EUROBOT-27/MECANIQUE/resources/CDR-2027/FRW/Differential-Robot-Firmware/README.md

# Differential-Robot-Firmware

Firmware ESP32-S3 du robot principal (Coupe de France de Robotique / Eurobot 2027).

- Règlement Eurobot 2027 « The legend of Camelot » :
  [Eurobot2027_Rules_FR.pdf](https://www.eurobot.org/wp-content/uploads/2026/09/Eurobot2027_Rules_FR.pdf)
- Contexte technique : [doc/context_llm.md](doc/context_llm.md)
- Guide : [doc/guide.md](doc/guide.md)
