EUROBOT-27/MECANIQUE/resources/INSATEURO2026/Navigation/docs/README.md

# Navigation System Documentation

Documentation for the STM32 navigation card: motion profiling, odometry, dual-loop PID control, and the CAN-based command interface with the Raspberry Pi master.

## Contents

1. [Introduction](01-Introduction.md)
2. [STM32 Peripheral Configuration (.ioc)](02-stm32-config.md)
3. [Navigation State Machine Structure](03-state-machine.md)
4. [Motion Profiling ](04-motion-profiling.md)
5. [Odometry ](05-odometry.md)
6. [PID_Tuning](06-PID_Tuning.md)
7. [Post odometry-calibration workflow](07-Post_odometry_calibration_workflow.md)
8. [Additional_Notes](08-Additional_Notes.md)
9. [Code Improvements](09-improvements.md)
10. [References](10-references.md)
