EUROBOT-27/MECANIQUE/mechanical/clapets-v8/CAD_FC/report.txt

A_SOCLE                  print   A solids 1  mass    93.1 g  size  136.0 x   52.0 x   39.0  valid
A_PLATINE_MOTEUR         print   A solids 1  mass    28.1 g  size  112.9 x   44.5 x    6.0  valid
REF_PATIN_MOTEUR         ref     A solids 1  mass     2.1 g  size   42.0 x   42.0 x    1.0  valid
A_TRAVERSE_HAUT          print   A solids 1  mass    62.8 g  size  108.9 x   28.0 x   22.0  valid
A_SUPPORT_ECROU          print   A solids 1  mass    54.2 g  size   54.5 x   30.1 x   60.0  valid
A_AILE_D                 print   A solids 1  mass   245.6 g  size   84.0 x   55.5 x  217.0  valid
A_AILE_G                 print   A solids 1  mass   245.6 g  size   84.0 x   55.5 x  217.0  valid
A_BRAS_PORTE_D_BAS       print   A solids 1  mass    16.5 g  size   48.0 x   68.5 x   16.0  valid
A_BRAS_PORTE_D_HAUT      print   A solids 1  mass    16.8 g  size   48.0 x   68.5 x   18.0  valid
A_BRAS_PORTE_G_BAS       print   A solids 1  mass    16.5 g  size   48.0 x   68.5 x   16.0  valid
A_BRAS_PORTE_G_HAUT      print   A solids 1  mass    16.8 g  size   48.0 x   68.5 x   18.0  valid
A_ROUE_PORTE_28T         print   A solids 1  mass    13.9 g  size   37.3 x   37.3 x   22.0  valid
A_PIGNON_PORTE_20T       print   A solids 1  mass     4.9 g  size   27.5 x   27.5 x   10.5  valid
A_TOLE_PORTE             mdf     A solids 1  mass    24.0 g  size    3.0 x   55.0 x  245.0  valid
A_CAPOT_AILE_D           print   A solids 1  mass    22.7 g  size   82.0 x   39.3 x    9.0  valid
A_CAPOT_AILE_G           print   A solids 1  mass    22.7 g  size   82.0 x   39.3 x    9.0  valid
A_ENTRETOISE_608_BAS     print   A solids 1  mass     0.2 g  size   12.0 x   12.0 x    3.0  valid
A_ENTRETOISE_608_HAUT    print   A solids 1  mass     0.3 g  size   12.0 x   12.0 x    4.0  valid
B_ENTRETOISE_TETE        print   B solids 1  mass     3.5 g  size   22.0 x   18.0 x   22.0  valid
B_CHARIOT_TETE           print   B solids 1  mass   125.3 g  size  131.0 x   37.5 x  113.0  valid
B_BASE_TETE_D            print   B solids 1  mass    12.9 g  size   13.5 x   26.8 x   92.0  valid
B_BASE_TETE_G            print   B solids 1  mass     9.7 g  size   13.5 x   15.5 x   92.0  valid
B_MANIVELLE_FRAPPE       print   B solids 1  mass     2.1 g  size   10.0 x   24.0 x   24.0  valid
B_MOYEU_TETE_30T         print   B solids 1  mass    30.6 g  size   56.0 x   23.0 x   56.0  valid
B_PIGNON_TETE_20T        print   B solids 1  mass     3.0 g  size   27.4 x    5.8 x   27.4  valid
B_PLATEAU_TETE           mdf     B solids 1  mass    33.5 g  size   56.0 x    6.0 x  216.0  valid
B_STATION_TPU            tpu     B solids 1  mass     6.6 g  size   50.0 x   10.0 x   50.0  valid
B_BAGUE_STATION          print   B solids 1  mass     4.5 g  size   56.0 x    3.0 x   56.0  valid
REF_RAILS_2020           ref     A solids 2  mass   280.6 g  size  101.0 x   25.6 x  350.0  valid
REF_PLAQUE_PAPILLON      ref     A solids 1  mass   154.2 g  size  190.0 x    3.0 x  190.0  valid
REF_ROUES_V              ref     A solids 12  mass    41.2 g  size  146.5 x   29.2 x  101.5  valid
REF_ENTRETOISES_M5       ref     A solids 2  mass     1.5 g  size    8.0 x    9.0 x   83.0  valid
REF_ENTRETOISES_EXC      ref     A solids 2  mass     3.1 g  size   10.0 x    9.7 x   86.5  valid
REF_RONDELLES_BRONZE     ref     A solids 2  mass     0.1 g  size    7.0 x    1.0 x   82.0  valid
REF_608ZZ                ref     A solids 1  mass    18.1 g  size   22.0 x   22.0 x    7.0  valid
REF_608ZZ_TETE           ref     B solids 1  mass    18.1 g  size   22.0 x    7.0 x   22.0  valid
REF_NEMA17               ref     A solids 2  mass   211.3 g  size   56.6 x   63.2 x   79.6  valid
REF_COUPLEUR_5x8         ref     A solids 1  mass    16.3 g  size   21.1 x   23.7 x   27.1  valid
REF_VIS_T8               ref     A solids 1  mass   119.6 g  size    8.0 x    8.0 x  303.0  valid
REF_ECROU_T8             ref     A solids 1  mass    13.1 g  size   22.0 x   22.0 x   15.0  valid
REF_TIGE_PORTE_D8        ref     A solids 1  mass    80.1 g  size    8.0 x    8.0 x  203.0  valid
REF_AXE_TETE_D8          ref     B solids 1  mass    19.7 g  size    8.0 x   50.0 x    8.0  valid
REF_MOUSSE_PORTE         ref     A solids 1  mass     0.6 g  size    8.0 x   37.0 x   40.0  valid
REF_MG996R_D             ref     A solids 9  mass    38.8 g  size   54.0 x   20.8 x   46.8  valid
REF_FIL_BRUN_D           ref     A solids 1  mass     0.0 g  size    6.6 x    1.4 x    1.4  valid
REF_FIL_ROUGE_D          ref     A solids 1  mass     0.0 g  size    6.6 x    1.4 x    1.4  valid
REF_FIL_ORANGE_D         ref     A solids 1  mass     0.0 g  size    6.6 x    1.4 x    1.4  valid
REF_MG996R_G             ref     A solids 9  mass    38.8 g  size   54.0 x   20.8 x   46.8  valid
REF_FIL_BRUN_G           ref     A solids 1  mass     0.0 g  size    6.6 x    1.4 x    1.4  valid
REF_FIL_ROUGE_G          ref     A solids 1  mass     0.0 g  size    6.6 x    1.4 x    1.4  valid
REF_FIL_ORANGE_G         ref     A solids 1  mass     0.0 g  size    6.6 x    1.4 x    1.4  valid
REF_MG996R_TETE          ref     B solids 9  mass    38.8 g  size   54.0 x   46.8 x   20.8  valid
REF_FIL_BRUN_TETE        ref     B solids 4  mass     0.2 g  size   17.5 x    1.4 x   77.6  valid
REF_FIL_ROUGE_TETE       ref     B solids 4  mass     0.2 g  size   18.9 x    1.4 x   79.0  valid
REF_FIL_ORANGE_TETE      ref     B solids 4  mass     0.2 g  size   20.3 x    1.4 x   80.4  valid
REF_MG996R_FRAPPE        ref     B solids 9  mass    38.8 g  size   46.8 x   20.8 x   54.0  valid
REF_TIGE_GUIDE_D8        ref     B solids 2  mass    37.1 g  size  125.0 x   47.0 x    8.0  valid
REF_VENTOUSE_DPS30       ref     B solids 1  mass    14.2 g  size   30.0 x   27.0 x   30.0  valid
REF_PILE_3_PIERRES       ref     - solids 3  mass  1151.0 g  size  320.0 x  110.0 x  329.0  valid
RES_TETE_ROTATION        reserve - solids 1  mass     2.0 g  size  280.0 x   32.0 x  280.0  valid
RES_TETE_FIXE            reserve - solids 1  mass     0.7 g  size  124.0 x   57.5 x  100.0  valid
RES_TETE_CABLES          reserve - solids 1  mass     0.2 g  size  124.0 x   57.5 x   30.0  valid
RES_TETE_REPOS           reserve - solids 1  mass     0.4 g  size   60.0 x   32.0 x  216.0  valid
FIX_VIS_AILE_D           ref     A solids 32  mass     7.4 g  size   81.2 x   27.7 x  177.6  valid
FIX_INSERT_AILE_D        ref     A solids 6  mass     2.6 g  size   80.1 x   26.6 x  154.7  valid
FIX_ECROU_AILE_D         ref     A solids 2  mass     1.5 g  size    8.1 x    3.2 x  177.0  valid
FIX_VIS_BRAS_D           ref     A solids 22  mass     6.5 g  size   48.7 x   64.8 x  185.7  valid
FIX_ECROU_BRAS_D         ref     A solids 6  mass     2.2 g  size   23.9 x   64.8 x  186.4  valid
FIX_VIS_AILE_G           ref     A solids 32  mass     7.4 g  size   81.2 x   27.7 x  177.6  valid
FIX_INSERT_AILE_G        ref     A solids 6  mass     2.6 g  size   80.1 x   26.6 x  154.7  valid
FIX_ECROU_AILE_G         ref     A solids 2  mass     1.5 g  size    8.1 x    3.2 x  177.0  valid
FIX_VIS_BRAS_G           ref     A solids 22  mass     6.5 g  size   48.7 x   64.8 x  185.7  valid
FIX_ECROU_BRAS_G         ref     A solids 6  mass     2.2 g  size   23.9 x   64.8 x  186.4  valid
FIX_VIS_ROUE_28T         ref     A solids 6  mass     2.2 g  size   13.0 x    5.5 x   11.5  valid
FIX_ECROU_ROUE_28T       ref     A solids 2  mass     0.7 g  size    2.4 x    5.5 x   12.4  valid
FIX_VIS_PIGNON_PORTE     ref     A solids 12  mass     1.3 g  size   18.2 x   18.2 x   11.3  valid
FIX_VIS_PLAQUE_ECROU     ref     A solids 8  mass     2.7 g  size    7.6 x   10.2 x   27.6  valid
FIX_VIS_SUPPORT_ECROU    ref     A solids 16  mass     2.7 g  size   21.7 x   21.7 x    9.7  valid
FIX_INSERT_SUPPORT_ECROU ref     A solids 6  mass     2.8 g  size   20.6 x   24.8 x   52.8  valid
FIX_VIS_MOTEUR           ref     A solids 12  mass     4.3 g  size   36.5 x   36.5 x   13.0  valid
FIX_VIS_PLATINE          ref     A solids 16  mass     3.5 g  size  100.6 x    5.7 x   13.6  valid
FIX_INSERT_SOCLE         ref     A solids 4  mass     1.7 g  size   99.5 x    4.6 x    5.7  valid
FIX_VIS_RAILS            ref     A solids 16  mass     9.6 g  size   90.4 x   10.8 x  329.5  valid
FIX_TNUT_RAILS           ref     A solids 4  mass     3.8 g  size   86.9 x    3.0 x  330.0  valid
FIX_VIS_ROUES            ref     B solids 12  mass    29.6 g  size  128.5 x   40.0 x   83.5  valid
FIX_ECROU_ROUES          ref     B solids 4  mass     5.6 g  size  129.2 x    5.0 x   83.0  valid
FIX_VIS_TETE_SERVO       ref     B solids 16  mass     3.5 g  size   54.7 x   13.7 x   15.7  valid
FIX_ECROU_TETE_SERVO     ref     B solids 4  mass     1.4 g  size   55.4 x    2.4 x   15.5  valid
FIX_VIS_FRAPPE_SERVO     ref     B solids 16  mass     2.7 g  size    9.7 x   15.7 x   54.7  valid
FIX_INSERT_FRAPPE_SERVO  ref     B solids 4  mass     1.7 g  size    5.7 x   14.6 x   53.6  valid
FIX_VIS_MANIVELLE        ref     B solids 9  mass     0.7 g  size    7.3 x   18.2 x   11.0  valid
FIX_VIS_TETE_MOYEU       ref     B solids 3  mass     1.2 g  size   15.0 x    5.5 x    5.5  valid
FIX_ECROU_TETE_MOYEU     ref     B solids 1  mass     0.4 g  size    2.4 x    6.4 x    5.5  valid
FIX_VIS_TETE_PIGNON      ref     B solids 12  mass     1.0 g  size   18.2 x    7.3 x   18.2  valid
FIX_VIS_STATION          ref     B solids 12  mass     3.3 g  size   47.3 x   17.7 x   41.7  valid
FIX_ECROU_STATION_EXT    ref     B solids 3  mass     1.1 g  size   47.9 x    2.4 x   41.5  valid
FIX_ECROU_STATION_MIL    ref     B solids 3  mass     1.1 g  size   47.9 x    2.4 x   41.5  valid

Rest pose (carriage down, doors at contact, head vertical, stack in place): real parts
interferences: 0

Expected contacts (real on the hardware, not counted):
       4.15 mm3  A_SOCLE-1 / REF_RAILS_2020-1
      16.32 mm3  REF_NEMA17-1 / FIX_VIS_MOTEUR-1
       2.70 mm3  REF_COUPLEUR_5x8-1 / REF_VIS_T8-1
     165.53 mm3  REF_VIS_T8-1 / REF_ECROU_T8-1
      37.15 mm3  REF_RAILS_2020-1 / REF_ROUES_V-1
       0.02 mm3  REF_ECROU_T8-1 / FIX_VIS_SUPPORT_ECROU-1
       7.67 mm3  REF_MG996R_D-1 / FIX_VIS_PIGNON_PORTE-1
       7.67 mm3  REF_MG996R_G-1 / FIX_VIS_PIGNON_PORTE-2
       8.01 mm3  REF_MG996R_FRAPPE-1 / FIX_VIS_MANIVELLE-1
       6.39 mm3  REF_MG996R_TETE-1 / FIX_VIS_TETE_PIGNON-1

Fasteners (bill of materials, whole module, both door units):
    8 x  M2 x 10 pan head self-tapping (servo horn)
    7 x  M2 x 6 pan head self-tapping (servo horn)
   24 x  M3 heat-set insert (hole dia 4.6 x 6.5)
   30 x  M3 nut (ISO 4032)
   12 x  M3 x 10 socket head (ISO 4762)
   14 x  M3 x 12 button head (ISO 7380)
    1 x  M3 x 12 socket head (ISO 4762)
   17 x  M3 x 16 button head (ISO 7380)
   14 x  M3 x 8 button head (ISO 7380)
    2 x  M4 heat-set insert (hole dia 5.6 x 7)
    4 x  M4 nut (ISO 4032)
    4 x  M4 x (6 + chassis) button head (ISO 7380): socle to the robot base, length set by the chassis
    6 x  M4 x 8 button head (ISO 7380)
    4 x  M5 T-nut for the 2020 slot
    4 x  M5 nyloc nut (ISO 10511)
    4 x  M5 x 35 socket head (ISO 4762)
    4 x  M5 x 8 button head (ISO 7380)

Module A (fixed parts) inside the space reserved for module B:
reserve violations: 0

STRIKE pose (v8): carriage +8.0 mm, crank +90 deg, stack held by the doors:
interferences at strike: 0
  cup into the stack: REF_VENTOUSE_DPS30-1 = 5655 mm3 (wanted: the bellows/TPU take the 8 mm)
  cup into the stack: REF_VENTOUSE_DPS30-2 = 5655 mm3 (wanted: the bellows/TPU take the 8 mm)
  cup into the stack: REF_VENTOUSE_DPS30-3 = 5655 mm3 (wanted: the bellows/TPU take the 8 mm)
  crank pin inside the slot, no contact with the base: yes
