EUROBOT-27/MECANIQUE/logs/2026-11-01-seif.md

# 2026-11-01 — Session log (Seif)

(Earlier the same day: shared hub set up, D-018, committed without a log. Summarised here.)

## Done
- Shared hub: merged Seif's and Maatoug's copies into EUROBOT-27/MECANIQUE, per-person todo/logs, resources committed (D-018).
- Claude removed from the GitHub contributors: co-author lines stripped from the 4 earlier commits (history rewritten,
  force-pushed before Maatoug's first pull); `.claude/settings.json` turns attribution off for both leads.
- **Clapets v6** (`mechanical/clapets-v6/`, copy of v5, D-019): real MG996R round horn in the assembly (pinions 2.2 mm
  higher, head pinion 5.8 mm face sitting on the horn), real GrabCAD servo wires, cables straight out (door servos) and
  up to the tube passage (head servo).
- **Clapets v7** (`mechanical/clapets-v7/`, D-020):
  - door units reworked: M3 inserts Ø4.6 × 6.5, outer wall full height, closed box above the gears, no strap, one bottom plate;
  - real Two Trees Bluer V2 parts extracted from the GrabCAD model (named STLs matched to the .stp solids by box +
    volume) → `mechanical/resources/two-trees-bluer-v2-parts/` (+ `SOURCE.md`); profiles, wheels, spacers, NEMA 17,
    coupler, TR8 nut in the CAD;
  - every screw, nut and insert modelled (`FIX_*` parts, coloured) + bill of materials in `CAD_FC/report.txt`;
  - motor on the floor on a 1 mm pad + separate clamp plate `A_PLATINE_MOTEUR`;
  - caliper checklist and "mounting on the real robot" notes in the v7 README.
- FreeCAD 1.1 installed on Seif's PC; prompt-to-CAD workflow running (scripts in `fc/`, headless `freecadcmd`).

## Decisions
- D-019 Clapets v6: print and test v5 first, in its own folder
- D-020 Clapets v7 is the version we print and test

## Info gathered
- Seif's M3 inserts fit a Ø4.6 × 6.5 hole (measured from `ACC_Stepper_Omniwheel.STL`).
- Real MG996R round horn: disc Ø20.8 × 2.5, top 45.7 above the servo bottom (v5 assumed 43.5), boss Ø9.2, holes on r 7.2.
- Real TR8x8 nut: flange Ø22 × 3.9, 1.5 mm from one end, 4 holes Ø3.5 on r 8 at 0/90/180/270° (v5 assumed 45°).
- Two Trees plate sits 4.5 mm in front of the rails (v5: 4.0); the .stp plate is B-spline only, Maatoug's JSON plate is exact.
- NEMA 17 body ~38 mm, shaft Ø5 × ~19; lead screw in the printer 400 mm (ours ~303 mm, cut to length).
- Placing the fasteners found 14 real clashes v5/v6 would have printed with (fixed in v7).
- In the CAD, z 0 = table; rails + top tie reach 366 mm (exempt from the height check): cut profiles on the real robot.

## Problems / blockers
- Full-cycle check (`motion_v7.py`) not run with today's changes.
- Height margin still 2.3 mm (head at the top of the 75 mm lift).
- Weak spots: middle cup station nuts (~2 mm of thread), door-unit M4 corner nuts (~2.6 mm).
- Two Trees model GrabCAD link not written in `SOURCE.md` yet.

## Next
- Tolerance check of every nut / screw in v7.
- Redesign the door sheet (tôle porte) + foam pads.
- Rework the suction cup carrier with real tube sizes and measurements.
- Printability check of every part; refine where needed.
- Caliper measurements (list in `mechanical/clapets-v7/README.md`), then print and test in real life.

## Session 2

### Done
- Seif ran the full-cycle check of clapets v7 (`motion_v7.py`, headless): deployed perimeter ≤ 1367.3 mm, start 1200.2 mm
  (door servo wires 3.6 mm outside the base, accepted), **no real collision**. The 5 "unexpected" hits were real
  hardware contacts (lead screw in the nut, V-wheels in the slot, horn screws in the horns) and the "355 mm" was the
  top-tie T-nuts.
- `motion_v7.py` updated: those contacts listed as expected, top-tie screws exempt from the height check (like the top tie).

### Decisions
- none

### Info gathered
- The motion video is only made when the script runs in the GUI: `freecad.exe fc/motion_v7.py` → `CAD_FC/motion/motion.mp4`.

### Problems / blockers
- none new

### Next
- Re-run `motion_v7.py` in the GUI to get the video and confirm 0 unexpected / 347.7 mm; then the v7 plan (fastener
  tolerances first).
