EUROBOT-27/MECANIQUE/logs/2026-10-25-seif.md

# 2026-10-25 — Session log

## Done
- Agreed on how to organise the hub: the main session acts as chief, memory lives in files, `mechanical/` and `vision/` have their own context files, and subagents are only for one-off jobs (D-001).
- Read the official 2027 game rules (v1.0), general rules (v1.4), table plan and accessories sheet.
- Created: `CLAUDE.md`, `commands.txt`, `STATUS.md`, `TODO.md`, `project/` (rules digest, strategy, timeline, decisions), `mechanical/CLAUDE.md`, `vision/CLAUDE.md`, `/start` and `/wrap` commands, `rules-checker` agent, UTF-8 text extracts of the rules.

## Decisions
- D-001 Project hub organisation
- D-002 Manufacturing: 3D printing, laser cutting, aluminium profiles, rods
- D-003 SolidWorks; all files in English

## Info gathered
- Mechanical must be **built and assembled** by 2026-12-31. National qualifier at the end of March 2027.
- Team roles recorded in `CLAUDE.md`. Only Seif uses this hub for now. Software is out of scope here for now.
- Strategy is still being brainstormed. Seif will share ideas.

## Rule findings worth remembering
- Gate lintel sits at 320–430 mm while actuators must stay ≤ 350 mm, so it's hard.
- A quarry stack of 3 stones = a ready-made wall.
- Robot + Grail must share the 500 × 500 throne room at the start.
- Grail L4 (on the roof, > 300 mm) combines with returning home: 35 pts together.
- 7 open FAQ questions listed in `project/rules-digest.md`.

## Next
- Strategy brainstorm with Seif's ideas.
- Confirm the internal milestones (proposed CAD freeze 2026-12-13).
- Send the FAQ questions.

## Session 2

### Done
- Updated the hub after Seif's input: SIMAs in scope (`simas/`), most software out of scope, parts inventory not tracked.
- Created `resources/` with `INDEX.md` + `_notes/`. Cloned **Aerobotix 2026** (14 repos) and **INSATEURO2026**
  (17 repos, our club's previous team).
- Studied the Aerobotix CAD teardown + PPP → `resources/_notes/aerobotix-2026-robot.md`.
- Turned what Seif liked about it into `mechanical/design-principles.md` (symmetry, printed zip-tie anchors, testing method).
- Studied all INSATEURO2026 repos → `resources/_notes/insateuro2026.md` (vision post-mortem, mechanism, nav, SIMA, electrical).
- Checked GitHub: git logged in as `seifflifel`; member of INSATEURO2026, admin of EUROBOT-27. `gh` CLI not installed.

### Decisions
- D-004 Differential drive (Pololu 4742 + JSUMO; omni rejected)
- D-005 Opponent tracking by vision → superseded the same day by D-007
- D-006 Aerobotix 2026 design principles as our reference
- D-007 Opponent tracking and avoidance: LiDAR + vision
- D-008 Overhead vision station (camera + laptop) on the table, wireless to the robot

### Info gathered
- Seif's team is **IEEE RAS INSAT** (2026: 20th at the final, 134 pts). Aerobotix INSAT (another club) was 2nd.
- Lextronic order (7" display, 6 mini air pumps, 2 × Pololu 4742) arriving ~2026-10-28. Real stones still to be bought from France.
- Working assumption: a carried stone does **not** count in the robot perimeter (FAQ Q1, Seif will confirm).
- No CAD of our club's 2026 main robot exists in the org (`HARDWARE-CAD` is the ENSI 2025 robot).
- 2026 vision lessons: wrong input data caused the failures; the compute was off the table (not allowed);
  ArUco IDs were inconsistent; fusion was a plain average; ~9 cm accuracy, which can be improved with known-height planes.
- 2027: stones carry tag 13 on the long faces only → standing stones are invisible to overhead tag tracking.

### Problems / blockers
- Strategy not yet shared → mechanical concepts can't start properly.
- "Balise fixe" for laptop + camera: by the rules it must be the remote computing device (fixed beacons only allow
  sensors/telecom, 100 × 100 mm). Waiting for Seif to confirm.

### Next
- **Strategy session**: Seif shares the team's ideas; derive the mechanical requirements (7 questions listed in the chat:
  actions, stone handling, upright or not, capacity, Grail, cannonballs, start configuration).
- Order real stones + foam balls.
- Refine the timeline.
