EUROBOT-27/MECANIQUE/logs/2026-10-26-seif.md

# 2026-10-26 — Session log

(Session started 2026-10-25 late with `/start`, continued into 2026-10-26.)

## Done
- Seif shared the team's strategy brainstorm → `project/strategy.md` (match plan, mechanisms, PAMI versions), with Claude's rule review.
- Pulled exact zone coordinates from `Docs/table.svg` (mm): throne rooms, 5 wall + 4 tower zones per castle, moats,
  stables, the 10 quarries → `project/strategy.md`, `project/rules-digest.md` §2.
- Computed shot distance, PAMI path lengths and the PAMI size envelope → `project/strategy.md`, `simas/CLAUDE.md`.
- Wrote a team-friendly points-per-effort table and build order → `project/strategy.md`.
- Added the "reserve space in CAD" method → `mechanical/design-principles.md`.
- Listed the stone gripper concepts → `mechanical/concepts/stone-gripper.md` (new).

## Decisions
- D-009 Strategy direction: max points
- D-010 Build order: secure the sure points first

## Info gathered
- Endgame plan: go home, Grail to the roof (L4), shoot balls from the throne room during 85–100 s.
- Launcher idea: flywheel, fixed angle (lob). Shot ≈ 2.0 m to the near edge of the opposing courtyard, ≈ 2.75 m to the border; must clear 430 mm ramparts at 0.5–0.7 m and 1.8–2.0 m.
- PAMIs: 3 versions (basic, ejector, attack). "Easy eject" fallback: ball rolls through the opponent's gate, which faces the bridge moat.
  Size: 4 × ≤ 140 × 160 mm or 6 × ~90 × 185 mm; 4 already reach max PAMI points; 6 cords → start by radio from the robot.
- Lintel hand: suction from the top face, flip 180° so the cup is under the stone, exit through the gap between the uprights. Needs more brainstorming.
- Stone gripper: A side clamp (plate or servo per stone), B 3 suction cups, C both.
- Grail target height: well under the 430 mm beacon level (> 60 mm cube minimum).

## Rule findings
- Castle courtyard includes the throne room [G D.4] → the Grail's 5 "present" points are free (Q2 likely yes).
- New FAQ Q8: can a Grail on the roof block the opponent's beacon (430 mm)? [G E.2]
- Actuators ≤ 350 mm even inside the castle; only stones and the Grail may go above [G E.1], [G E.2].
- Lifting a 330 mm wall: ≤ 20 mm lift allowed [GR F.3]. Lintel pick-up from a stack top: ≤ 20 mm headroom.
- 8 of 10 quarries are against the long borders (one long face blocked).

## Problems / blockers
- Real stones still not ordered → blocks suction tests and jaw pad tuning.
- Concept A forces a ~380 mm wide robot when open → perimeter and layout to check.

## Next
- Order real stones and foam balls.
- Robot layout sketch (drive base + gripper width + pockets) and roof layout sketch.
- Second face concepts (single-stone pick + flip for towers).
- Choose the PAMI size with Hamza Sammoud.

## Session 2

### Done
- Gate lintel: checked a vertical-lift + side-suction idea against the height rule; added it and the "fork from below"
  idea to `project/strategy.md`.
- Created `mechanical/concepts/gate-lintel.md`: space to reserve for the gate, perimeter budget, 4 concepts compared.
- Added FAQ Q9 to `project/rules-digest.md`.

### Decisions
- D-011 Gate mechanism shares a driving face

### Info gathered
- Side grip on the lintel only has the 320–350 mm band (~20 mm usable with ±5 mm uprights). Side-suction lift with a
  centred cup ends at ~385 mm (illegal); a low cup could work but Seif judged it unreliable.
- Preferred direction: gravity-held lintel (fork or shelf under it). Unsolved: how the lintel gets onto the support.
- Space to reserve: slot ≈ 340 × 130 mm × full height on a driving face, ~100–110 mm Z travel, lintel ends
  ~110–120 mm outside the robot edge.
- Perimeter: only 200 mm of extra perimeter for all deployed parts. A full-width tray out 120 mm ≈ +240 mm (too much);
  one 80 mm tine ≈ +105 mm.

### Rule findings
- FAQ Q9: may a stone still held by the robot go above 350 mm inside a zone? [GR F.3] vs [G E.1].

### Problems / blockers
- Lintel loading onto a fork/shelf is unsolved (low priority, gate is 3rd in D-010).

### Next
- Robot layout sketch must include the shared gate slot on face A or B (D-011) and the narrow-protrusion rule.
- Hand test with 3 stones + scrap plywood: does a lintel set from a fork/shelf land straight? (once real stones arrive)
