EUROBOT-27/MECANIQUE/project/timeline.md

# Timeline

## Fixed milestones

| Date | Milestone | Status |
|---|---|---|
| 2026-10-25 | Project hub set up | done |
| **2026-12-31** | **Mechanical structure + mechanisms built and assembled** | — |
| **end of March 2027** (exact date TBD) | **National qualifier** | — |
| TBD | Registration deadline | find out |
| TBD | Technical poster deadline | find out |
| TBD | European finals (if qualified) | — |

## Proposed internal milestones (DRAFT by Claude — Seif is refining this)

Remember import lead times: anything imported must be ordered well before CAD freeze if it's needed for
assembly by 2026-12-31.

Working back from 2026-12-31. Manufacturing (3D printing, laser cutting, aluminium profiles, rods) is fast,
so most of the time goes to concept + CAD, but leave room to re-print and fix things.

| Target date | Milestone | What "done" means |
|---|---|---|
| 2026-11-08 | Strategy chosen | Actions we target are in `decisions.md`; FAQ questions sent |
| 2026-11-22 | Concepts chosen + critical prototypes tested | Drive base layout fixed; stone gripper/lift prototype tested on real 320 × 110 × 110 boxes |
| 2026-12-13 | **CAD freeze** (full robot) | Complete SolidWorks assembly, rule-checked (perimeter, height, beacon support, start area) |
| 2026-12-14 → 12-31 | Manufacturing + assembly | Robot built and mechanisms working by hand |
| Jan → Mar 2027 | Electronics integration, software, testing | Owned mostly by electrical + software teams |

Open questions:
- Exams or holidays in Nov–Jan that reduce team availability?
- When can electrical (Hamza Bjaoui) get the chassis to start wiring?
