EUROBOT-27/MECANIQUE/resources/INSATEURO2026/Euro_vision/Documentation/THEORETICAL_UNDERSTANDING.md

# 🎓 Theoretical Understanding Requirements

**Purpose**: Track concepts that need deep theoretical understanding before proceeding with integration  
**Status**: Study Phase - No More "Vibe Coding"  
**Created**: October 8, 2025  
**Priority**: **CRITICAL** - Foundation for robust implementation

---

## 🚨 Why This Document Exists

**Problem Identified**:
- ✅ We have **working code** (~5000+ lines across modules)
- ❌ We may lack **deep understanding** of underlying theory
- ⚠️ Risk of "vibe coding" - implementation without comprehension
- 🎯 Need solid theoretical foundation for:
  - Debugging complex issues
  - Optimizing performance
  - Handling edge cases
  - Making informed design decisions
  - Competition problem-solving under pressure

**Solution**:
- **PAUSE** all new implementation
- **STUDY** the theory behind what we've built
- **UNDERSTAND** each component deeply
- **VALIDATE** our implementations against theory
- **DOCUMENT** our understanding

---

## 📚 Study Roadmap

### Priority Levels:
- 🔴 **CRITICAL** - Must understand before integration
- 🟡 **HIGH** - Important for optimization and debugging
- 🟢 **MEDIUM** - Useful for advanced features
- ⚪ **LOW** - Nice to have, can defer

---

## 1️⃣ Camera Calibration & Intrinsics

### 🔴 CRITICAL Topics

#### 1.1 Pinhole Camera Model
**What We Need to Understand**:
- [ ] How 3D points project to 2D image plane
- [ ] Focal length (fx, fy) physical meaning
- [ ] Principal point (cx, cy) and sensor alignment
- [ ] Relationship between world coordinates and pixel coordinates
- [ ] Why calibration is necessary

**Mathematical Foundation**:
```
Projection equation:
[u]   [fx  0  cx]   [X]
[v] = [0  fy cy] · [Y/Z]
[1]   [0   0  1]   [Z]

where (X,Y,Z) = 3D point, (u,v) = pixel coordinates
```

**Questions to Answer**:
- Why do we need fx and fy (not just one focal length)?
- What causes principal point offset from image center?
- How does sensor size affect these parameters?

**Resources to Study**:
- [ ] OpenCV Camera Calibration Tutorial
- [ ] Multiple View Geometry (Hartley & Zisserman) - Chapter 6
- [ ] Computer Vision: Algorithms and Applications (Szeliski) - Chapter 2
- [ ] Our file: `camera_calibration_folder/USAGE_EXAMPLES.md`

---

#### 1.2 Lens Distortion
**What We Need to Understand**:
- [ ] Radial distortion (k1, k2, k3) - barrel/pincushion effects
- [ ] Tangential distortion (p1, p2) - sensor misalignment
- [ ] When distortion matters (wide-angle lenses, close objects)
- [ ] Undistortion process and computational cost

**Mathematical Foundation**:
```
Radial distortion:
x_distorted = x(1 + k1·r² + k2·r⁴ + k3·r⁶)
y_distorted = y(1 + k1·r² + k2·r⁴ + k3·r⁶)

Tangential distortion:
x_distorted = x + [2p1·xy + p2(r² + 2x²)]
y_distorted = y + [p1(r² + 2y²) + 2p2·xy]

where r² = x² + y²
```

**Questions to Answer**:
- Why three radial coefficients (k1, k2, k3)?
- When can we ignore distortion?
- How does distortion affect ArUco detection accuracy?

**Our Parameters** (from calibration):
```python
k1 = 0.15619
k2 = -1.3830
k3 = 2.79308
p1 = -0.000391
p2 = -0.003039
```
**Study**: What do these values mean for our specific camera?

**Resources**:
- [ ] OpenCV Distortion Coefficients Documentation
- [ ] Zhang's Camera Calibration Paper (1999)
- [ ] Our file: `camera_calibration_folder/test_calibration.py`

---

#### 1.3 Calibration Process
**What We Need to Understand**:
- [ ] Why chessboard patterns work
- [ ] Minimum number of images needed
- [ ] How to evaluate calibration quality (reprojection error)
- [ ] When to recalibrate

**Our Calibration Results**:
```
Reprojection Error: 0.09574 px (EXCELLENT - typically < 0.5px is good)
```

**Questions to Answer**:
- What does 0.096px error mean practically?
- How often should we recalibrate?
- What factors invalidate calibration (lens bump, focus change)?

**Resources**:
- [ ] OpenCV calibrateCamera() documentation
- [ ] Our file: `camera_calibration_folder/calibrate_camera.py`
- [ ] Paper: "A Flexible New Technique for Camera Calibration" (Zhang, 1999)

---

## 2️⃣ Coordinate Systems & Transformations

### 🔴 CRITICAL Topics

#### 2.1 Coordinate System Definitions
**What We Need to Understand**:
- [ ] **World Coordinates**: Playing field reference frame
- [ ] **Camera Coordinates**: Camera-centric reference frame
- [ ] **Image Coordinates**: 2D pixel coordinates
- [ ] Right-hand vs left-hand coordinate systems
- [ ] How axes align in each system

**Our System**:
```
World Frame (on table):
- Origin: Center of ArUco marker ID=0 (inset 0.6m from corner)
- X-axis: Along table width (0 → 3.0m)
- Y-axis: Along table height (0 → 2.0m)
- Z-axis: Up (perpendicular to table)

Camera Frame:
- Origin: Camera optical center
- Z-axis: Points toward scene (out of camera)
- X-axis: Right (in image)
- Y-axis: Down (in image)
```

**Questions to Answer**:
- Why is camera Y-axis down?
- How do we handle the mismatch between world and camera frames?
- What's the physical meaning of our coordinate choices?

**Resources**:
- [ ] Multiple View Geometry - Chapter 2 (Projective Geometry)
- [ ] Our file: `map_anchors/docs/coordinate_system.md`

---

#### 2.2 Rotation Matrices
**What We Need to Understand**:
- [ ] 3×3 rotation matrix properties (orthonormal, det=1)
- [ ] Euler angles (roll, pitch, yaw) and gimbal lock
- [ ] Rotation vectors (rvec from solvePnP)
- [ ] Rodrigues formula (rvec ↔ rotation matrix)
- [ ] Quaternions (alternative representation)

**Mathematical Foundation**:
```python
# Rodrigues formula
R = I + sin(θ)·K + (1-cos(θ))·K²

where:
θ = ||rvec||  (rotation angle)
k = rvec/θ    (rotation axis)
K = skew-symmetric matrix of k
```

**Our Implementation**:
```python
rvec, tvec = cv2.solvePnP(...)
R, _ = cv2.Rodrigues(rvec)  # rvec → R matrix
```

**Questions to Answer**:
- Why use rotation vectors instead of matrices?
- What's the advantage of quaternions?
- How do we compose rotations?

**Resources**:
- [ ] Wikipedia: Rotation Matrix, Rodrigues' Formula
- [ ] Robotics textbook: "Modern Robotics" by Lynch & Park
- [ ] Our file: `map_anchors/scripts/compute_extrinsics.py`

---

#### 2.3 Homogeneous Coordinates & Transformations
**What We Need to Understand**:
- [ ] 4×4 homogeneous transformation matrices
- [ ] [R|t] representation (rotation + translation)
- [ ] Inverse transformations
- [ ] Chaining transformations

**Mathematical Foundation**:
```
Homogeneous Transform:
T = [R  t]  (4×4 matrix)
    [0  1]

Point transformation:
P_camera = T_world2cam · P_world

Inverse:
T_cam2world = [R^T  -R^T·t]
              [0     1     ]
```

**Questions to Answer**:
- Why use 4×4 matrices (instead of R and t separately)?
- How do we go from camera → world coordinates?
- What's the difference between extrinsic and intrinsic matrices?

**Resources**:
- [ ] Multiple View Geometry - Chapter 2
- [ ] Computer Graphics textbooks
- [ ] Our file: `map_anchors/docs/extrinsics.md`

---

#### 2.4 Camera Extrinsics (Critical!)
**What We Need to Understand**:
- [ ] Extrinsic matrix = [R|t] relating world → camera
- [ ] How solvePnP computes extrinsics from marker corners
- [ ] When extrinsics change (camera moved?)
- [ ] How to use extrinsics to transform enemy positions

**Our Setup**:
- Camera OUTSIDE field at (1.5, 2.044, 1.0) meters
- Tilted down: pitch = -20°
- Map markers at known world positions

**Critical Question**:
- How do we transform detected enemy marker position (in camera frame) to world coordinates?

**Answer Flow**:
```
1. Detect marker in image → (u, v) pixels
2. Use intrinsics to get normalized coordinates → (x, y, 1)
3. Use solvePnP to get marker pose → (rvec, tvec)
4. Transform to world frame using extrinsics
```

**Resources**:
- [ ] OpenCV solvePnP documentation
- [ ] Our file: `map_anchors/scripts/compute_extrinsics.py`
- [ ] **CRITICAL**: Need to implement and test this!

---

## 3️⃣ ArUco Marker Detection

### 🔴 CRITICAL Topics

#### 3.1 ArUco Dictionary & Encoding
**What We Need to Understand**:
- [ ] How ArUco markers encode IDs (binary patterns)
- [ ] DICT_4X4_50 vs DICT_6X6_250 (size vs capacity)
- [ ] Error detection/correction in markers
- [ ] Why some IDs are more robust than others

**Our Dictionary**:
```python
aruco_dict = cv2.aruco.getPredefinedDictionary(cv2.aruco.DICT_4X4_50)
# 4×4 = 16 bits per marker
# 50 = max 50 unique IDs
```

**Questions to Answer**:
- Why did we choose DICT_4X4_50?
- How much error correction is built-in?
- What's the detection range vs marker size?

**Resources**:
- [ ] ArUco original paper: "Automatic generation and detection of highly reliable fiducial markers under occlusion"
- [ ] OpenCV ArUco module documentation
- [ ] Our file: `ArUco_detection_folder/ARUCO_GUIDE.md`

---

#### 3.2 Marker Detection Pipeline
**What We Need to Understand**:
- [ ] Image preprocessing (grayscale, threshold, adaptive)
- [ ] Corner detection (how OpenCV finds 4 corners)
- [ ] ID decoding from binary pattern
- [ ] Pose estimation from corners (solvePnP)

**Detection Parameters** (that we've been setting):
```python
parameters.adaptiveThreshConstant = 7
parameters.adaptiveThreshWinSizeMin = 3
parameters.polygonalApproxAccuracyRate = 0.03
# ... etc.
```

**Questions to Answer**:
- What does each parameter actually do?
- How to tune for our lighting conditions?
- When does detection fail (distance, angle, lighting)?

**Resources**:
- [ ] OpenCV detectMarkers() source code
- [ ] ArUco module tutorial
- [ ] Our file: `ArUco_detection_folder/aruco_tools/marker_detector.py`

---

#### 3.3 Pose Estimation (solvePnP)
**What We Need to Understand**:
- [ ] PnP = "Perspective-n-Point" problem
- [ ] Input: 2D image points + 3D world points
- [ ] Output: Camera pose (rvec, tvec)
- [ ] Different solvePnP methods (ITERATIVE, P3P, EPNP)
- [ ] When solvePnP fails or gives bad results

**Mathematical Problem**:
```
Given:
- n points in world: P_i = (X_i, Y_i, Z_i)
- n points in image: p_i = (u_i, v_i)
- Camera intrinsics: K

Find:
- Rotation: R (or rvec)
- Translation: t (or tvec)

Such that:
p_i ≈ K · [R|t] · P_i
```

**For ArUco**: n=4 (four corners)

**Questions to Answer**:
- Why do we need at least 4 points?
- Which solvePnP method is best for our case?
- How accurate is the pose estimate?

**Resources**:
- [ ] OpenCV solvePnP documentation
- [ ] Paper: "EPnP: Efficient Perspective-n-Point Camera Pose Estimation"
- [ ] Our file: `ArUco_detection_folder/examples/05_with_calibration.py`

---

## 4️⃣ Kalman Filtering

### 🔴 CRITICAL Topics

#### 4.1 Kalman Filter Theory
**What We Need to Understand**:
- [ ] State estimation problem
- [ ] Process model (how system evolves)
- [ ] Measurement model (what we observe)
- [ ] Kalman gain (optimal weighting)
- [ ] Predict-Update cycle

**Mathematical Foundation**:
```
State: x = [x, y, θ, vx, vy, vθ]^T

Predict:
x̂_{k|k-1} = F·x̂_{k-1|k-1}
P_{k|k-1} = F·P_{k-1|k-1}·F^T + Q

Update (when measurement available):
K = P_{k|k-1}·H^T·(H·P_{k|k-1}·H^T + R)^-1
x̂_{k|k} = x̂_{k|k-1} + K·(z_k - H·x̂_{k|k-1})
P_{k|k} = (I - K·H)·P_{k|k-1}

where:
F = state transition matrix
H = measurement matrix
Q = process noise covariance
R = measurement noise covariance
K = Kalman gain
```

**Our Implementation**: `kalman_filter/src/kalman_filter/tracker.py`

**Questions to Answer**:
- Why is Kalman filter "optimal"?
- When does it fail (non-linear systems, non-Gaussian noise)?
- How to tune Q and R matrices?

**Resources**:
- [ ] "Kalman Filter for Dummies" (online tutorial)
- [ ] Welch & Bishop: "An Introduction to the Kalman Filter" (1995)
- [ ] Probabilistic Robotics (Thrun, Burgard, Fox) - Chapter 3
- [ ] Our file: `kalman_filter/docs/kalman/README.md`

---

#### 4.2 Motion Models
**What We Need to Understand**:
- [ ] Constant velocity model (our choice)
- [ ] Constant acceleration model
- [ ] When each model is appropriate
- [ ] How motion model affects prediction accuracy

**Our Model**:
```python
# Constant velocity
x_{k+1} = x_k + vx·dt
y_{k+1} = y_k + vy·dt
θ_{k+1} = θ_k + vθ·dt
vx_{k+1} = vx_k
vy_{k+1} = vy_k
vθ_{k+1} = vθ_k
```

**Questions to Answer**:
- Is constant velocity good for caisses (slow, erratic)?
- Is it good for enemy robots (fast, dynamic)?
- When should we use constant acceleration?

**Resources**:
- [ ] Tracking and Kalman Filtering Made Easy (Brookner)
- [ ] Our file: `kalman_filter/src/kalman_filter/tracker.py`

---

#### 4.3 Process & Measurement Noise
**What We Need to Understand**:
- [ ] Q matrix = model uncertainty (how much we trust prediction)
- [ ] R matrix = sensor uncertainty (how much we trust measurement)
- [ ] Tuning Q and R for different marker types
- [ ] Impact on filter responsiveness vs stability

**Our Values**:
```python
# Default
process_noise = 0.01  # Q
measurement_noise = 0.1  # R

# Recommendations:
# MAP (stationary): Q=0.001, R=0.05
# CAISSE (slow): Q=0.01, R=0.1
# ENEMY (fast): Q=0.05, R=0.2
```

**Questions to Answer**:
- How were these values determined?
- How to tune systematically?
- Trade-off: responsiveness vs noise rejection

**Resources**:
- [ ] "How to tune a Kalman Filter" (various online guides)
- [ ] Our file: `kalman_filter/TECHNICAL_SUMMARY.md`

---

### 🟡 HIGH Priority Topics

#### 4.4 Extended Kalman Filter (EKF)
**What We Need to Understand**:
- [ ] When linear Kalman filter is insufficient
- [ ] Linearization via Jacobian matrices
- [ ] Application to non-linear motion models
- [ ] Trade-offs (accuracy vs computational cost)

**Future Consideration**:
- Our system may need EKF for more complex motion patterns

**Resources**:
- [ ] Probabilistic Robotics - Chapter 3.3
- [ ] Wikipedia: Extended Kalman Filter

---

## 5️⃣ Occlusion Handling

### 🟡 HIGH Priority Topics

#### 5.1 Occlusion Detection
**What We Need to Understand**:
- [ ] Full vs partial occlusion
- [ ] Detection quality metrics
- [ ] When to trust Kalman prediction vs measurement

**Our Approach**:
```python
class DetectionQuality:
    corners_detected: int  # 0-4
    detection_confidence: float  # 0.0-1.0
    is_partial: bool
    
quality_score = (corners_detected/4 + detection_confidence) / 2
```

**Questions to Answer**:
- How to assess detection quality?
- When is partial detection better than prediction?
- How long can we predict during occlusion?

**Resources**:
- [ ] Our file: `kalman_filter/docs/occlusion/README.md`
- [ ] Our file: `kalman_filter/src/occlusion_handler/handler.py`

---

#### 5.2 Occlusion Strategies
**What We Need to Understand**:
- [ ] **Kalman Prediction**: Continue motion model
- [ ] **Partial Detection**: Fuse incomplete data with prediction
- [ ] **History-Based**: Use recent detections (for stationary objects)
- [ ] **Confidence Fusion**: Weighted combination

**When to Use Each**:
- Full occlusion → Kalman prediction
- Partial (1-3 corners) → Fusion with prediction
- Extended occlusion + MAP marker → History-based
- Multiple estimates available → Confidence fusion

**Questions to Answer**:
- How to select strategy automatically?
- How to weight different estimates?
- Maximum occlusion duration before giving up?

**Resources**:
- [ ] Visual tracking literature
- [ ] Our file: `kalman_filter/src/occlusion_handler/handler.py`

---

## 6️⃣ System Integration & Data Flow

### 🔴 CRITICAL Topics

#### 6.1 Complete Pipeline Understanding
**What We Need to Understand**:
- [ ] Data flow from camera to robot
- [ ] Coordinate transformations at each stage
- [ ] Error propagation through pipeline
- [ ] Timing and synchronization

**Our Pipeline**:
```
Camera Frame (30 FPS)
    ↓
ArUco Detection (detect all markers)
    ↓
Pose Estimation (solvePnP for each marker)
    ↓
Coordinate Transform (camera → world)
    ↓
Marker Classification (Map/Caisse/Enemy)
    ↓
Kalman Filter Update (smooth + predict)
    ↓
Occlusion Handling (quality assessment)
    ↓
WiFi Transmission (PC → Robot)
    ↓
Robot Decision Making
```

**Questions to Answer**:
- Where are the computational bottlenecks?
- How much latency at each stage?
- How to optimize for 30+ FPS?

**Resources**:
- [ ] Our file: `kalman_filter/docs/DATA_FLOW.md`
- [ ] Our file: `README.md` (system architecture)

---

#### 6.2 Error Propagation & Uncertainty
**What We Need to Understand**:
- [ ] How calibration errors affect pose estimation
- [ ] How pose estimation errors affect world coordinates
- [ ] How measurement noise affects Kalman filter
- [ ] Total system uncertainty

**Error Sources**:
1. Camera calibration: ~0.096px reprojection error
2. ArUco detection: ~1-2 pixels corner localization
3. solvePnP: Dependent on marker size and distance
4. Kalman filter: Tunable via Q and R

**Questions to Answer**:
- What's our total position uncertainty?
- How accurate is enemy position estimate?
- Is accuracy sufficient for competition tasks?

**Resources**:
- [ ] Error analysis chapters in computer vision textbooks
- [ ] Our calibration validation results

---

## 7️⃣ Competition-Specific Understanding

### 🟡 HIGH Priority Topics

#### 7.1 ArUco ID Schema (NOW UNDERSTOOD ✅)
**What We Understand**:
- ✅ Map anchors: 0-3 (fixed corner references)
- ✅ Caisses: 36 (blue), 47 (yellow), 41 (black/rotten)
- ✅ Enemy robots: 30+ (opponent tracking)

**Rationale**:
- Map markers establish coordinate frame
- Caisse markers on vinyl bands (detected, not tracked continuously)
- Enemy markers on opponent robots (tracked continuously)

**Resources**:
- ✅ Our file: `kalman_filter/SYNCHRONIZATION_SUMMARY.md`
- ✅ Our file: `caisses_detection/config/caisse_config.yaml`

---

#### 7.2 Competition Rules & Constraints
**What We Need to Understand**:
- [ ] Playing field dimensions: 3.0m × 2.0m
- [ ] Camera placement requirements (outside field, 44mm from edge)
- [ ] ArUco marker sizes (40mm for caisses, 100mm for maps)
- [ ] Competition timing (90 seconds per match)
- [ ] WiFi environment (20-30 teams, interference)
- [ ] Scoring system (how vision affects points)

**Questions to Answer**:
- Why is camera outside field at Y=2.044m?
- How does marker size affect detection range?
- What's the critical path for points?

**Resources**:
- [ ] Eurobot 2026 Cahier des Charges (official rules)
- [ ] Our file: `README.md`
- [ ] Competition website

---

## 8️⃣ Path Planning & Motion Planning

### 🔴 CRITICAL Topics

#### 8.1 RRT (Rapidly-Exploring Random Tree)
**What We Need to Understand**:
- [ ] Sampling-based motion planning
- [ ] Tree growth in configuration space
- [ ] Nearest neighbor search
- [ ] Collision checking along edges
- [ ] Path extraction from tree

**Our Implementation**: `path_planning/rrt.py`

**Algorithm Overview**:
```python
def RRT(start, goal, obstacles, max_iter):
    tree = [start]
    for i in range(max_iter):
        # 1. Sample random point in space
        rand_point = sample_random()
        
        # 2. Find nearest node in tree
        nearest_node = find_nearest(tree, rand_point)
        
        # 3. Steer towards random point with step_size
        new_node = steer(nearest_node, rand_point, step_size)
        
        # 4. Check if path to new node is collision-free
        if collision_free(nearest_node, new_node, obstacles):
            tree.append(new_node)
            
            # 5. Check if we reached goal
            if distance(new_node, goal) < threshold:
                return extract_path(new_node)
    
    return None  # No path found
```

**Questions to Answer**:
- Why use random sampling instead of grid search?
- How does tree bias towards unexplored regions?
- What's the probabilistic completeness guarantee?
- How to tune step_size and goal_sample_rate?

**Resources**:
- [ ] LaValle (1998): "Rapidly-Exploring Random Trees: A New Tool for Path Planning"
- [ ] Robotics: Planning Algorithms (LaValle) - Chapter 5
- [ ] Our file: `path_planning/rrt.py`

---

#### 8.2 RRT-Connect (Bidirectional RRT)
**What We Need to Understand**:
- [ ] Bidirectional search (grow two trees)
- [ ] Connect operation (greedy extension)
- [ ] Extend operation (single step growth)
- [ ] Tree swapping for balanced growth
- [ ] Path concatenation when trees meet

**Our Implementation**: `path_planning/rrt_connect.py`

**Algorithm Overview**:
```python
def RRT_Connect(start, goal, obstacles, max_iter):
    tree_a = [start]  # Tree from start
    tree_b = [goal]   # Tree from goal
    
    for i in range(max_iter):
        # 1. Sample random point
        rand = sample_random()
        
        # 2. Extend tree_a towards rand
        new_a = extend(tree_a, rand)
        
        if new_a is not None:
            # 3. Try to connect tree_b to new_a
            new_b = connect(tree_b, new_a)
            
            if new_b is not None:
                # Trees connected! Extract path
                path_a = extract_path(new_a, start)
                path_b = extract_path(new_b, goal)
                return path_a + path_b
        
        # 4. Swap trees for balanced growth
        tree_a, tree_b = tree_b, tree_a
    
    return None
```

**Advantages over RRT**:
- 2-10× faster convergence
- More balanced exploration
- Better for narrow passages

**Questions to Answer**:
- Why is RRT-Connect faster than basic RRT?
- What's the difference between extend() and connect()?
- When does bidirectional search fail?
- How to handle dynamic obstacles?

**Resources**:
- [ ] Kuffner & LaValle (2000): "RRT-Connect: An Efficient Approach to Single-Query Path Planning"
- [ ] Our file: `path_planning/rrt_connect.py`
- [ ] Our file: `full_pipeline/scripts/multi_threaded_pipeline.py` (lines 380-550)

---

#### 8.3 Path Smoothing
**What We Need to Understand**:
- [ ] Why RRT paths are jagged (random sampling artifacts)
- [ ] Greedy straightening algorithm
- [ ] Collision checking for line segments
- [ ] Trade-off: smoothness vs safety margin

**Our Implementation**: `path_planning/path_smoothing.py`

**Two-Stage Smoothing Approach**:

**Stage 1: Greedy Straightening**
```python
# Find longest collision-free segments
i = 0
while i < len(path) - 1:
    # Try to connect i to farthest reachable point j
    for j in range(len(path)-1, i+1, -1):
        if line_collision_free(path[i], path[j], obstacles):
            # Found longest segment - remove intermediate waypoints
            path = path[:i+1] + path[j:]
            break
    i += 1
```

**Stage 2: Random Smoothing**
```python
# Iteratively try random waypoint removal
for _ in range(iterations):
    idx1, idx2 = random.choice(path, 2)
    if line_collision_free(path[idx1], path[idx2], obstacles):
        path = path[:idx1+1] + path[idx2:]
```

**Questions to Answer**:
- Why two stages (greedy + random)?
- What's the time complexity of greedy straightening?
- How many iterations needed for random smoothing?
- How to handle moving obstacles during smoothing?

**Benefits of Greedy Straightening**:
- Deterministic first pass (predictable results)
- Creates longest possible straight segments
- Reduces waypoint count by 50-80%
- Easier for robot controller to follow

**Resources**:
- [ ] Our file: `path_planning/path_smoothing.py`
- [ ] Path planning literature on post-processing
- [ ] Our implementation in multi_threaded_pipeline.py

---

#### 8.4 Collision Checking
**What We Need to Understand**:
- [ ] Line-circle intersection test (2D case)
- [ ] Closest point on line segment to circle center
- [ ] Inflated obstacles (robot radius + obstacle radius)
- [ ] Computational cost of collision checking

**Mathematical Foundation**:
```
Line segment: p1 to p2
Circle: center c, radius r

1. Find closest point on segment to circle center:
   t = dot(c - p1, p2 - p1) / ||p2 - p1||²
   t_clamped = clamp(t, 0, 1)
   closest = p1 + t_clamped × (p2 - p1)

2. Check distance:
   collision = ||closest - c|| <= r
```

**Our Implementation**: `_line_segment_circle_collision()` in path_smoothing.py

**Questions to Answer**:
- Why clamp t to [0, 1]?
- How to extend to 3D (cylinder collision)?
- How to handle uncertainty in obstacle positions?
- How to optimize collision checking (spatial hashing)?

**Resources**:
- [ ] Computational Geometry textbooks
- [ ] Our file: `path_planning/path_smoothing.py` (lines 3-15)

---

## 9️⃣ Multi-Threading & Multi-Processing

### 🔴 CRITICAL Topics

#### 9.1 Python GIL (Global Interpreter Lock)
**What We Need to Understand**:
- [ ] Why Python can't use multiple CPU cores for threads
- [ ] GIL prevents parallel execution of Python bytecode
- [ ] I/O operations release the GIL
- [ ] C extensions (NumPy, OpenCV) release the GIL

**Key Concept**:
```
Python Threads:
- Good for: I/O-bound tasks (camera, network, file I/O)
- Bad for: CPU-bound tasks (math, image processing, path planning)
- Reason: GIL allows only ONE thread to execute Python code at a time

Python Multiprocessing:
- Good for: CPU-bound tasks (bypasses GIL completely)
- Bad for: Overhead of process creation and IPC
- Reason: Separate processes have separate GILs
```

**Our Architecture Decision**:
```python
# I/O-bound tasks → Threads
Thread 1: Camera capture (wait for frames)
Thread 5: DDS communication (network I/O)

# CPU-bound tasks → Processes
Process 2: Extrinsics computation (matrix math)
Process 3: Kalman filtering (state estimation)
Process 4: RRT path planning (tree search, collision checking)
```

**Questions to Answer**:
- When to use threading vs multiprocessing?
- How does GIL impact NumPy operations?
- Why doesn't OpenCV camera capture benefit from multiprocessing?
- What's the overhead of IPC (inter-process communication)?

**Resources**:
- [ ] Python GIL documentation
- [ ] David Beazley: "Understanding the Python GIL" (PyCon talk)
- [ ] Our file: `full_pipeline/scripts/multi_threaded_pipeline.py`

---

#### 9.2 Inter-Process Communication (IPC)
**What We Need to Understand**:
- [ ] Multiprocessing queues (multiprocessing.Queue)
- [ ] Shared memory (multiprocessing.Value, Array)
- [ ] Pipes (multiprocessing.Pipe)
- [ ] Serialization overhead (pickle)

**Our Implementation**:
```python
from multiprocessing import Queue as MPQueue

# Create queues for data flow
detection_queue = MPQueue(maxsize=10)
transform_queue = MPQueue(maxsize=10)
kalman_queue = MPQueue(maxsize=10)
path_queue = MPQueue(maxsize=10)

# Producer (Thread 1)
detection_queue.put(frame_data)

# Consumer (Process 2)
frame_data = detection_queue.get(timeout=0.1)
```

**Queue Flow Control**:
```python
# Bounded queue (maxsize=10)
# - Producer blocks if queue full
# - Consumer blocks if queue empty
# - Use timeout to avoid deadlock

try:
    queue.put(data, timeout=0.1)  # Non-blocking with timeout
except Full:
    pass  # Skip frame to maintain real-time performance
```

**Questions to Answer**:
- What's the overhead of pickle serialization?
- When do queues block vs drop data?
- How to prevent memory leaks from unbounded queues?
- Shared memory vs queues: trade-offs?

**Resources**:
- [ ] Python multiprocessing documentation
- [ ] Our file: `full_pipeline/scripts/multi_threaded_pipeline.py` (lines 30-37)

---

#### 9.3 Process Synchronization & Cleanup
**What We Need to Understand**:
- [ ] Daemon processes (auto-terminate with parent)
- [ ] Process termination (graceful vs force kill)
- [ ] Queue draining (prevent blocking on join)
- [ ] Signal handling (Ctrl+C, ESC key)

**Our Cleanup Strategy**:
```python
def cleanup_processes(processes, stop_event, timeout=2.0):
    # 1. Signal all processes to stop
    stop_event.set()
    
    # 2. Wait for graceful shutdown
    for proc in processes:
        proc.join(timeout=timeout)
    
    # 3. Force terminate if still alive
    for proc in processes:
        if proc.is_alive():
            proc.terminate()
            proc.join(timeout=1)
    
    # 4. Kill if still alive
    for proc in processes:
        if proc.is_alive():
            proc.kill()
```

**Queue Draining** (prevents deadlock):
```python
def drain_queue(q, timeout=0.5):
    """Remove all items from queue to unblock producers."""
    end_time = time.time() + timeout
    while time.time() < end_time:
        try:
            q.get_nowait()
        except Empty:
            break
```

**Questions to Answer**:
- Why drain queues before joining processes?
- What's the difference between terminate() and kill()?
- When to use daemon=True?
- How to handle Ctrl+C gracefully?

**Resources**:
- [ ] Python multiprocessing best practices
- [ ] Our file: `full_pipeline/scripts/multi_threaded_pipeline.py` (lines 550-600)

---

#### 9.4 Real-Time Performance Considerations
**What We Need to Understand**:
- [ ] Frame dropping vs buffering
- [ ] Latency vs throughput trade-off
- [ ] Queue sizing (too small = dropped frames, too large = latency)
- [ ] CPU affinity and priority

**Our Design Decisions**:
```python
# Small queues (maxsize=10) for low latency
# - Prefer dropping old frames over accumulating lag
# - Real-time system: latest data more important than all data

# Timeout-based operations
# - Never block indefinitely
# - Maintain responsiveness

# Separate processes for CPU-intensive tasks
# - Each process can use 100% of one CPU core
# - Total throughput scales with CPU cores
```

**Latency Budget**:
```
Camera capture:        ~33ms (30 FPS)
ArUco detection:       ~10ms
Extrinsics transform:  ~5ms
Kalman filter:         ~1ms
Path planning:         ~50-2000ms (timeout protected)
Visualization:         ~10ms
-----------------------------------
Total latency:         ~100-2100ms

Target: <100ms for most frames (excluding path planning)
```

**Questions to Answer**:
- What's the critical path for latency?
- How to measure end-to-end latency?
- When to drop frames vs buffer them?
- How to prioritize tasks?

**Resources**:
- [ ] Real-time systems literature
- [ ] Our file: `full_pipeline/scripts/multi_threaded_pipeline.py`

---

## 🔟 Timeout Handling & Fallback Strategies

### 🟡 HIGH Priority Topics

#### 10.1 Timeout Protection
**What We Need to Understand**:
- [ ] Why path planning can take unbounded time
- [ ] How to set appropriate timeout values
- [ ] Difference between timeout per attempt vs total timeout
- [ ] Trade-off: timeout too short = no path, too long = lag

**Our Implementation**:
```python
MAX_PLANNING_TIME = 2.0s      # Max time per RRT attempt
FAILURE_TIMEOUT = 3.0s        # Trigger sudden stop
MAX_RRT_ATTEMPTS = 3          # Attempts per cycle
FALLBACK_PATH_HOLD_TIME = 5.0s  # Hold fallback path

# Planning with timeout
planning_start = time.time()
for seed in range(MAX_RRT_ATTEMPTS):
    if time.time() - planning_start > MAX_PLANNING_TIME:
        break  # Timeout
    
    path = rrt_connect_plan(start, goal, obstacles, bounds)
    if path:
        return path

# No path found - try fallback
```

**Questions to Answer**:
- How to choose timeout values?
- What to do when planning times out?
- How to balance exploration vs exploitation?
- When to give up entirely?

**Resources**:
- [ ] Our file: `full_pipeline/scripts/multi_threaded_pipeline.py` (lines 420-500)

---

#### 10.2 Fallback Strategies
**What We Need to Understand**:
- [ ] Relaxed obstacle constraints (70% enemy radius)
- [ ] Backward waypoint allowance
- [ ] Path holding to prevent oscillation
- [ ] Sudden stop trigger

**Fallback Hierarchy**:
```
1. Normal planning with full obstacles
   ↓ (fails)
2. Relaxed obstacles (70% radius)
   ↓ (fails)
3. Allow backward waypoints
   ↓ (fails)
4. Sudden stop + warning

Path holding:
- If fallback path found → hold for 5 seconds
- Prevents rapid switching between strategies
- Robot follows stable trajectory
```

**Questions to Answer**:
- How much to relax obstacles?
- When to allow backward movement?
- How long to hold fallback paths?
- How to visualize fallback state to operator?

**Resources**:
- [ ] Our file: `full_pipeline/scripts/multi_threaded_pipeline.py` (lines 450-520)

---

## 8️⃣ Wireless Communication

### 🟡 HIGH Priority Topics

#### 8.1 Communication Protocols
**What We Need to Understand**:
- [ ] WebSocket: Full-duplex, TCP-based
- [ ] MQTT: Pub/sub, lightweight, TCP-based
- [ ] UDP: Connectionless, fast, unreliable
- [ ] Trade-offs: reliability vs latency vs bandwidth

**Questions to Answer**:
- Which protocol is best for competition WiFi?
- How to handle packet loss (10-30% expected)?
- Message format (JSON vs binary)?
- Update rate (30 Hz vision → ? Hz to robot)?

**Resources**:
- [ ] WebSocket specification (RFC 6455)
- [ ] MQTT documentation
- [ ] UDP vs TCP comparisons
- [ ] Our file: `README.md` (Communication section)

---

#### 8.2 Data Serialization & Bandwidth
**What We Need to Understand**:
- [ ] JSON vs MessagePack vs Protocol Buffers
- [ ] Bandwidth requirements (enemy pos + caisse pos + timestamp)
- [ ] Compression techniques
- [ ] Update rate vs data size trade-off

**Example Message**:
```json
{
  "timestamp": 1696789012.345,
  "enemy": {"id": 30, "x": 1.5, "y": 0.8, "theta": 0.3, "conf": 0.95},
  "caisses": [
    {"id": 36, "x": 0.5, "y": 0.6, "conf": 0.88},
    {"id": 47, "x": 1.2, "y": 0.9, "conf": 0.92}
  ]
}
```

**Questions to Answer**:
- How many bytes per message?
- At 30 Hz, what's the bandwidth?
- Can we optimize further?

**Resources**:
- [ ] JSON specification
- [ ] MessagePack documentation
- [ ] Network protocol design literature

---

## 9️⃣ MATLAB Simulations

### 🟢 MEDIUM Priority Topics

#### 9.1 Simulation vs Reality
**What We Need to Understand**:
- [ ] Purpose of MATLAB simulations (visualization, planning)
- [ ] Limitations (simplified models, no noise)
- [ ] How to validate simulation results with real data

**Our Simulations**:
- `simulate_camera_positioning_SUBPLOT.m` - Interactive camera placement
- `test_graphics.m` - Diagnostic visualization
- Various detection and tracking demos

**Questions to Answer**:
- How realistic are our simulations?
- What's missing (lighting, occlusion, noise)?
- How to use simulations for system design?

**Resources**:
- [ ] Our files in `matlab_simulations/`
- [ ] MATLAB Computer Vision Toolbox documentation

---

## 🎯 Study Plan & Timeline

### Week 1: Fundamentals (Priority 🔴 CRITICAL)
**Focus**: Camera calibration, coordinate systems, transformations

- [ ] **Day 1-2**: Pinhole camera model, intrinsics, distortion
  - Read: OpenCV calibration tutorial
  - Read: Our calibration documentation
  - Exercise: Derive projection equations by hand
  
- [ ] **Day 3-4**: Coordinate systems, rotation matrices
  - Read: Multiple View Geometry Chapter 2
  - Exercise: Manually compute transformations
  
- [ ] **Day 5**: Extrinsics and solvePnP
  - Read: solvePnP documentation
  - Exercise: Work through PnP problem on paper

**Validation**: Can you explain calibration to someone else? Can you derive transformations without looking?

---

### Week 2: Detection & Filtering (Priority 🔴 CRITICAL)
**Focus**: ArUco detection, Kalman filtering

- [ ] **Day 1-2**: ArUco marker detection pipeline
  - Read: ArUco original paper
  - Read: Our detection code
  - Exercise: Manually detect marker ID from image
  
- [ ] **Day 3-5**: Kalman filter theory and implementation
  - Read: "Kalman Filter for Dummies"
  - Read: Our Kalman filter code
  - Exercise: Implement 1D Kalman filter from scratch
  - Exercise: Tune Q and R matrices for different scenarios

**Validation**: Can you implement Kalman filter without library? Can you tune parameters intelligently?

---

### Week 3: Integration & Competition (Priority 🟡 HIGH)
**Focus**: Occlusion handling, data flow, competition specifics

- [ ] **Day 1-2**: Occlusion detection and strategies
  - Read: Our occlusion handler documentation
  - Exercise: Design occlusion strategy for edge case
  
- [ ] **Day 3-4**: Complete pipeline understanding
  - Read: DATA_FLOW.md
  - Exercise: Trace data through entire pipeline
  - Exercise: Identify bottlenecks and optimization opportunities
  
- [ ] **Day 5**: Competition rules and constraints
  - Read: Cahier des Charges
  - Exercise: Map competition tasks to vision requirements

**Validation**: Can you explain the full pipeline? Can you estimate system performance?

---

### Week 4: Advanced Topics & Communication (Priority 🟢 MEDIUM)
**Focus**: Advanced filtering, wireless communication

- [ ] **Day 1-2**: Extended Kalman Filter (optional)
  - Read: Probabilistic Robotics Chapter 3.3
  - Exercise: Linearize non-linear motion model
  
- [ ] **Day 3-4**: Wireless communication protocols
  - Read: WebSocket, MQTT, UDP documentation
  - Exercise: Analyze bandwidth requirements
  
- [ ] **Day 5**: Review and gap analysis
  - Revisit unclear topics
  - Update this document with understanding status

**Validation**: Are you confident to proceed with integration? Can you debug issues independently?

---

## 📊 Understanding Checklist

Use this to track your progress:

### Camera & Calibration
- [ ] Can explain pinhole camera model
- [ ] Understand focal length and principal point
- [ ] Know how distortion coefficients work
- [ ] Can interpret calibration results
- [ ] Understand when to recalibrate

### Coordinate Systems
- [ ] Can draw and label world, camera, image frames
- [ ] Understand rotation matrices and their properties
- [ ] Know how to use Rodrigues formula
- [ ] Can manually compose transformations
- [ ] Understand extrinsic matrix [R|t]

### ArUco Detection
- [ ] Know how ArUco markers encode IDs
- [ ] Understand detection pipeline
- [ ] Can tune detection parameters
- [ ] Know how solvePnP works
- [ ] Understand pose estimation accuracy

### Kalman Filtering
- [ ] Can derive Kalman filter equations
- [ ] Understand predict-update cycle
- [ ] Know how to choose motion model
- [ ] Can tune Q and R matrices intelligently
- [ ] Understand when Kalman filter fails

### Occlusion Handling
- [ ] Can detect occlusion types
- [ ] Know when to use each strategy
- [ ] Understand confidence fusion
- [ ] Can estimate maximum occlusion duration

### System Integration
- [ ] Understand complete data flow
- [ ] Know computational requirements
- [ ] Can estimate total system latency
- [ ] Understand error propagation
- [ ] Can identify optimization opportunities

### Competition Specifics
- [ ] Know all ArUco ID assignments
- [ ] Understand field layout and constraints
- [ ] Know camera placement requirements
- [ ] Understand WiFi challenges
- [ ] Can map vision to competition tasks

---

## 📝 Understanding Validation Methods

### 1. Teach-Back Method
- Explain concept to someone (or write detailed explanation)
- If you can't explain simply, you don't understand well enough

### 2. Implementation from Scratch
- Implement key algorithms without libraries
- Forces deep understanding of mechanics

### 3. Parameter Tuning Exercise
- Change parameters systematically
- Predict impact before observing
- Validates understanding of system behavior

### 4. Edge Case Analysis
- Identify failure modes
- Design solutions
- Tests depth of understanding

### 5. Code Review with Theory
- Review our existing code
- Explain why each line works
- Connect code to mathematical theory

---

## 🚀 After Understanding: Return to Implementation

### When Ready to Resume Coding:
1. ✅ Complete at least Week 1 & 2 studies (CRITICAL topics)
2. ✅ Pass understanding checklist (at least 80%)
3. ✅ Can explain key concepts without notes
4. ✅ Feel confident to debug issues
5. ✅ Have documented understanding in this file

### Next Implementation Steps:
1. Camera extrinsics computation (with understanding!)
2. Enemy detection with coordinate transformation
3. Full Kalman filter integration
4. Wireless communication module
5. Complete system testing

---

## 📚 Recommended Resources

### Books
- **Multiple View Geometry** by Hartley & Zisserman
  - The bible for 3D computer vision
  - Chapters 2, 6, 7 most relevant
  
- **Probabilistic Robotics** by Thrun, Burgard, Fox
  - Excellent for Kalman filters
  - Chapter 3 (Gaussian Filters)
  
- **Computer Vision: Algorithms and Applications** by Szeliski
  - Practical introduction
  - Free online: http://szeliski.org/Book/

### Online Courses
- **Coursera**: "Introduction to Computer Vision" (Georgia Tech)
- **YouTube**: "First Principles of Computer Vision" (Columbia University)
- **YouTube**: Cyrill Stachniss - "Photogrammetry" lectures

### Papers
- Zhang (1999): "A Flexible New Technique for Camera Calibration"
- Garrido-Jurado (2014): "Automatic generation and detection of highly reliable fiducial markers under occlusion" (ArUco)
- Welch & Bishop (1995): "An Introduction to the Kalman Filter"

### Tutorials
- OpenCV official documentation (excellent tutorials)
- "Kalman Filter for Dummies" (online)
- Multiple geometry tutorials on YouTube

---

## 💡 Study Tips

1. **Don't Rush**: Deep understanding takes time
2. **Work Problems by Hand**: Do math on paper, not just read
3. **Implement Simple Versions**: 1D Kalman, 2D transformations
4. **Ask "Why?"**: Don't accept formulas, understand derivations
5. **Connect Theory to Code**: Review implementation with theory
6. **Test Understanding**: Teach-back, edge cases, parameter tuning
7. **Take Breaks**: Let concepts sink in
8. **Document**: Write explanations in your own words

---

## ✅ Success Criteria

You're ready to resume implementation when:

1. ✅ Can explain camera calibration to a teammate
2. ✅ Can derive coordinate transformations manually
3. ✅ Can implement 1D Kalman filter from scratch
4. ✅ Can tune Kalman parameters for different scenarios
5. ✅ Can trace data through entire pipeline
6. ✅ Can predict system behavior for edge cases
7. ✅ Feel confident debugging issues
8. ✅ Can make informed design decisions

**Remember**: The time spent understanding now will save 10x time debugging later!

---

**Status**: 📚 **STUDY MODE ACTIVE**  
**Next Update**: After Week 1 studies complete  
**Goal**: Solid theoretical foundation before final integration

🎓 **Happy studying!**
