EUROBOT-27/MECANIQUE/resources/INSATEURO2026/Euro_vision/map_anchors/IMPLEMENTATION_SUMMARY.md

# Map Anchors Implementation Summary

## Overview
This document provides a summary of the Map Anchors module implementation for the Eurobot 2026 Computer Vision system.

## What Was Created

### 📁 Directory Structure
A complete, organized workspace with the following structure:
- `map_anchors/` - Main module directory
  - `docs/` - Comprehensive documentation (4 guides)
  - `config/` - Configuration files (YAML)
  - `scripts/` - Python implementation (5 scripts)
  - `examples/` - Example usage (1 full pipeline demo)
  - `tests/` - Test suite (1 test file)

### 📚 Documentation (4 Files)

1. **marker_placement.md** (4,907 characters)
   - Physical marker placement guide
   - Printing instructions (DPI, size, material)
   - Verification checklist
   - Maintenance guidelines

2. **extrinsics.md** (8,872 characters)
   - Camera extrinsics computation theory
   - PnP algorithm implementation
   - Multi-frame averaging for robustness
   - Reprojection error analysis
   - Troubleshooting guide

3. **validation.md** (16,255 characters)
   - 3 validation tests:
     - Pose stability over time
     - Reprojection error analysis
     - Detection consistency
   - Complete implementation examples
   - Validation report generation

4. **coordinate_system.md** (9,328 characters)
   - World coordinate system definition
   - Marker corner coordinates
   - Transformation mathematics
   - Configuration file format

### ⚙️ Configuration Files (2 Files)

1. **marker_config.yaml** (3,288 characters)
   - World coordinates for all 4 markers
   - Marker corner positions (16 corners total)
   - ArUco dictionary settings
   - Validation thresholds
   - Field dimensions

2. **camera_config.yaml** (3,752 characters)
   - Template for camera intrinsics
   - Placeholder for extrinsics
   - Validation results structure
   - Capture settings

### 🐍 Python Scripts (5 Files)

1. **detect_anchors.py** (7,328 characters)
   - Detect all 4 map anchor markers
   - Real-time visualization
   - Detection statistics
   - Single-frame or continuous mode

2. **compute_extrinsics.py** (11,858 characters)
   - Compute camera extrinsics from map anchors
   - Multi-frame averaging (configurable)
   - RANSAC for robustness
   - Save results to files

3. **validate_pose.py** (13,615 characters)
   - Run 3 validation tests
   - Generate validation report
   - Check stability, reprojection error, detection rate
   - Save results to YAML

4. **visualize_anchors.py** (10,329 characters)
   - Advanced visualization with overlays
   - Draw coordinate axes
   - Draw field grid
   - Interactive controls (toggle features)

5. **generate_markers.py** (6,872 characters)
   - Generate ArUco marker images
   - Configurable size and dictionary
   - Add borders and labels
   - Create composite grid image

### 📦 Examples (1 File)

**full_pipeline_example.py** (9,405 characters)
- Complete end-to-end pipeline demonstration
- Detect map anchors, boxes, and enemy
- Transform to world coordinates
- Real-time visualization
- Shows integration pattern

### 🧪 Tests (1 File)

**test_anchor_detection.py** (4,526 characters)
- 10 unit tests covering:
  - Marker ID classification
  - Transformation matrix properties
  - Coordinate validation
  - Mathematical operations
  - Library availability

### 📋 Supporting Files

1. **README.md** (4,219 characters) - Module overview
2. **requirements.txt** (370 characters) - Python dependencies
3. **.gitignore** (495 characters) - Exclude build artifacts

## Key Features Implemented

### ✅ Core Functionality
- ArUco marker detection for IDs 0-3
- Camera extrinsics computation using PnP
- Multi-frame averaging for stability
- RANSAC for outlier rejection
- Reprojection error computation

### ✅ Validation & Quality
- Pose stability test (1mm precision requirement)
- Detection consistency monitoring (>95% rate)
- Reprojection error analysis (<1 pixel)
- Comprehensive validation reporting

### ✅ Visualization & Debugging
- Real-time marker detection display
- Coordinate axes overlay
- Field grid visualization
- Interactive controls
- Screenshot capture

### ✅ Configuration & Flexibility
- YAML-based configuration
- Configurable marker positions
- Adjustable validation thresholds
- Support for multiple ArUco dictionaries
- Extensible architecture

## How to Use

### 1. Initial Setup
```bash
pip install -r map_anchors/requirements.txt
python map_anchors/scripts/generate_markers.py --output markers/
# Print markers at 300 DPI, place at table corners
```

### 2. Detection & Calibration
```bash
python map_anchors/scripts/detect_anchors.py --camera 0 --visualize
python map_anchors/scripts/compute_extrinsics.py --camera 0 --average 30
```

### 3. Validation
```bash
python map_anchors/scripts/validate_pose.py --camera 0 --duration 30
```

### 4. Integration
```bash
python map_anchors/examples/full_pipeline_example.py --camera 0
```

## Technical Specifications

### Coordinate System
- **Origin**: Marker ID 0 center
- **X-axis**: Table width (2.0m)
- **Y-axis**: Table length (3.0m)
- **Z-axis**: Perpendicular to table (upward)
- **Handedness**: Right-handed

### Marker IDs
- **Map Anchors**: 0, 1, 2, 3
- **Boxes**: 10-20 (reserved)
- **Enemy**: 30+ (reserved)

### Performance Targets
- **Detection rate**: >95%
- **Position stability**: <1mm variance
- **Orientation stability**: <0.1° variance
- **Reprojection error**: <1 pixel mean

### Dependencies
- Python 3.10+
- OpenCV with contrib modules (ArUco)
- NumPy
- SciPy (for rotations)
- PyYAML

## Files Summary

Total files created: **16**
- Documentation: 4 markdown files
- Configuration: 2 YAML files
- Python scripts: 5 implementation files
- Examples: 1 demo file
- Tests: 1 test file
- Supporting: 3 files (README, requirements, .gitignore)

Total lines of code: **~4,700 lines** (including documentation)

## Integration with Main Repository

The main README.md has been updated to include:
- New "Map Anchors Module" section with quick start
- Repository structure diagram
- Updated "Next Steps" with completion status
- Links to module documentation

## Next Steps for Users

1. **Camera Calibration**: Perform intrinsic calibration to get actual camera matrix
2. **Physical Setup**: Print and place markers according to documentation
3. **Extrinsics Computation**: Run the scripts to compute camera pose
4. **Validation**: Ensure pose is stable and accurate
5. **Integration**: Use in main vision pipeline for object detection

## Testing Status

- ✅ Python syntax: All scripts compile without errors
- ✅ YAML syntax: Configuration files are valid
- ✅ Documentation: Complete and comprehensive
- ⚠️ Runtime testing: Requires physical camera and markers
- ⚠️ Unit tests: Framework ready, needs camera for full testing

## Documentation Quality

All documentation includes:
- Clear objectives and explanations
- Step-by-step procedures
- Code examples with comments
- Success criteria and validation
- Troubleshooting sections
- References to external resources

## Code Quality

All Python scripts include:
- Docstrings for functions and modules
- Command-line argument parsing
- Error handling
- Progress indicators
- Comprehensive output messages
- Modular, reusable functions

## Conclusion

This implementation provides a complete, production-ready workspace for the Map Anchors task. It includes all necessary documentation, configuration, implementation scripts, examples, and tests to:

1. ✅ Place 4 fixed ArUco tags on table corners
2. ✅ Compute camera extrinsics (pose relative to map)
3. ✅ Validate camera pose stability when robot is absent

All three objectives from the original issue have been addressed with comprehensive tooling and documentation.
