EUROBOT-27/MECANIQUE/resources/INSATEURO2026/Navigation/docs/01-Introduction.md

# Introduction 

This repository provides a low-level state-estimation and motion control system designed for a differential-drive mobile robot. The system combines real-time positioning with smooth, controlled trajectory execution through three core pillars:

* **Encoder Odometry:** Continuously tracks the robot's global pose (X, Y, theta) using high-frequency encoder feedback .
* **Trapezoidal Velocity Profiling:** Manages acceleration, cruise, and deceleration phases to guarantee smooth, predictable motion.
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
