EUROBOT-27/MECANIQUE/resources/INSATEURO2026/Electrique/Carte Puissance PCB/puissance.png

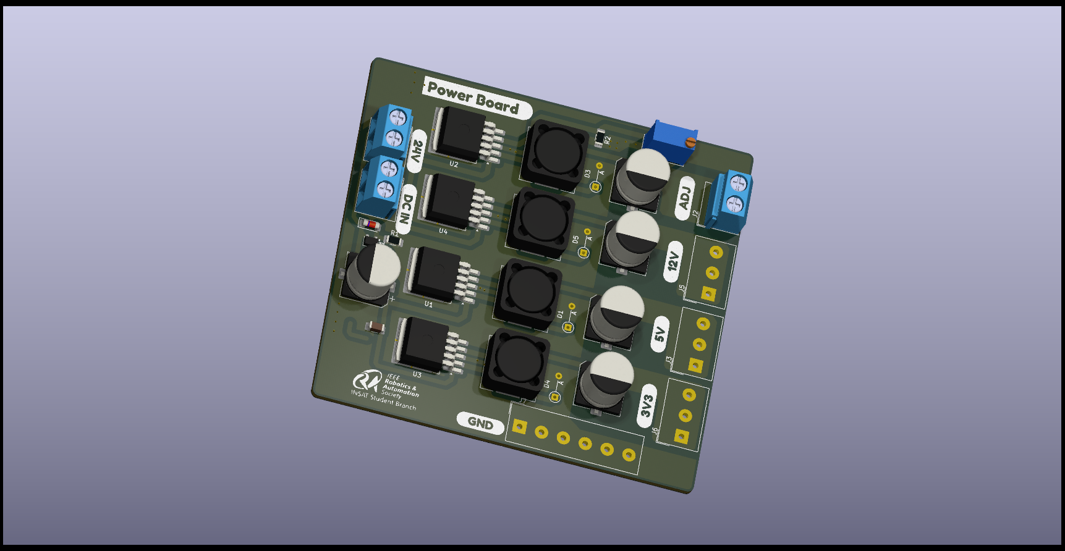
resources/INSATEURO2026/Electrique/Carte Puissance PCB/puissance.png
