EUROBOT-27/MECANIQUE/resources/INSATEURO2026/Electrique/Shield STM32 PCB/shield_stm2025.png

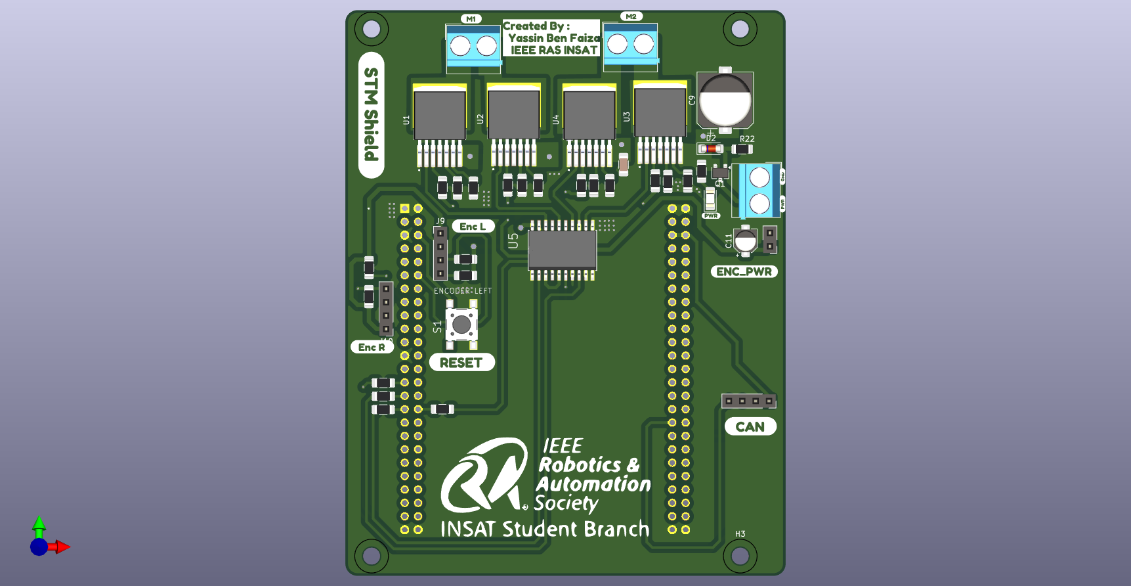
resources/INSATEURO2026/Electrique/Shield STM32 PCB/shield_stm2025.png
