EUROBOT-27/MECANIQUE/resources/INSATEURO2026/Euro_vision/ArUco_detection_folder/examples/eurobot_markers/eurobot_marker_03_blue.png

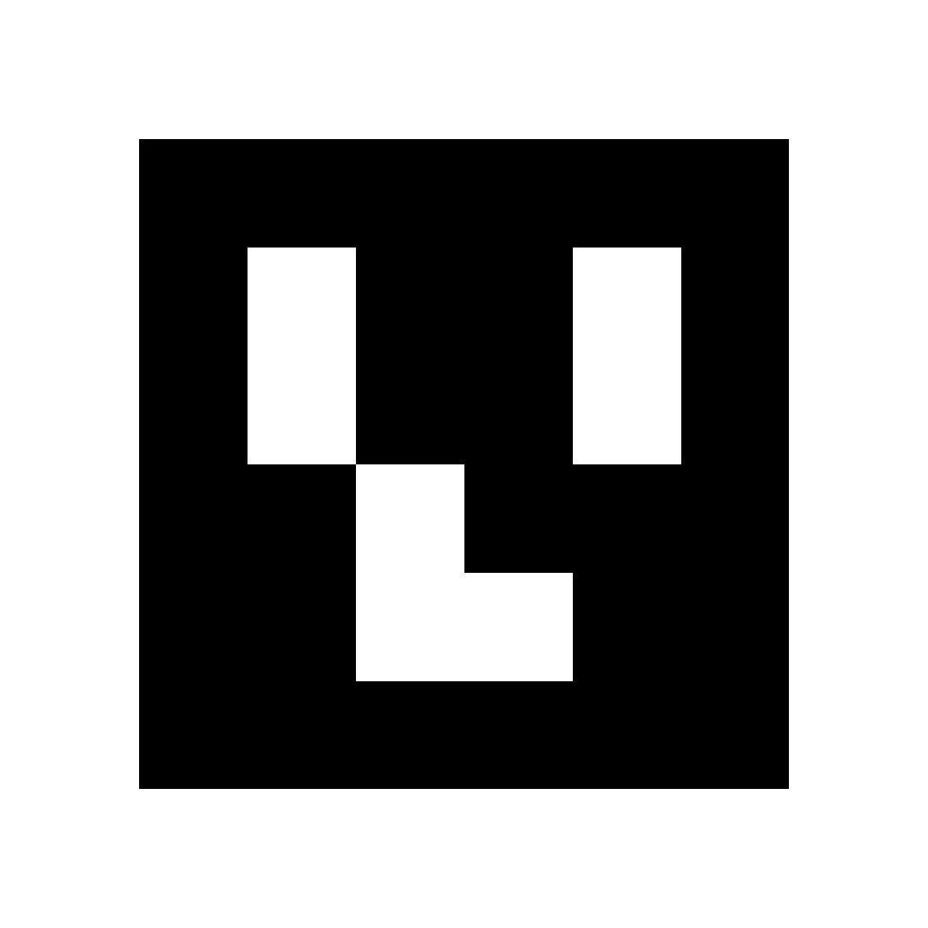
resources/INSATEURO2026/Euro_vision/ArUco_detection_folder/examples/eurobot_markers/eurobot_marker_03_blue.png
