EUROBOT-27/MECANIQUE/resources/INSATEURO2026/Euro_vision/caisses_detection/scripts/markers/aruco_DICT_4X4_50_id_41.png

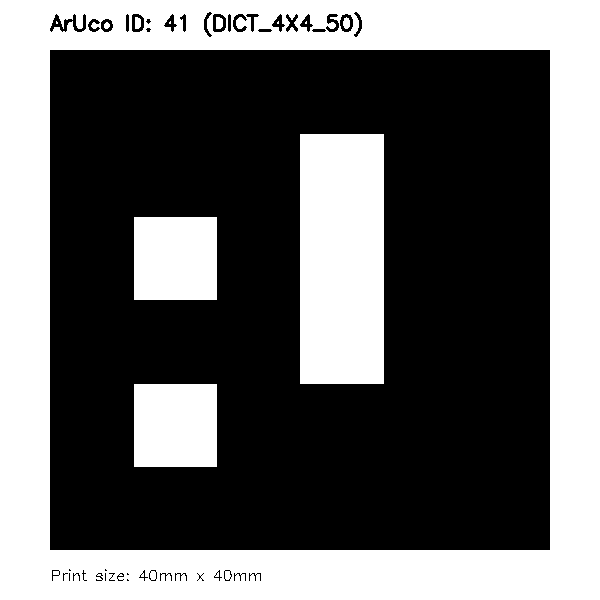
resources/INSATEURO2026/Euro_vision/caisses_detection/scripts/markers/aruco_DICT_4X4_50_id_41.png
