EUROBOT-27/MECANIQUE/resources/INSATEURO2026/Navigation/docs/s_curve.png

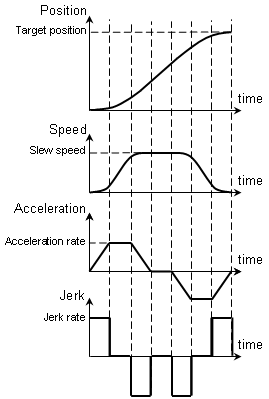
resources/INSATEURO2026/Navigation/docs/s_curve.png
