EUROBOT-27/MECANIQUE/resources/INSATEURO2026/Navigation/docs/state_machineNAV.jpg

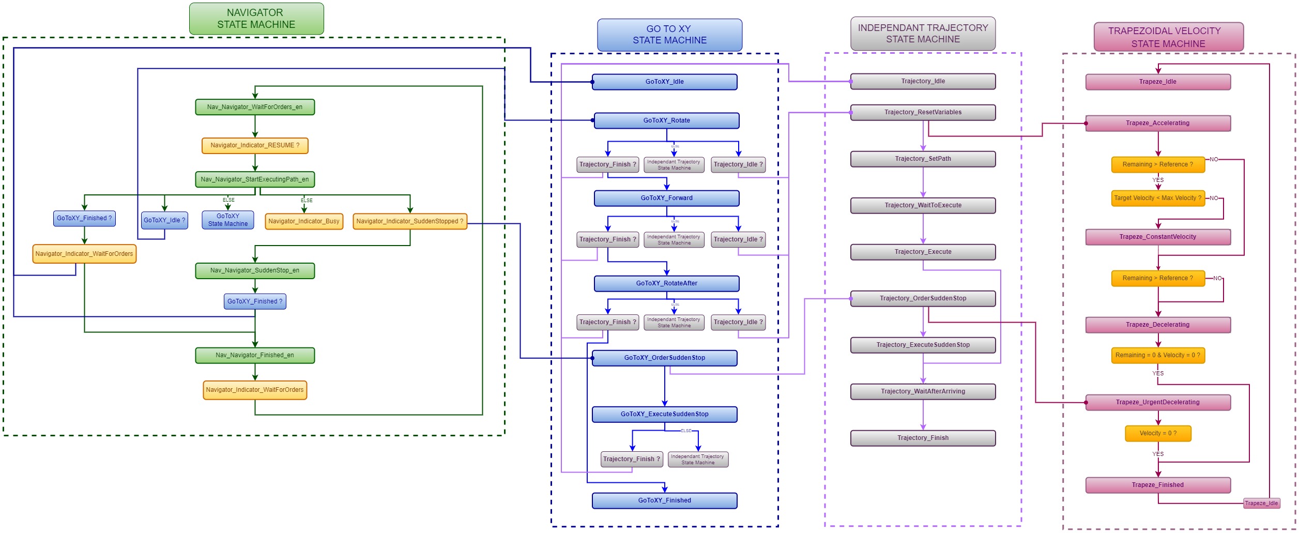
resources/INSATEURO2026/Navigation/docs/state_machineNAV.jpg
