EUROBOT-27/MECANIQUE/resources/INSATEURO2026/Navigation/docs/trapeze.png

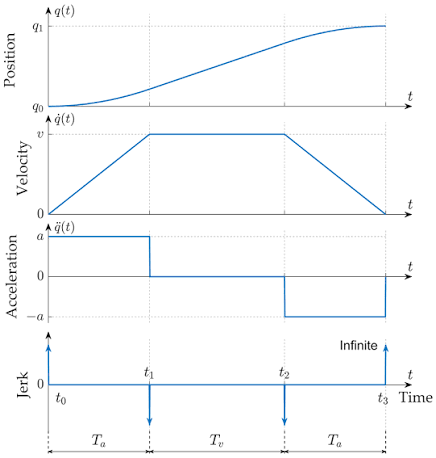
resources/INSATEURO2026/Navigation/docs/trapeze.png
