EUROBOT-27/MECANIQUE/resources/INSATEURO2026/Electrique/Carte Finale JLCPCB/Footprints/Eurobot_Footprint_Sourcing_Redo.csv

Part Type | Part Name | Part Value if it has one | Part Reference on the kicad file | Recommended Footprint | Link to JLCPCB (if it does not exist put N/A) | Link to Tunisian Shop (if it does not exist put N/A) | Link to Datasheet | Price | Stock Status | Validation / edge-case note
Capacitor | Nichicon UWT1H221MNL1GS | 220u | C1,C2,C3,C20,C21,C23 | Capacitor_SMD:CP_Elec_10x10.5 | https://jlcpcb.com/partdetail/-/C125977 | N/A | https://www.nichicon.co.jp/english/products/pdfs/e-uwt.pdf | $0.1020 | JLC Extended, In Stock=562737 (checked 2026-02-07) | High-ripple SMD electrolytic; suitable for buck input/output bulk.
Capacitor | Samsung CL10A105KB8NNNC | 1uF (105) | C4,C5,C6,C7,C8,C9,C10,C11,C13,C22,C24,C25,C26,C27,C28,C29,C30,C32 | Capacitor_SMD:C_0603_1608Metric | https://jlcpcb.com/partdetail/-/C15849 | N/A | https://media.digikey.com/pdf/Data%20Sheets/Samsung%20PDFs/CL10A105KB8NNN_Spec.pdf | $0.0032 | JLC Basic, In Stock=11413991 (checked 2026-02-07) | Moved to compact SMD decoupling footprint; 50V gives margin on 24V rails.
Capacitor | FOLLON EFVM025ADA102M10B0 | 1000u | C12 | Capacitor_SMD:CP_Elec_10x10.5 | https://jlcpcb.com/partdetail/-/C22387790 | N/A | https://wmsc.lcsc.com/wmsc/upload/file/pdf/v2/lcsc/2410151456_Chang-CD293-1000uF-25V_C22387790.pdf | $0.0300 | JLC Extended, In Stock=2316 (checked 2026-02-07) | Large bulk capacitor for transient load support.
Capacitor | ROQANG CK1V331M-CRG10 | 330u | C14,C16,C18,C31,C33,C34 | Capacitor_SMD:CP_Elec_10x10.5 | https://jlcpcb.com/partdetail/-/C22396014 | N/A | https://wmsc.lcsc.com/wmsc/upload/file/pdf/v2/lcsc/2411051626_Chang-zhou-kaixuan-electronic-CK1V331M-CRG10_C22396014.pdf | $0.0100 | JLC Extended, In Stock=3216 (checked 2026-02-07) | Bulk output capacitor class used on buck stages.
Capacitor | ACMECON GVT1V567M1010CN | 560u | C15 | Capacitor_SMD:CP_Elec_10x10.5 | https://jlcpcb.com/partdetail/-/C22383694 | N/A | https://wmsc.lcsc.com/wmsc/upload/file/pdf/v2/lcsc/2410151455_Chang-CD293-560uF-25V_C22383694.pdf | $0.0300 | JLC Extended, In Stock=139 (checked 2026-02-07) | Bulk stage capacitor; check ripple current against rail load.
Capacitor | YAGEO CC0603KRX7R9BB104 | 100n | C19 | Capacitor_SMD:C_0603_1608Metric | https://jlcpcb.com/partdetail/-/C14663 | N/A | https://www.yageo.com/upload/media/product/productsearch/datasheet/mlcc/UPY-GPHC_X7R_6.3V-to-50V_18.pdf | $0.0013 | JLC Basic, In Stock=51856021 (checked 2026-02-07) | Standard high-stock 100nF decoupling capacitor.
Zener Diode | LRC LM3Z10VT1G | 10V | D1 | Diode_SMD:D_SOD-323 | https://jlcpcb.com/partdetail/-/C131828 | N/A | https://www.onsemi.com/pdf/datasheet/lm3z2v4t1-d.pdf | $0.0131 | JLC Extended, In Stock=3031 (checked 2026-02-07) | 10V clamp; SOD-323 selected for smaller size than MiniMELF.
Schottky Diode | SUNMATE B540C | 5A 40V | D2 | Diode_SMD:D_SMC | https://jlcpcb.com/partdetail/-/C5338484 | N/A | https://www.vishay.com/docs/88546/ss52.pdf | $0.0200 | JLC Extended, In Stock=6949 (checked 2026-02-07) | Replaces invalid DO-34 choice; SMC package matches 5A power path use.
Schottky Diode | SUNMATE B540C | 5A 40V | D3,D4,D6,D7,D8,D11 | Diode_SMD:D_SMC | https://jlcpcb.com/partdetail/-/C5338484 | N/A | https://www.vishay.com/docs/88546/ss52.pdf | $0.0300 | JLC Extended, In Stock=6949 (checked 2026-02-07) | Power Schottky for buck freewheel/protection use.
LED | KENTO KT-0603R | Red LED | D12,D13,D14,D15,D16,D17,D18 | LED_SMD:LED_0603_1608Metric | https://jlcpcb.com/partdetail/-/C2286 | N/A | https://www.kingbright.com/attachments/file/psearch/000/00/00/LTST-C190KRKT.pdf | $0.0032 | JLC Basic, In Stock=7124338 (checked 2026-02-07) | Compact, very common basic LED footprint.
Connector | Terminal Block 2P 5.08mm | ADJ out | I2C1,J12,J13,J14 | TerminalBlock:TerminalBlock_1x02_P5.08mm | N/A | N/A | https://www.phoenixcontact.com/assets/downloads_ed/global/web_dwl_promotion/6529_en_00.pdf | N/A | No JLC SMT source verified (2026-02-07) | THT mechanical connector; excluded from SMT assembly.
Connector | Terminal Block 3P 5.08mm | 3.3V | J1 | TerminalBlock:TerminalBlock_1x03_P5.08mm | N/A | N/A | https://www.phoenixcontact.com/assets/downloads_ed/global/web_dwl_promotion/6529_en_00.pdf | N/A | No JLC SMT source verified (2026-02-07) | THT mechanical connector.
Connector | Terminal Block 3P 5.08mm | 5V | J2 | TerminalBlock:TerminalBlock_1x03_P5.08mm | N/A | N/A | https://www.phoenixcontact.com/assets/downloads_ed/global/web_dwl_promotion/6529_en_00.pdf | N/A | No JLC SMT source verified (2026-02-07) | THT mechanical connector.
Connector | Terminal Block 3P 5.08mm | 12V | J3 | TerminalBlock:TerminalBlock_1x03_P5.08mm | N/A | N/A | https://www.phoenixcontact.com/assets/downloads_ed/global/web_dwl_promotion/6529_en_00.pdf | N/A | No JLC SMT source verified (2026-02-07) | THT mechanical connector.
Connector | Terminal Block 2P 5.08mm | 24V Out | J4 | TerminalBlock:TerminalBlock_1x02_P5.08mm | N/A | N/A | https://www.phoenixcontact.com/assets/downloads_ed/global/web_dwl_promotion/6529_en_00.pdf | N/A | No JLC SMT source verified (2026-02-07) | THT mechanical connector.
Connector | XT60 Male PCB | LIPO 1 | J5 | Connector_AMASS:AMASS_XT60-M | N/A | N/A | https://www.amass.com/Uploads/image/file/20180911/1536654539648466.pdf | N/A | No JLC SMT source verified (2026-02-07) | High-current connector, hand-solder item.
Connector | XT60 Male PCB | LIPO 2 | J6 | Connector_AMASS:AMASS_XT60-M | N/A | N/A | https://www.amass.com/Uploads/image/file/20180911/1536654539648466.pdf | N/A | No JLC SMT source verified (2026-02-07) | High-current connector, hand-solder item.
Connector | Terminal Block 6P 5.08mm | Screw_Terminal_01x06 | J7 | TerminalBlock:TerminalBlock_1x06_P5.08mm | N/A | N/A | https://www.phoenixcontact.com/assets/downloads_ed/global/web_dwl_promotion/6529_en_00.pdf | N/A | No JLC SMT source verified (2026-02-07) | THT mechanical connector.
Connector | JST-PH B2B-PH 2.0mm | Emergency Stop | J8 | Connector_JST:JST_PH_B2B-PH-K_1x02_P2.00mm_Vertical | N/A | N/A | https://www.jst-mfg.com/product/pdf/eng/ePH.pdf | N/A | No JLC SMT source verified (2026-02-07) | THT connector, hand assembly.
Connector | JST-PH B2B-PH 2.0mm | LIPO 1 VOLT | J9 | Connector_JST:JST_PH_B2B-PH-K_1x02_P2.00mm_Vertical | N/A | N/A | https://www.jst-mfg.com/product/pdf/eng/ePH.pdf | N/A | No JLC SMT source verified (2026-02-07) | THT connector, hand assembly.
Connector | JST-PH B2B-PH 2.0mm | LIPO 2 VOLT | J10 | Connector_JST:JST_PH_B2B-PH-K_1x02_P2.00mm_Vertical | N/A | N/A | https://www.jst-mfg.com/product/pdf/eng/ePH.pdf | N/A | No JLC SMT source verified (2026-02-07) | THT connector, hand assembly.
Connector | JST-PH B2B-PH 2.0mm | Master Switch | J11 | Connector_JST:JST_PH_B2B-PH-K_1x02_P2.00mm_Vertical | N/A | N/A | https://www.jst-mfg.com/product/pdf/eng/ePH.pdf | N/A | No JLC SMT source verified (2026-02-07) | THT connector, hand assembly.
Connector | PinHeader 2x5 2.54mm | Conn_02x05 | J15 | Connector_PinHeader_2.54mm:PinHeader_2x05_P2.54mm_Vertical | N/A | N/A | https://gct.co/files/drawings/bc035.pdf | N/A | No JLC SMT source verified (2026-02-07) | Missing footprint fixed; standard debug/programming header.
Jumper | 2-pin Solder Jumper | Jumper_2_Small_Bridged | JP1,JP2,JP3,JP4,JP5,JP6,JP7 | Jumper:SolderJumper-2_P1.3mm_Open_Pad1.0x1.5mm | N/A | N/A | N/A | N/A | No JLC SMT source verified (2026-02-07) | Replaced tall bridged jumper with compact solder jumper for size/cost.
Inductor | 47uH power inductor (no verified JLC in-stock found) | 47uH | L1,L2,L4,L5,L6,L7 | Inductor_SMD:L_12x12mm_H6mm | N/A | N/A | N/A | N/A | No JLC SMT source verified (2026-02-07) | Critical value for XL4015; keep 47uH target, source manually if needed.
Inductor | BOURNS SRR1210-330M | 33uH | L3 | Inductor_SMD:L_12x12mm_H10.0mm | https://jlcpcb.com/partdetail/-/C3224641 | N/A | https://www.bourns.com/docs/product-datasheets/srr1210.pdf | $0.0100 | JLC Extended, In Stock=114 (checked 2026-02-07) | Power inductor for 33uH channel.
MOSFET | AOS AO3401A | P-MOSFET | Q1 | Package_TO_SOT_SMD:SOT-23 | https://jlcpcb.com/partdetail/-/C15127 | N/A | https://aosmd.com/res/data_sheets/AO3401A.pdf | $0.0326 | JLC Basic, In Stock=1182205 (checked 2026-02-07) | Common high-stock basic PMOS.
Resistor | UNI-ROYAL 0603WAF1002T5E | 10k | R1,R2 | Resistor_SMD:R_0603_1608Metric | https://jlcpcb.com/partdetail/-/C25804 | N/A | https://www.uniroyal.com/uploadfiles/2021/11/20211119105028687.pdf | $0.0006 | JLC Basic, In Stock=51382337 (checked 2026-02-07) | Moved to 0603 for compact size and basic assembly class.
Resistor | UNI-ROYAL 0603WAF3301T5E | 3.3k | R3,R7,R8,R12,R14 | Resistor_SMD:R_0603_1608Metric | https://jlcpcb.com/partdetail/-/C22978 | N/A | https://www.uniroyal.com/uploadfiles/2021/11/20211119105028687.pdf | $0.0006 | JLC Basic, In Stock=3719797 (checked 2026-02-07) | 0603 basic high-stock.
Resistor | YAGEO AC1206FR-0713KL | 13k | R4 | Resistor_SMD:R_1206_3216Metric | https://jlcpcb.com/partdetail/-/C229313 | N/A | https://www.yageo.com/upload/media/product/productsearch/datasheet/rchip/PYu-AC_51_RoHS_L_15.pdf | $0.0036 | JLC Extended, In Stock=3146 (checked 2026-02-07) | Only reliable in-stock option found is 1206 extended.
Resistor | UNI-ROYAL 0603WAF1501T5E | 1.5k | R5 | Resistor_SMD:R_0603_1608Metric | https://jlcpcb.com/partdetail/-/C22843 | N/A | https://www.uniroyal.com/uploadfiles/2021/11/20211119105028687.pdf | $0.0006 | JLC Basic, In Stock=3035715 (checked 2026-02-07) | 0603 basic high-stock.
Resistor | YAGEO AC1206FR-0760K4L | 60.4k | R6 | Resistor_SMD:R_1206_3216Metric | https://jlcpcb.com/partdetail/-/C229735 | N/A | https://www.yageo.com/upload/media/product/productsearch/datasheet/rchip/PYu-AC_51_RoHS_L_15.pdf | $0.0036 | JLC Extended, In Stock=69 (checked 2026-02-07) | E96 value found with very low stock; buy extra or allow alternate divider design.
Resistor | UNI-ROYAL 0603WAF1001T5E | 1k | R15,R16,R17,R18,R19,R20,R21 | Resistor_SMD:R_0603_1608Metric | https://jlcpcb.com/partdetail/-/C21190 | N/A | https://www.uniroyal.com/uploadfiles/2021/11/20211119105028687.pdf | $0.0006 | JLC Basic, In Stock=14780036 (checked 2026-02-07) | 0603 basic high-stock.
Shunt Resistor | YAGEO RL2512JK-070R1L | 0.1R 1% | R22,R23,R24,R25,R26,R27 | Resistor_SMD:R_2512_6332Metric | https://jlcpcb.com/partdetail/-/C876516 | N/A | https://www.yageo.com/upload/media/product/productsearch/datasheet/current-sense-resistors/rl.pdf | $0.0100 | JLC Extended, In Stock=650 (checked 2026-02-07) | Current shunt value matches INA219 measurement range.
Potentiometer | Bourns 3296W 10k (manual assembly) | Trimmer | RV1,RV2,RV3 | Potentiometer_THT:Potentiometer_Bourns_3296W_Vertical | N/A | N/A | https://www.bourns.com/docs/product-datasheets/3296.pdf | N/A | No JLC SMT source verified (2026-02-07) | THT trimmer; not in JLC SMT assembly catalog.
Buck Regulator | TDSEMIC LM2596S-3.3 | 3.3V fixed | U1 | Package_TO_SOT_SMD:TO-263-5_TabPin3 | https://jlcpcb.com/partdetail/-/C42421958 | N/A | https://www.ti.com/lit/ds/symlink/lm2596.pdf | $0.0100 | JLC Extended, In Stock=2119 (checked 2026-02-07) | Pin-compatible LM2596 class regulator, extended. Validate thermal and diode/inductor sizing.
Buck Regulator | XLSEMI XL4015E1 | 5A buck | U2,U3,U4,U5,U6,U7 | Package_TO_SOT_SMD:TO-263-5_TabPin3 | https://jlcpcb.com/partdetail/-/C51661 | N/A | https://www.xlsemi.com/datasheet/XL4015%20datasheet-English.pdf | $0.1400 | JLC Extended, In Stock=53683 (checked 2026-02-07) | Common budget 5A buck; needs suitable inductor and Schottky layout/thermal design.
Current/Power Monitor | TI INA219AIDCNR | I2C current sensor | U8,U9,U10,U11,U12,U13 | Package_TO_SOT_SMD:SOT-23-8 | https://jlcpcb.com/partdetail/-/C87469 | N/A | https://www.ti.com/lit/ds/symlink/ina219.pdf | $0.3301 | JLC Extended, In Stock=400 (checked 2026-02-07) | Edge case: bus voltage max 26V, so 24V rails have limited margin.
