EUROBOT-27/MECANIQUE/resources/INSATEURO2026/Electrique/Carte Finale JLCPCB/.Robot Principalold/Robot Principal.csv

Reference | Qty | Value | DNP | Exclude from BOM | Exclude from Board | Datasheet
C1,C2,C3,C4,C5,C6,C7,C8,C9,C10,C11,C12,C13,C14,C15,C16,C18,C19,C20,C21,C22,C23,C24,C25,C26,C27,C28,C29,C30,C31,C32,C33,C34,D1,D2,D3,D4,D6,D7,D8,D11,D12,D13,D14,D15,D16,D17,D18,I2C1,J1,J2,J3,J4,J5,J6,J7,J8,J9,J10,J11,J12,J13,J14,J15,JP1,JP2,JP3,JP4,JP5,JP6,JP7,L1,L2,L3,L4,L5,L6,L7,Q1,R1,R2,R3,R4,R5,R6,R7,R8,R12,R14,R15,R16,R17,R18,R19,R20,R21,R22,R23,R24,R25,R26,R27,RV1,RV2,RV3,U1,U2,U3,U4,U5,U6,U7,U8,U9,U10,U11,U12,U13 | 118 | 1.5K,1000u,100n,105,10K,12V,13K,1K,1N5822,220u,24V Out,3.3K,3.3v,330u,33uH,47uH,560u,5V,60.4K,ADJ out,AO3401A,B540C,BZV55B10,Conn_02x05_Top_Bottom,Connector LIPO 1,Connector LIPO 2,Emergency Stop,INA219AxDCN,Jumper_2_Small_Bridged,LED,LIPO 1 VOLT,LIPO 2 VOLT,LM2596T-3.3,Master Switch,RL2512JK-070R1L,R_Potentiometer,Screw_Terminal_01x06,XL4015 |  |  |  | http://www.aosmd.com/pdfs/datasheet/AO3401A.pdf,http://www.ti.com/lit/ds/symlink/ina219.pdf,http://www.ti.com/lit/ds/symlink/lm2596.pdf,http://www.vishay.com/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
