EUROBOT-27/MECANIQUE/resources/INSATEURO2026/Electrique/PCB Version AKRIVEIA/Actionneur/Actionneur.csv

Reference | Qty | Value | DNP | Exclude from BOM | Exclude from Board | Footprint | Datasheet
A1 | 1 | ESP32_DevKit_V1_DOIT_30GPIOs |  |  |  | PCM_SL_Development_Boards:DOIT_ESP32_DEVKIT_30Pins
A2 | 1 | Pololu_Breakout_DRV8825 |  |  |  | Module:Pololu_Breakout-16_15.2x20.3mm | https://www.pololu.com/product/2982
C1 | 1 | 220u |  |  |  | Capacitor_SMD:CP_Elec_10x10.5 | ~
C29 | 1 | 105 |  |  |  | Capacitor_SMD:C_0603_1608Metric | ~
D1,D7,D8,D9 | 4 | LED |  |  |  | LED_SMD:LED_0603_1608Metric | ~
D4 | 1 | 1N5819M |  |  |  | Diode_SMD:D_SMC | https://media.digikey.com/pdf/Data%20Sheets/Diodes%20PDFs/1N5817M,5818M,5819M.pdf
J1 | 1 | 12V input |  |  |  | TerminalBlock_Altech:Altech_AK100_1x02_P5.00mm | ~
J2,J8 | 2 | V4 |  |  |  | Connector_JST:JST_PH_B2B-PH-K_1x02_P2.00mm_Vertical | ~
J3 | 1 | 12V output |  |  |  | TerminalBlock_Altech:Altech_AK100_1x02_P5.00mm | ~
J4 | 1 | Conn_01x05 |  |  |  | Connector_JST:JST_EH_B5B-EH-A_1x05_P2.50mm_Vertical | ~
J5 | 1 | V1 |  |  |  | Connector_JST:JST_PH_B2B-PH-K_1x02_P2.00mm_Vertical | ~
J6 | 1 | V2 |  |  |  | Connector_JST:JST_PH_B2B-PH-K_1x02_P2.00mm_Vertical | ~
J7 | 1 | V3 |  |  |  | Connector_JST:JST_PH_B2B-PH-K_1x02_P2.00mm_Vertical | ~
J9 | 1 | 5V output |  |  |  | TerminalBlock_Altech:Altech_AK100_1x02_P5.00mm | ~
J11 | 1 | 5V input |  |  |  | TerminalBlock_Altech:Altech_AK100_1x02_P5.00mm | ~
J12 | 1 | Switch ESP32 |  |  |  | Connector_PinHeader_1.00mm:PinHeader_1x02_P1.00mm_Vertical | ~
J13 | 1 | Stepper connector |  |  |  | Connector_JST:JST_EH_B4B-EH-A_1x04_P2.50mm_Vertical | ~
J25 | 1 | Conn_01x03 |  |  |  | Connector_JST:JST_EH_B3B-EH-A_1x03_P2.50mm_Vertical | ~
J26 | 1 | Conn_01x04 |  |  |  | Connector_JST:JST_EH_B4B-EH-A_1x04_P2.50mm_Vertical | ~
J27 | 1 | XT60-M |  |  |  | XT60-M:AMASS_XT60-M
J28 | 1 | Switch |  |  |  | TerminalBlock_Phoenix:TerminalBlock_Phoenix_MKDS-1,5-2-5.08_1x02_P5.08mm_Horizontal | ~
J29 | 1 | Pump Lipo Voltage |  |  |  | Connector_JST:JST_PH_B2B-PH-K_1x02_P2.00mm_Vertical | ~
K1 | 1 | SANYOU_SRD_Form_C |  |  |  | Relay_THT:Relay_SPDT_SANYOU_SRD_Series_Form_C | http://www.sanyourelay.ca/public/products/pdf/SRD.pdf
OC1 | 1 | PC817 |  |  |  | PCM_Optocoupler_AKL:Vishay_CNY64 | https://www.tme.eu/Document/7534c9f89aa4b1eba4ec90182e378328/PC817_2_3_47.pdf
Q2 | 1 | 2N2222A |  |  |  | PCM_Package_TO_SOT_THT_AKL:TO-18-3_EBC | https://www.st.com/resource/en/datasheet/cd00003223.pdf
R1,R9,R10,R11 | 4 | 3.3K |  |  |  | Resistor_SMD:R_0603_1608Metric | ~
R3 | 1 | 220 |  |  |  | Resistor_SMD:R_0603_1608Metric | ~
R5 | 1 | 1k |  |  |  | Resistor_SMD:R_0603_1608Metric | ~
R6 | 1 | 100K |  |  |  | Resistor_SMD:R_0603_1608Metric | ~
R7 | 1 | 10k |  |  |  | Resistor_THT:R_Axial_DIN0204_L3.6mm_D1.6mm_P7.62mm_Horizontal | ~
SW1 | 1 | SW_DIP_x03 |  |  |  | Button_Switch_THT:SW_DIP_SPSTx03_Slide_9.78x9.8mm_W7.62mm_P2.54mm | ~
U1 | 1 | ULN2003A |  |  |  | Package_DIP:DIP-16_W7.62mm | http://www.ti.com/lit/ds/symlink/uln2003a.pdf
