EUROBOT-27/MECANIQUE/mechanical/clapets-v8/CAD_FC/STL/printed_parts.txt

A_SOCLE  (module A)
A_PLATINE_MOTEUR  (module A)
A_TRAVERSE_HAUT  (module A)
A_SUPPORT_ECROU  (module A)
A_AILE_D  (module A)
A_AILE_G  (module A)
A_BRAS_PORTE_D_BAS  (module A)
A_BRAS_PORTE_D_HAUT  (module A)
A_BRAS_PORTE_G_BAS  (module A)
A_BRAS_PORTE_G_HAUT  (module A)
A_ROUE_PORTE_28T  (module A)
A_PIGNON_PORTE_20T  (module A)
A_CAPOT_AILE_D  (module A)
A_CAPOT_AILE_G  (module A)
A_ENTRETOISE_608_BAS  (module A)
A_ENTRETOISE_608_HAUT  (module A)
B_ENTRETOISE_TETE  (module B)
B_CHARIOT_TETE  (module B)
B_BASE_TETE_D  (module B)
B_BASE_TETE_G  (module B)
B_MANIVELLE_FRAPPE  (module B)
B_MOYEU_TETE_30T  (module B)
B_PIGNON_TETE_20T  (module B)
B_STATION_TPU  (module B)  TPU 95A
B_BAGUE_STATION  (module B)
