EUROBOT-27/MECANIQUE/resources/INSATEURO2026/HARDWARE-CAD/GreenBox/GreenBox.SLDASM

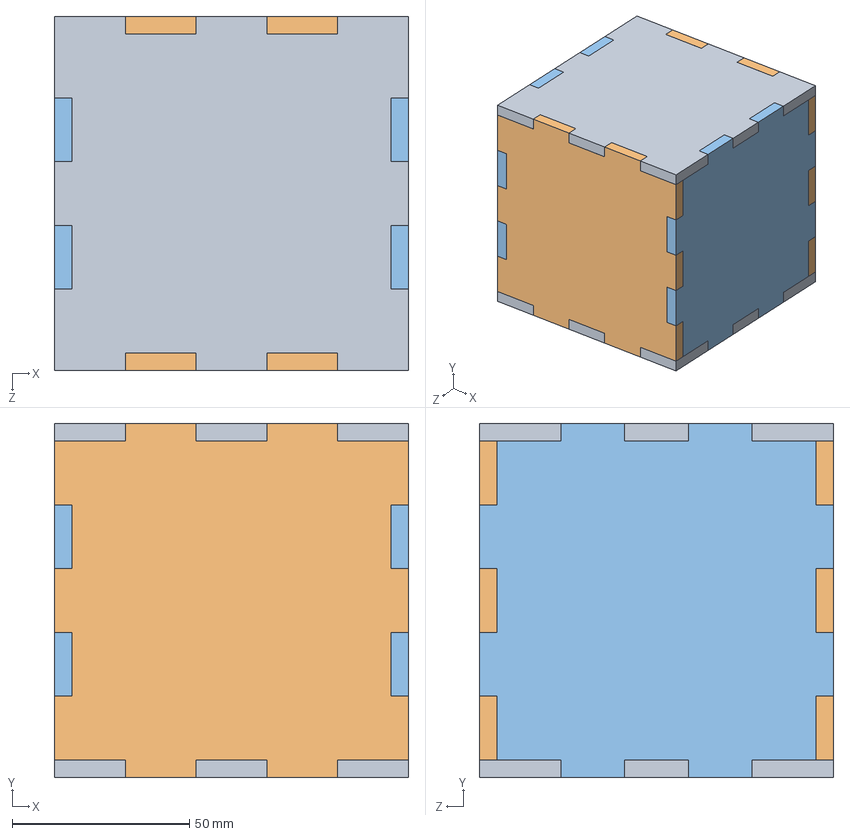
[picture p103: CAD file, 2026-11-01]
resources/INSATEURO2026/HARDWARE-CAD/GreenBox/GreenBox.SLDASM
100.0 x 100.0 x 100.0 mm
GreenBoxUP x 2
GREENboxSide x 2
GreenBoxFront x 2
