EUROBOT-27/MECANIQUE/resources/INSATEURO2026/HARDWARE-CAD/SupportCamTot.SLDASM

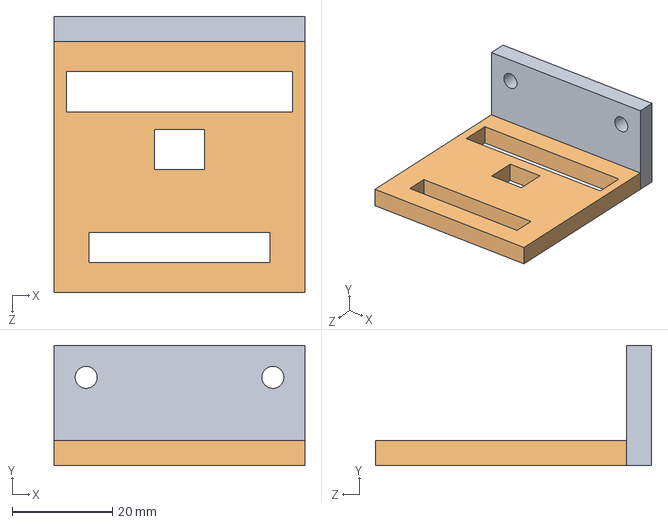
[picture p104: CAD file, 2026-11-01]
resources/INSATEURO2026/HARDWARE-CAD/SupportCamTot.SLDASM
50.0 x 24.0 x 55.0 mm
LifeCam base
CamSupportBack
