EUROBOT-27/MECANIQUE/resources/INSATEURO2026/HARDWARE-CAD/VisEcrou+PushingMech/Assemblage_VE+PM.SLDASM

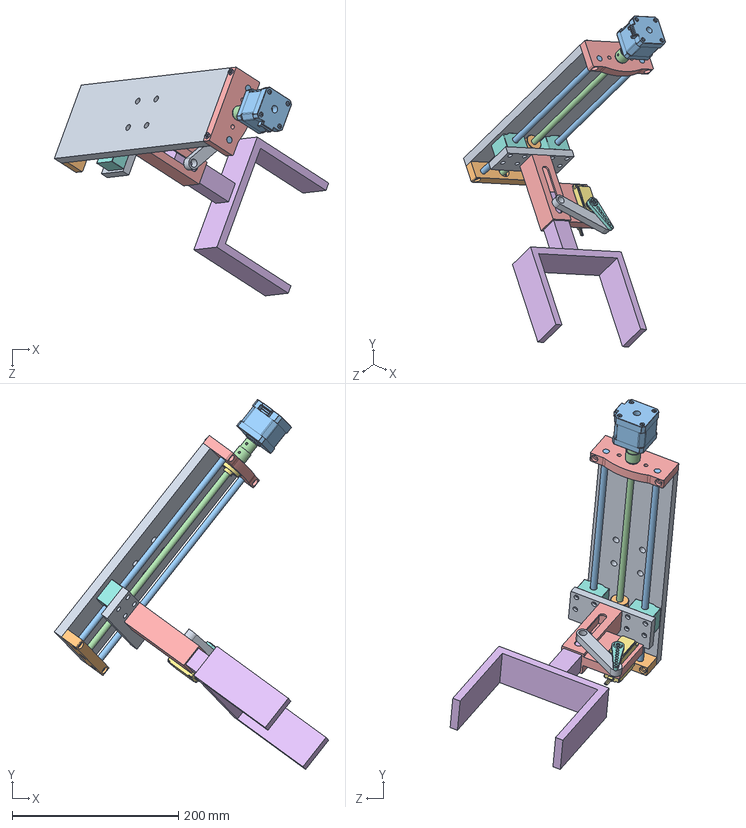
[picture p105: CAD file, 2026-11-01]
resources/INSATEURO2026/HARDWARE-CAD/VisEcrou+PushingMech/Assemblage_VE+PM.SLDASM
330.4 x 445.4 x 275.4 mm
X-Achse-Grundplatte
Z-Achse-Lagerbock
Linearwelle 8mm-Z-Achse x 2
Trapezgewindespindel 8mm
Z-Achse-Motorhalterung
Hex Thin Nut Chamfered GradeAB_DIN x 2
Flanschlager KFL08
Linearlager8mm x 2
Extruderhalterung
Trapezgewindemutter
Nima 17 40x42x5mm
Accouplement
Composant_A_Rainure
Glissante
Servo TD8320MG-TD8325MG
DS51_Gear_Horn
poussoir
