EUROBOT-27/MECANIQUE/resources/CDR-2027/MCAD/electronical-parts/MainBoardSupport.FCStd

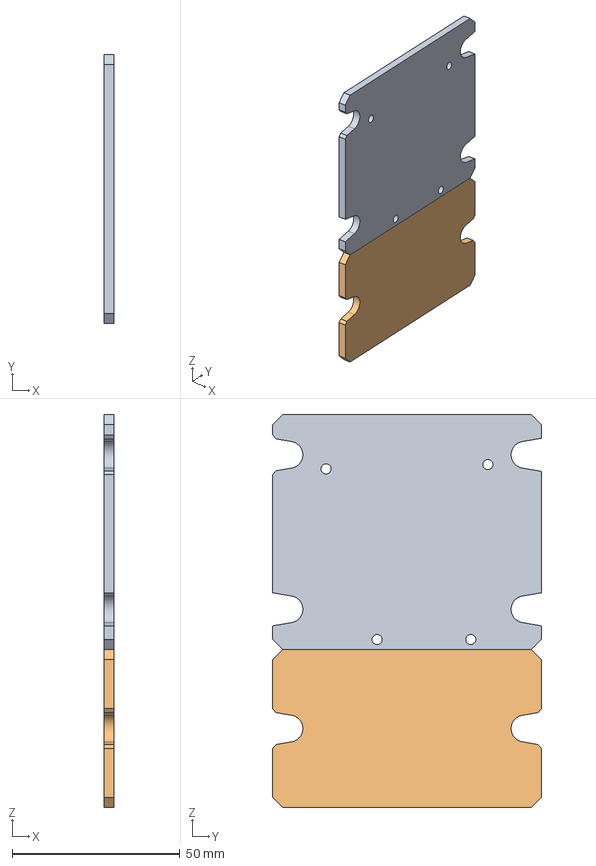
[picture p106: CAD file, 2026-11-01]
resources/CDR-2027/MCAD/electronical-parts/MainBoardSupport.FCStd
3.00 x 80.0 x 117.0 mm
CarterElecESP32-UNO
ProlongationCarterUno
