EUROBOT-27/MECANIQUE/resources/INSATEURO2026/HARDWARE-CAD/GrennTriangle/GreenTriangle.SLDASM

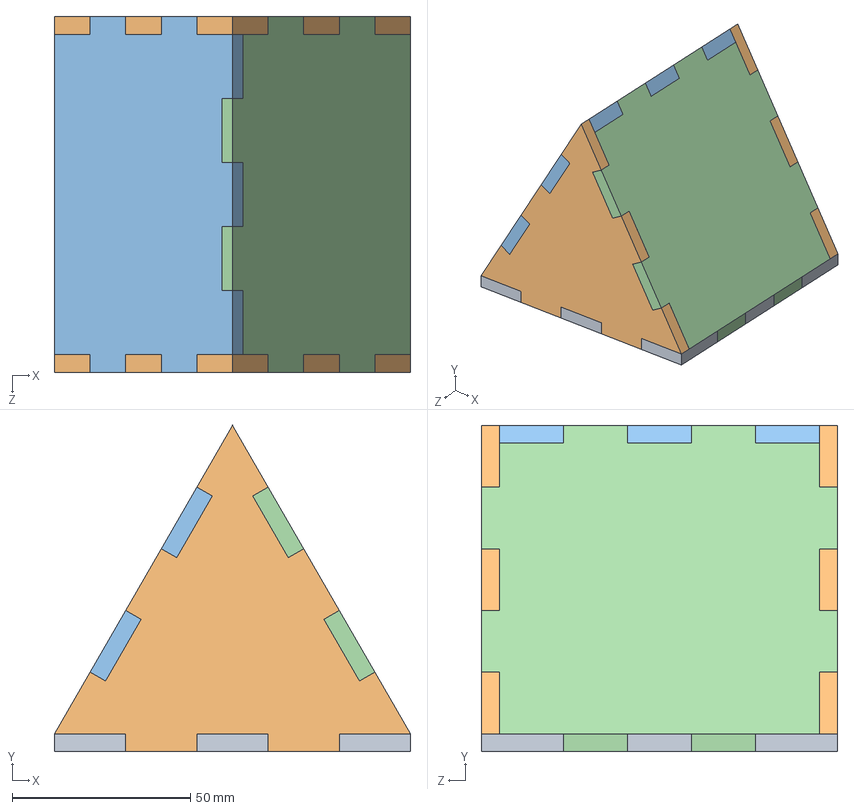
[picture p107: CAD file, 2026-11-01]
resources/INSATEURO2026/HARDWARE-CAD/GrennTriangle/GreenTriangle.SLDASM
100.0 x 91.6 x 100.0 mm
BASE
TriSide x 2
RecSide
RecSide - Copie
