EUROBOT-27/MECANIQUE/resources/INSATEURO2026/HARDWARE-CAD/PushingMechanism/AssemblageTotal.SLDASM

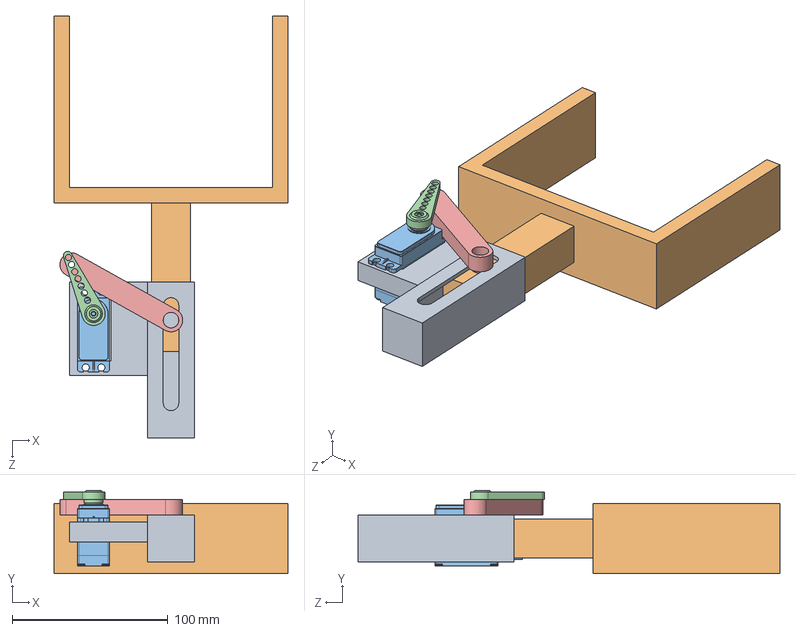
[picture p108: CAD file, 2026-11-01]
resources/INSATEURO2026/HARDWARE-CAD/PushingMechanism/AssemblageTotal.SLDASM
150.0 x 53.5 x 270.6 mm
Composant_A_Rainure
Glissante
Servo TD8320MG-TD8325MG
DS51_Gear_Horn
poussoir
