EUROBOT-27/MECANIQUE/resources/INSATEURO2026/HARDWARE-CAD/RobotDXF/AssemblageDXF.DXF

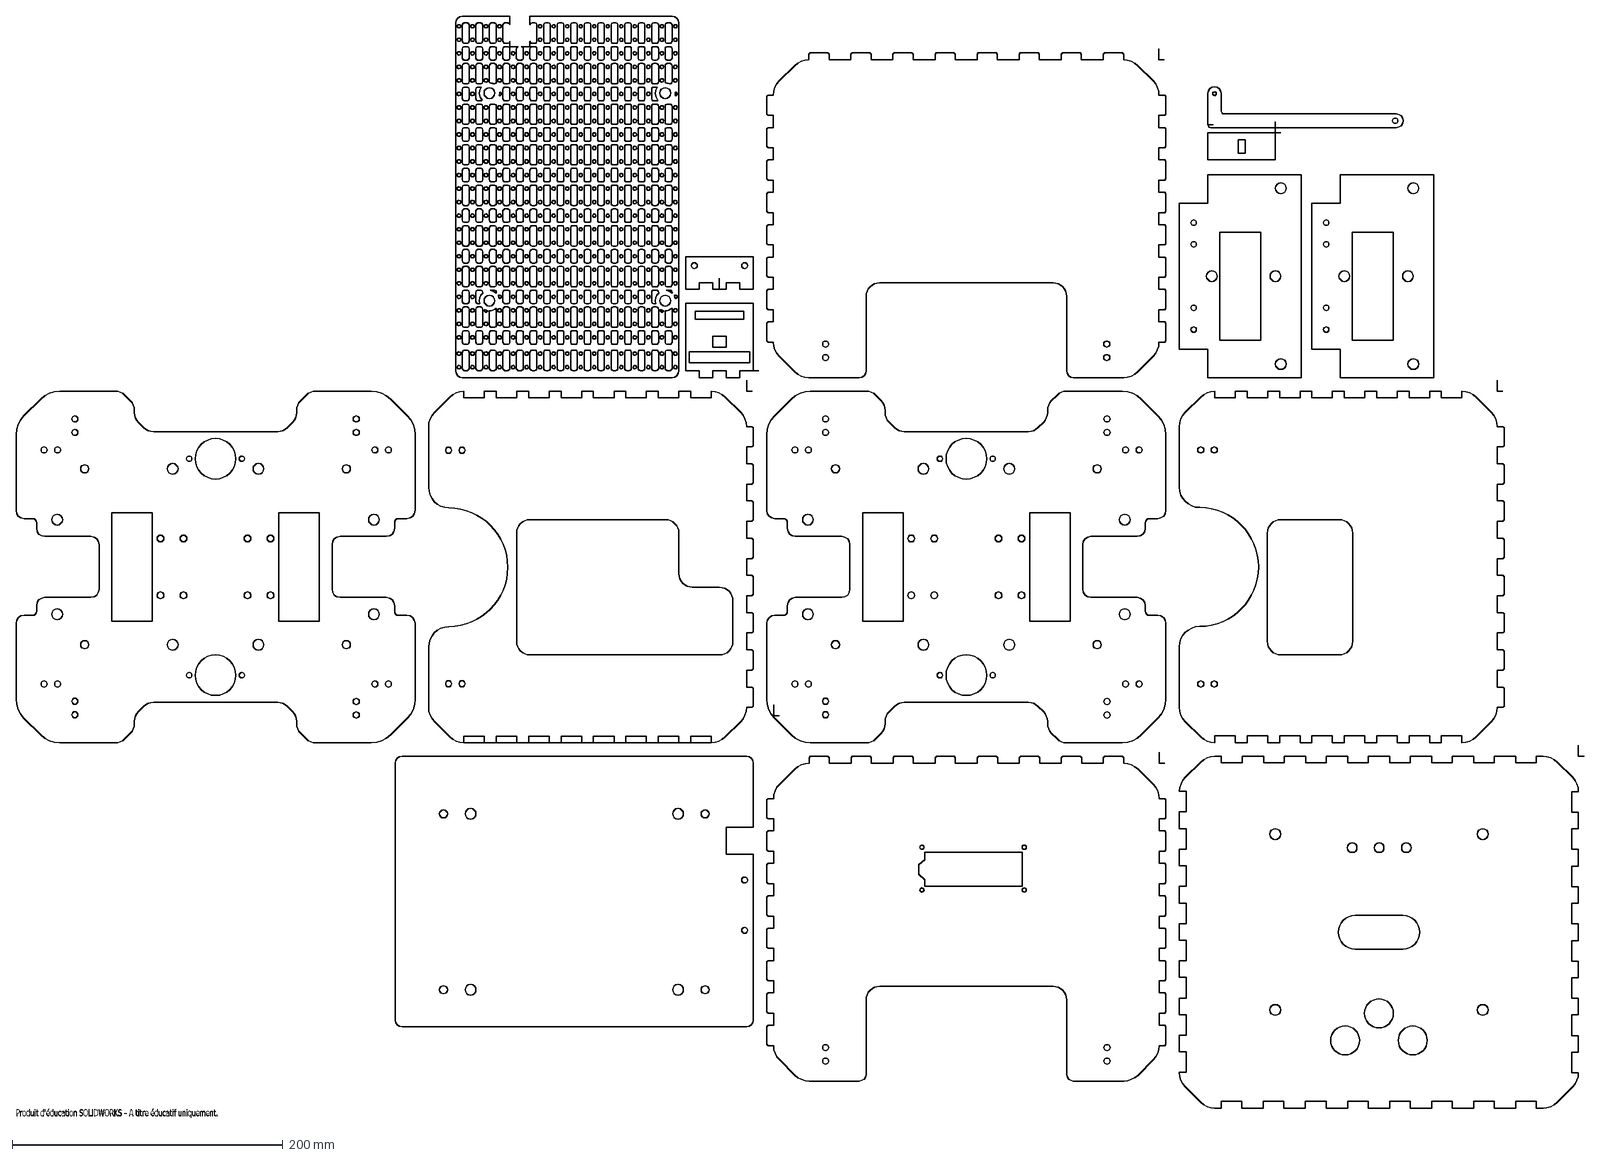
[picture p109: CAD file, 2026-11-01]
resources/INSATEURO2026/HARDWARE-CAD/RobotDXF/AssemblageDXF.DXF
Produit d'éducation SOLIDWORKS – A titre éducatif uniquement.
