EUROBOT-27/MECANIQUE/resources/INSATEURO2026/HARDWARE-CAD/RobotDXF/Assemblage1.SLDASM

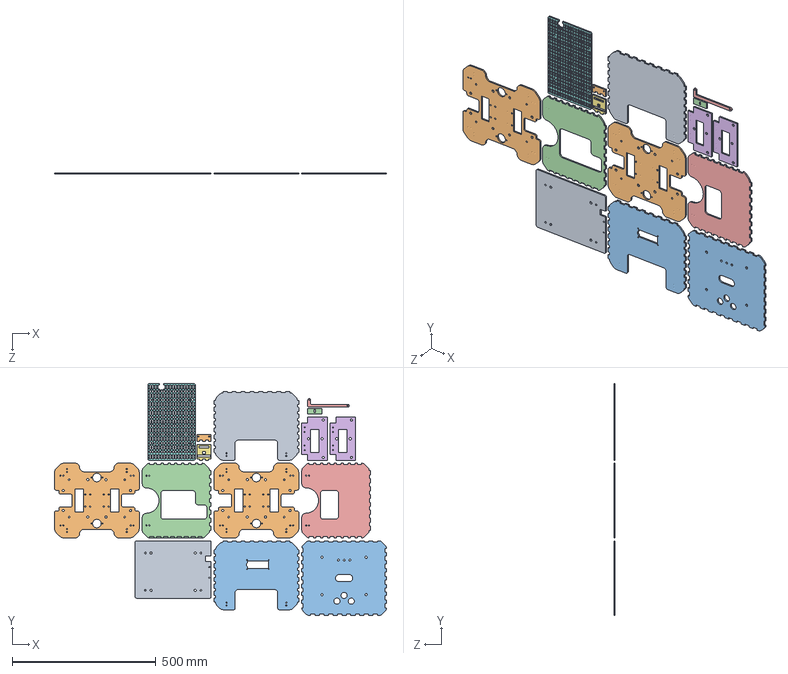
[picture p110: CAD file, 2026-11-01]
resources/INSATEURO2026/HARDWARE-CAD/RobotDXF/Assemblage1.SLDASM
1155.0 x 807.2 x 5.00 mm
Back2
Base x 2
Front2
leftSide2
RightSide2
Support Moteur- Left x 2
CamSupportBack
etage 3
etage1
LifeCam base
UpperRobotSide
TetePendule
Pendule
