EUROBOT-27/MECANIQUE/resources/INSATEURO2026/HARDWARE-CAD/32gpt-3stage_standard+KSx+KRx.sldasm-Part-4.SLDPRT

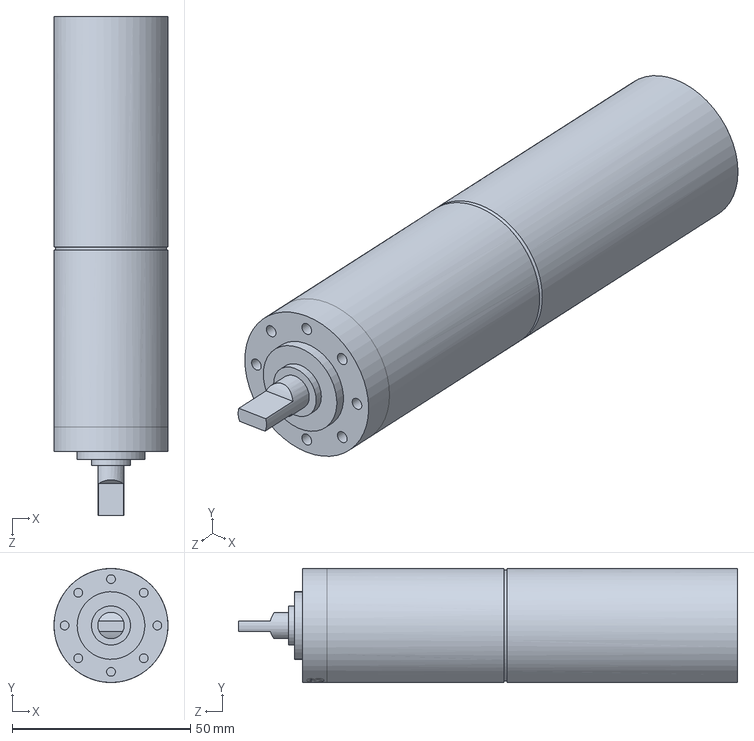
[picture p111: CAD file, 2026-11-01]
resources/INSATEURO2026/HARDWARE-CAD/32gpt-3stage_standard+KSx+KRx.sldasm-Part-4.SLDPRT
32.0 x 32.0 x 140.2 mm
