EUROBOT-27/MECANIQUE/resources/INSATEURO2026/HARDWARE-CAD/AssemblageOuterBoxTest.SLDASM

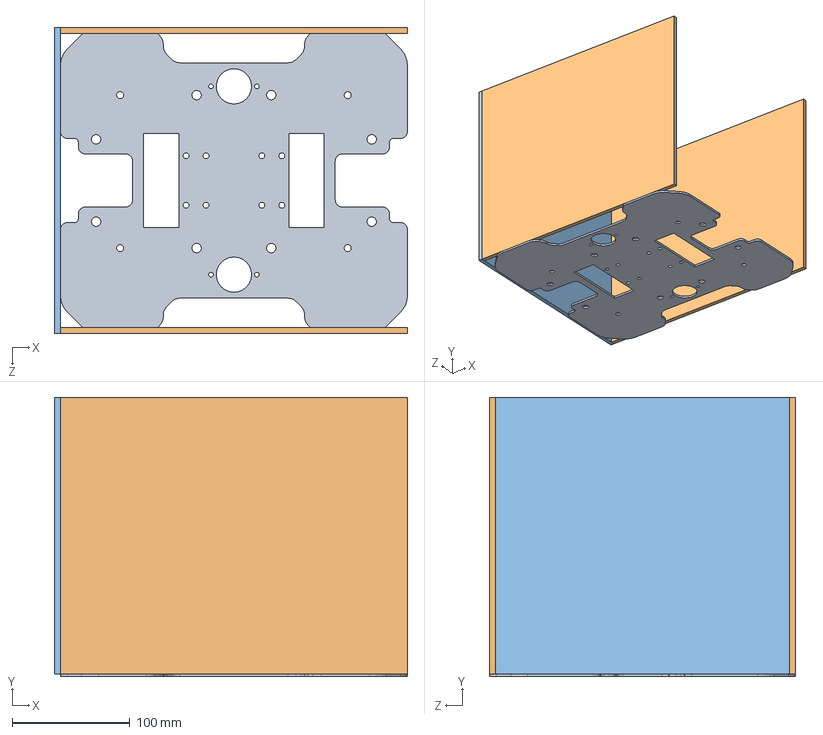
[picture p112: CAD file, 2026-11-01]
resources/INSATEURO2026/HARDWARE-CAD/AssemblageOuterBoxTest.SLDASM
300.0 x 237.5 x 260.0 mm
Base
FrontRobotFace x 2
RobotSide
