EUROBOT-27/MECANIQUE/resources/INSATEURO2026/HARDWARE-CAD/Assemblage3TestOuterBox.SLDASM

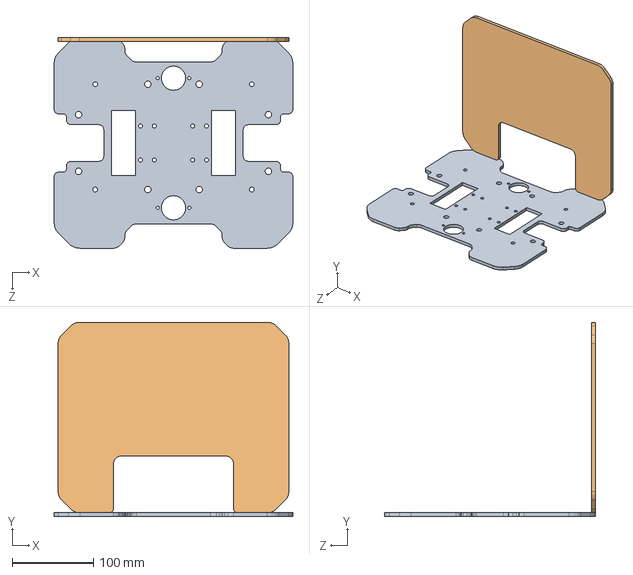
[picture p113: CAD file, 2026-11-01]
resources/INSATEURO2026/HARDWARE-CAD/Assemblage3TestOuterBox.SLDASM
295.0 x 240.0 x 260.0 mm
Base
Back2
