EUROBOT-27/MECANIQUE/resources/Aero Euro/LIDAR_EUROBOT/src/robot_description/meshes/wheel2.STL

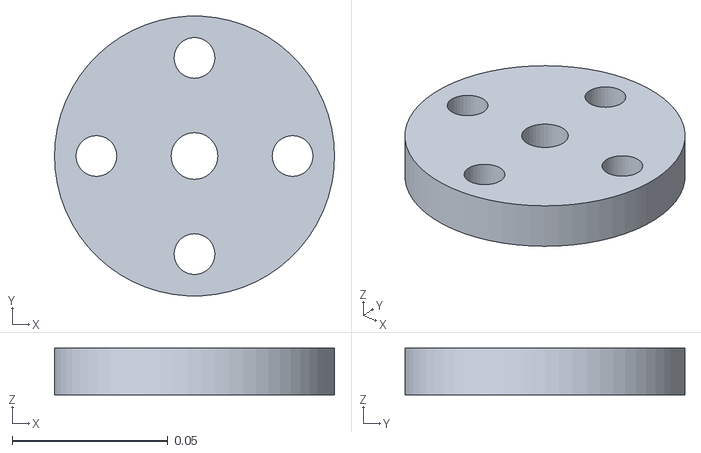
[picture p114: CAD file, 2026-11-01]
resources/Aero Euro/LIDAR_EUROBOT/src/robot_description/meshes/wheel2.STL
0.09 x 0.0899 x 0.015
