EUROBOT-27/MECANIQUE/resources/Aero Euro/LIDAR_EUROBOT/src/torbag/meshes/base_link.STL

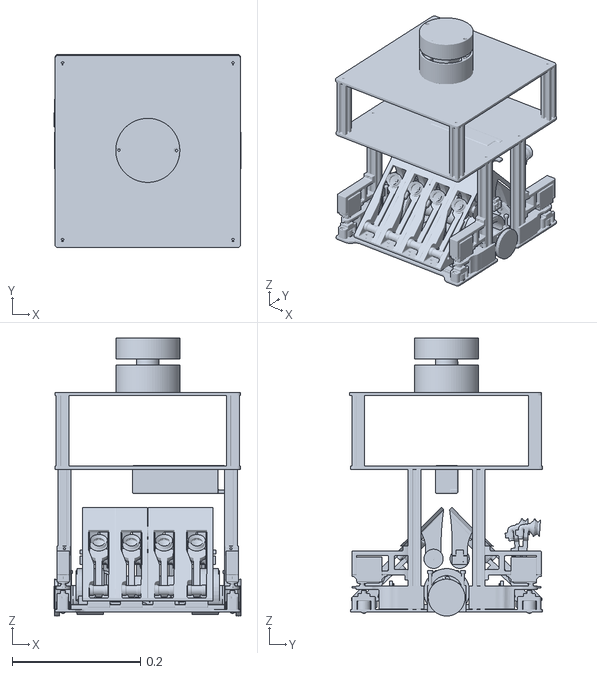
[picture p115: CAD file, 2026-11-01]
resources/Aero Euro/LIDAR_EUROBOT/src/torbag/meshes/base_link.STL
0.292 x 0.302 x 0.434
