EUROBOT-27/MECANIQUE/resources/Aero Euro/NINJA_MECANIQUE/NEMA17 braket.SLDPRT

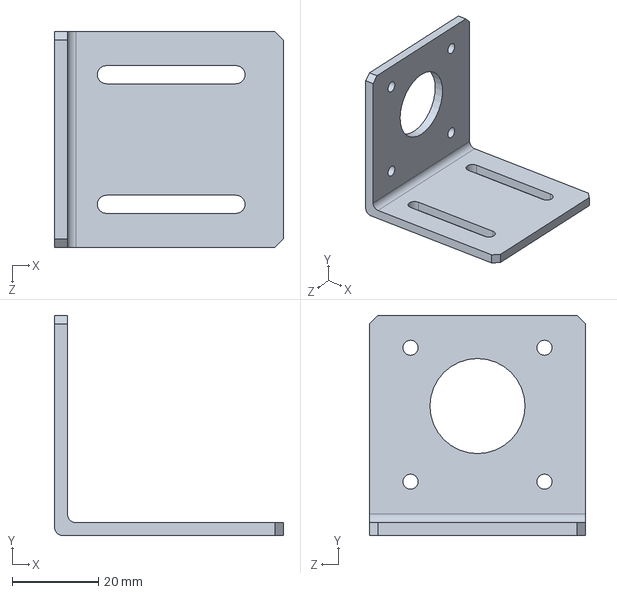
[picture p116: CAD file, 2026-11-01]
resources/Aero Euro/NINJA_MECANIQUE/NEMA17 braket.SLDPRT
53.0 x 51.0 x 50.0 mm
