EUROBOT-27/MECANIQUE/resources/Aero Euro/PCBs/carte distribution/carte distribution.step

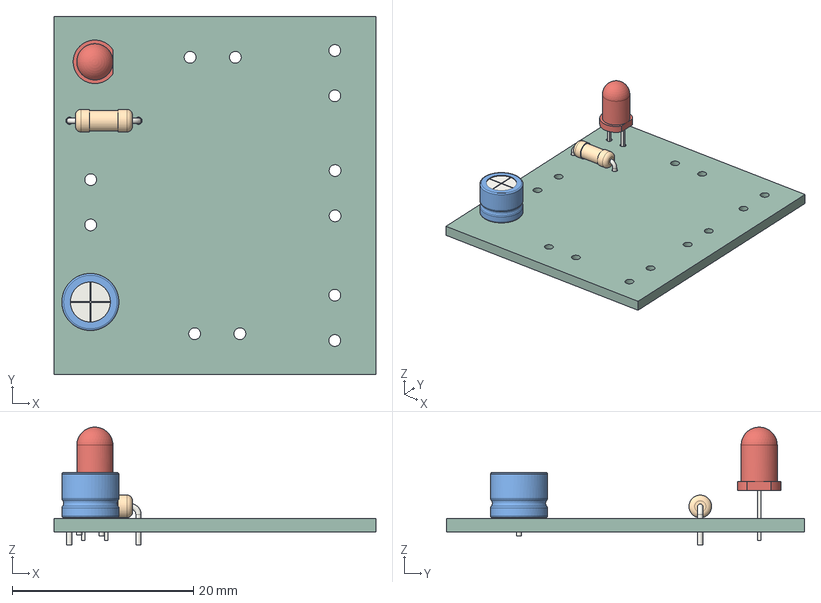
[picture p117: CAD file, 2026-11-01]
resources/Aero Euro/PCBs/carte distribution/carte distribution.step
35.5 x 39.5 x 13.0 mm
LED_D4.0mm
R_Axial_DIN0207_L6.3mm_D2.5mm_P7.62mm_Horizontal
C_Radial_D6.3mm_H5.0mm_P2.50mm
carte distribution_PCB
