EUROBOT-27/MECANIQUE/resources/Aero Euro/PCBs/ESP motors - 2.0/ESP motors 2.0.step

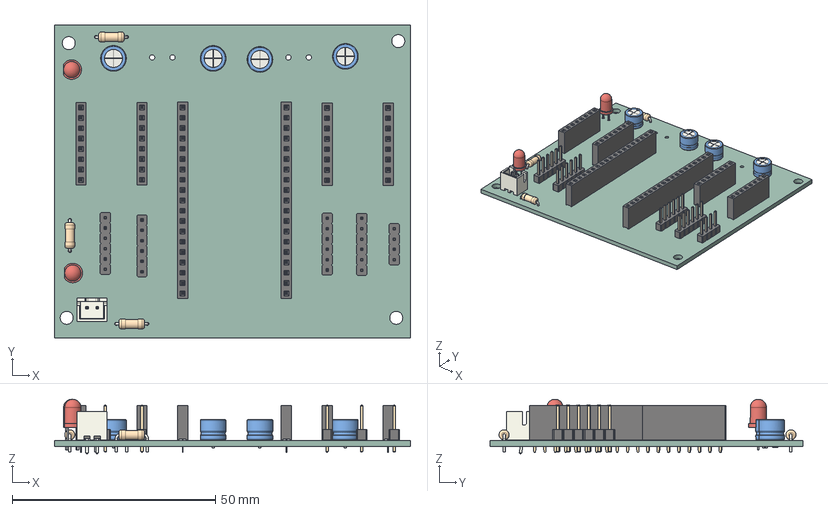
[picture p118: CAD file, 2026-11-01]
resources/Aero Euro/PCBs/ESP motors - 2.0/ESP motors 2.0.step
87.5 x 77.0 x 13.4 mm
C_Radial_D6.3mm_H5.0mm_P2.50mm x 4
LED_D4.0mm x 2
R_Axial_DIN0207_L6.3mm_D2.5mm_P7.62mm_Horizontal x 3
PinHeader_1x06_P2.54mm_Vertical x 4
JST_XH_B2B-XH-A_1x02_P2.50mm_Vertical
PinSocket_1x08_P2.54mm_Vertical x 4
PinSocket_1x19_P2.54mm_Vertical x 2
PinHeader_1x04_P2.54mm_Vertical
ESP motors 2.0_PCB
