EUROBOT-27/MECANIQUE/resources/Aero Euro/PCBs/Pami_ESP32/Pami_ESP32.step

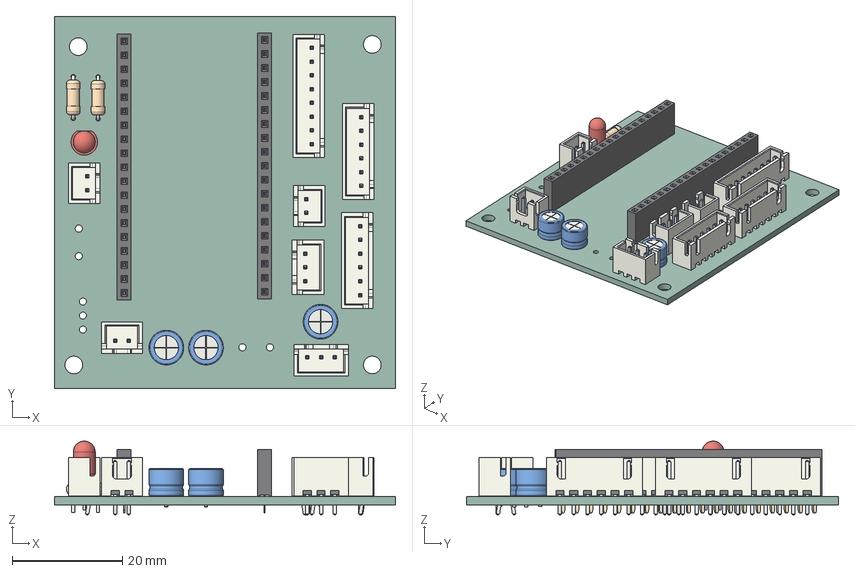
[picture p119: CAD file, 2026-11-01]
resources/Aero Euro/PCBs/Pami_ESP32/Pami_ESP32.step
62.0 x 67.6 x 13.4 mm
JST_XH_B6B-XH-A_1x06_P2.50mm_Vertical x 2
C_Radial_D6.3mm_H5.0mm_P2.50mm x 3
PinSocket_1x19_P2.54mm_Vertical x 2
JST_XH_B2B-XH-A_1x02_P2.50mm_Vertical x 3
JST_XH_B3B-XH-A_1x03_P2.50mm_Vertical x 2
R_Axial_DIN0207_L6.3mm_D2.5mm_P7.62mm_Horizontal x 2
LED_D4.0mm
JST_XH_B8B-XH-A_1x08_P2.50mm_Vertical
Pami_ESP32_PCB
