EUROBOT-27/MECANIQUE/resources/CDR-2027/MCAD/3d-print/box-manipulator-arm-manipulatorarm.3mf

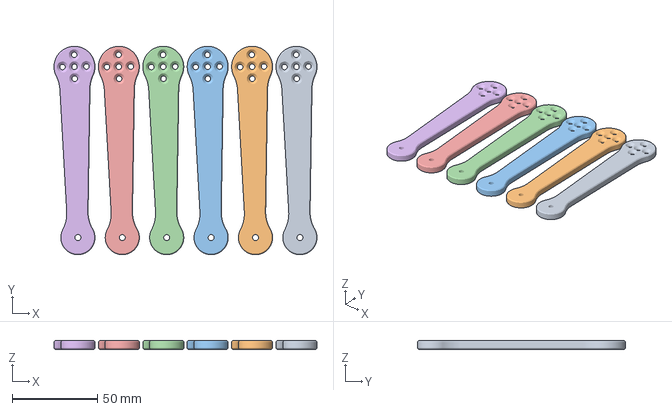
[picture p120: CAD file, 2026-11-01]
resources/CDR-2027/MCAD/3d-print/box-manipulator-arm-manipulatorarm.3mf
154.0 x 122.0 x 5.00 mm
arm x 6
