EUROBOT-27/MECANIQUE/resources/CDR-2027/MCAD/actuator-parts/ball-launcher.FCStd

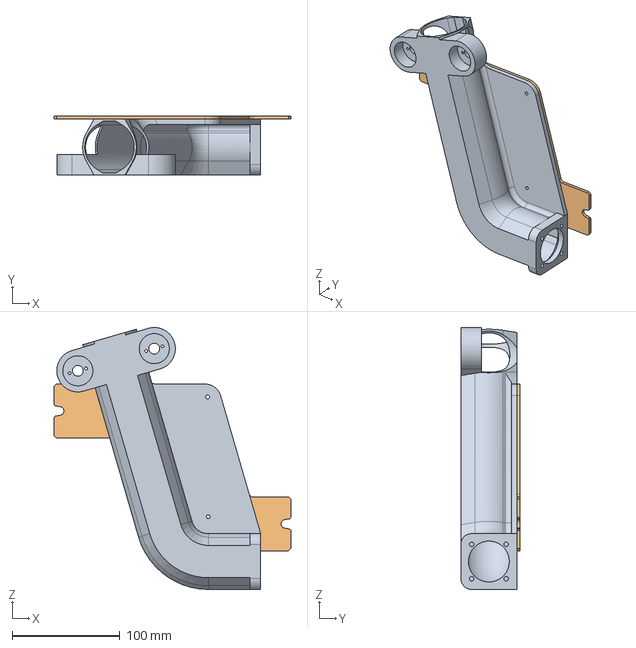
[picture p121: CAD file, 2026-11-01]
resources/CDR-2027/MCAD/actuator-parts/ball-launcher.FCStd
220.0 x 55.0 x 243.6 mm
Canon6Balles
PlaqueSupport
