EUROBOT-27/MECANIQUE/resources/CDR-2027/MCAD/differential-structure.FCStd

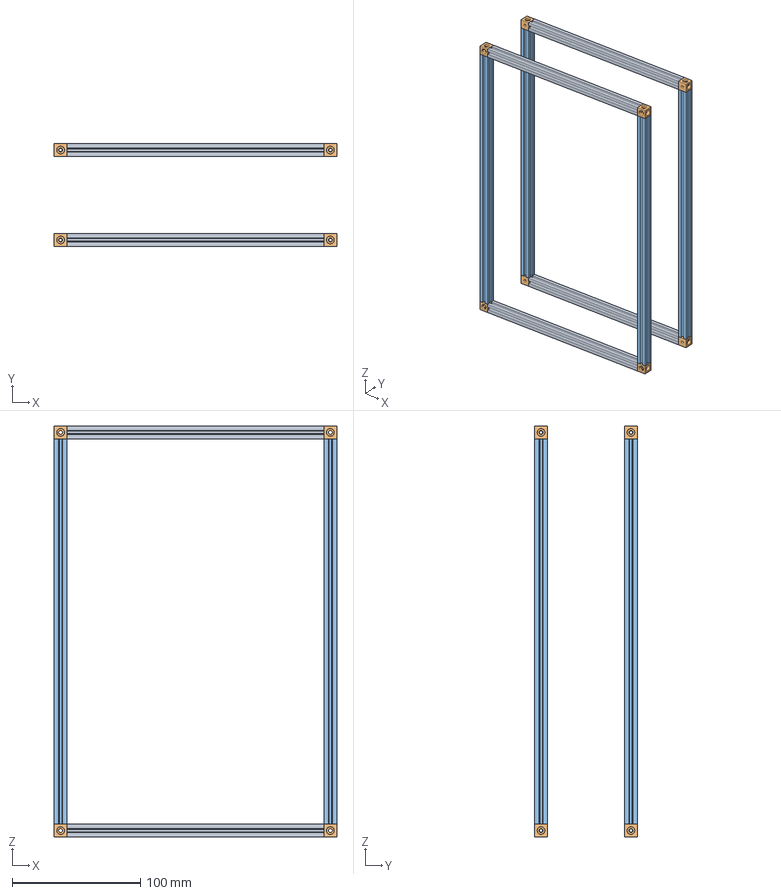
[picture p122: CAD file, 2026-11-01]
resources/CDR-2027/MCAD/differential-structure.FCStd
220.0 x 80.0 x 320.0 mm
MB_200 x 4
Corner x 8
MB_300 x 4
