EUROBOT-27/MECANIQUE/resources/CDR-2027/MCAD/electronical-parts/SupportBatterie.FCStd

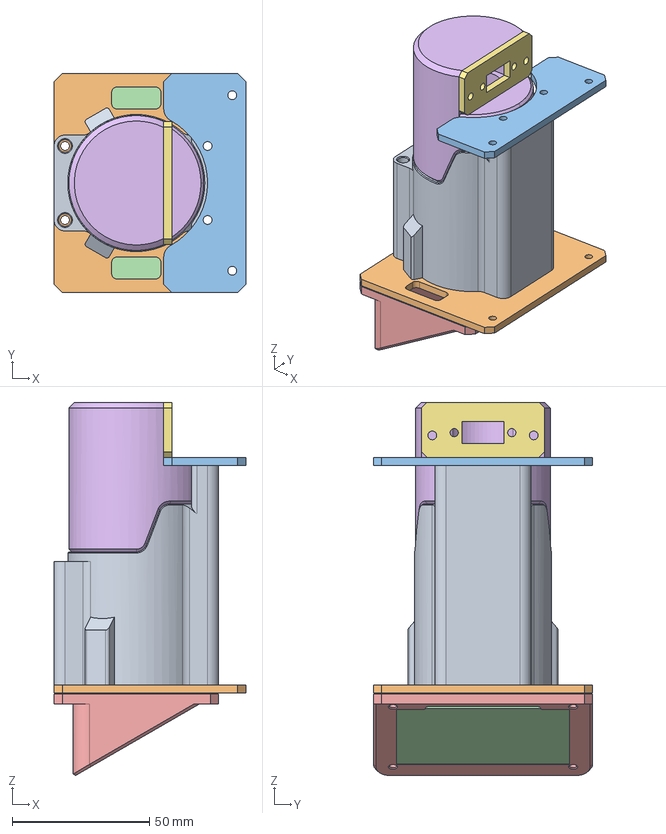
[picture p123: CAD file, 2026-11-01]
resources/CDR-2027/MCAD/electronical-parts/SupportBatterie.FCStd
70.0 x 80.0 x 136.1 mm
battery-support
battery-plate
battery-plate001
EcranOled
SupportEcranOled
DummyBattery-Core
PlateXT60
