EUROBOT-27/MECANIQUE/resources/CDR-2027/MCAD/mechanical-parts/MF83.step

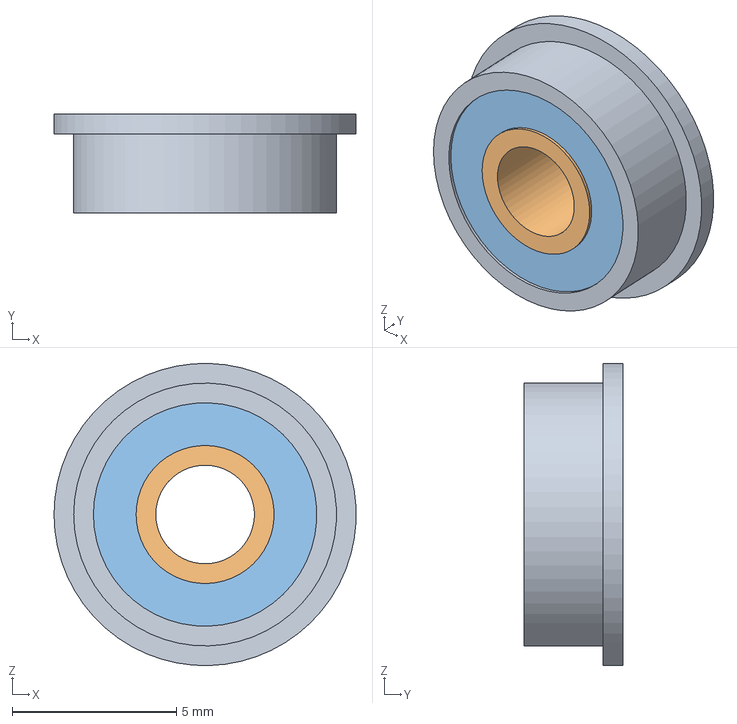
[picture p124: CAD file, 2026-11-01]
resources/CDR-2027/MCAD/mechanical-parts/MF83.step
9.19 x 3.00 x 9.20 mm
CoreMF83
SleeveMF83
