EUROBOT-27/MECANIQUE/resources/INSATEURO2026/Electrique/Carte Finale JLCPCB/.Robot Principalold/Robot Principal.step

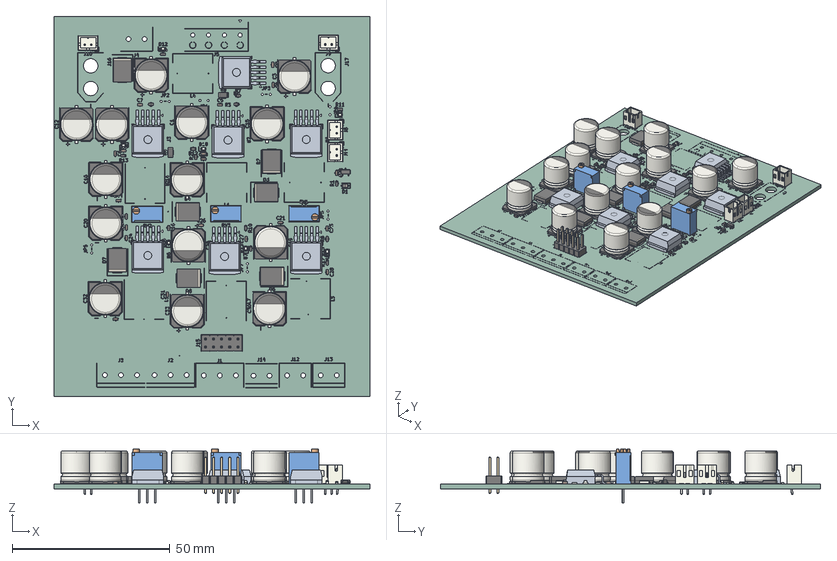
[picture p125: CAD file, 2026-11-01]
resources/INSATEURO2026/Electrique/Carte Finale JLCPCB/.Robot Principalold/Robot Principal.step
100.0 x 120.4 x 17.1 mm
R_1206_3216Metric x 2
LED_0603_1608Metric x 7
R_0603_1608Metric x 15
Robot Principal 1.4.1 x 7
PinHeader_2x05_P2.54mm_Vertical
CP_Elec_10x10.5 x 14
D_SMC x 7
C_0603_1608Metric x 19
Potentiometer_Bourns_3296W_Vertical x 3
SOT-23
D_SOD-323
JST_PH_B2B-PH-K_1x02_P2.00mm_Vertical x 4
Robot Principal_silkscreen
Robot Principal_PCB
