EUROBOT-27/MECANIQUE/resources/INSATEURO2026/Electrique/Carte Finale JLCPCB/Robot Principal/Actionneur/Puissance.step

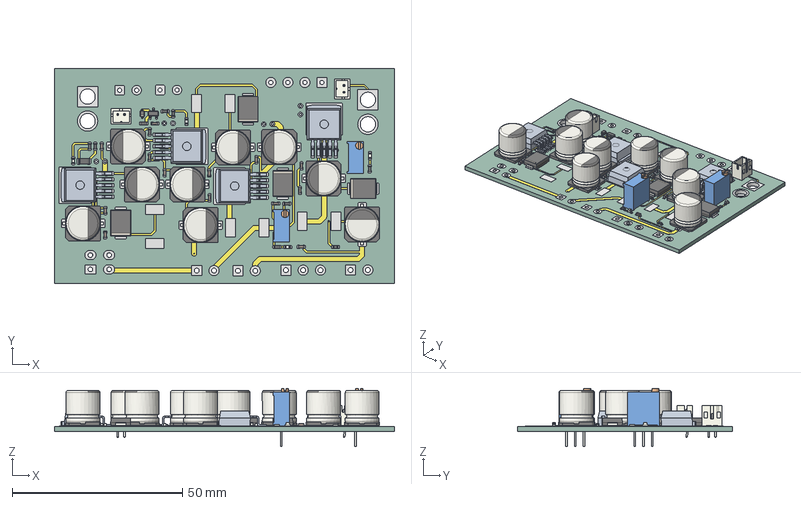
[picture p126: CAD file, 2026-11-01]
resources/INSATEURO2026/Electrique/Carte Finale JLCPCB/Robot Principal/Actionneur/Puissance.step
99.9 x 63.1 x 17.1 mm
Puissance 1.1.1 x 4
JST_PH_B2B-PH-K_1x02_P2.00mm_Vertical x 2
CP_Elec_10x10.5 x 9
D_SMC x 4
LED_0603_1608Metric x 4
R_0603_1608Metric x 10
C_0603_1608Metric x 13
D_SOD-323
Potentiometer_Bourns_3296W_Vertical x 2
SOT-23
R_1206_3216Metric
Puissance_copper
Puissance_pad
Puissance_via
Puissance_PCB
