EUROBOT-27/MECANIQUE/resources/INSATEURO2026/Electrique/Carte Finale JLCPCB/V2/Actionneur/Actionneur.step

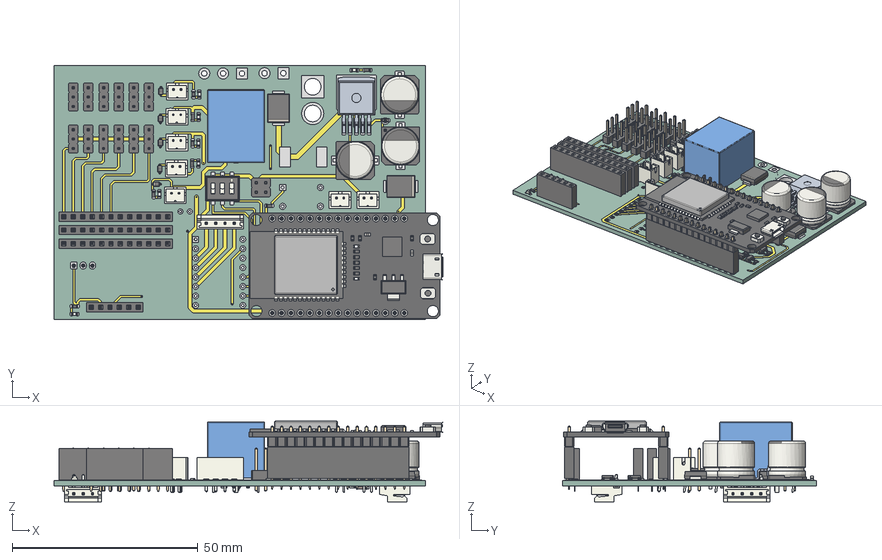
[picture p127: CAD file, 2026-11-01]
resources/INSATEURO2026/Electrique/Carte Finale JLCPCB/V2/Actionneur/Actionneur.step
104.7 x 68.5 x 21.7 mm
SOT-23 x 9
PinHeader_2x02_P2.54mm_Vertical
R_0603_1608Metric x 19
JST_PH_B2B-PH-K_1x02_P2.00mm_Vertical x 7
D_SMC x 2
JST_EH_B4B-EH-A_1x04_P2.50mm_Vertical
PinHeader_1x03_P2.54mm_Vertical x 12
D_SOD-323 x 5
LED_0603_1608Metric x 7
CP_Elec_10x10.5 x 3
Relay_SPDT_SANYOU_SRD_Series_Form_C
Actionneur 1.28.1
PinBodyLeft
PinsLeft
PinBodyRight
PinsLeftRight
PCB_Body
Pads001
PinSocketPinsLeft
PiSocketBodyLeft
PinSocketPinsRight
PiSocketBodyRight
USB
IC_USB
ESP033
AMS1118
LED
Resistors
PushButtons
PinSocket_1x12_P2.54mm_Vertical x 3
SW_DIP_SPSTx03_Slide_6.7x9.18mm_W6.73mm_P2.54mm_LowProfile_JPin
PinSocket_1x06_P2.54mm_Vertical
C_0603_1608Metric x 3
JST_EH_S4B-EH_1x04_P2.50mm_Horizontal
JST_EH_S3B-EH_1x03_P2.50mm_Horizontal
R_1206_3216Metric x 2
Actionneur_copper
Actionneur_pad
Actionneur_via
Actionneur_PCB
