EUROBOT-27/MECANIQUE/resources/INSATEURO2026/Electrique/PAMIS/PAMI Stepper/PAMI Stepper.step

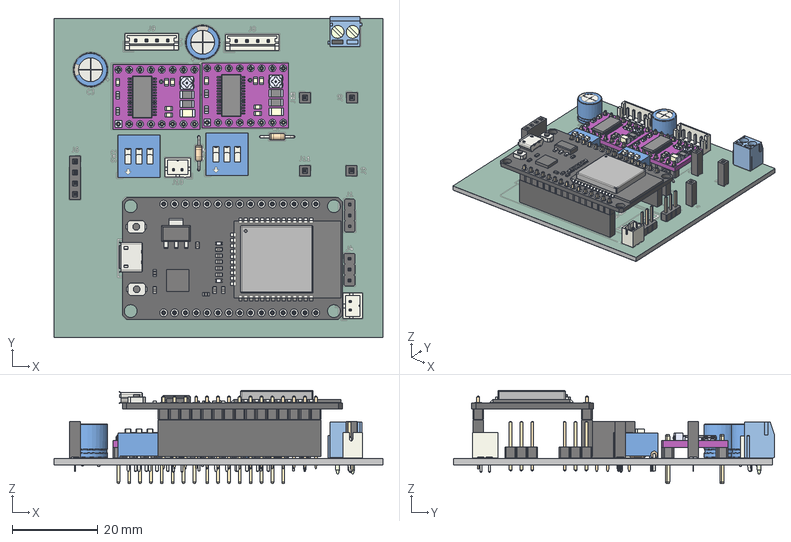
[picture p128: CAD file, 2026-11-01]
resources/INSATEURO2026/Electrique/PAMIS/PAMI Stepper/PAMI Stepper.step
76.8 x 75.0 x 21.8 mm
PinSocket_1x04_P2.54mm_Vertical
PinSocket_1x01_P2.54mm_Vertical x 4
Screw_Terminal_3.5mm_2P_Blue
PinBodyLeft
PinsLeft
PinBodyRight
PinsLeftRight
PCB_Body
Pads001
PinSocketPinsLeft
PiSocketBodyLeft
PinSocketPinsRight
PiSocketBodyRight
USB
IC_USB
ESP033
AMS1118
LED
Resistors
PushButtons
PinHeader_1x03_P2.54mm_Vertical x 2
SW_DIP_SPSTx03_Slide_9.78x9.8mm_W7.62mm_P2.54mm x 2
JST_PH_B2B-PH-K_1x02_P2.00mm_Vertical x 2
R_Axial_DIN0204_L3.6mm_D1.6mm_P7.62mm_Horizontal x 2
JST_EH_B4B-EH-A_1x04_P2.50mm_Vertical x 2
CP_Radial_D8.0mm_P3.80mm x 2
DRV8825_STEPPER_MOTOR_DRIVER_CARRIER x 2
PAMI Stepper_silkscreen
PAMI Stepper_soldermask
PAMI Stepper_PCB
