EUROBOT-27/MECANIQUE/resources/INSATEURO2026/HARDWARE-CAD/GreenBox/DXFbox/GreenBoxFront.DXF

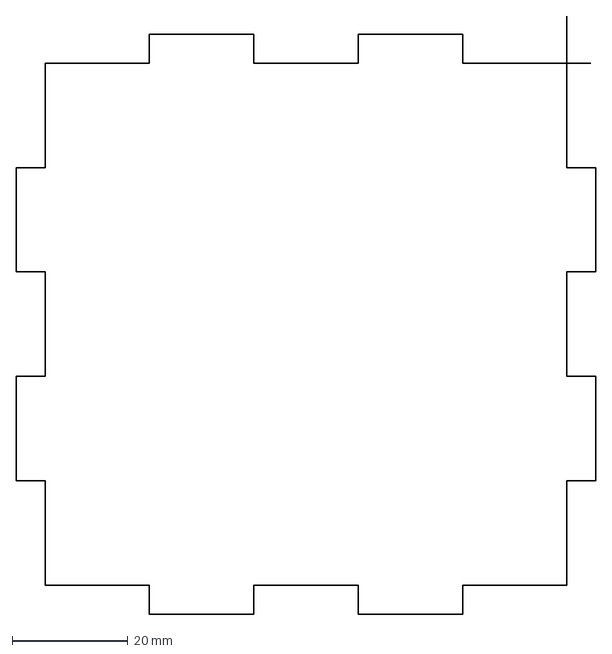
[picture p129: CAD file, 2026-11-01]
resources/INSATEURO2026/HARDWARE-CAD/GreenBox/DXFbox/GreenBoxFront.DXF
100.0 x 103.2 mm
