EUROBOT-27/MECANIQUE/resources/INSATEURO2026/HARDWARE-CAD/GrennTriangle/dxfTriangle/TriSide.DXF

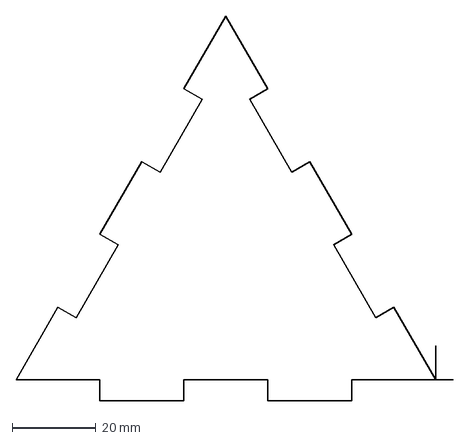
[picture p130: CAD file, 2026-11-01]
resources/INSATEURO2026/HARDWARE-CAD/GrennTriangle/dxfTriangle/TriSide.DXF
104.1 x 91.6 mm
