EUROBOT-27/MECANIQUE/resources/INSATEURO2026/HARDWARE-CAD/GrennTriangle/TriSide.SLDPRT

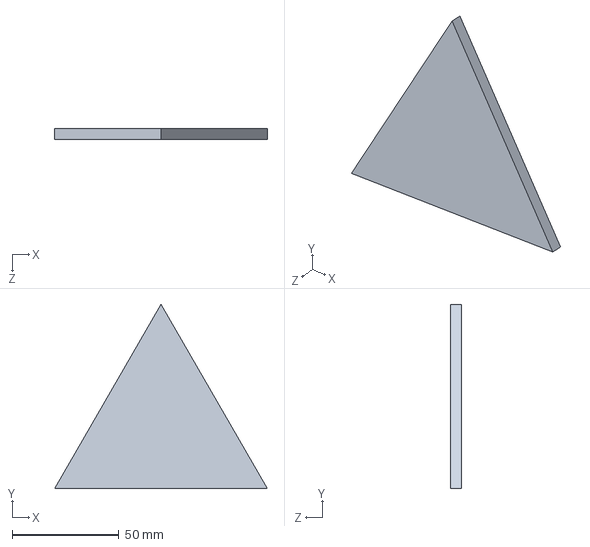
[picture p131: CAD file, 2026-11-01]
resources/INSATEURO2026/HARDWARE-CAD/GrennTriangle/TriSide.SLDPRT
100.0 x 86.6 x 5.00 mm
