EUROBOT-27/MECANIQUE/resources/INSATEURO2026/HARDWARE-CAD/PushingMechanism/Composant_A_Rainure.SLDPRT

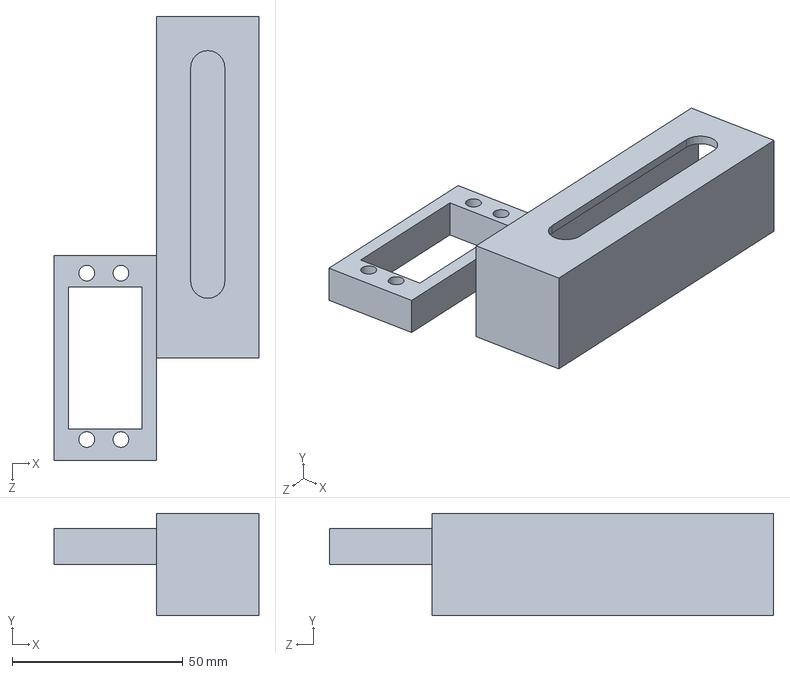
[picture p132: CAD file, 2026-11-01]
resources/INSATEURO2026/HARDWARE-CAD/PushingMechanism/Composant_A_Rainure.SLDPRT
60.0 x 30.0 x 130.0 mm
