EUROBOT-27/MECANIQUE/resources/INSATEURO2026/HARDWARE-CAD/RobotDXF/Base.DXF

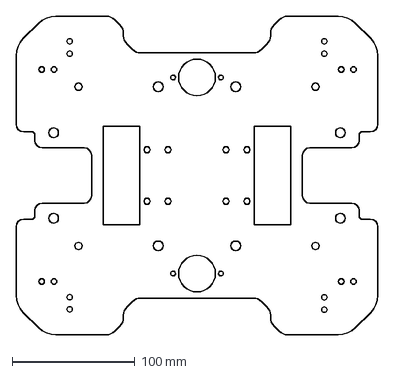
[picture p133: CAD file, 2026-11-01]
resources/INSATEURO2026/HARDWARE-CAD/RobotDXF/Base.DXF
295.0 x 260.0 mm
