EUROBOT-27/MECANIQUE/resources/Aero Euro/LIDAR_EUROBOT/src/robot_description/meshes/ball2.STL

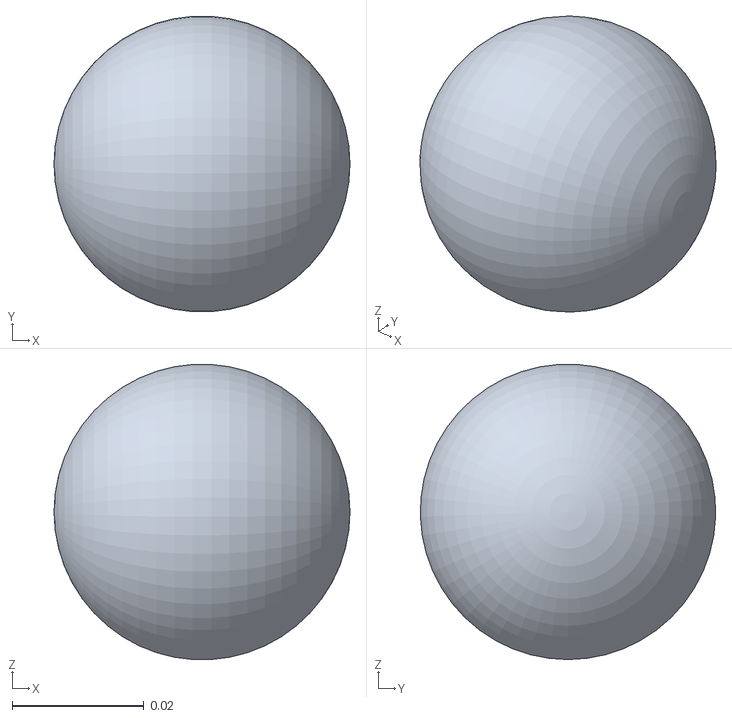
[picture p134: CAD file, 2026-11-01]
resources/Aero Euro/LIDAR_EUROBOT/src/robot_description/meshes/ball2.STL
0.045 x 0.0449 x 0.0449
