EUROBOT-27/MECANIQUE/resources/Aero Euro/NINJA_MECANIQUE/regulator HW-411 mini.SLDPRT

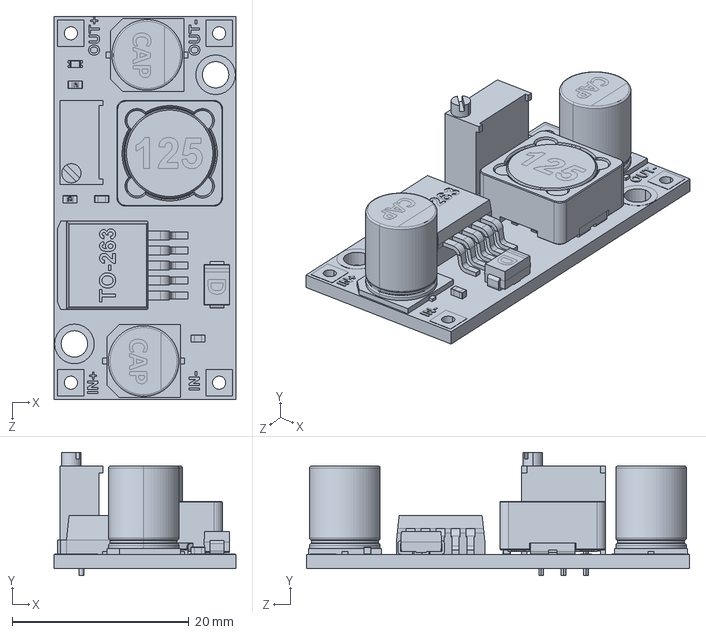
[picture p135: CAD file, 2026-11-01]
resources/Aero Euro/NINJA_MECANIQUE/regulator HW-411 mini.SLDPRT
20.6 x 14.0 x 43.4 mm
