EUROBOT-27/MECANIQUE/resources/CDR-2027/MCAD/3d-print/Canon5Balles.3mf

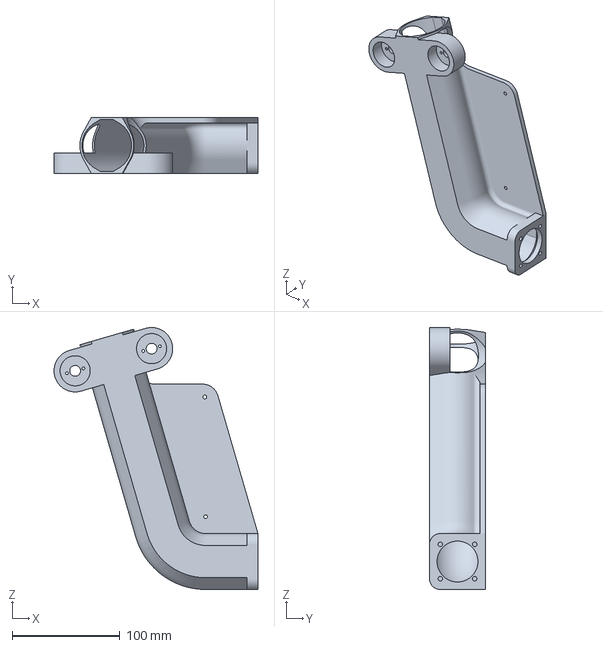
[picture p136: CAD file, 2026-11-01]
resources/CDR-2027/MCAD/3d-print/Canon5Balles.3mf
189.6 x 52.0 x 243.6 mm
