EUROBOT-27/MECANIQUE/resources/CDR-2027/MCAD/actuator-parts/box-manipulator.FCStd

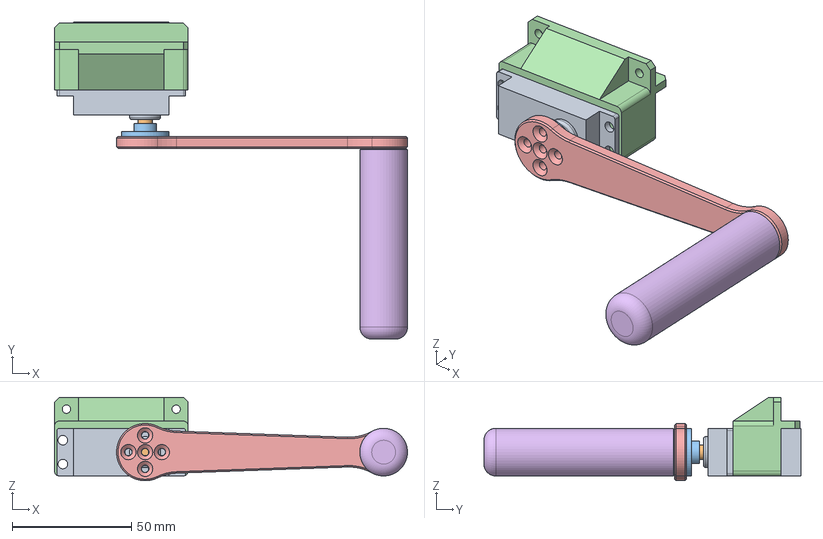
[picture p137: CAD file, 2026-11-01]
resources/CDR-2027/MCAD/actuator-parts/box-manipulator.FCStd
148.0 x 133.0 x 35.0 mm
ServoBody
ServoAxis
RoundServoHorn
servo-support
arm
arm-gripper
