EUROBOT-27/MECANIQUE/resources/CDR-2027/MCAD/mechanical-parts/LateralActuator.FCStd

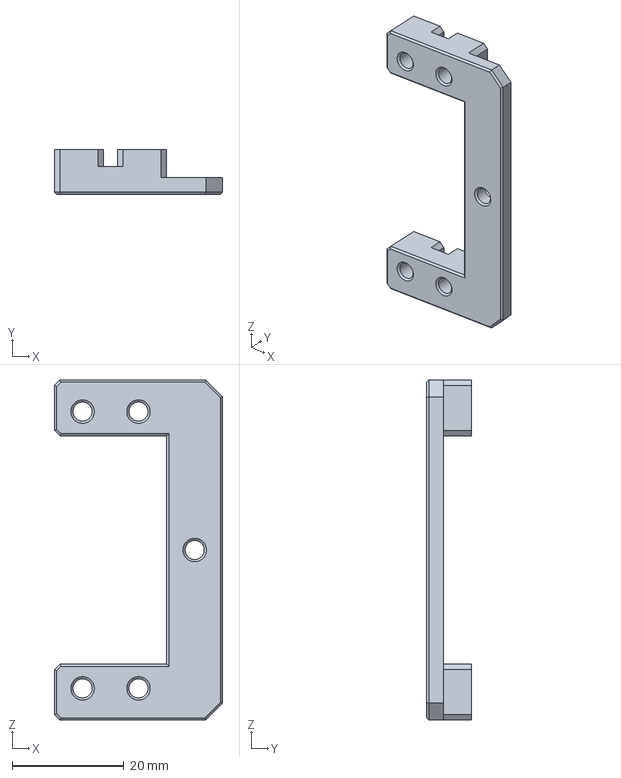
[picture p138: CAD file, 2026-11-01]
resources/CDR-2027/MCAD/mechanical-parts/LateralActuator.FCStd
30.1 x 8.00 x 60.8 mm
