EUROBOT-27/MECANIQUE/resources/INSATEURO2026/HARDWARE-CAD/GreenBox/DXFbox/GREENboxSide.DXF

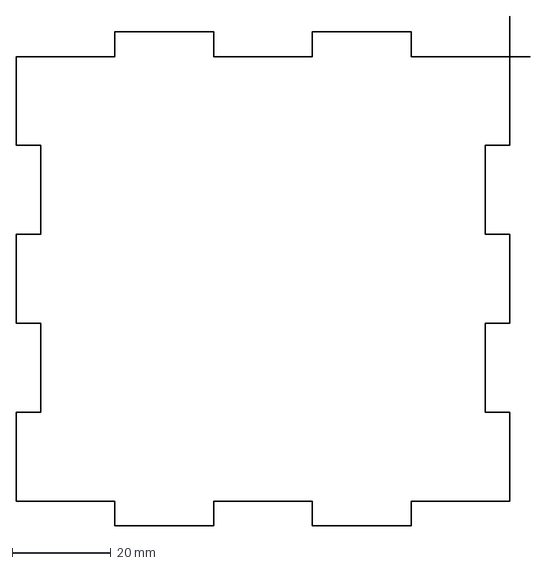
[picture p139: CAD file, 2026-11-01]
resources/INSATEURO2026/HARDWARE-CAD/GreenBox/DXFbox/GREENboxSide.DXF
104.1 x 103.2 mm
