EUROBOT-27/MECANIQUE/resources/INSATEURO2026/HARDWARE-CAD/PushingMechanism/poussoir.SLDPRT

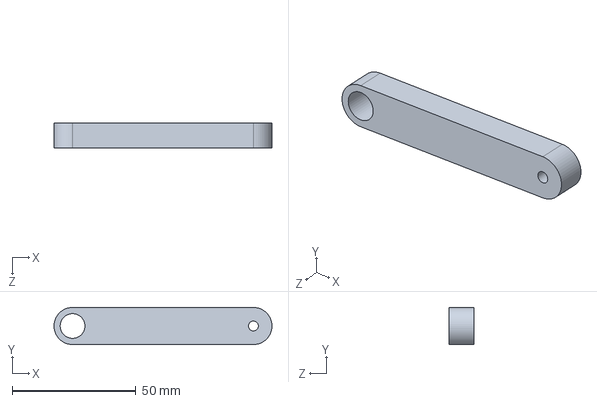
[picture p141: CAD file, 2026-11-01]
resources/INSATEURO2026/HARDWARE-CAD/PushingMechanism/poussoir.SLDPRT
88.0 x 15.0 x 10.0 mm
