EUROBOT-27/MECANIQUE/resources/INSATEURO2026/HARDWARE-CAD/RobotDXF/etage 3.DXF

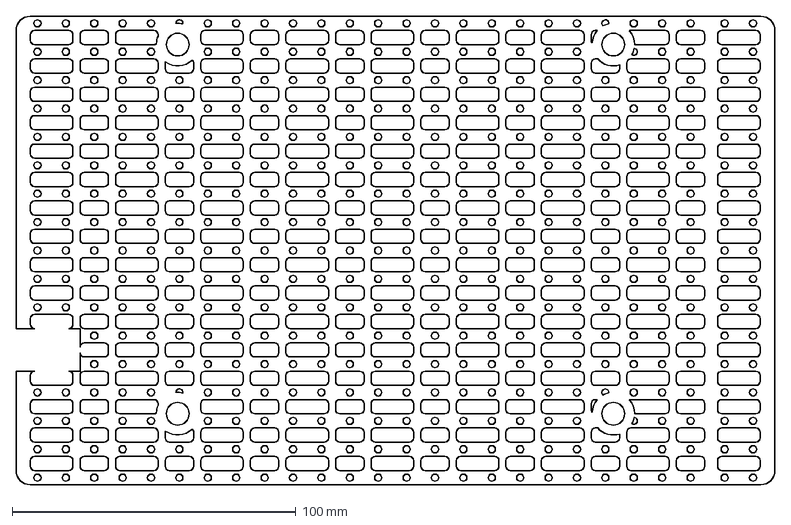
[picture p142: CAD file, 2026-11-01]
resources/INSATEURO2026/HARDWARE-CAD/RobotDXF/etage 3.DXF
267.2 x 165.0 mm
