EUROBOT-27/MECANIQUE/resources/INSATEURO2026/HARDWARE-CAD/VisEcrou+PushingMech/Accouplement.SLDPRT

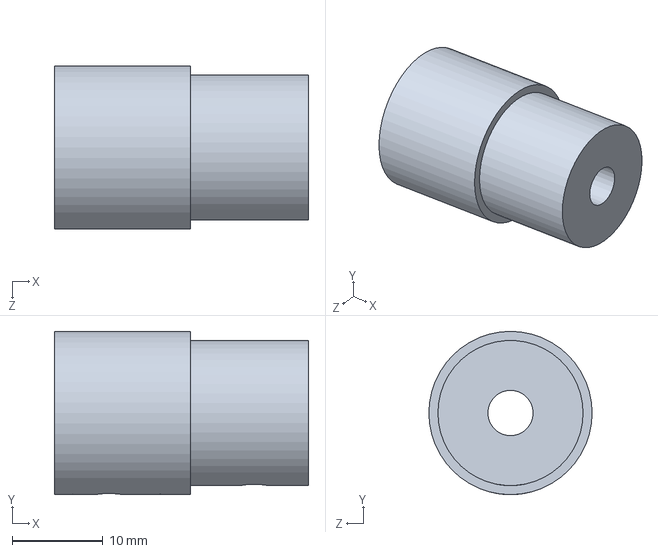
[picture p143: CAD file, 2026-11-01]
resources/INSATEURO2026/HARDWARE-CAD/VisEcrou+PushingMech/Accouplement.SLDPRT
28.0 x 18.0 x 18.0 mm
