EUROBOT-27/MECANIQUE/resources/Aero Euro/LIDAR_EUROBOT/src/robot_description/meshes/ld19.STL

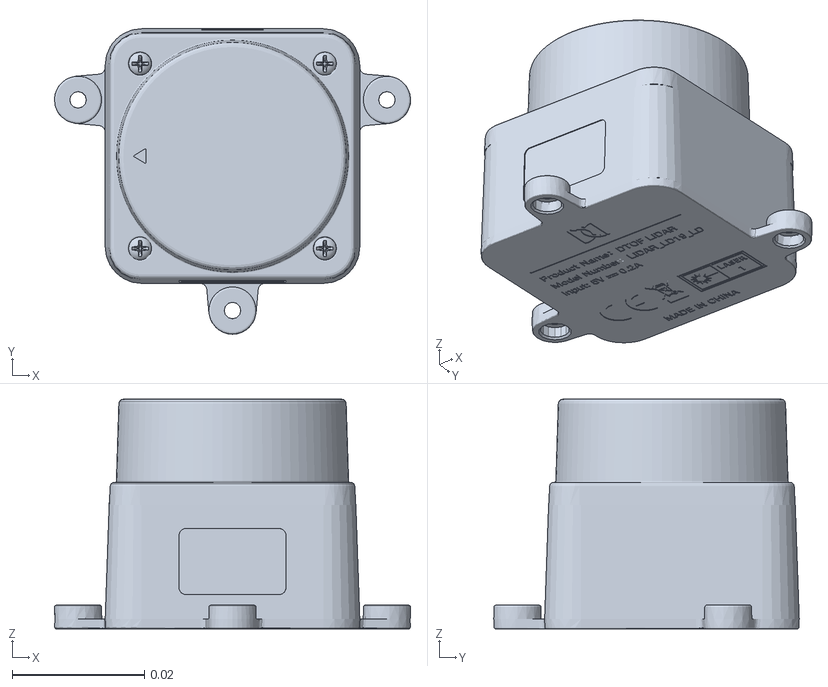
[picture p144: CAD file, 2026-11-01]
resources/Aero Euro/LIDAR_EUROBOT/src/robot_description/meshes/ld19.STL
0.0539 x 0.0463 x 0.0348
