EUROBOT-27/MECANIQUE/resources/CDR-2027/MCAD/3d-print/box-manipulator-arm-manipulatorarm-gripper.3mf

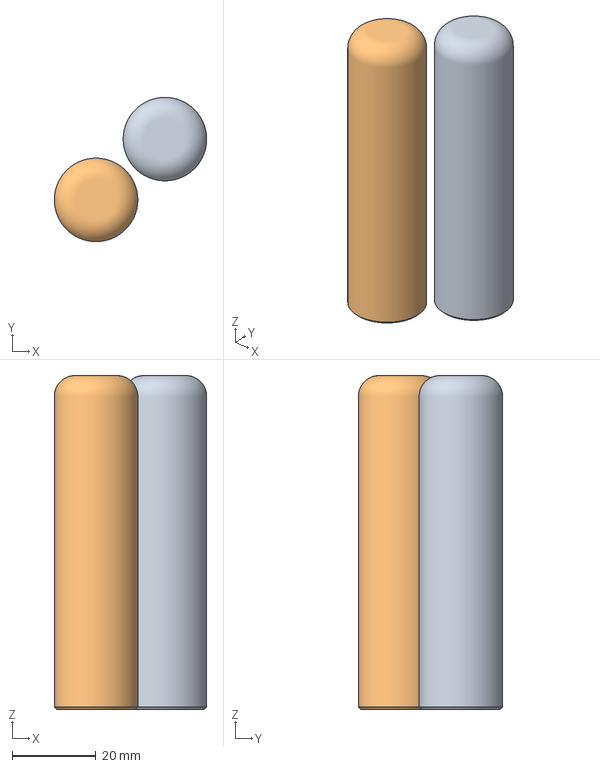
[picture p145: CAD file, 2026-11-01]
resources/CDR-2027/MCAD/3d-print/box-manipulator-arm-manipulatorarm-gripper.3mf
36.5 x 34.5 x 80.0 mm
arm-gripper x 2
