EUROBOT-27/MECANIQUE/resources/CDR-2027/MCAD/actuator-parts/ball-launcher-test.FCStd

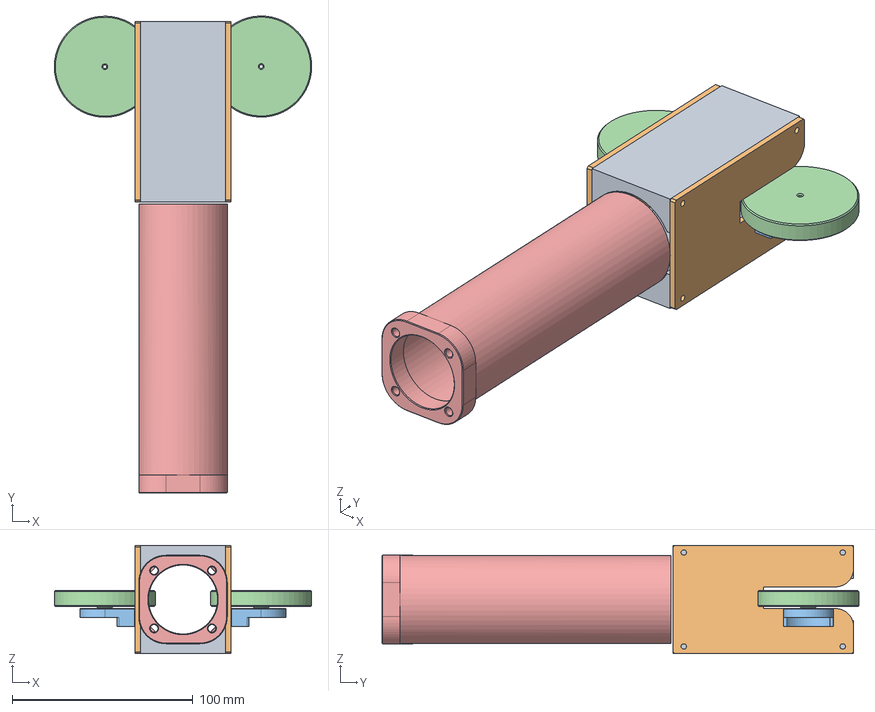
[picture p146: CAD file, 2026-11-01]
resources/CDR-2027/MCAD/actuator-parts/ball-launcher-test.FCStd
142.5 x 264.1 x 60.0 mm
Guide x 2
Corps x 2
support-motor-RS360S x 2
roue x 2
Tube
