EUROBOT-27/MECANIQUE/resources/CDR-2027/MCAD/electronical-parts/TopIHM.FCStd

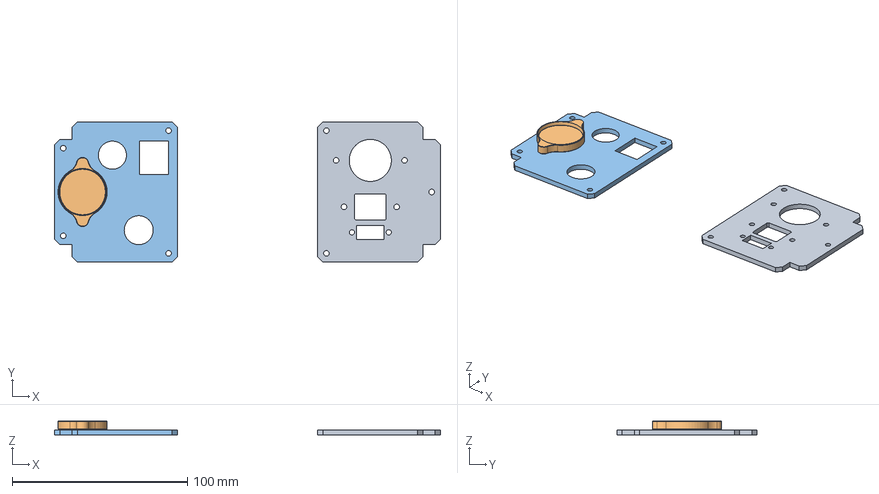
[picture p147: CAD file, 2026-11-01]
resources/CDR-2027/MCAD/electronical-parts/TopIHM.FCStd
220.0 x 80.0 x 8.00 mm
CarterScreenUSB
SupportTirette
CarterIHM
