EUROBOT-27/MECANIQUE/resources/INSATEURO2026/HARDWARE-CAD/Front2.SLDPRT

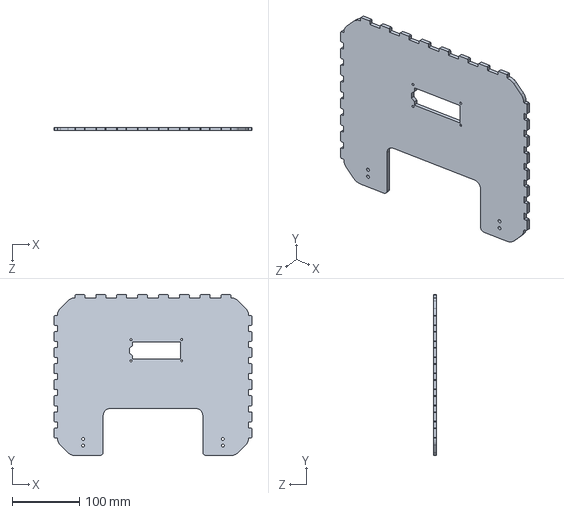
[picture p148: CAD file, 2026-11-01]
resources/INSATEURO2026/HARDWARE-CAD/Front2.SLDPRT
295.0 x 240.0 x 5.00 mm
