EUROBOT-27/MECANIQUE/resources/INSATEURO2026/HARDWARE-CAD/GreenBox/DXFbox/GreenBoxUP.DXF

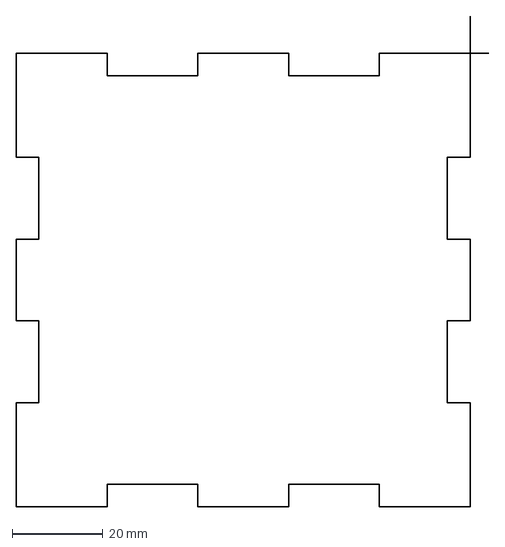
[picture p149: CAD file, 2026-11-01]
resources/INSATEURO2026/HARDWARE-CAD/GreenBox/DXFbox/GreenBoxUP.DXF
104.1 x 108.2 mm
