EUROBOT-27/MECANIQUE/resources/INSATEURO2026/HARDWARE-CAD/GrennTriangle/dxfTriangle/RecSide.DXF

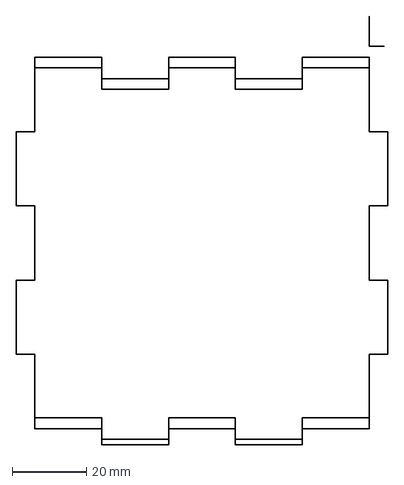
[picture p151: CAD file, 2026-11-01]
resources/INSATEURO2026/HARDWARE-CAD/GrennTriangle/dxfTriangle/RecSide.DXF
100.0 x 115.4 mm
