EUROBOT-27/MECANIQUE/resources/INSATEURO2026/HARDWARE-CAD/GrennTriangle/RecSide.SLDPRT

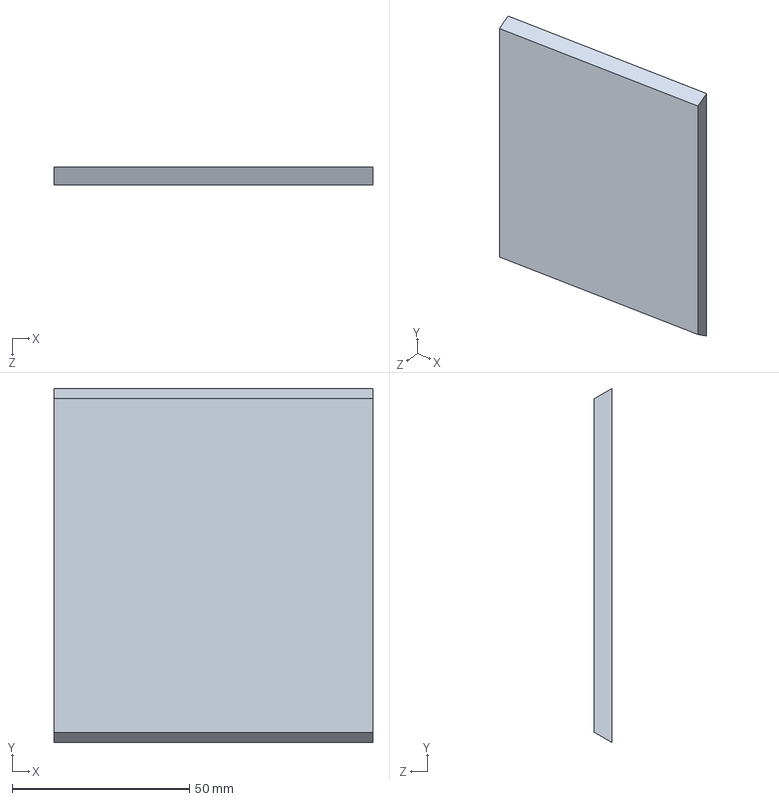
[picture p152: CAD file, 2026-11-01]
resources/INSATEURO2026/HARDWARE-CAD/GrennTriangle/RecSide.SLDPRT
90.0 x 100.0 x 5.00 mm
