EUROBOT-27/MECANIQUE/resources/Aero Euro/NINJA_MECANIQUE/koura scrolla.SLDPRT

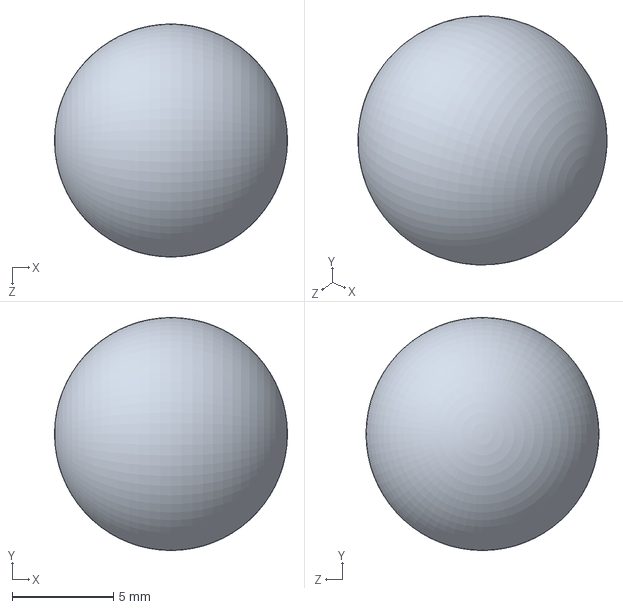
[picture p153: CAD file, 2026-11-01]
resources/Aero Euro/NINJA_MECANIQUE/koura scrolla.SLDPRT
11.5 x 11.5 x 11.5 mm
