EUROBOT-27/MECANIQUE/resources/CDR-2027/MCAD/3d-print/box-manipulator-arm-manipulator-servo-support.3mf

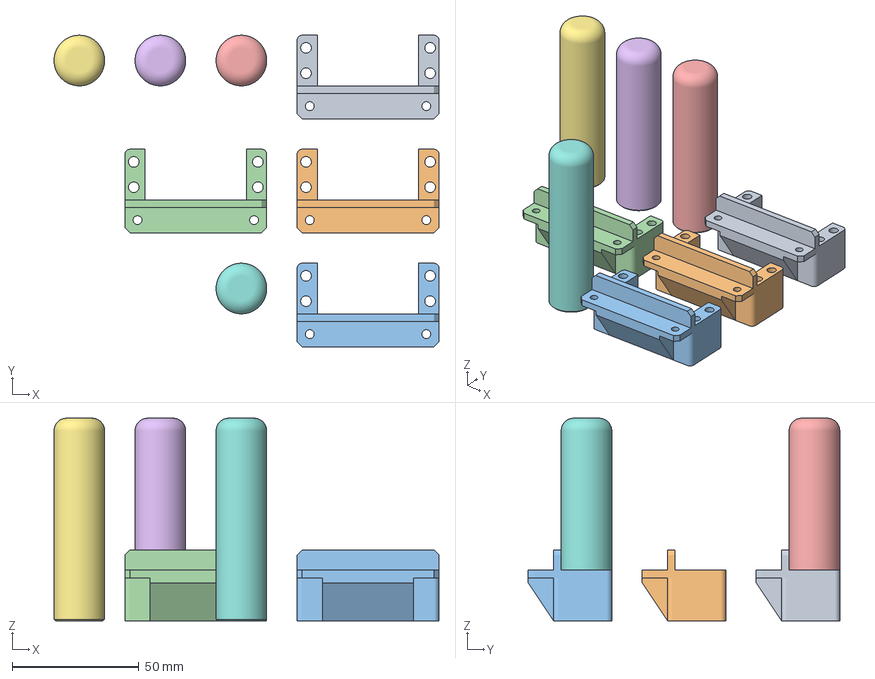
[picture p154: CAD file, 2026-11-01]
resources/CDR-2027/MCAD/3d-print/box-manipulator-arm-manipulator-servo-support.3mf
152.0 x 123.0 x 80.0 mm
servo-support x 4
arm-gripper x 4
