EUROBOT-27/MECANIQUE/resources/CDR-2027/MCAD/electronical-parts/GPIOExpanderSupport.FCStd

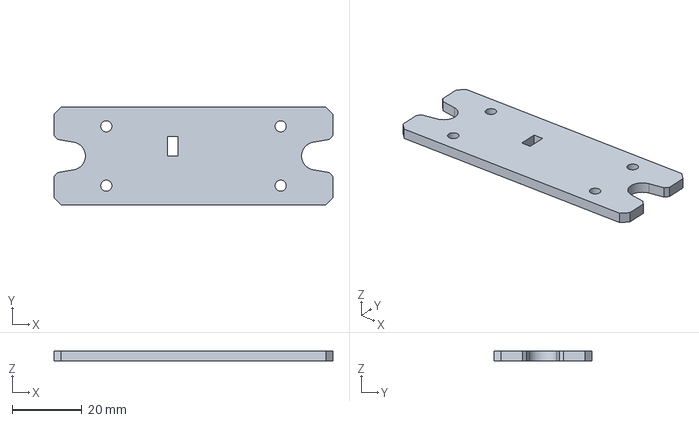
[picture p156: CAD file, 2026-11-01]
resources/CDR-2027/MCAD/electronical-parts/GPIOExpanderSupport.FCStd
80.0 x 28.0 x 3.00 mm
