EUROBOT-27/MECANIQUE/resources/CDR-2027/MCAD/mechanical-parts/elec-top.FCStd

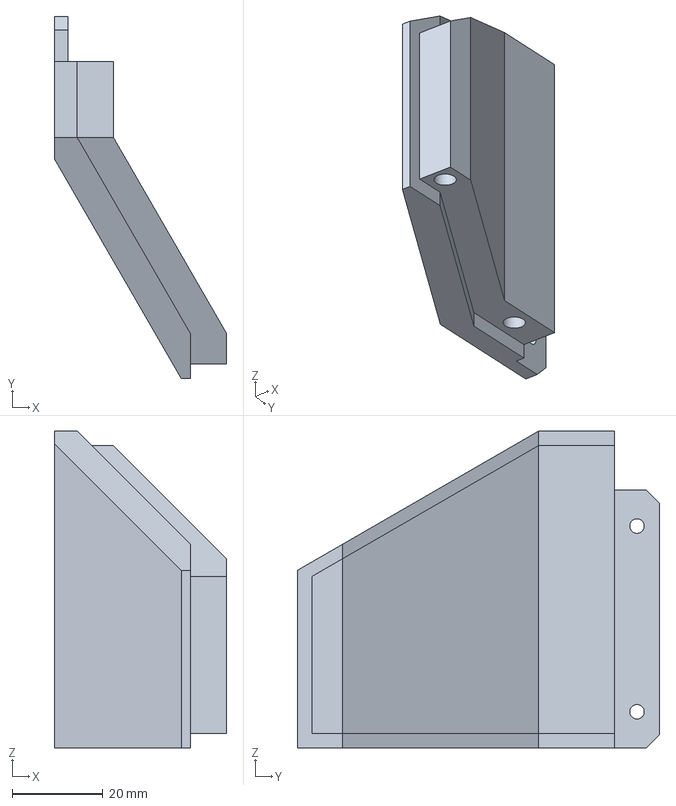
[picture p157: CAD file, 2026-11-01]
resources/CDR-2027/MCAD/mechanical-parts/elec-top.FCStd
38.0 x 80.0 x 70.0 mm
