EUROBOT-27/MECANIQUE/resources/INSATEURO2026/HARDWARE-CAD/GreenBox/GREENboxSide.SLDPRT

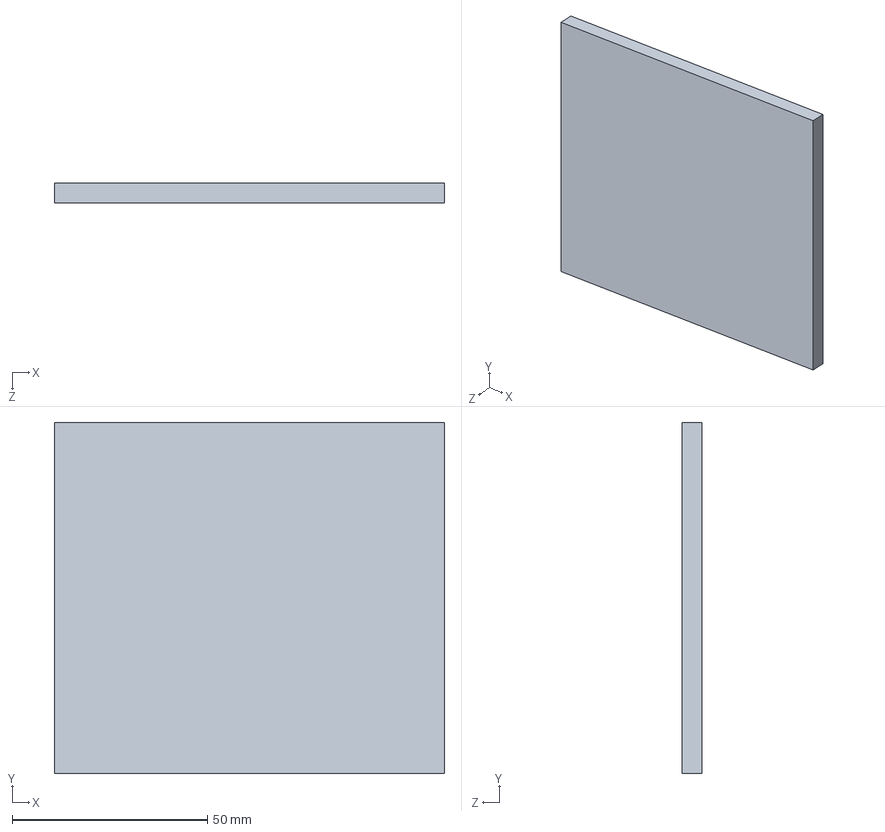
[picture p158: CAD file, 2026-11-01]
resources/INSATEURO2026/HARDWARE-CAD/GreenBox/GREENboxSide.SLDPRT
100.0 x 90.0 x 5.00 mm
