EUROBOT-27/MECANIQUE/resources/INSATEURO2026/HARDWARE-CAD/GrennTriangle/dxfTriangle/BASE.DXF

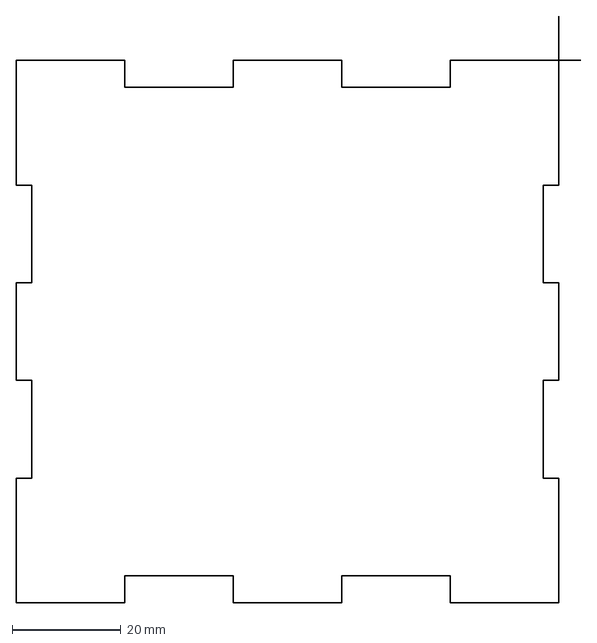
[picture p159: CAD file, 2026-11-01]
resources/INSATEURO2026/HARDWARE-CAD/GrennTriangle/dxfTriangle/BASE.DXF
104.1 x 108.2 mm
