EUROBOT-27/MECANIQUE/resources/INSATEURO2026/HARDWARE-CAD/L.SLDPRT

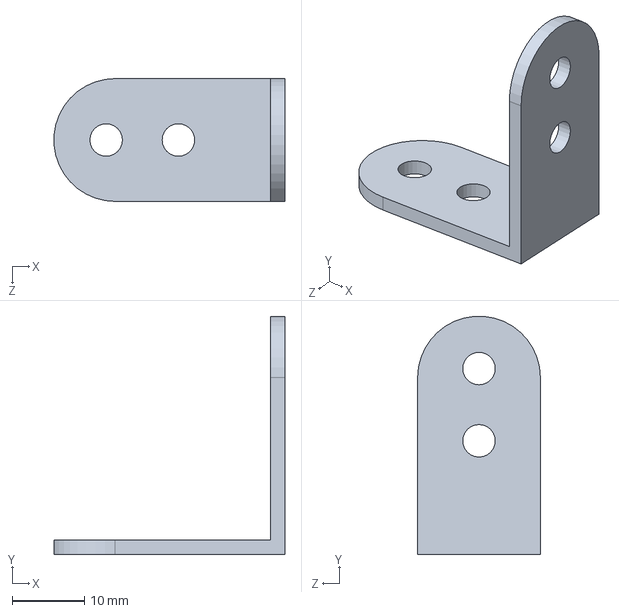
[picture p160: CAD file, 2026-11-01]
resources/INSATEURO2026/HARDWARE-CAD/L.SLDPRT
32.0 x 33.0 x 17.0 mm
