EUROBOT-27/MECANIQUE/resources/INSATEURO2026/HARDWARE-CAD/PushingMechanism/Glissante.SLDPRT

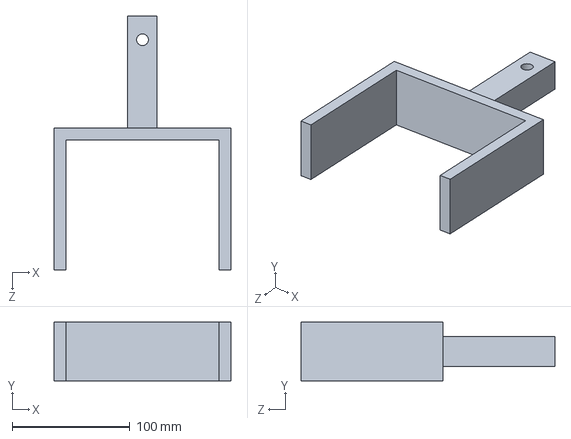
[picture p161: CAD file, 2026-11-01]
resources/INSATEURO2026/HARDWARE-CAD/PushingMechanism/Glissante.SLDPRT
150.0 x 50.0 x 215.0 mm
