EUROBOT-27/MECANIQUE/resources/INSATEURO2026/HARDWARE-CAD/RobotDXF/etage1.DXF

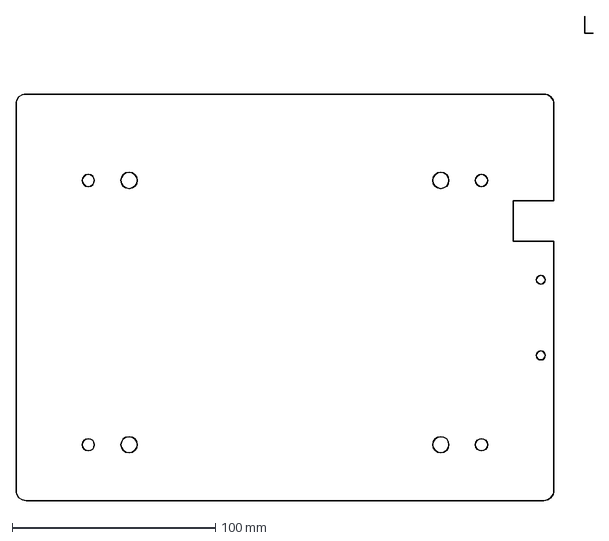
[picture p162: CAD file, 2026-11-01]
resources/INSATEURO2026/HARDWARE-CAD/RobotDXF/etage1.DXF
283.9 x 238.2 mm
