EUROBOT-27/MECANIQUE/resources/Aero Euro/NINJA_MECANIQUE/hit wst mdf 4.0.SLDPRT

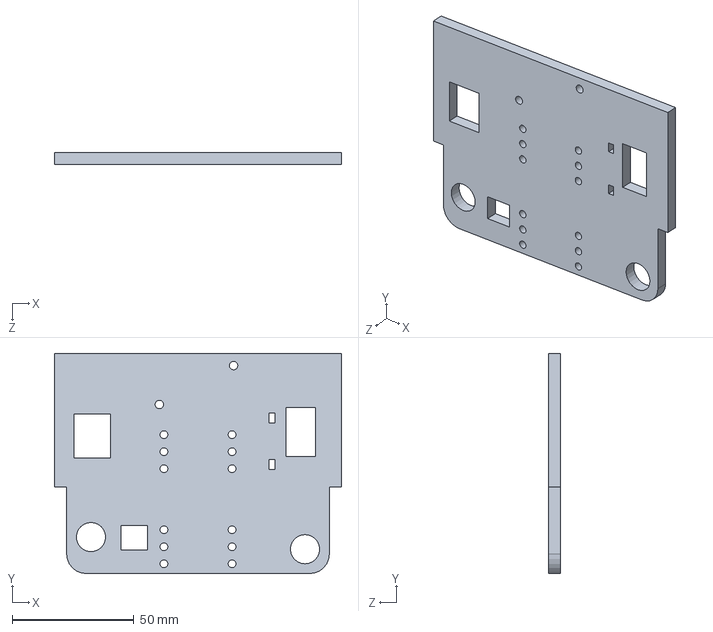
[picture p163: CAD file, 2026-11-01]
resources/Aero Euro/NINJA_MECANIQUE/hit wst mdf 4.0.SLDPRT
118.0 x 90.5 x 5.00 mm
