EUROBOT-27/MECANIQUE/resources/CDR-2027/MCAD/electronical-parts/BlocOdometrie.FCStd

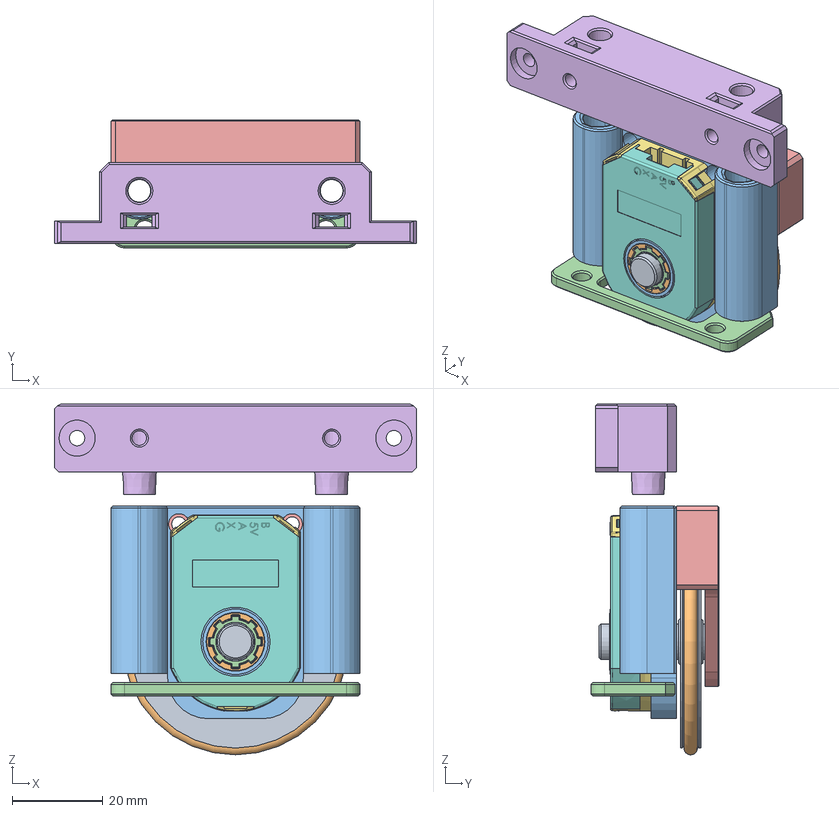
[picture p164: CAD file, 2026-11-01]
resources/CDR-2027/MCAD/electronical-parts/BlocOdometrie.FCStd
80.0 x 28.3 x 77.5 mm
RoueLibre
JoinTorique
SupportEncodeur
SupportBottomGlissiere
BrideArriere
SupportTopGlissiere
Poenc1_102-v-2515
Poenc1_102-v-2516
Poenc1_102-v-2517
Poenc1_102-v-2518
Poenc1_102-v-2519
Poenc1_102-v-2520
Poenc1_102-v-2521
Poenc1_102-v-2522
Poenc1_102-v-2523
Poenc1_102-v-2524
Poenc1_102-v-2525
Poenc1_102-v-2526
Poenc1_102-v-2527
Poenc1_102-v-2528
Poenc1_102-v-2529
