EUROBOT-27/MECANIQUE/resources/INSATEURO2026/HARDWARE-CAD/GrennTriangle/BASE.SLDPRT

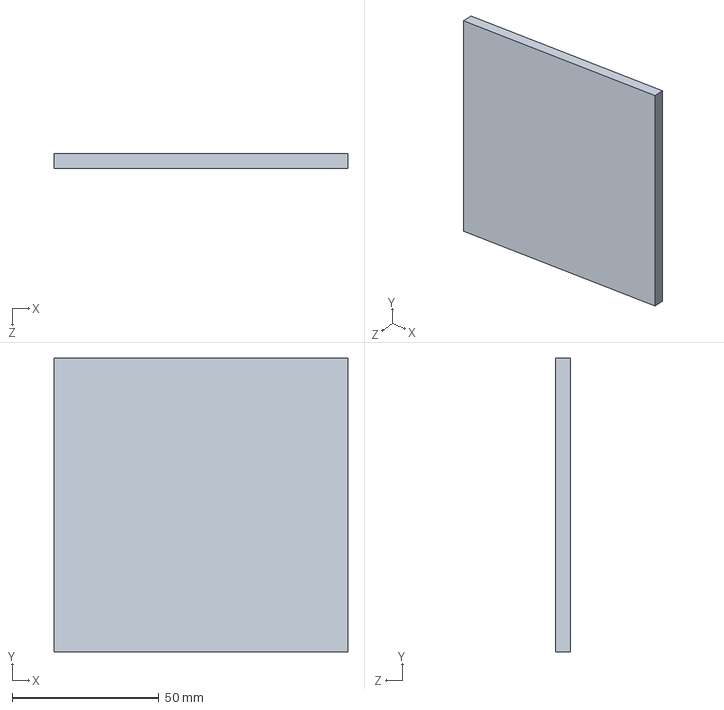
[picture p166: CAD file, 2026-11-01]
resources/INSATEURO2026/HARDWARE-CAD/GrennTriangle/BASE.SLDPRT
100.0 x 100.0 x 5.00 mm
