EUROBOT-27/MECANIQUE/resources/INSATEURO2026/HARDWARE-CAD/RobotDXF/Etat déplié - Front2.DXF

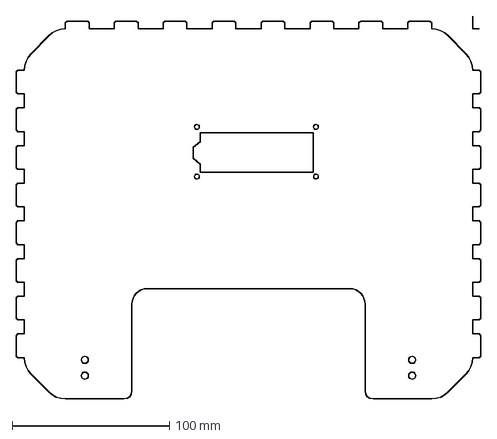
[picture p167: CAD file, 2026-11-01]
resources/INSATEURO2026/HARDWARE-CAD/RobotDXF/Etat déplié - Front2.DXF
295.0 x 243.2 mm
