EUROBOT-27/MECANIQUE/resources/INSATEURO2026/HARDWARE-CAD/SupportCam.SLDPRT

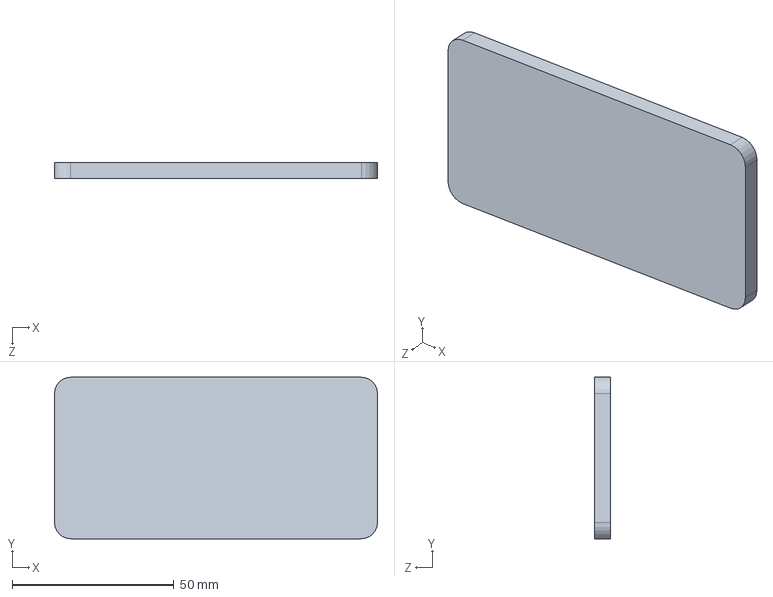
[picture p168: CAD file, 2026-11-01]
resources/INSATEURO2026/HARDWARE-CAD/SupportCam.SLDPRT
100.0 x 50.0 x 5.00 mm
