EUROBOT-27/MECANIQUE/resources/Aero Euro/LIDAR_EUROBOT/src/robot_description/meshes/base_link.STL

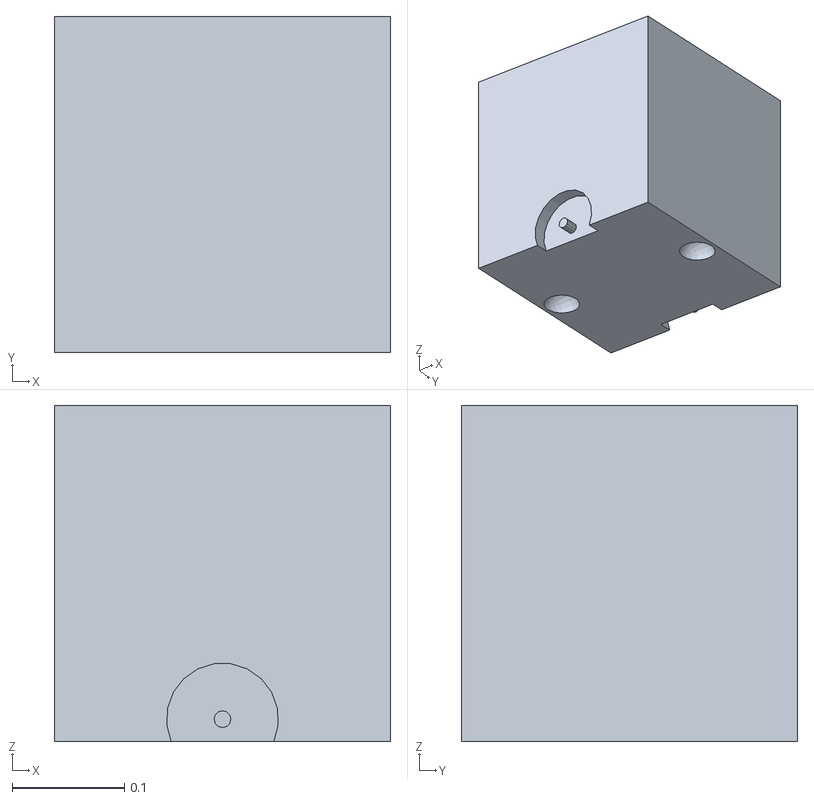
[picture p169: CAD file, 2026-11-01]
resources/Aero Euro/LIDAR_EUROBOT/src/robot_description/meshes/base_link.STL
0.3 x 0.3 x 0.3
