EUROBOT-27/MECANIQUE/resources/Aero Euro/NINJA_MECANIQUE/electric valve mini12 V.SLDPRT

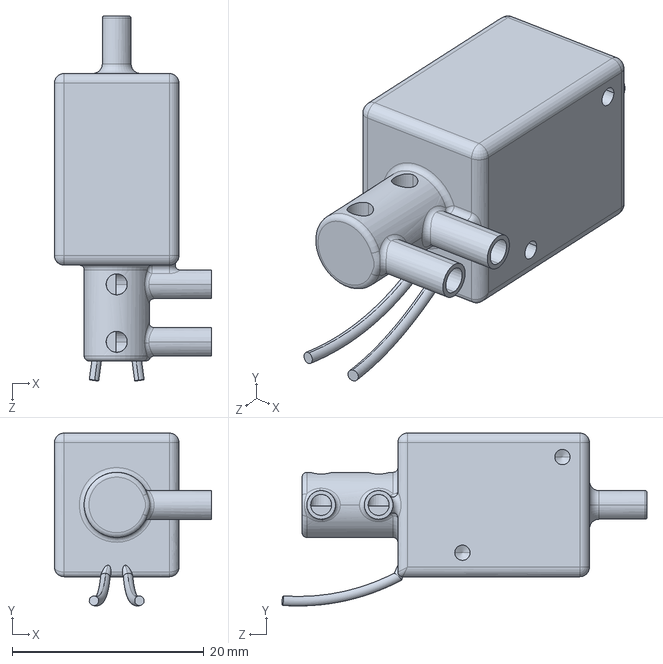
[picture p170: CAD file, 2026-11-01]
resources/Aero Euro/NINJA_MECANIQUE/electric valve mini12 V.SLDPRT
16.4 x 18.0 x 38.1 mm
