EUROBOT-27/MECANIQUE/resources/CDR-2027/MCAD/electronical-parts/PCA9685-BoardSupport.FCStd

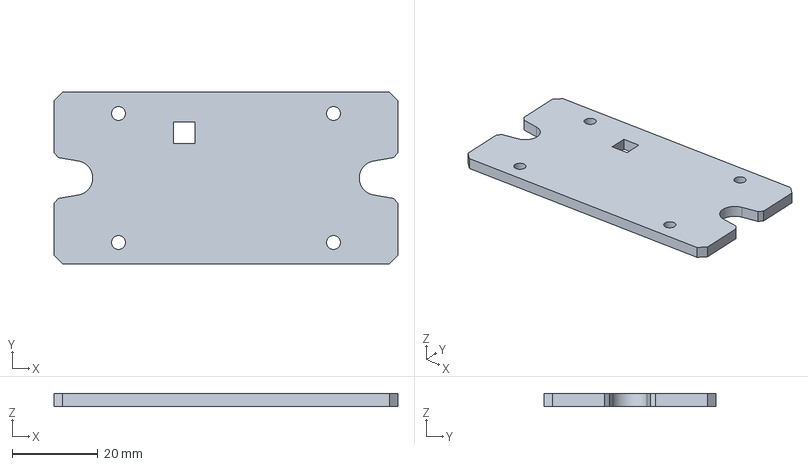
[picture p171: CAD file, 2026-11-01]
resources/CDR-2027/MCAD/electronical-parts/PCA9685-BoardSupport.FCStd
80.0 x 40.0 x 3.00 mm
