EUROBOT-27/MECANIQUE/resources/CDR-2027/MCAD/mechanical-parts/Semelle.FCStd

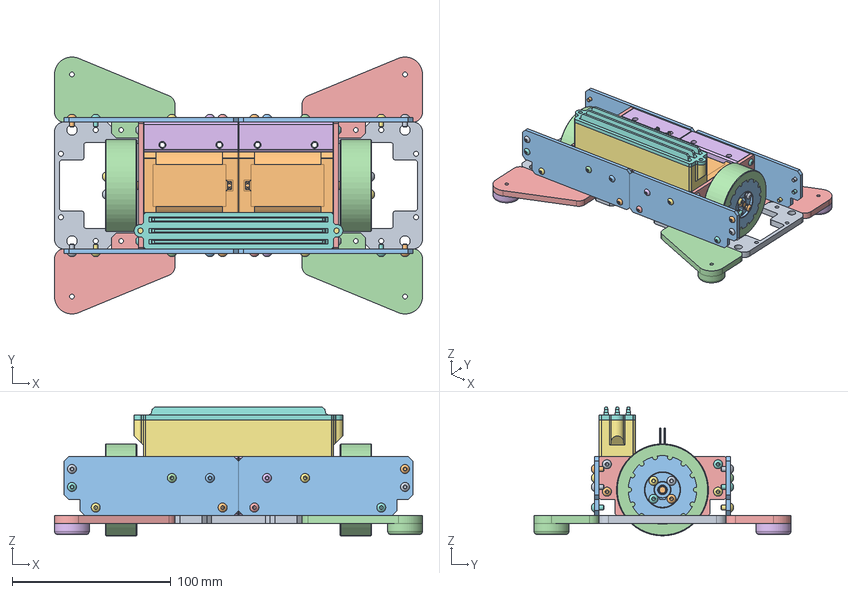
[picture p172: CAD file, 2026-11-01]
resources/CDR-2027/MCAD/mechanical-parts/Semelle.FCStd
232.0 x 162.0 x 81.1 mm
SemelleRobot
OMC-Stepper-17HS24-2104S x 2
M3x5.74-Insérer178 x 4
M3x5.74-Insérer179 x 4
M3x5.74-Insérer180 x 4
M3x5.74-Insérer181 x 4
M3x6-Vis x 4
M3x6-Vis078 x 4
M3x6-Vis079 x 4
M3x6-Vis080 x 4
CoreWheel x 2
MotorPlate x 2
MotorLateralSupport x 4
M3x6-Vis081 x 4
M3x6-Vis082 x 4
M3x6-Vis083 x 4
M3x6-Vis084 x 4
M3x8-Vis x 4
M3x8-Vis010 x 4
M3x8-Vis011 x 4
M3x8-Vis012 x 4
M3x6-Vis085 x 4
M3x6-Vis086 x 4
M3x6-Vis087 x 4
M3x6-Vis088 x 4
M3x10-Vis x 4
M3x10-Vis022 x 4
M3x6-Vis089 x 4
M3x10-Vis023 x 4
M3x10-Vis024 x 4
M3x6-Vis090 x 4
M3x6-Vis091 x 4
M3x6-Vis092 x 4
LateralMotorPlate x 4
EnsemblePatin (Mirror #1) x 2
PortePatinPTFE x 2
PatinPTFE-22mm x 2
BoitePoids
CouvercleBoitePoids
