EUROBOT-27/MECANIQUE/resources/INSATEURO2026/HARDWARE-CAD/leftSide2.SLDPRT

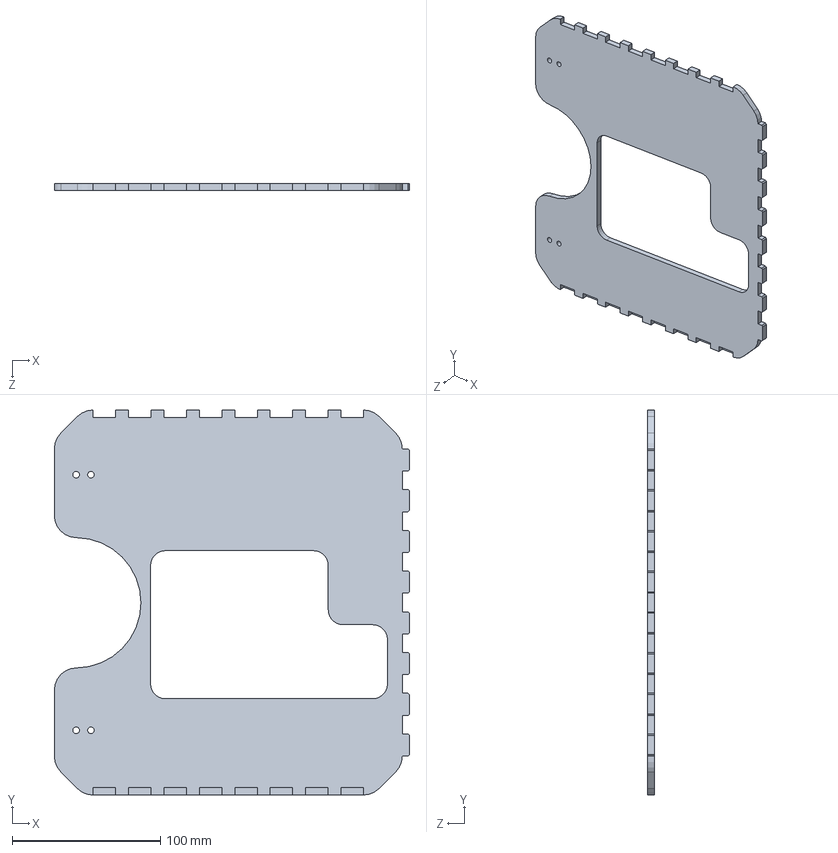
[picture p173: CAD file, 2026-11-01]
resources/INSATEURO2026/HARDWARE-CAD/leftSide2.SLDPRT
240.0 x 260.0 x 5.00 mm
