EUROBOT-27/MECANIQUE/resources/INSATEURO2026/HARDWARE-CAD/RobotDXF/CamSupportBack.DXF

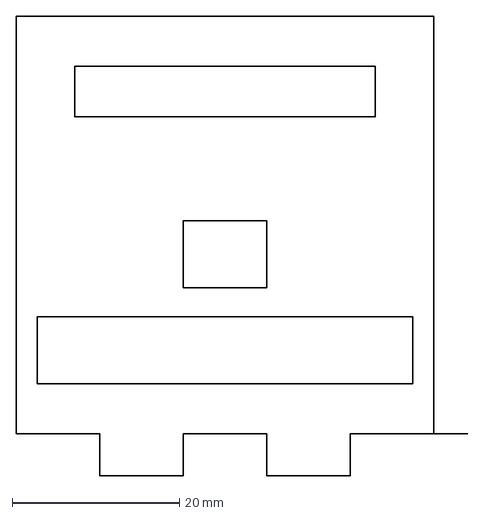
[picture p174: CAD file, 2026-11-01]
resources/INSATEURO2026/HARDWARE-CAD/RobotDXF/CamSupportBack.DXF
54.1 x 55.0 mm
