EUROBOT-27/MECANIQUE/resources/Aero Euro/NINJA_MECANIQUE/3ejla sys 4.0.SLDPRT

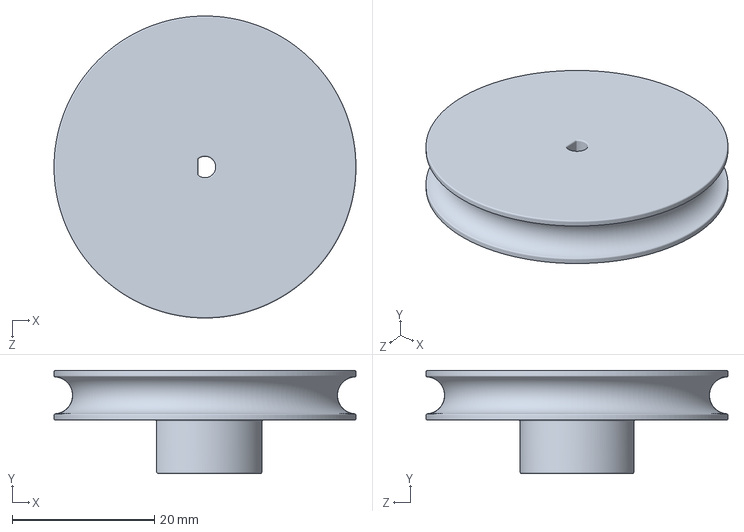
[picture p175: CAD file, 2026-11-01]
resources/Aero Euro/NINJA_MECANIQUE/3ejla sys 4.0.SLDPRT
42.5 x 14.5 x 42.5 mm
