EUROBOT-27/MECANIQUE/resources/CDR-2027/MCAD/electronical-parts/otos-sensor.FCStd

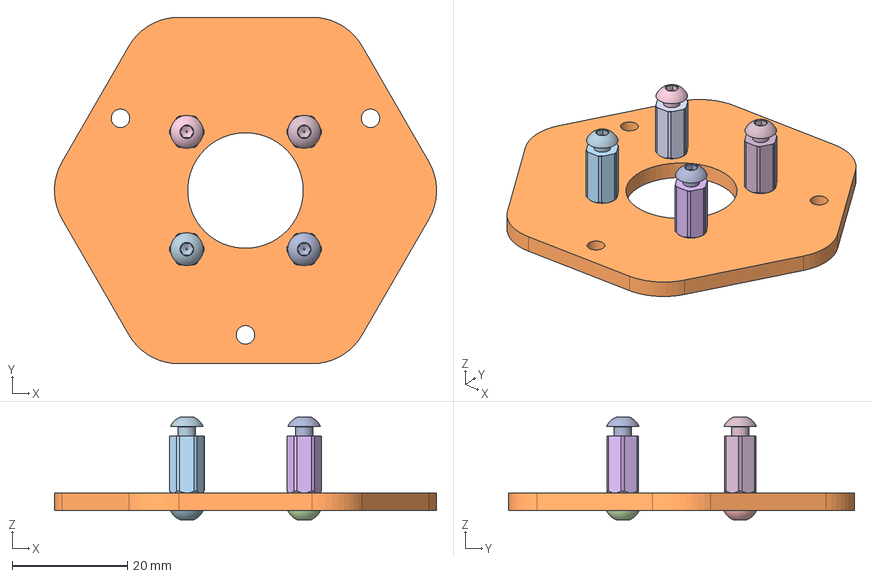
[picture p176: CAD file, 2026-11-01]
resources/CDR-2027/MCAD/electronical-parts/otos-sensor.FCStd
66.2 x 60.0 x 17.8 mm
M3x10xx5.5-Entretoise
M3x10xx5.5-Entretoise007
M3x10xx5.5-Entretoise008
M3x10xx5.5-Entretoise009
M3x8-Vis
M3x8-Vis019
M3x8-Vis020
M3x8-Vis021
M3x8-Vis022
M3x8-Vis023
M3x8-Vis024
M3x8-Vis025
Corps
