EUROBOT-27/MECANIQUE/resources/CDR-2027/MCAD/mechanical-parts/molding_parts.FCStd

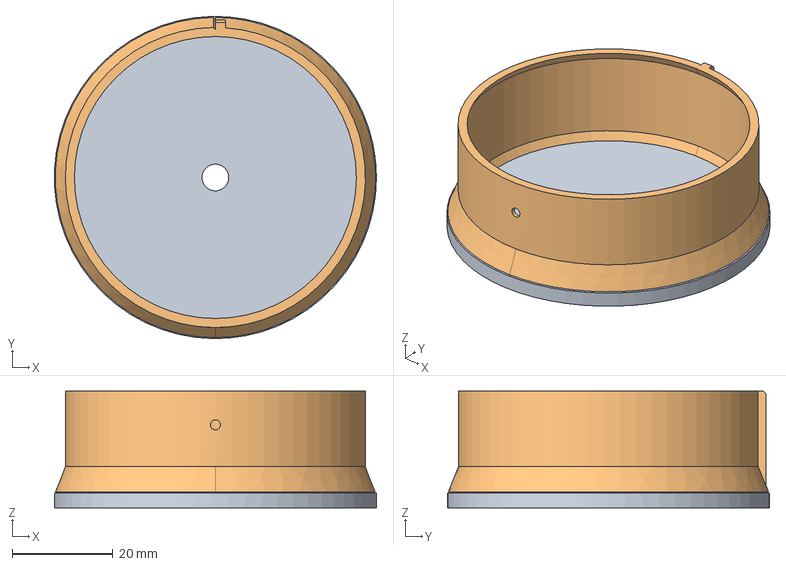
[picture p177: CAD file, 2026-11-01]
resources/CDR-2027/MCAD/mechanical-parts/molding_parts.FCStd
64.0 x 64.0 x 23.2 mm
Base_01
