EUROBOT-27/MECANIQUE/resources/INSATEURO2026/HARDWARE-CAD/PCB_Puissance.SLDPRT

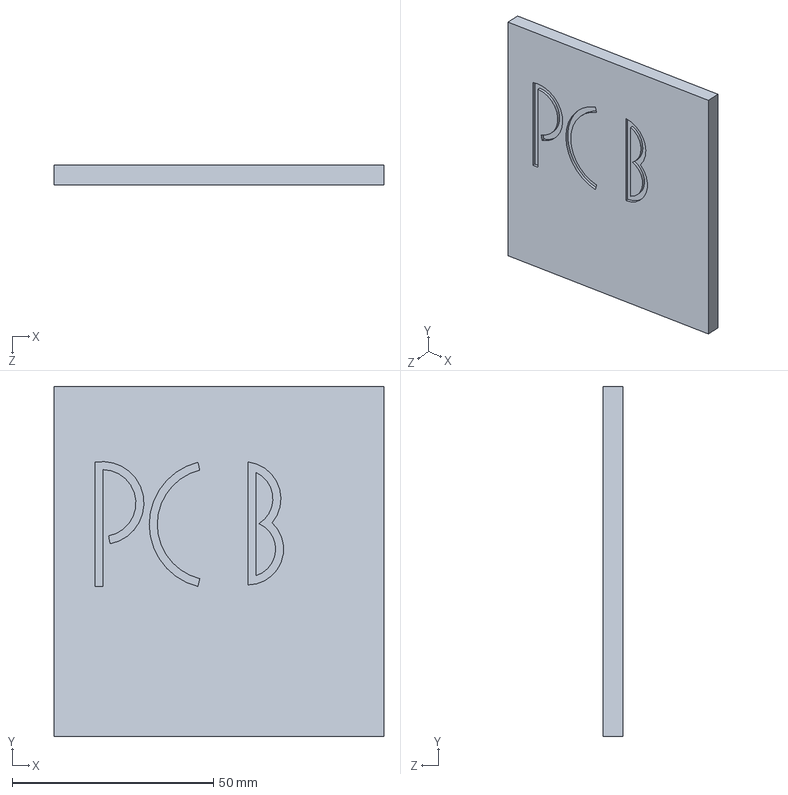
[picture p178: CAD file, 2026-11-01]
resources/INSATEURO2026/HARDWARE-CAD/PCB_Puissance.SLDPRT
82.0 x 87.0 x 5.00 mm
