EUROBOT-27/MECANIQUE/resources/CDR-2027/MCAD/electronical-parts/Battery-test.FCStd

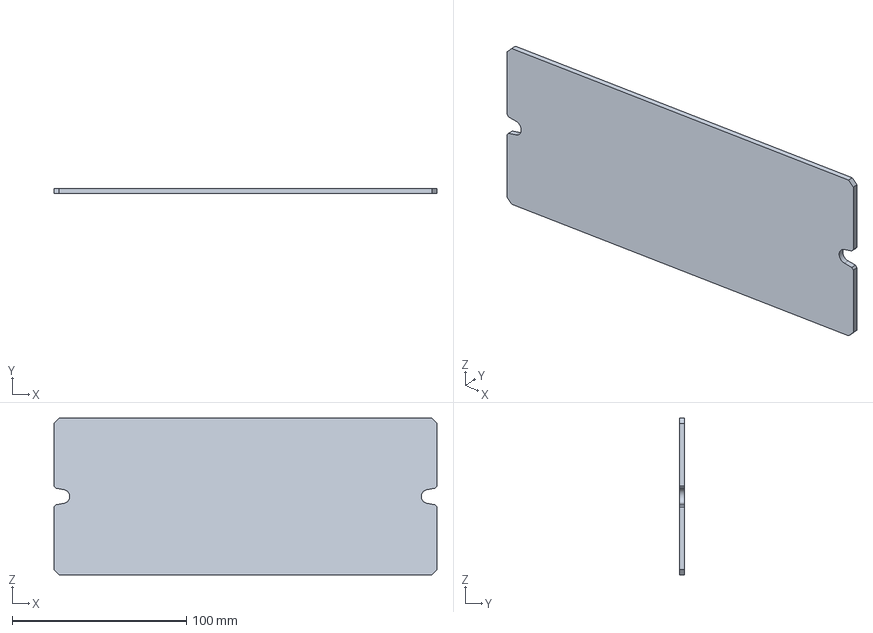
[picture p180: CAD file, 2026-11-01]
resources/CDR-2027/MCAD/electronical-parts/Battery-test.FCStd
220.0 x 3.00 x 90.0 mm
