EUROBOT-27/MECANIQUE/resources/INSATEURO2026/HARDWARE-CAD/Colour_Number_Rectangle.SLDPRT

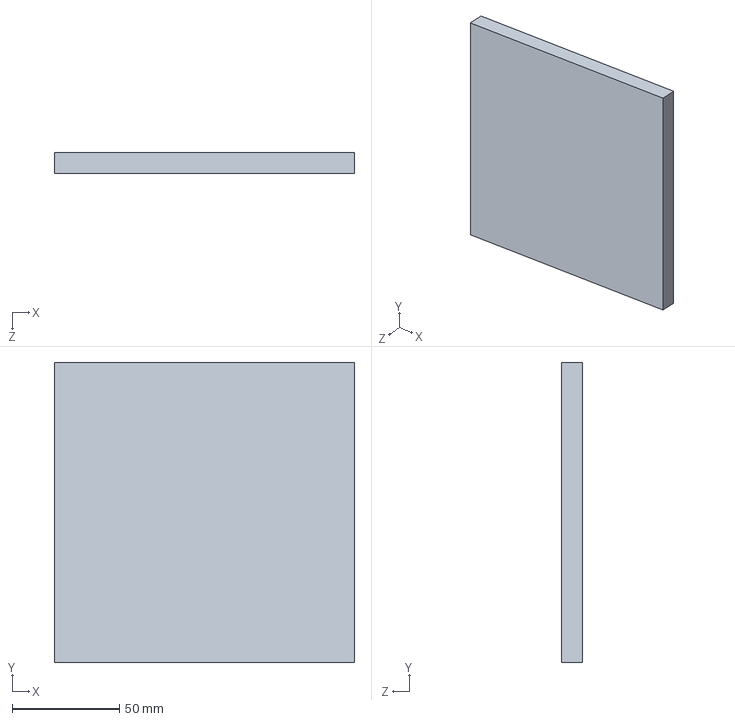
[picture p181: CAD file, 2026-11-01]
resources/INSATEURO2026/HARDWARE-CAD/Colour_Number_Rectangle.SLDPRT
140.0 x 140.0 x 10.0 mm
