EUROBOT-27/MECANIQUE/resources/Aero Euro/NINJA_MECANIQUE/wall sheild 2.7.SLDPRT

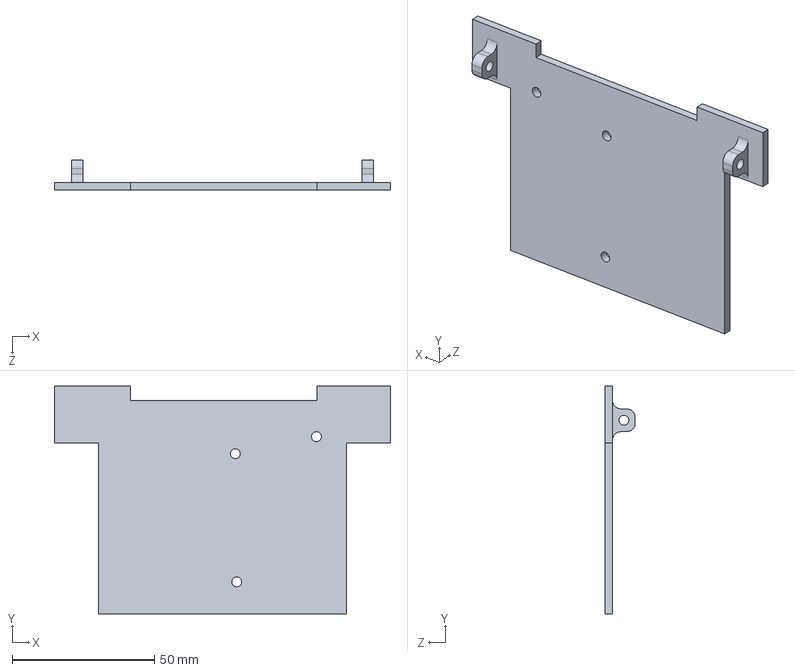
[picture p182: CAD file, 2026-11-01]
resources/Aero Euro/NINJA_MECANIQUE/wall sheild 2.7.SLDPRT
118.0 x 80.0 x 10.7 mm
