EUROBOT-27/MECANIQUE/resources/CDR-2027/MCAD/electronical-parts/MatBalise.FCStd

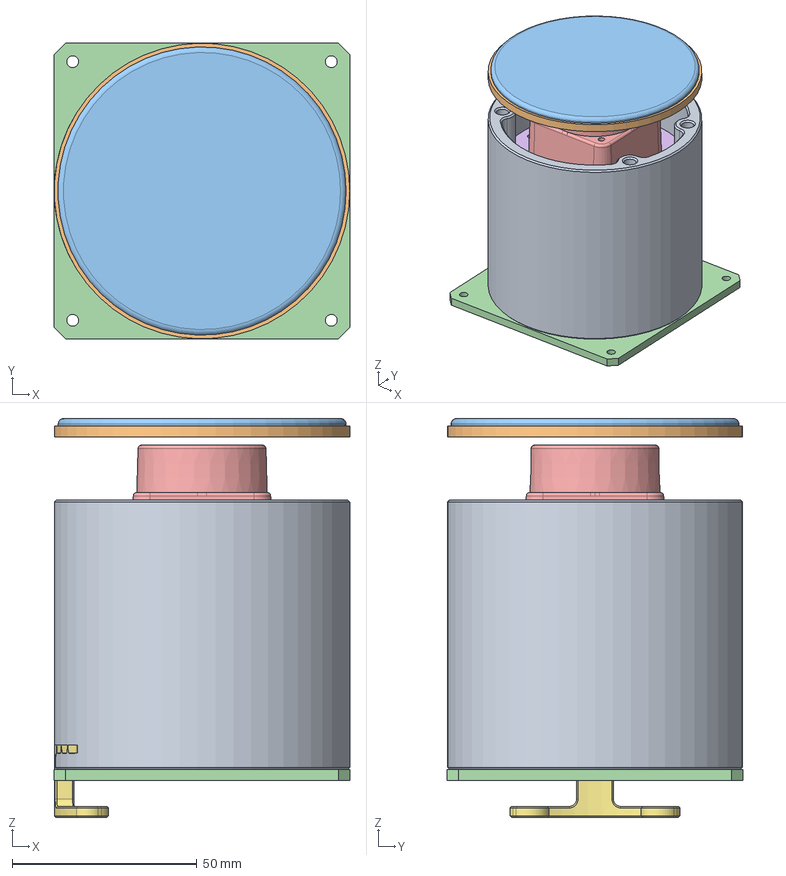
[picture p183: CAD file, 2026-11-01]
resources/CDR-2027/MCAD/electronical-parts/MatBalise.FCStd
80.0 x 80.0 x 108.0 mm
Mat
SupportBaliseAdverse
Scratch
CarterMatDeBalise
BaseLD06
SupportInterneLD06
TopSupportSpecial
