EUROBOT-27/MECANIQUE/resources/INSATEURO2026/HARDWARE-CAD/RobotDXF/UpperRobotSide.DXF

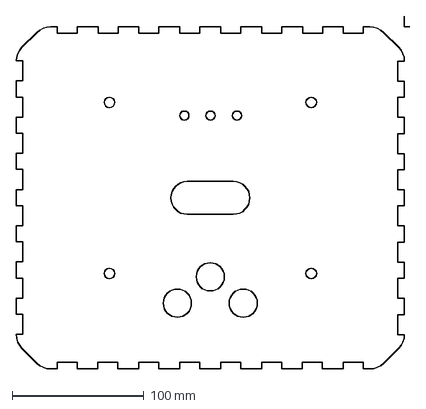
[picture p184: CAD file, 2026-11-01]
resources/INSATEURO2026/HARDWARE-CAD/RobotDXF/UpperRobotSide.DXF
299.1 x 268.2 mm
