EUROBOT-27/MECANIQUE/resources/Aero Euro/NINJA_MECANIQUE/pompe mini.SLDPRT

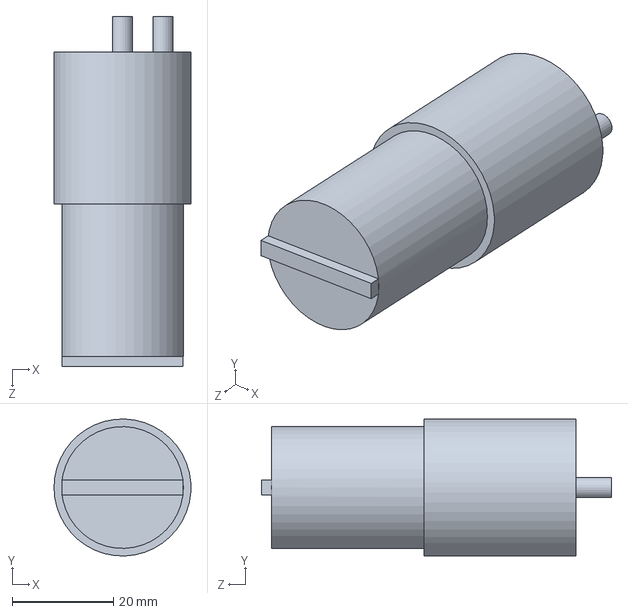
[picture p185: CAD file, 2026-11-01]
resources/Aero Euro/NINJA_MECANIQUE/pompe mini.SLDPRT
27.0 x 27.0 x 69.0 mm
