EUROBOT-27/MECANIQUE/resources/CDR-2027/MCAD/electronical-parts/DriverBoardSupport.FCStd

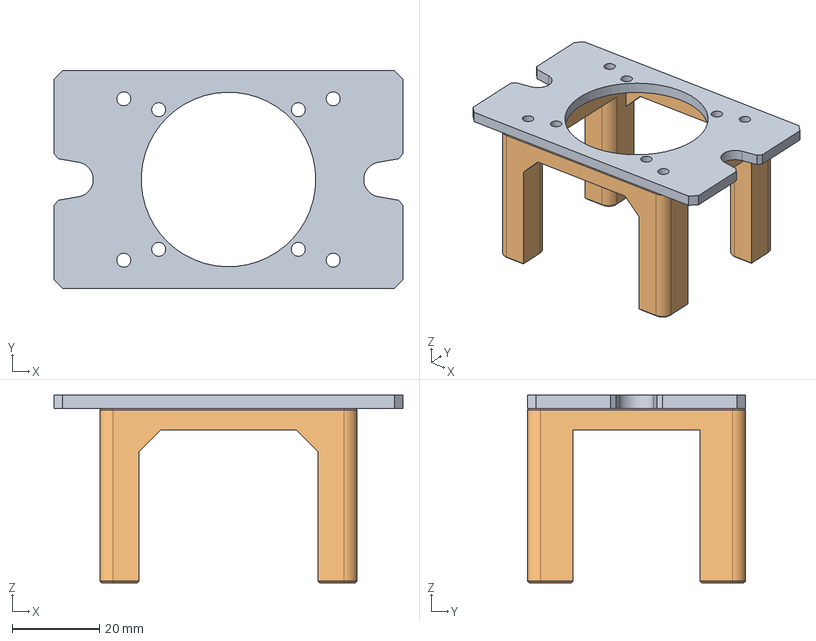
[picture p186: CAD file, 2026-11-01]
resources/CDR-2027/MCAD/electronical-parts/DriverBoardSupport.FCStd
80.0 x 50.0 x 43.0 mm
DriverBoardPlate
SupportDriverBoard
