EUROBOT-27/MECANIQUE/resources/INSATEURO2026/HARDWARE-CAD/CamSupportBack.SLDPRT

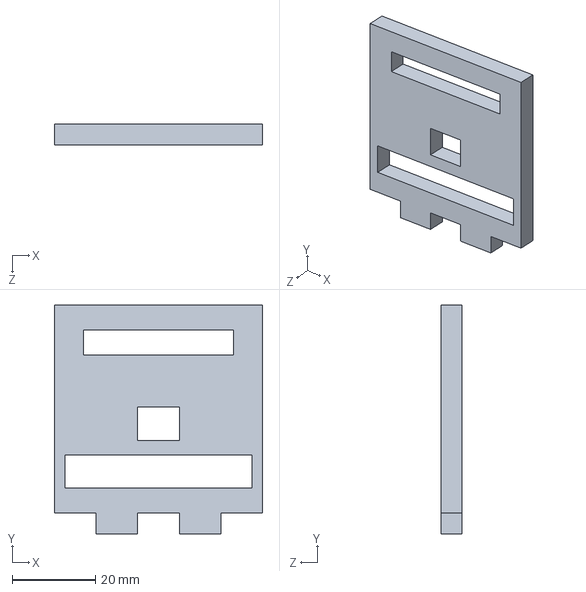
[picture p187: CAD file, 2026-11-01]
resources/INSATEURO2026/HARDWARE-CAD/CamSupportBack.SLDPRT
50.0 x 55.0 x 5.00 mm
