EUROBOT-27/MECANIQUE/resources/INSATEURO2026/HARDWARE-CAD/RobotDXF/BaseBalam.DXF

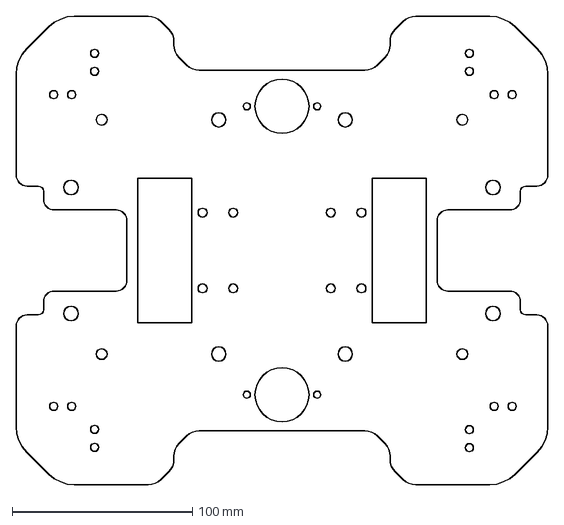
[picture p188: CAD file, 2026-11-01]
resources/INSATEURO2026/HARDWARE-CAD/RobotDXF/BaseBalam.DXF
295.0 x 260.0 mm
