EUROBOT-27/MECANIQUE/resources/Aero Euro/NINJA_MECANIQUE/pneumatic fitting 90 deg 4mm.SLDPRT

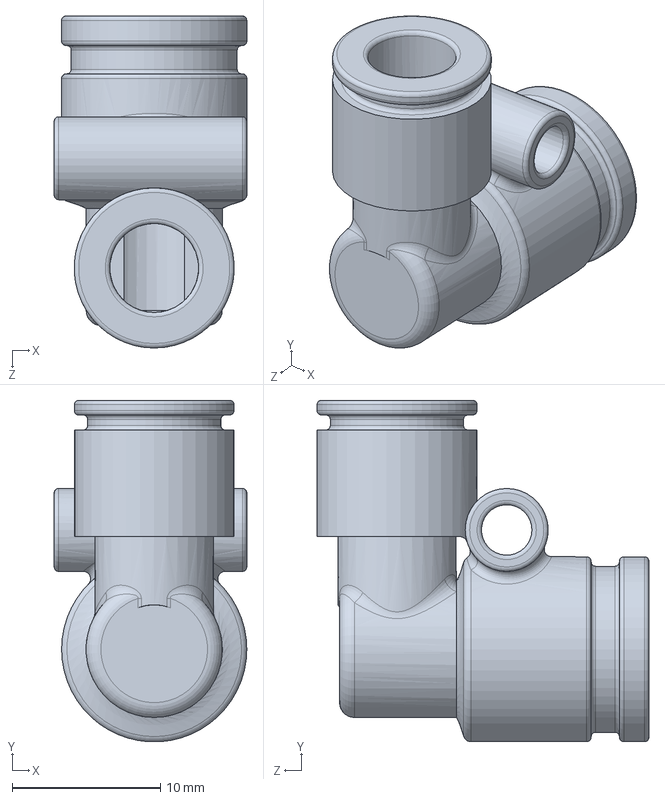
[picture p189: CAD file, 2026-11-01]
resources/Aero Euro/NINJA_MECANIQUE/pneumatic fitting 90 deg 4mm.SLDPRT
13.0 x 23.0 x 22.4 mm
