EUROBOT-27/MECANIQUE/resources/INSATEURO2026/HARDWARE-CAD/etage1.SLDPRT

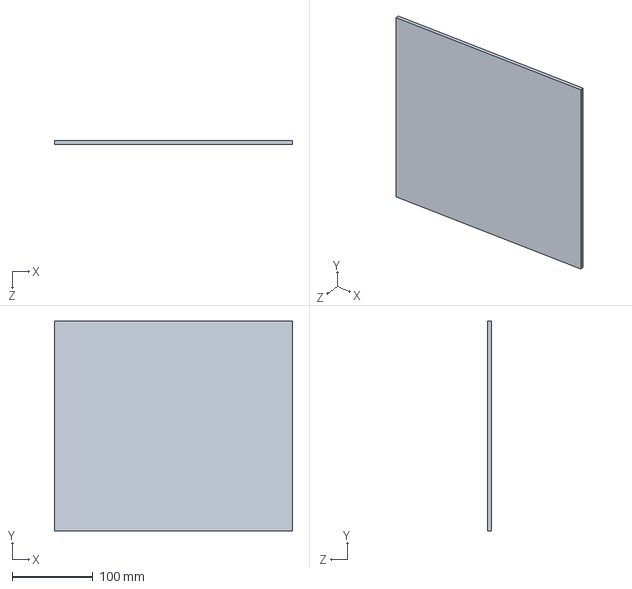
[picture p190: CAD file, 2026-11-01]
resources/INSATEURO2026/HARDWARE-CAD/etage1.SLDPRT
295.0 x 260.0 x 5.00 mm
