EUROBOT-27/MECANIQUE/resources/INSATEURO2026/HARDWARE-CAD/RobotDXF/LifeCam base.DXF

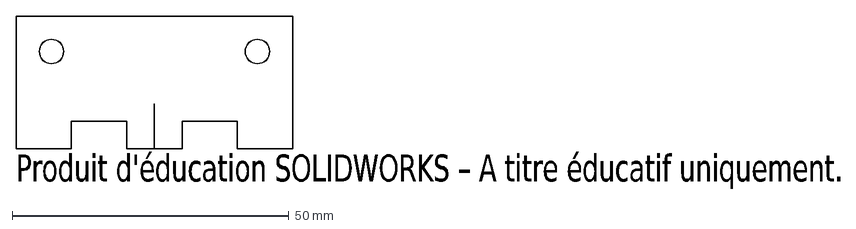
[picture p191: CAD file, 2026-11-01]
resources/INSATEURO2026/HARDWARE-CAD/RobotDXF/LifeCam base.DXF
Produit d'éducation SOLIDWORKS – A titre éducatif uniquement.
