EUROBOT-27/MECANIQUE/resources/Aero Euro/NINJA_MECANIQUE/base ninga bl n20.SLDPRT

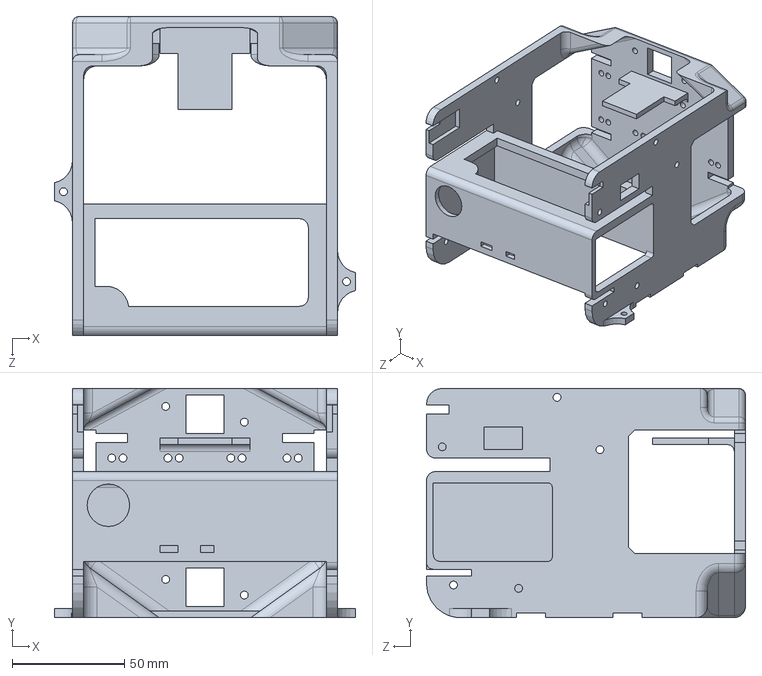
[picture p192: CAD file, 2026-11-01]
resources/Aero Euro/NINJA_MECANIQUE/base ninga bl n20.SLDPRT
134.0 x 102.0 x 142.0 mm
