EUROBOT-27/MECANIQUE/resources/Aero Euro/NINJA_MECANIQUE/regulator HW-411 big.SLDPRT

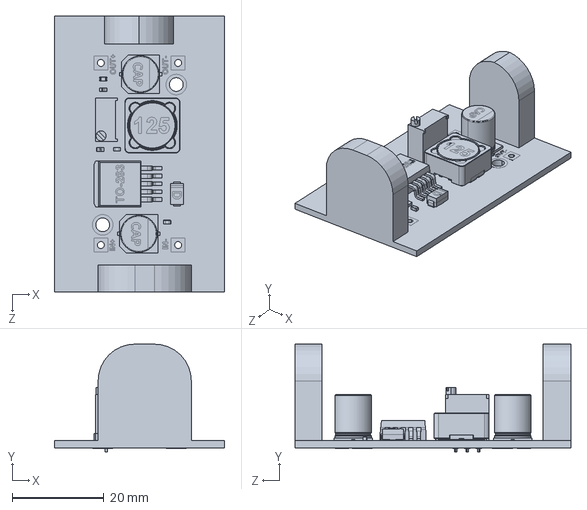
[picture p194: CAD file, 2026-11-01]
resources/Aero Euro/NINJA_MECANIQUE/regulator HW-411 big.SLDPRT
37.0 x 23.4 x 60.0 mm
