EUROBOT-27/MECANIQUE/resources/INSATEURO2026/HARDWARE-CAD/PowerBankRaspberry.SLDPRT

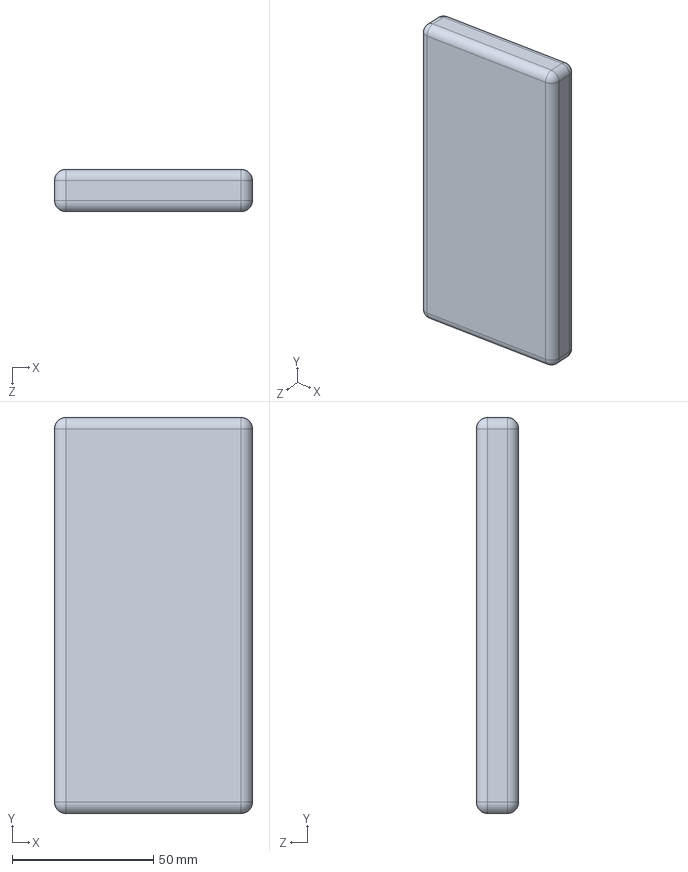
[picture p195: CAD file, 2026-11-01]
resources/INSATEURO2026/HARDWARE-CAD/PowerBankRaspberry.SLDPRT
70.0 x 140.0 x 15.0 mm
