EUROBOT-27/MECANIQUE/resources/Aero Euro/NINJA_MECANIQUE/urgence b.SLDPRT

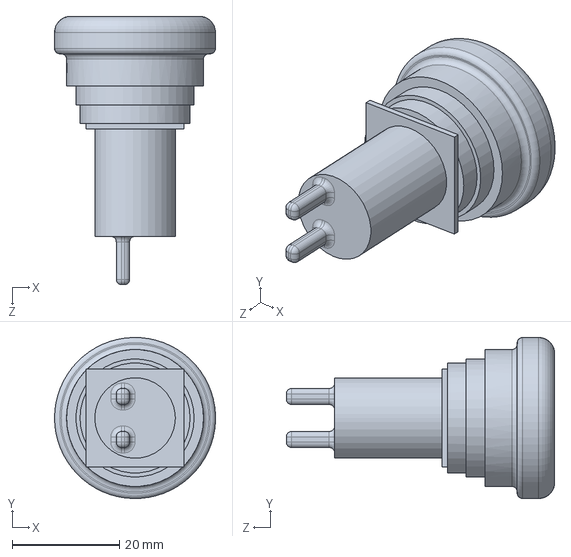
[picture p198: CAD file, 2026-11-01]
resources/Aero Euro/NINJA_MECANIQUE/urgence b.SLDPRT
30.0 x 30.0 x 50.0 mm
