EUROBOT-27/MECANIQUE/resources/INSATEURO2026/HARDWARE-CAD/Pendule.SLDPRT

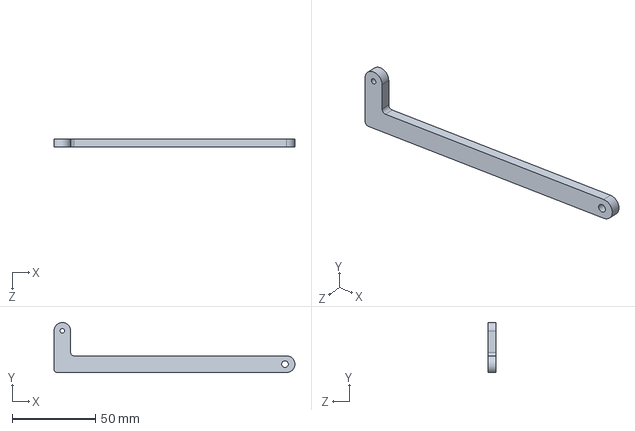
[picture p199: CAD file, 2026-11-01]
resources/INSATEURO2026/HARDWARE-CAD/Pendule.SLDPRT
144.5 x 30.0 x 5.00 mm
