EUROBOT-27/MECANIQUE/resources/Aero Euro/NINJA_MECANIQUE/support elecvanne 4.0 symetrie.SLDPRT

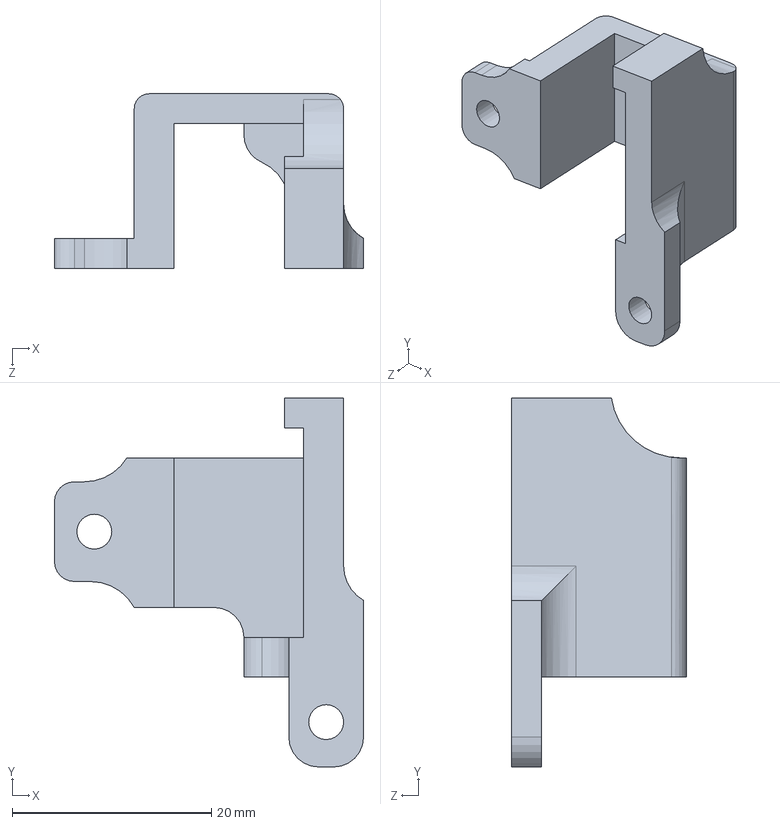
[picture p201: CAD file, 2026-11-01]
resources/Aero Euro/NINJA_MECANIQUE/support elecvanne 4.0 symetrie.SLDPRT
31.0 x 37.0 x 17.5 mm
