EUROBOT-27/MECANIQUE/resources/INSATEURO2026/HARDWARE-CAD/Base.SLDPRT

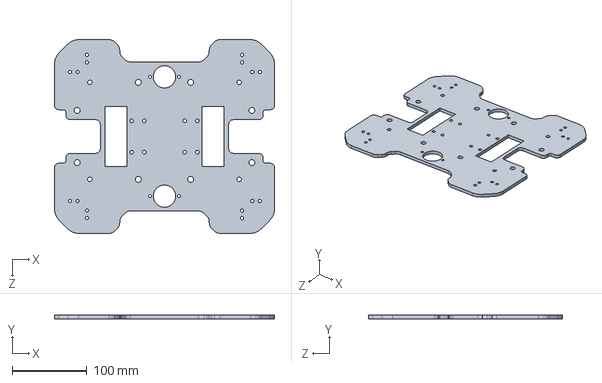
[picture p202: CAD file, 2026-11-01]
resources/INSATEURO2026/HARDWARE-CAD/Base.SLDPRT
295.0 x 5.00 x 260.0 mm
