EUROBOT-27/MECANIQUE/resources/Aero Euro/NINJA_MECANIQUE/pneumatic fitting 90 deg small steel.SLDPRT

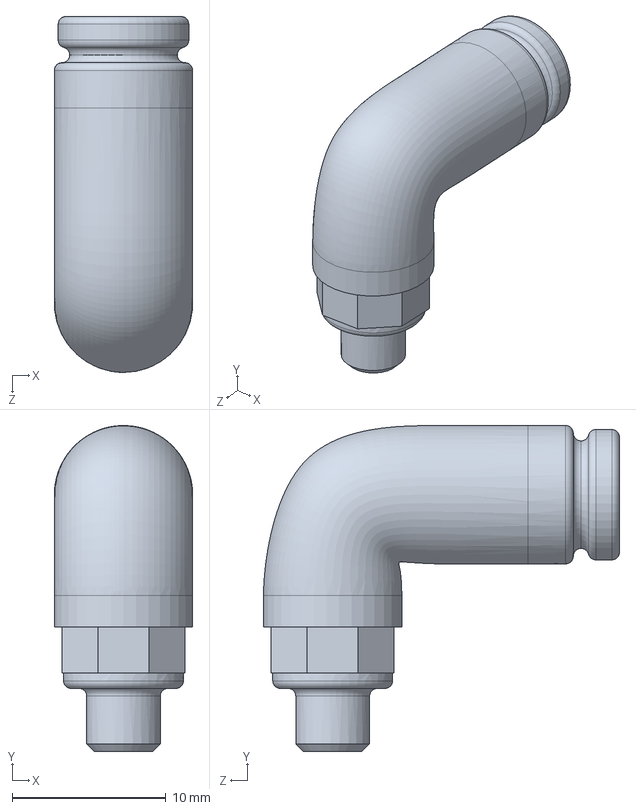
[picture p203: CAD file, 2026-11-01]
resources/Aero Euro/NINJA_MECANIQUE/pneumatic fitting 90 deg small steel.SLDPRT
9.00 x 21.2 x 23.2 mm
