EUROBOT-27/MECANIQUE/resources/Aero Euro/NINJA_MECANIQUE/suction cup + 90 deg fitting.SLDASM

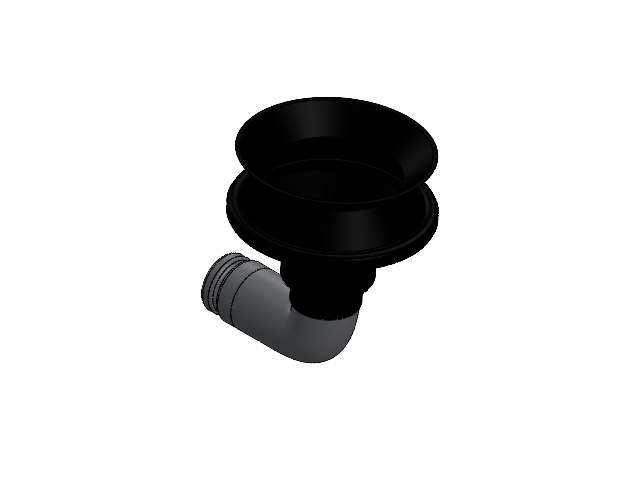
[picture p204: CAD file, 2026-11-01]
resources/Aero Euro/NINJA_MECANIQUE/suction cup + 90 deg fitting.SLDASM
suction cup B25
pneumatic fitting 90 deg small steel
