EUROBOT-27/MECANIQUE/resources/Aero Euro/NINJA_MECANIQUE/Assem sys4.0 ninja.SLDASM

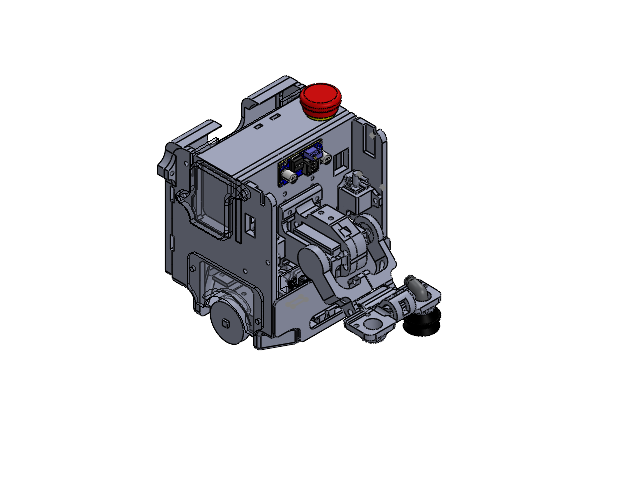
[picture p205: CAD file, 2026-11-01]
resources/Aero Euro/NINJA_MECANIQUE/Assem sys4.0 ninja.SLDASM
electric valve mini12 V x 2
regulator HW-411 mini
urgence b
hit wst mdf 4.0
part servo head
part roulement
suction cup B25
pneumatic fitting 90 deg small steel
support fantouz sys 2.2 try 3.0
servo TIANKONGRC 30KG
support servo 3.1
support final detail
3ejla sys 4.0 x 2
base ninga bl n20
regulator HW-411 big
NEMA17 braket
wall sheild 2.7
lipo + lipo safe
pompe mini x 2
pneumatic fitting 90 deg 4mm x 2
koura scrolla x 2
Part1 scrolla x 2
back 4.0
beb battery
support elecvanne 4.0
khta el scrolla 4.0
support n20 sys4.0
support elecvanne 4.0 symetrie
3ejlla 4.0
space cover
cover
