EUROBOT-27/MECANIQUE/resources/Aero Euro/NINJA_MECANIQUE/sys 2.2 assem.SLDASM

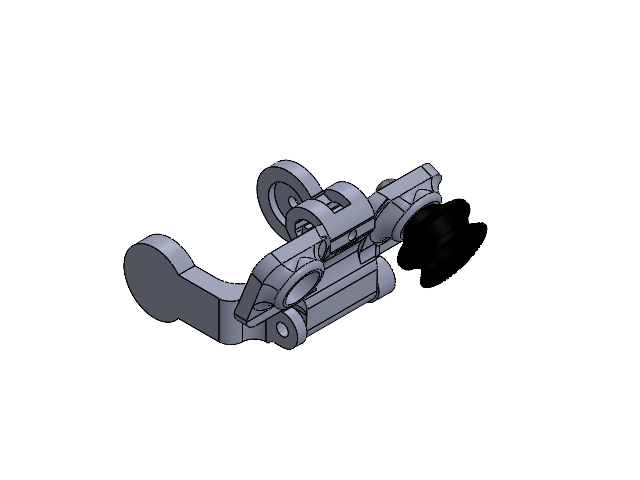
[picture p206: CAD file, 2026-11-01]
resources/Aero Euro/NINJA_MECANIQUE/sys 2.2 assem.SLDASM
part servo head
part roulement
suction cup B25
pneumatic fitting 90 deg small steel
support fantouz sys 2.2 try 3.0
