EUROBOT-27/MECANIQUE/resources/Aero Euro/NINJA_MECANIQUE/pami ninga 3.0.SLDASM

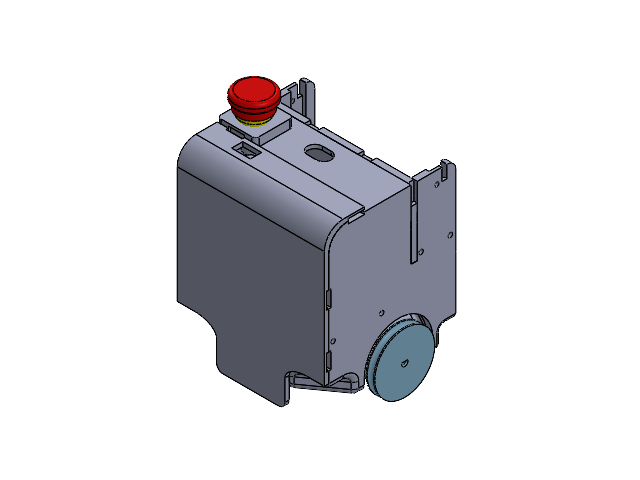
[picture p207: CAD file, 2026-11-01]
resources/Aero Euro/NINJA_MECANIQUE/pami ninga 3.0.SLDASM
base ninga
b urgence
coude 4-4-6 sys2.2
electric valve Fa0520F 12 V
JST_XH_B2B-XH-A_1x02_P2.50mm_Vertical_3.step x 3
C_Radial_D6.3mm_H5.0mm_P2.50mm_3.step x 3
PinHeader_1x06_P2.54mm_Vertical_3.step x 2
PinSocket_1x19_P2.54mm_Vertical_3.step x 2
DIP-4_W7.62mm_3.step
TO-220-3_Vertical_3.step x 3
LED_D4.0mm_1.step
PinSocket_1x08_P2.54mm_Vertical_3.step x 2
sheild esp pami ninja_PCB_3.step
pompe
roue new pami ninja 2.2
support electrovanne sys2.2
support pompe sys 2.2
hit wst mdf
lipo mini
DC-DC Voltage converter
back 3.0
