EUROBOT-27/MECANIQUE/resources/Aero Euro/NINJA_MECANIQUE/assem pamiiiii 2.2.SLDASM

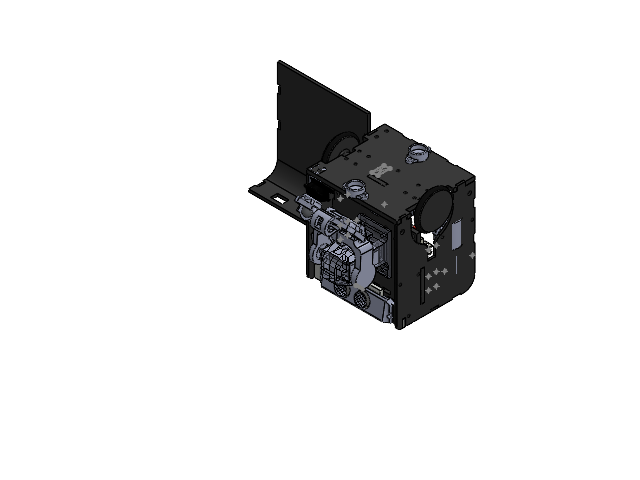
[picture p208: CAD file, 2026-11-01]
resources/Aero Euro/NINJA_MECANIQUE/assem pamiiiii 2.2.SLDASM
part servo head
part roulement
suction cup B25
pneumatic fitting 90 deg small steel
support fantouz sys 2.2 try 3.0
N20 Mini Micro Metall Gear Motor DC 3-6-12V v1 x 2
roue pami4 x 2
join roue x 2
TB6612FNG_Upper Pins
HC-SR04
RED x 2
servo TIANKONGRC 30KG
base sys2.2 finall base mdf
side1 x 2
hit wst mdf
support n20 sys2.2 x 2
pompe
support pompe sys 2.2
JST_XH_B2B-XH-A_1x02_P2.50mm_Vertical_3.step x 3
C_Radial_D6.3mm_H5.0mm_P2.50mm_3.step x 3
PinHeader_1x06_P2.54mm_Vertical_3.step x 2
PinSocket_1x19_P2.54mm_Vertical_3.step x 2
DIP-4_W7.62mm_3.step
TO-220-3_Vertical_3.step x 3
LED_D4.0mm_1.step
PinSocket_1x08_P2.54mm_Vertical_3.step x 2
sheild esp pami ninja_PCB_3.step
electric valve Fa0520F 12 V
lipo support sys2.2
b urgence
support b urgence sys 2.2
support ultrson sys2.2
support electrovanne sys2.2
coude 4-4-6 sys2.2
support tube midle hit
stah sys 2.2
stah pla sys 2.2
support bumper x 2
support cables
support ultrason 2 sys 2.2
support suport b urgencevsys 2.2
support coude sys 2.2
DC-DC Voltage converter
support head lipo
support l x 3
support servo 3.1
support final detail
support ultrson sys3.2
