EUROBOT-27/MECANIQUE/resources/Aero Euro/NINJA_MECANIQUE/scrolla.SLDASM

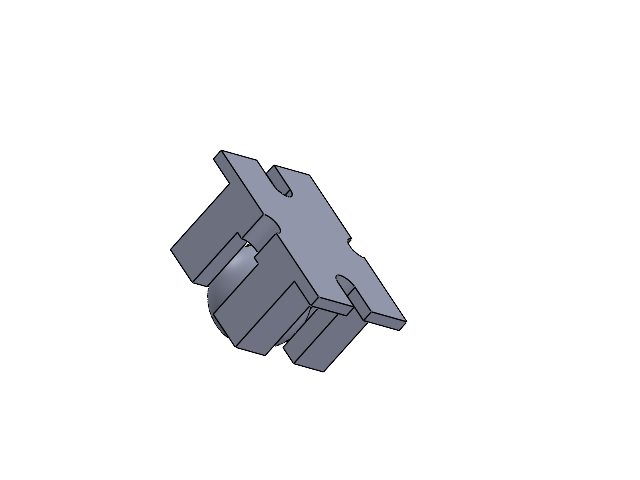
[picture p209: CAD file, 2026-11-01]
resources/Aero Euro/NINJA_MECANIQUE/scrolla.SLDASM
koura scrolla
Part1 scrolla
