EUROBOT-27/MECANIQUE/resources/Aero Euro/NINJA_MECANIQUE/assem sys final.SLDASM

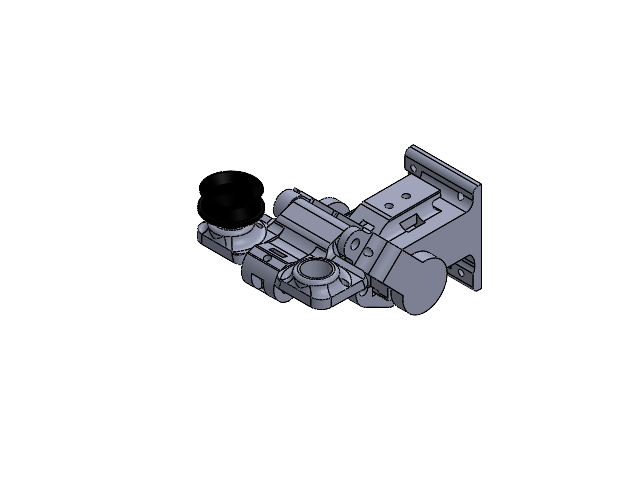
[picture p210: CAD file, 2026-11-01]
resources/Aero Euro/NINJA_MECANIQUE/assem sys final.SLDASM
part servo head
part roulement
suction cup B25
pneumatic fitting 90 deg small steel
support fantouz sys 2.2 try 3.0
servo TIANKONGRC 30KG
support servo 3.1
support final detail
