EUROBOT-27/MECANIQUE/(list of files, cad)

Other CAD files:
resources/INSATEURO2026/HARDWARE-CAD/AssemblageTotal.SLDASM
mechanical/clapets-v8/CAD_FC/STEP/MODULE_CLAPETS_V8.step
mechanical/resources/mg996r-servo-3.snapshot.9/mg996_arm_round.step
mechanical/resources/two-trees-bluer-v2-parts/eccentric_spacers_Y.step
mechanical/clapets-v8/CAD_FC/STEP/FIX_ECROU_ROUE_28T.step
mechanical/resources/mg996r-servo-3.snapshot.9/mg996R_v2.step
resources/INSATEURO2026/HARDWARE-CAD/Driver Motor de Passo 4A.stp.SLDPRT
mechanical/clapets-v8/CAD_FC/STEP/FIX_INSERT_SUPPORT_ECROU.step
mechanical/resources/mg996r-servo-3.snapshot.9/mg996_arms.FCStd
mechanical/resources/two-trees-bluer-v2-parts/m5_nyloc_nuts_Y.step
resources/CDR-2027/MCAD/mechanical-parts/generic-hardware.FCStd
mechanical/clapets-v8/CAD_FC/STEP/A_TRAVERSE_HAUT.step
mechanical/resources/mg996r-servo-3.snapshot.9/mg996_arm_6pad.step
resources/Aero Euro/LIDAR_EUROBOT/src/robot_description/meshes/wheel1.STL
mechanical/clapets-v8/CAD_FC/STEP/MODULE_B_TETE.step
mechanical/resources/mg996r-servo-3.snapshot.9/mg996_arm_2pad.step
mechanical/resources/two-trees-bluer-v2-parts/butterfly_plate.step
resources/Aero Euro/LIDAR_EUROBOT/src/robot_description/meshes/ball1.STL
mechanical/clapets-v8/CAD_FC/STEP/REF_PILE_3_PIERRES.step
mechanical/resources/mg996r-servo-3.snapshot.9/mg996_arm_4pad.step
mechanical/resources/two-trees-bluer-v2-parts/coupler_5x8.step
mechanical/clapets-v8/CAD_FC/STEP/REF_TIGE_GUIDE_D8.step
mechanical/resources/two-trees-bluer-v2-parts/v_wheels_Y.step
mechanical/clapets-v8/CAD_FC/STEP/A_SOCLE.step
mechanical/resources/two-trees-bluer-v2-parts/m5_spacers_Y.step
mechanical/clapets-v8/CAD_FC/STEP/FIX_VIS_PIGNON_PORTE.step
mechanical/resources/two-trees-bluer-v2-parts/nema17.step
resources/INSATEURO2026/HARDWARE-CAD/Back2.SLDPRT
mechanical/clapets-v8/CAD_FC/STEP/A_AILE_G.step
mechanical/resources/two-trees-bluer-v2-parts/rails_2020_Y.step
mechanical/clapets-v8/CAD_FC/STEP/REF_MG996R_G.step
mechanical/clapets-v8/CAD_FC/STEP/B_MANIVELLE_FRAPPE.step
mechanical/clapets-v8/CAD_FC/STEP/A_PLATINE_MOTEUR.step
mechanical/clapets-v8/CAD_FC/STEP/A_ENTRETOISE_608_BAS.step
mechanical/clapets-v8/CAD_FC/STEP/FIX_VIS_TETE_SERVO.step
mechanical/clapets-v8/CAD_FC/STEP/REF_ECROU_T8.step
mechanical/clapets-v8/CAD_FC/STEP/REF_VIS_T8.step
mechanical/clapets-v5/CAD_FC/MODULE_CLAPETS_V5.FCStd
mechanical/clapets-v5/CAD_FC/STEP/A_AILE_D.step
mechanical/clapets-v5/CAD_FC/STEP/A_AILE_G.step
mechanical/clapets-v5/CAD_FC/STEP/A_BRAS_PORTE_D_BAS.step
mechanical/clapets-v5/CAD_FC/STEP/A_BRAS_PORTE_D_HAUT.step
mechanical/clapets-v5/CAD_FC/STEP/A_BRAS_PORTE_G_BAS.step
mechanical/clapets-v5/CAD_FC/STEP/A_BRAS_PORTE_G_HAUT.step
mechanical/clapets-v5/CAD_FC/STEP/A_BRIDE_SERVO.step
mechanical/clapets-v5/CAD_FC/STEP/A_BRIDE_SERVO_D.step
mechanical/clapets-v5/CAD_FC/STEP/A_BRIDE_SERVO_G.step
mechanical/clapets-v5/CAD_FC/STEP/A_CAPOT_AILE_D.step
mechanical/clapets-v5/CAD_FC/STEP/A_CAPOT_AILE_G.step
mechanical/clapets-v5/CAD_FC/STEP/A_ENTRETOISE_608_BAS.step
mechanical/clapets-v5/CAD_FC/STEP/A_ENTRETOISE_608_HAUT.step
mechanical/clapets-v5/CAD_FC/STEP/A_PIGNON_PORTE_20T.step
mechanical/clapets-v5/CAD_FC/STEP/A_ROUE_PORTE_28T.step
mechanical/clapets-v5/CAD_FC/STEP/A_SOCLE.step
mechanical/clapets-v5/CAD_FC/STEP/A_SUPPORT_ECROU.step
mechanical/clapets-v5/CAD_FC/STEP/A_TOLE_PORTE.step
mechanical/clapets-v5/CAD_FC/STEP/A_TRAVERSE_HAUT.step
mechanical/clapets-v5/CAD_FC/STEP/B_BAGUE_STATION.step
mechanical/clapets-v5/CAD_FC/STEP/B_ENTRETOISE_TETE.step
mechanical/clapets-v5/CAD_FC/STEP/B_MOYEU_TETE_30T.step
mechanical/clapets-v5/CAD_FC/STEP/B_PIGNON_TETE_20T.step
mechanical/clapets-v5/CAD_FC/STEP/B_PLATEAU_TETE.step
mechanical/clapets-v5/CAD_FC/STEP/B_STATION_TPU.step
mechanical/clapets-v5/CAD_FC/STEP/B_SUPPORT_TETE.step
mechanical/clapets-v5/CAD_FC/STEP/MODULE_A_CLAPETS.step
mechanical/clapets-v5/CAD_FC/STEP/MODULE_B_TETE.step
mechanical/clapets-v5/CAD_FC/STEP/MODULE_CLAPETS_V5.step
mechanical/clapets-v5/CAD_FC/STEP/REF_608ZZ.step
mechanical/clapets-v5/CAD_FC/STEP/REF_608ZZ_TETE.step
mechanical/clapets-v5/CAD_FC/STEP/REF_AXE_TETE_D8.step
mechanical/clapets-v5/CAD_FC/STEP/REF_COUPLEUR_5x8.step
mechanical/clapets-v5/CAD_FC/STEP/REF_ECROU_T8.step
mechanical/clapets-v5/CAD_FC/STEP/REF_MG996R_D.step
mechanical/clapets-v5/CAD_FC/STEP/REF_MG996R_G.step
mechanical/clapets-v5/CAD_FC/STEP/REF_MG996R_TETE.step
mechanical/clapets-v5/CAD_FC/STEP/REF_MOUSSE_PORTE.step
mechanical/clapets-v5/CAD_FC/STEP/REF_NEMA17.step
mechanical/clapets-v5/CAD_FC/STEP/REF_PILE_3_PIERRES.step
mechanical/clapets-v5/CAD_FC/STEP/REF_PLAQUE_PAPILLON.step
mechanical/clapets-v5/CAD_FC/STEP/REF_RAIL_2020.step
mechanical/clapets-v5/CAD_FC/STEP/REF_ROUE_V.step
mechanical/clapets-v5/CAD_FC/STEP/REF_TIGE_PORTE_D8.step
mechanical/clapets-v5/CAD_FC/STEP/REF_VENTOUSE_DPS30.step
mechanical/clapets-v5/CAD_FC/STEP/REF_VIS_T8.step
mechanical/clapets-v5/CAD_FC/STL/A_AILE_D.stl
mechanical/clapets-v5/CAD_FC/STL/A_AILE_G.stl
mechanical/clapets-v5/CAD_FC/STL/A_BRIDE_SERVO_D.stl
mechanical/clapets-v5/CAD_FC/STL/A_BRIDE_SERVO_G.stl
mechanical/clapets-v5/CAD_FC/STL/A_PIGNON_PORTE_20T.stl
mechanical/clapets-v5/CAD_FC/STL/A_ROUE_PORTE_28T.stl
mechanical/clapets-v5/CAD_FC/STL/A_SOCLE.stl
mechanical/clapets-v5/CAD_FC/STL/A_SUPPORT_ECROU.stl
mechanical/clapets-v5/CAD_FC/STL/A_TRAVERSE_HAUT.stl
mechanical/clapets-v5/CAD_FC/STL/B_MOYEU_TETE_30T.stl
mechanical/clapets-v5/CAD_FC/STL/B_PIGNON_TETE_20T.stl
mechanical/clapets-v5/CAD_FC/STL/B_SUPPORT_TETE.stl
mechanical/clapets-v5/resources/mg996r/mg996R_v2.FCStd
mechanical/clapets-v5/resources/mg996r/mg996R_v2.step
mechanical/clapets-v5/resources/mg996r/mg996_arm_round.step
mechanical/clapets-v7/CAD_FC/DXF/A_TOLE_PORTE.dxf
mechanical/clapets-v7/CAD_FC/DXF/B_PLATEAU_TETE.dxf
mechanical/clapets-v7/CAD_FC/MODULE_CLAPETS_V7.FCStd
mechanical/clapets-v7/CAD_FC/STEP/A_AILE_D.step
mechanical/clapets-v7/CAD_FC/STEP/A_AILE_G.step
mechanical/clapets-v7/CAD_FC/STEP/A_BRAS_PORTE_D_BAS.step
mechanical/clapets-v7/CAD_FC/STEP/A_BRAS_PORTE_D_HAUT.step
mechanical/clapets-v7/CAD_FC/STEP/A_BRAS_PORTE_G_BAS.step
mechanical/clapets-v7/CAD_FC/STEP/A_BRAS_PORTE_G_HAUT.step
mechanical/clapets-v7/CAD_FC/STEP/A_CAPOT_AILE_D.step
mechanical/clapets-v7/CAD_FC/STEP/A_CAPOT_AILE_G.step
mechanical/clapets-v7/CAD_FC/STEP/A_ENTRETOISE_608_BAS.step
mechanical/clapets-v7/CAD_FC/STEP/A_ENTRETOISE_608_HAUT.step
mechanical/clapets-v7/CAD_FC/STEP/A_PIGNON_PORTE_20T.step
mechanical/clapets-v7/CAD_FC/STEP/A_PLATINE_MOTEUR.step
mechanical/clapets-v7/CAD_FC/STEP/A_ROUE_PORTE_28T.step
mechanical/clapets-v7/CAD_FC/STEP/A_SOCLE.step
mechanical/clapets-v7/CAD_FC/STEP/A_SUPPORT_ECROU.step
mechanical/clapets-v7/CAD_FC/STEP/A_TOLE_PORTE.step
mechanical/clapets-v7/CAD_FC/STEP/A_TRAVERSE_HAUT.step
mechanical/clapets-v7/CAD_FC/STEP/B_BAGUE_STATION.step
mechanical/clapets-v7/CAD_FC/STEP/B_ENTRETOISE_TETE.step
mechanical/clapets-v7/CAD_FC/STEP/B_MOYEU_TETE_30T.step
mechanical/clapets-v7/CAD_FC/STEP/B_PIGNON_TETE_20T.step
mechanical/clapets-v7/CAD_FC/STEP/B_PLATEAU_TETE.step
mechanical/clapets-v7/CAD_FC/STEP/B_STATION_TPU.step
mechanical/clapets-v7/CAD_FC/STEP/B_SUPPORT_TETE.step
mechanical/clapets-v7/CAD_FC/STEP/FIX_ECROU_AILE_D.step
mechanical/clapets-v7/CAD_FC/STEP/FIX_ECROU_AILE_G.step
mechanical/clapets-v7/CAD_FC/STEP/FIX_ECROU_BRAS_D.step
mechanical/clapets-v7/CAD_FC/STEP/FIX_ECROU_BRAS_G.step
mechanical/clapets-v7/CAD_FC/STEP/FIX_ECROU_ROUES.step
mechanical/clapets-v7/CAD_FC/STEP/FIX_ECROU_ROUE_28T.step
mechanical/clapets-v7/CAD_FC/STEP/FIX_ECROU_STATION_EXT.step
mechanical/clapets-v7/CAD_FC/STEP/FIX_ECROU_STATION_MIL.step
mechanical/clapets-v7/CAD_FC/STEP/FIX_ECROU_TETE_MOYEU.step
mechanical/clapets-v7/CAD_FC/STEP/FIX_ECROU_TETE_SERVO.step
mechanical/clapets-v7/CAD_FC/STEP/FIX_INSERT_AILE_D.step
mechanical/clapets-v7/CAD_FC/STEP/FIX_INSERT_AILE_G.step
mechanical/clapets-v7/CAD_FC/STEP/FIX_INSERT_SOCLE.step
mechanical/clapets-v7/CAD_FC/STEP/FIX_INSERT_SUPPORT_ECROU.step
mechanical/clapets-v7/CAD_FC/STEP/FIX_TNUT_RAILS.step
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
