EUROBOT-27/MECANIQUE/resources/INSATEURO2026/Electrique/Mecanisme Manual Debug tool/Mecanisme Remote Control.html

# ESP32 Maestro BLE Console

Manual control for Pololu Mini Maestro over BLE UART

disconnected

Connection

Connect Disconnect Reset Maestro Copy log Clear log

Device name

BLE: checking...

Last status

waiting for device...

No errors yet.

Quick actions

Pump: OFF Soulevement Rotation Extension

Commands: pump toggle | pose lift | pose rot | seq ext (lift -> rot -> ext)

Quality controls

Auto send while sliding Haptics on send Step deg Send delay ms

Channels to show

Select which servo controls appear below.

Servo controls

Sequences

Saved Name New sequence Save sequence Delete sequence Export Import

Pose library

Saved pose Add saved pose

Name Save current pose Apply to sliders Delete pose

No pose selected.

Add steps

Pose duration ms Add current pose

Delay ms Add delay

Command Add command

Sequence steps

Play sequence Stop

Captures only the currently selected channels.
