EUROBOT-27/MECANIQUE/resources/INSATEURO2026/Electrique/Mecanisme Manual Debug tool/MecanismeController/index.html

# Mechanism Control

Maestro Servo + Stepper + Pump Control

disconnected

Connection

Connect Disconnect STOP ALL

Device name

BLE: checking...

Last status

waiting for device...

No errors yet.

Mechanism Actions

Pump Control

Pump Only: OFF

Stepper Rail

RESET 0 Go Zero Pickup (2000) Drop (4000)

Rail Position 0 steps

-500 - + +500

STOP

Manual Set: Go

MCP Control (6 Suckers)

Test Sequence

Control Settings

Auto send Servos Haptics Step deg BLE Delay

Channels to show

Servo controls

Sequences (Servo Only)

Saved Name New Save Delete Export Import

Add Step

Saved pose Add Pose

Capture Current Duration

Delay Add Delay

Command Add Cmd

Pose Management

Save Apply Del

No pose selected.

Sequence Steps

Play Sequence Stop
