EUROBOT-27/MECANIQUE/resources/INSATEURO2026/Euro_vision/camera_calibration_folder/calibration/chessboard_pattern.png

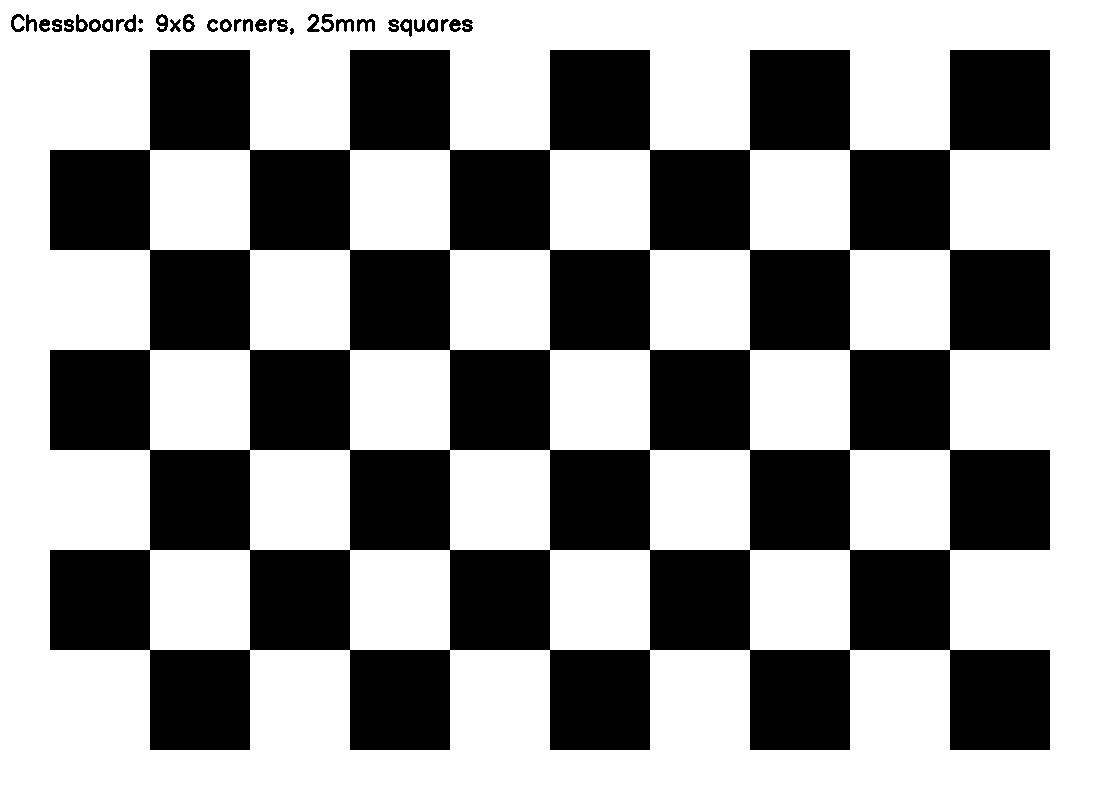
resources/INSATEURO2026/Euro_vision/camera_calibration_folder/calibration/chessboard_pattern.png
