EUROBOT-27/MECANIQUE/resources/INSATEURO2026/Electrique/Carte Finale JLCPCB/V2/Actionneur V2/Printing/Actionneur-F_Cu.pdf

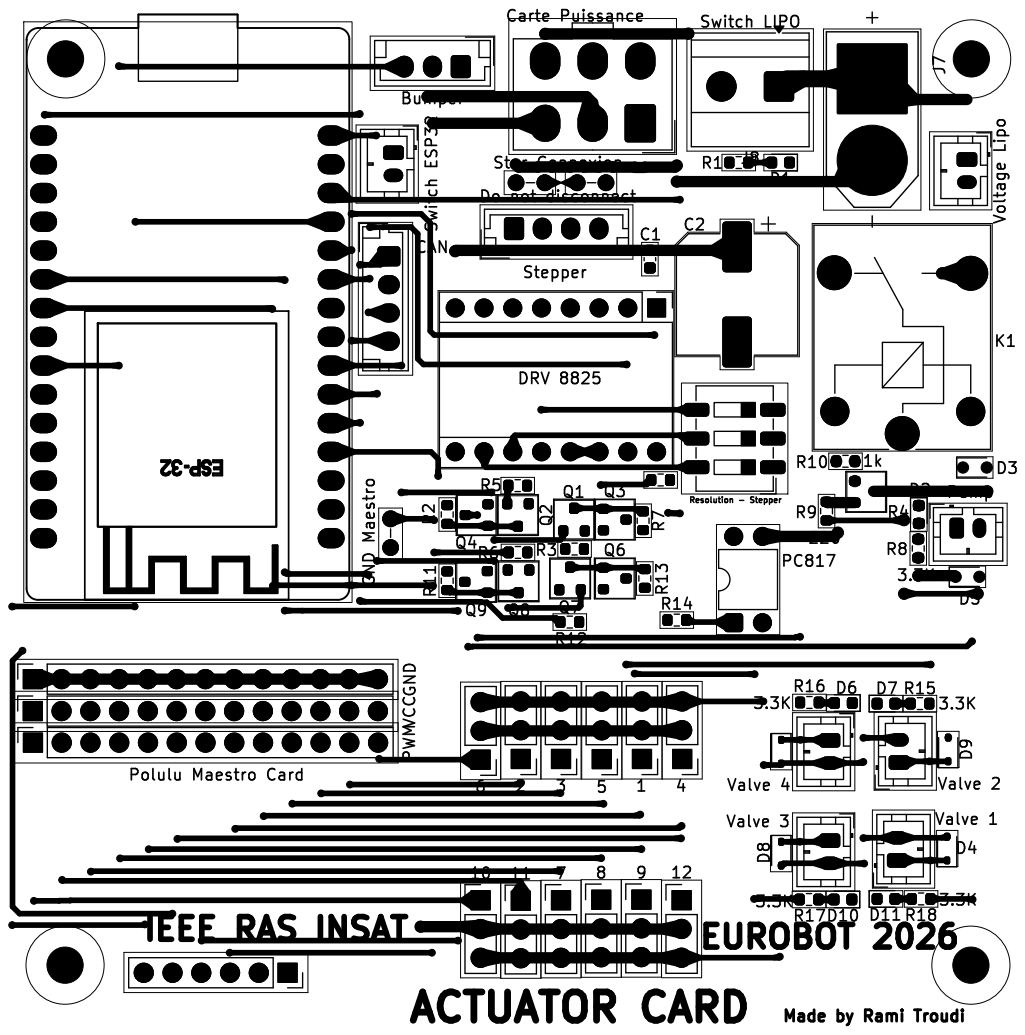
[picture p217: page 1]

Do not disconnect GND PWMVCC

ACTUATOR CARD Made by Rami Troudi
