EUROBOT-27/MECANIQUE/Docs/accessoire_FINAL_v3.pdf

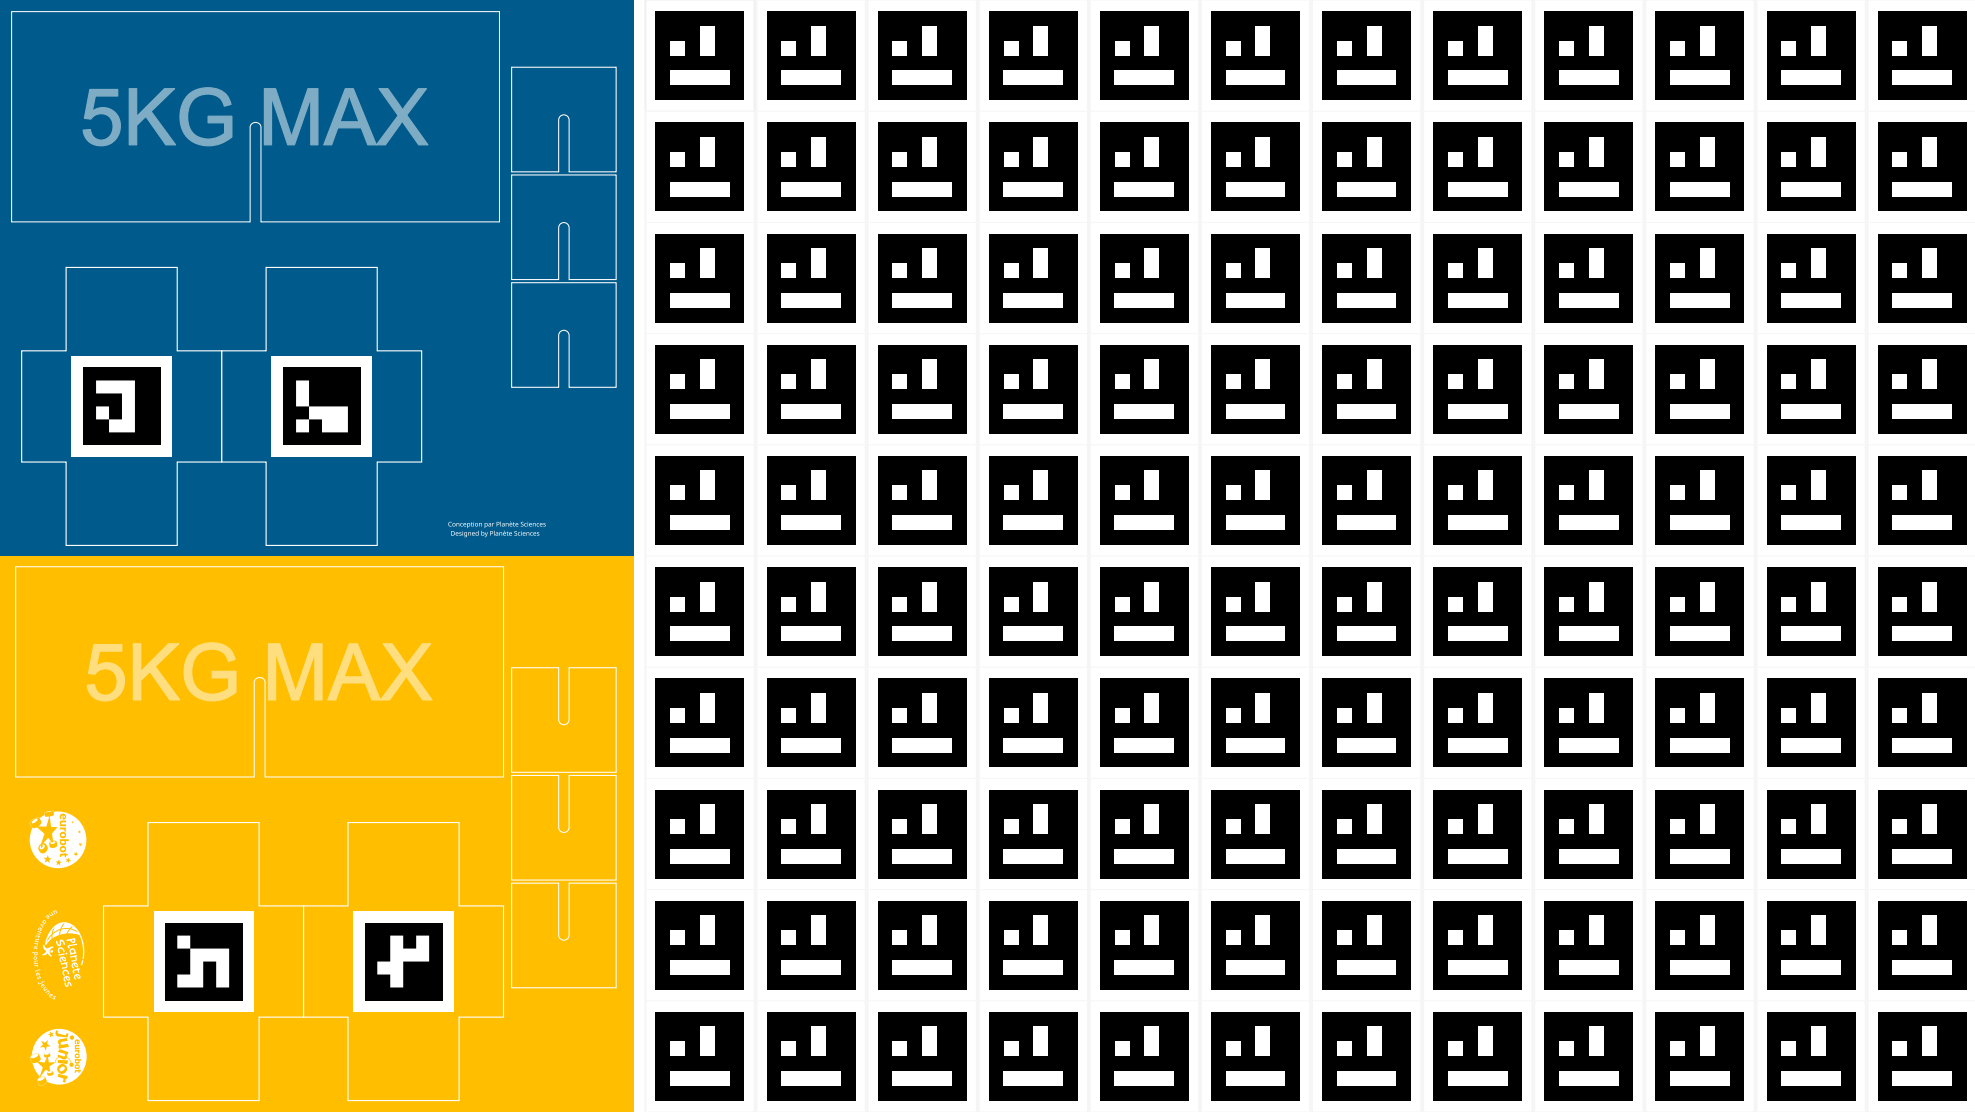
[picture p218: page 1]
