EUROBOT-27/MECANIQUE/resources/INSATEURO2026/Electrique/PAMIS/Carte Tayssir Temp/Carte Test Tayssir-Edge_Cuts.pdf

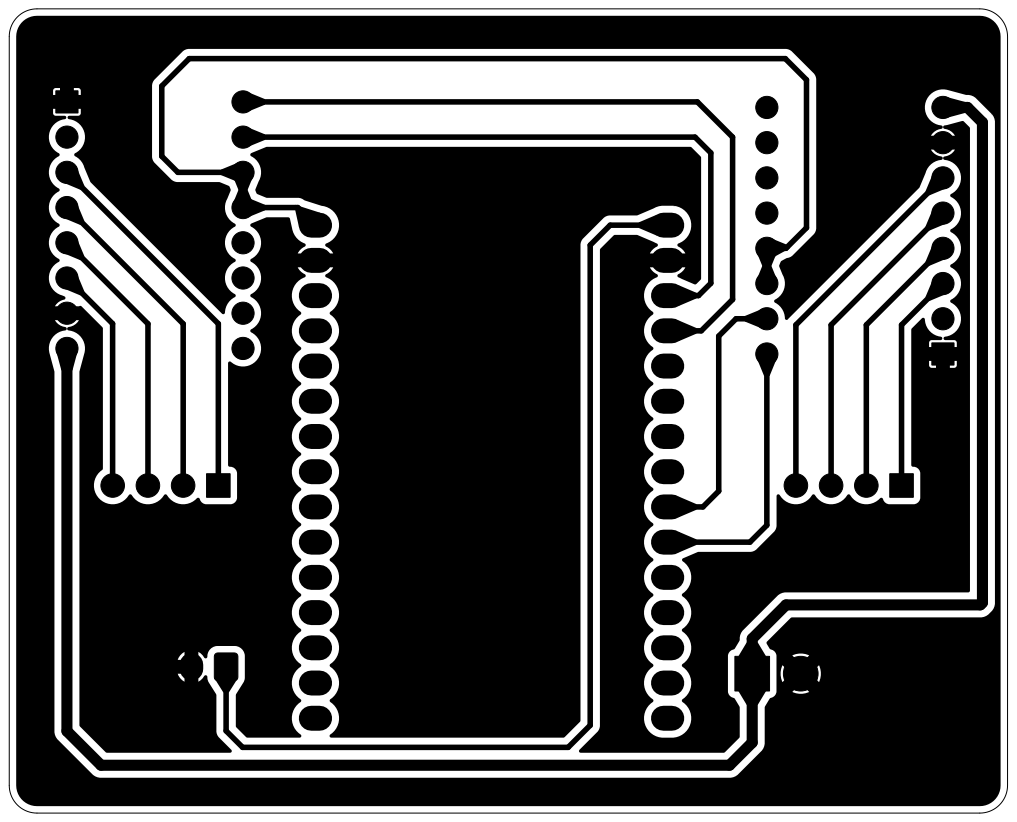
[picture p219: page 1]
