EUROBOT-27/MECANIQUE/resources/INSATEURO2026/Electrique/Actionneur PCB/Actionneur/Actionneur-F_Cu.pdf

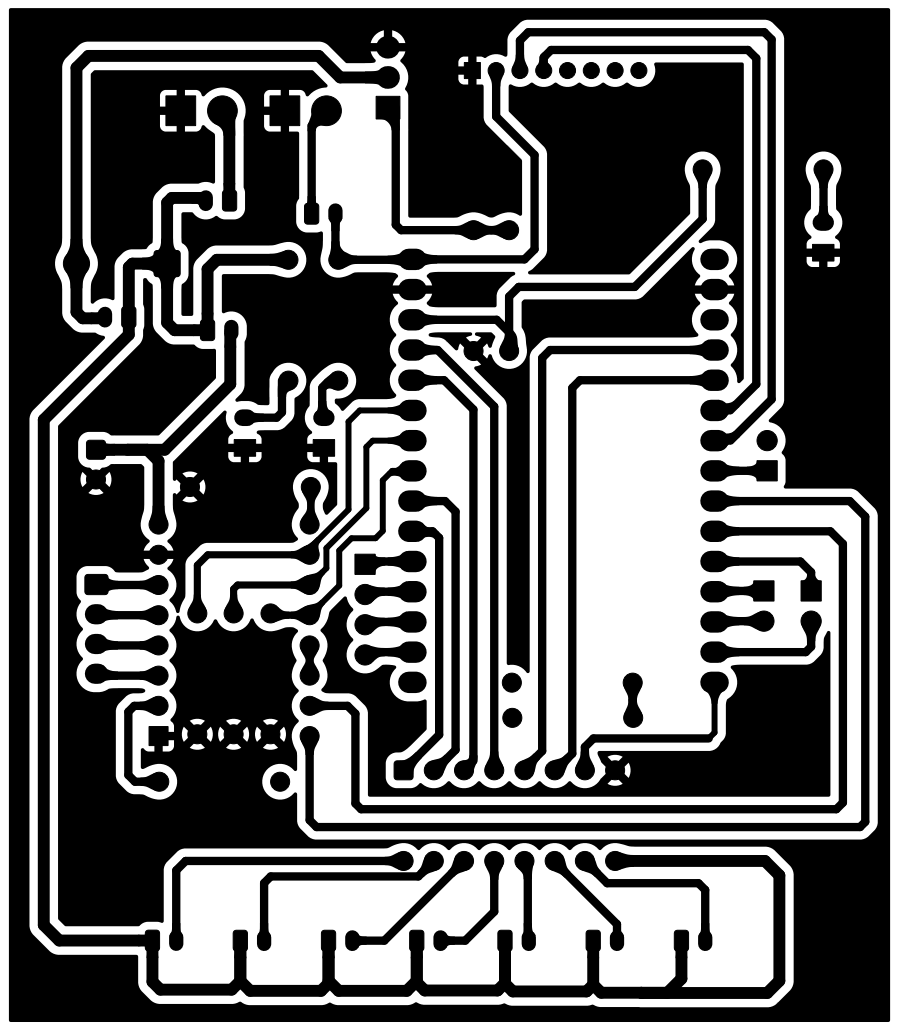
[picture p220: page 1]
