EUROBOT-27/MECANIQUE/resources/INSATEURO2026/Electrique/PAMIS/PAMI Stepper/PAMI Stepper-F_Cu.pdf

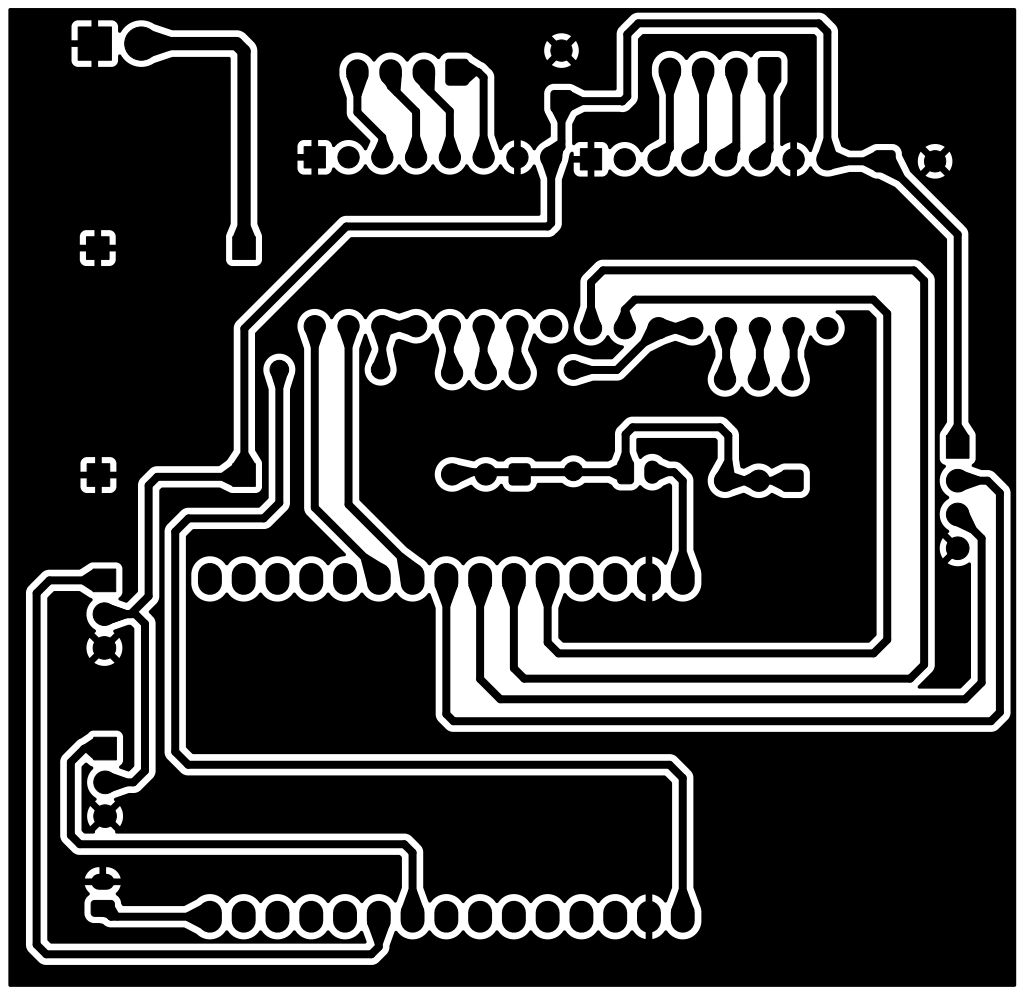
[picture p221: page 1]
