EUROBOT-27/MECANIQUE/resources/INSATEURO2026/Electrique/Carte Finale JLCPCB/V2/Puissance/Puissance-B_Cu.pdf

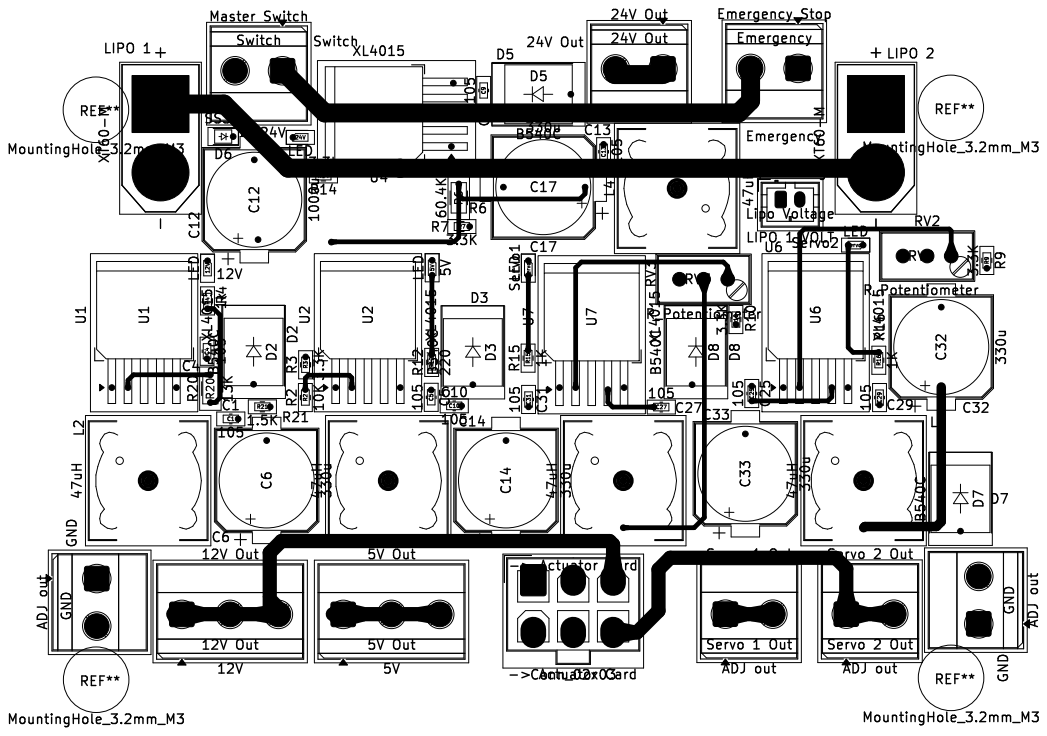
[picture p222: page 1]
