EUROBOT-27/MECANIQUE/resources/INSATEURO2026/Electrique/Carte Finale JLCPCB/V2/Puissance/Puissance-F_Cu.pdf

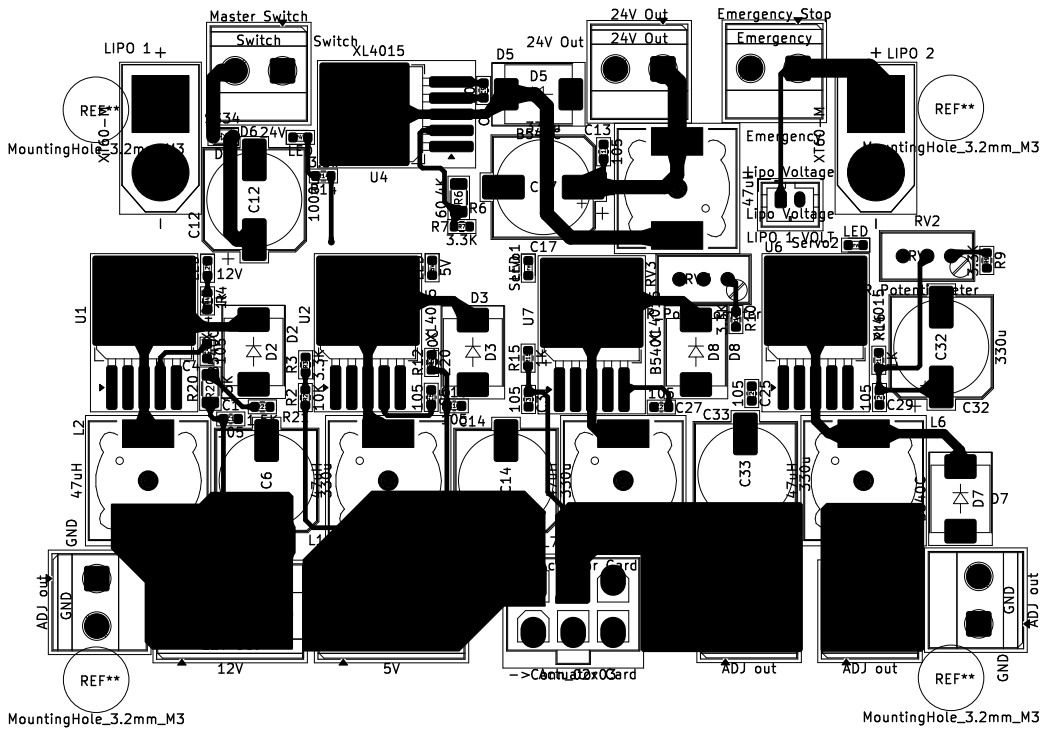
[picture p223: page 1]
