EUROBOT-27/MECANIQUE/(list of files, drawings)

Other design files:
resources/INSATEURO2026/Electrique/PAMIS/Carte Tayssir Temp/freerouting.dsn
resources/INSATEURO2026/Electrique/PAMIS/Carte Tayssir Temp/temp-freerouting.dsn
resources/INSATEURO2026/Electrique/PAMIS/Pami n20 V2/freerouting.dsn
resources/INSATEURO2026/Electrique/PAMIS/Pami n20 V2/temp-freerouting.dsn
