EUROBOT-27/MECANIQUE/resources/INSATEURO2026/Electrique/Carte Finale JLCPCB/V2/Actionneur/Actionneur.kicad_pcb

## KiCad design resources/INSATEURO2026/Electrique/Carte Finale JLCPCB/V2/Actionneur/Actionneur.kicad_pcb (2026-11-01)

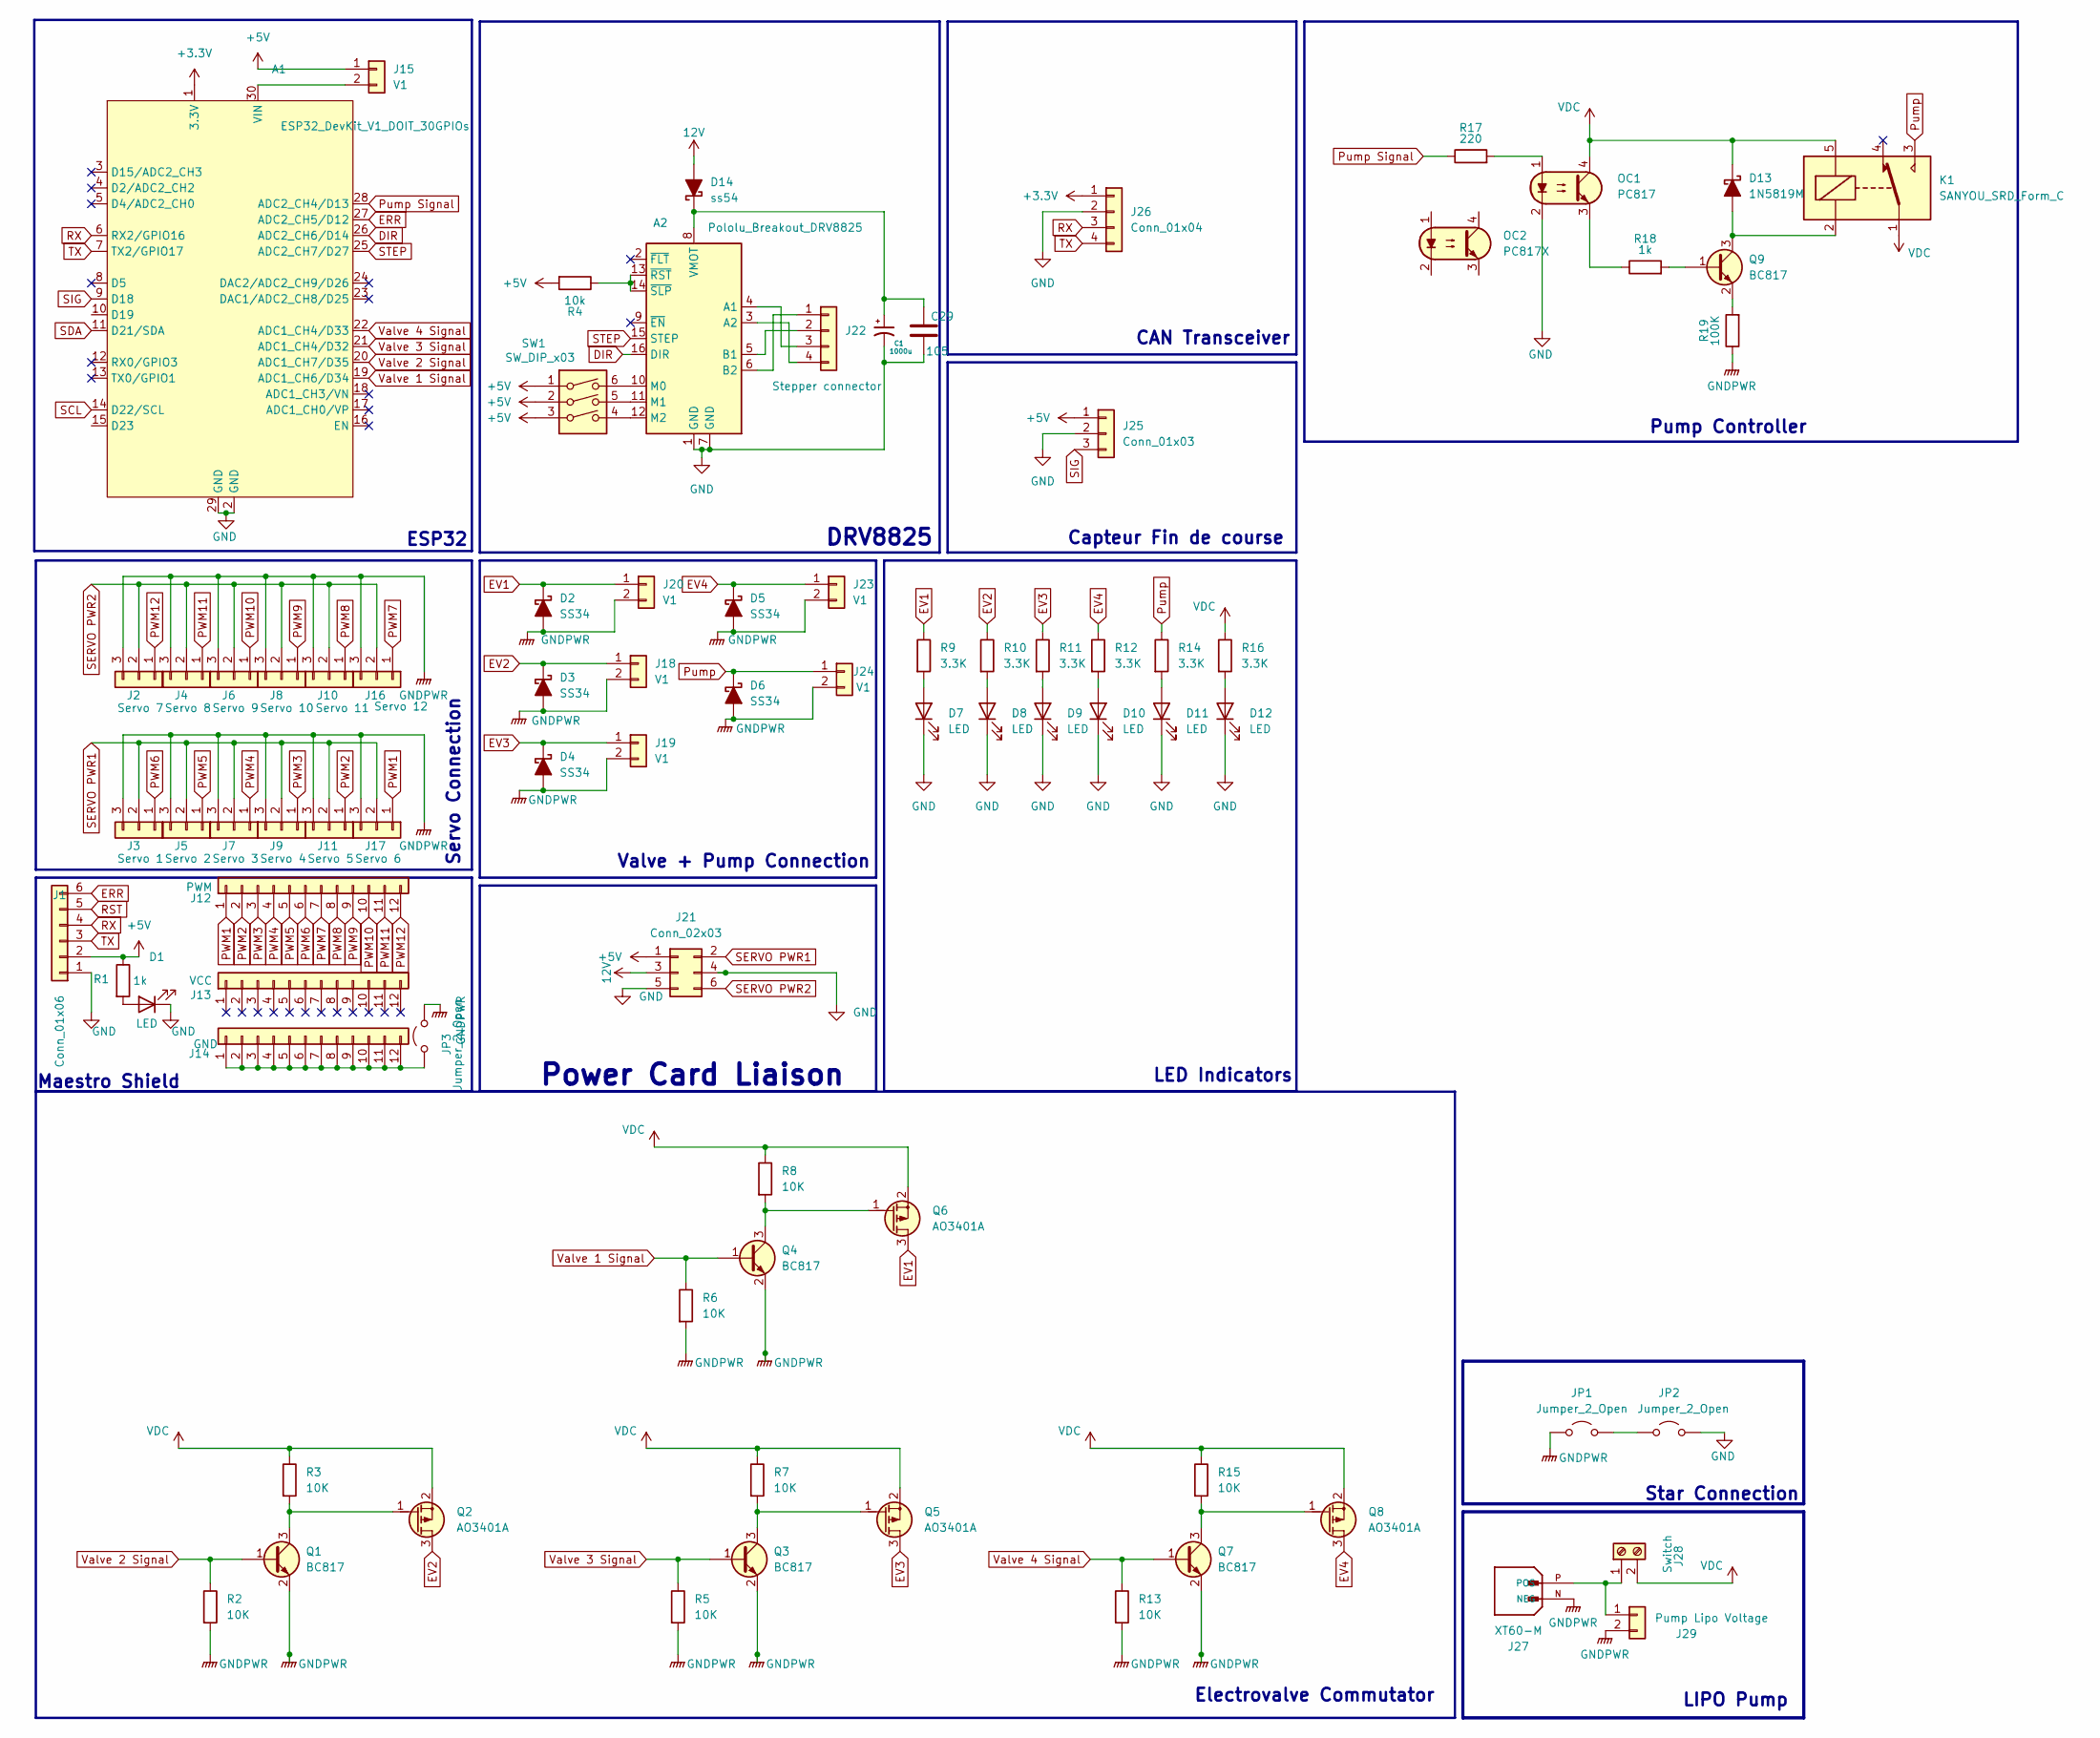
[picture p224: schematic Actionneur.kicad_sch]

Parts:
A1: ESP32_DevKit_V1_DOIT_30GPIOs; DOIT_ESP32_DEVKIT_30Pins
A2: Pololu_Breakout_DRV8825; Pololu_Breakout-16_15.2x20.3mm
C1: 1000u; CP_Elec_10x10.5
C29: 105; C_0603_1608Metric
D1, D7, D8, D9, D10, D11, D12: LED; LED_0603_1608Metric
D2, D3, D4, D5, D6: SS34; D_SOD-323
D13: 1N5819M; D_SMC
D14: ss54; D_SOD-323
J1: Conn_01x06; PinSocket_1x06_P2.54mm_Vertical
J2: Servo 7; PinHeader_1x03_P2.54mm_Vertical
J3: Servo 1; PinHeader_1x03_P2.54mm_Vertical
J4: Servo 8; PinHeader_1x03_P2.54mm_Vertical
J5: Servo 2; PinHeader_1x03_P2.54mm_Vertical
J6: Servo 9; PinHeader_1x03_P2.54mm_Vertical
J7: Servo 3; PinHeader_1x03_P2.54mm_Vertical
J8: Servo 10; PinHeader_1x03_P2.54mm_Vertical
J9: Servo 4; PinHeader_1x03_P2.54mm_Vertical
J10: Servo 11; PinHeader_1x03_P2.54mm_Vertical
J11: Servo 5; PinHeader_1x03_P2.54mm_Vertical
J12: PWM; PinSocket_1x12_P2.54mm_Vertical
J13: VCC; PinSocket_1x12_P2.54mm_Vertical
J14: GND; PinSocket_1x12_P2.54mm_Vertical
J15, J18, J19, J20, J23, J24: V1; JST_PH_B2B-PH-K_1x02_P2.00mm_Vertical
J16: Servo 12; PinHeader_1x03_P2.54mm_Vertical
J17: Servo 6; PinHeader_1x03_P2.54mm_Vertical
J21: Conn_02x03; Molex_Mini-Fit_Jr_5566-06A_2x03_P4.20mm_Vertical
J22: Stepper connector; JST_EH_B4B-EH-A_1x04_P2.50mm_Vertical
J25: Conn_01x03; JST_EH_B3B-EH-A_1x03_P2.50mm_Vertical
J26: Conn_01x04; JST_EH_B4B-EH-A_1x04_P2.50mm_Vertical
J27: XT60-M; AMASS_XT60-M; PARTREV V1.2
J28: Switch; TerminalBlock_Phoenix_MKDS-1,5-2-5.08_1x02_P5.08mm_Horizont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
J29: Pump Lipo Voltage; JST_PH_B2B-PH-K_1x02_P2.00mm_Vertical
JP1, JP2, JP3: Jumper_2_Open; Jumper_P2.54mm_D0.7mm
K1: SANYOU_SRD_Form_C; Relay_SPDT_SANYOU_SRD_Series_Form_C
OC1: PC817; Vishay_CNY64
OC2: PC817X; DIP-4_W7.62mm_LongPads
Q1, Q3, Q4, Q7, Q9: BC817; SOT-23
Q2, Q5, Q6, Q8: AO3401A; SOT-23
R1, R18: 1k; R_0603_1608Metric
R2, R3, R5, R6, R7, R8, R13, R15: 10K; R_0603_1608Metric
R4: 10k; R_0603_1608Metric
R9, R10, R11, R12, R14, R16: 3.3K; R_0603_1608Metric
R17: 220; R_0603_1608Metric
R19: 100K; R_0603_1608Metric
SW1: SW_DIP_x03; SW_DIP_SPSTx03_Slide_6.7x9.18mm_W6.73mm_P2.54mm_LowProfile_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

Connections:
12V: D14.2 (A), J21.3
+3.3V: A1.1 (3.3V), J26.1
+5V: J1.2, J15.1, J21.1, J25.1, R1.1, R4.2, SW1.1, SW1.2, SW1.3
Alt Pump: K1.4
DIR: A1.26 (ADC2_CH6/D14), A2.16 (DIR)
ERR: A1.27 (ADC2_CH5/D12), J1.6
EV1: D2.1 (K), J20.1, Q6.3 (D), R9.1
EV2: D3.1 (K), J18.1, Q2.3 (D), R10.1
EV3: D4.1 (K), J19.1, Q5.3 (D), R11.1
EV4: D5.1 (K), J23.1, Q8.3 (D), R12.1
GND: A1.2 (GND), A1.29 (GND), A2.1 (GND), A2.7 (GND), C1.2, C29.2, D1.1 (K), D7.1 (K), D8.1 (K), D9.1 (K), D10.1 (K), D11.1 (K), D12.1 (K), J1.1, J21.4, J21.5, J25.2, J26.2, JP2.2 (B), OC1.2
GNDPWR: D2.2 (A), D3.2 (A), D4.2 (A), D5.2 (A), D6.2 (A), J2.3, J3.3, J4.3, J5.3, J6.3, J7.3, J8.3, J9.3, J10.3, J11.3, J16.3, J17.3, J18.2, J19.2, J20.2, J23.2, J24.2, J27.N (NEG), J29.2, JP1.1 (A), JP3.2 (B), Q1.2 (E), Q3.2 (E), Q4.2 (E), Q7.2 (E), R2.2, R5.2, R6.2, R13.2, R19.1
unnamed: A1.30 (VIN), J15.2
unnamed: A2.4 (A1), J22.3
unnamed: A2.3 (A2), J22.4
unnamed: A2.5 (B1), J22.2
unnamed: A2.6 (B2), J22.1
unnamed: A2.10 (M0), SW1.6
unnamed: A2.11 (M1), SW1.5
unnamed: A2.12 (M2), SW1.4
unnamed: A2.8 (VMOT), C1.1, C29.1, D14.1 (K)
unnamed: A2.13 (~RST), A2.14 (~SLP), R4.1
unnamed: D1.2 (A), R1.2
unnamed: D7.2 (A), R9.2
unnamed: D8.2 (A), R10.2
unnamed: D9.2 (A), R11.2
unnamed: D10.2 (A), R12.2
unnamed: D11.2 (A), R14.2
unnamed: D12.2 (A), R16.2
unnamed: D13.2 (A), K1.2, Q9.3 (C)
unnamed: J14.1, J14.2, J14.3, J14.4, J14.5, J14.6, J14.7, J14.8, J14.9, J14.10, J14.11, J14.12, JP3.1 (A)
unnamed: J27.P (POS), J28.1, J29.1
unnamed: JP1.2 (B), JP2.1 (A)
unnamed: OC1.1, R17.2
unnamed: OC1.3, R18.1
unnamed: Q1.3 (C), Q2.1 (G), R3.2
unnamed: Q3.3 (C), Q5.1 (G), R7.2
unnamed: Q4.3 (C), Q6.1 (G), R8.2
unnamed: Q7.3 (C), Q8.1 (G), R15.2
unnamed: Q9.1 (B), R18.2
unnamed: Q9.2 (E), R19.2
PWM1: J12.1, J17.1
PWM2: J11.1, J12.2
PWM3: J9.1, J12.3
PWM4: J7.1, J12.4
PWM5: J5.1, J12.5
PWM6: J3.1, J12.6
PWM7: J12.7, J16.1
PWM8: J10.1, J12.8
PWM9: J8.1, J12.9
PWM10: J6.1, J12.10
PWM11: J4.1, J12.11
PWM12: J2.1, J12.12
Pump: D6.1 (K), J24.1, K1.3, R14.1
Pump Signal: A1.28 (ADC2_CH4/D13), R17.1
RST: J1.5
RX: A1.6 (RX2/GPIO16), J1.4, J26.3
SCL: A1.14 (D22/SCL)
SDA: A1.11 (D21/SDA)
SERVO PWR1: J3.2, J5.2, J7.2, J9.2, J11.2, J17.2, J21.2
SERVO PWR2: J2.2, J4.2, J6.2, J8.2, J10.2, J16.2, J21.6
SIG: A1.9 (D18), J25.3
STEP: A1.25 (ADC2_CH7/D27), A2.15 (STEP)
TX: A1.7 (TX2/GPIO17), J1.3, J26.4
VDC: D13.1 (K), J28.2, K1.1, K1.5, OC1.4, Q2.2 (S), Q5.2 (S), Q6.2 (S), Q8.2 (S), R3.1, R7.1, R8.1, R15.1, R16.1
Valve 1 Signal: A1.19 (ADC1_CH6/D34), Q4.1 (B), R6.1
Valve 2 Signal: A1.20 (ADC1_CH7/D35), Q1.1 (B), R2.1
Valve 3 Signal: A1.21 (ADC1_CH4/D32), Q3.1 (B), R5.1
Valve 4 Signal: A1.22 (ADC1_CH4/D33), Q7.1 (B), R13.1

Notes on the sheet:
LED Indicators
ESP32
LIPO Pump
Valve + Pump Connection
Star Connection
CAN Transceiver
Maestro Shield
Electrovalve Commutator
DRV8825
Pump Controller
Power Card Liaison
Servo Connection
Capteur Fin de course

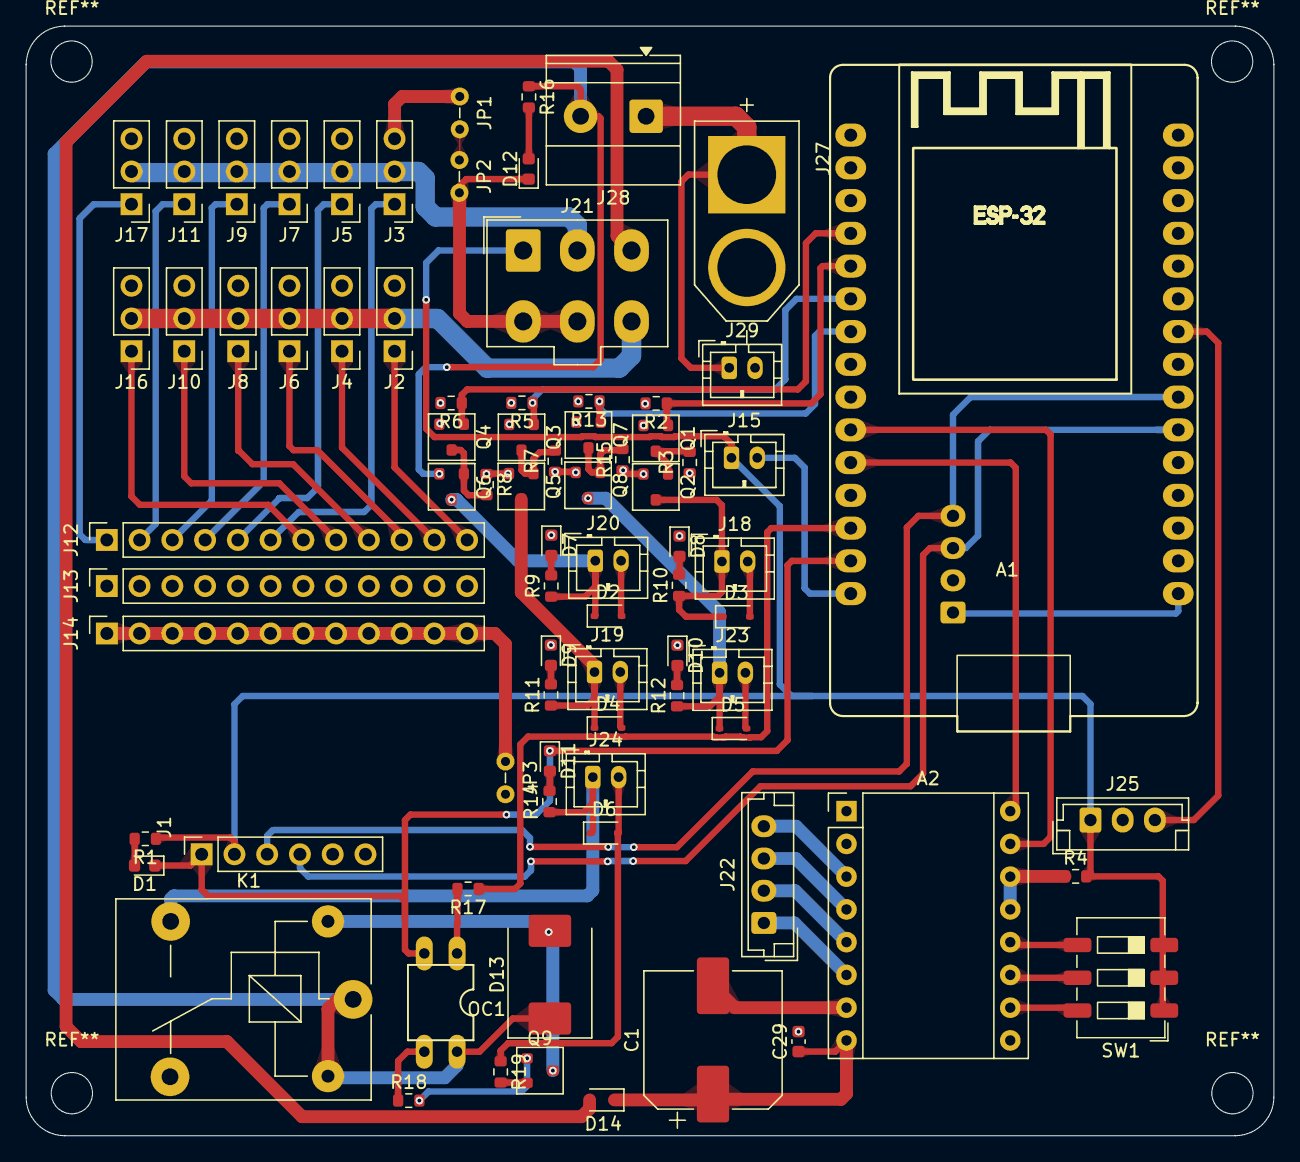
[picture p225: board resources/INSATEURO2026/Electrique/Carte Finale JLCPCB/V2/Actionneur/… from above]

Board: 4 copper layers, 96.8 x 86.1 mm, 81 parts (1 on the bottom side), 65 nets.
