EUROBOT-27/MECANIQUE/resources/INSATEURO2026/Electrique/Carte Finale JLCPCB/Final/Actionneur/Actionneur.kicad_pcb

## KiCad design resources/INSATEURO2026/Electrique/Carte Finale JLCPCB/Final/Actionneur/Actionneur.kicad_pcb (2026-11-01)

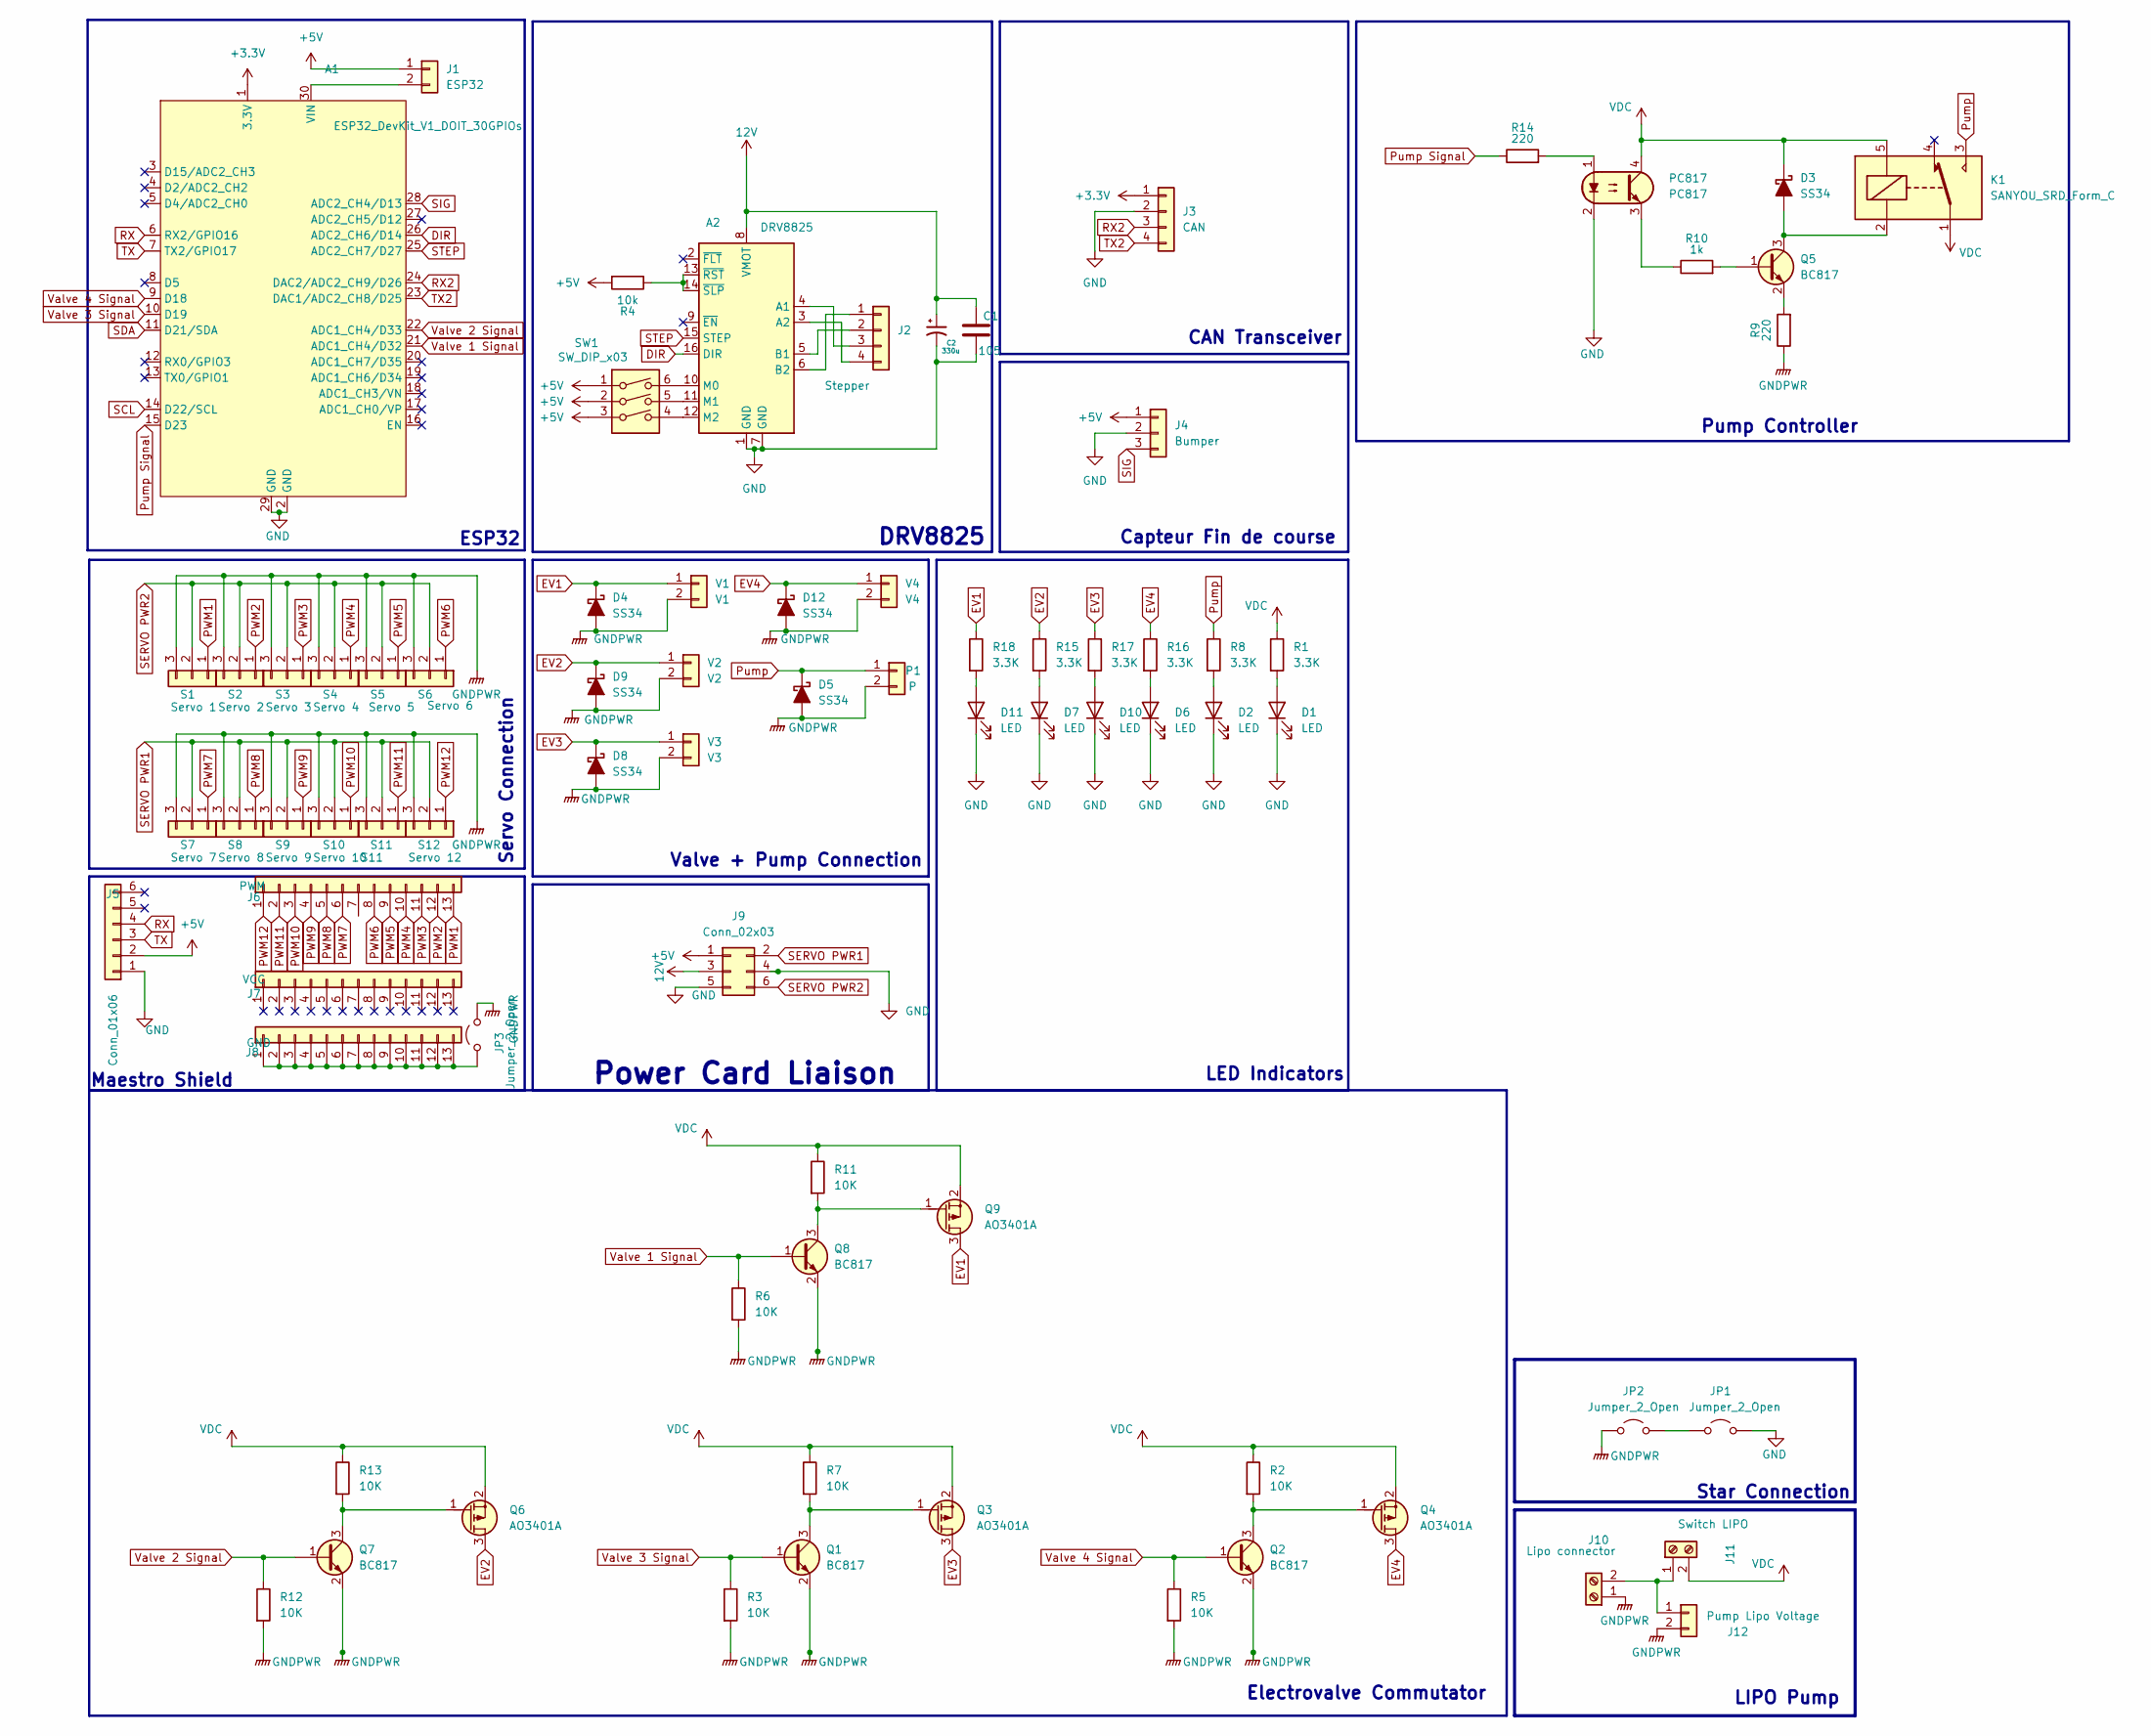
[picture p226: schematic Actionneur.kicad_sch, Carte Actionneur]

Parts:
A1: ESP32_DevKit_V1_DOIT_30GPIOs; DOIT_ESP32_DEVKIT_30Pins
A2: DRV8825; Pololu_Breakout-16_15.2x20.3mm
C1: 105; C_0603_1608Metric
C2: 330u; CP_Elec_10x10.5
D1, D2, D6, D7, D10, D11: LED; LED_0603_1608Metric
D3, D4, D5, D8, D9, D12: SS34; D_SOD-323
J1: ESP32; JST_XH_B2B-XH-A_1x02_P2.50mm_Vertical
J2: Stepper; JST_EH_B4B-EH-A_1x04_P2.50mm_Vertical
J3: CAN; JST_EH_B4B-EH-A_1x04_P2.50mm_Vertical
J4: Bumper; JST_EH_B3B-EH-A_1x03_P2.50mm_Vertical
J5: Conn_01x06; PinSocket_1x06_P2.54mm_Vertical
J6: PWM; PinSocket_1x13_P2.54mm_Vertical
J7: VCC; PinSocket_1x13_P2.54mm_Vertical
J8: GND; PinSocket_1x13_P2.54mm_Vertical
J9: Conn_02x03; Molex_Mini-Fit_Jr_5566-06A_2x03_P4.20mm_Vertical
J10: Lipo connector; TerminalBlock_Phoenix_MKDS-1,5-2-5.08_1x02_P5.08mm_Horizont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
J11: Switch LIPO; TerminalBlock_Phoenix_MKDS-1,5-2-5.08_1x02_P5.08mm_Horizont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
J12: Pump Lipo Voltage; JST_PH_B2B-PH-K_1x02_P2.00mm_Vertical
JP1, JP3: Jumper_2_Open; TestPoint_2Pads_Pitch2.54mm_Drill0.8mm
JP2: Jumper_2_Open; Jumper_P2.54mm_D0.7mm
K1: SANYOU_SRD_Form_C; Relay_SPDT_SANYOU_SRD_Series_Form_C
P1: P; JST_PH_B2B-PH-K_1x02_P2.00mm_Vertical
PC817: PC817; DIP-4_W7.62mm
Q1, Q2, Q5, Q7, Q8: BC817; SOT-23
Q3, Q4, Q6, Q9: AO3401A; SOT-23
R1, R8, R15, R16, R17, R18: 3.3K; R_0603_1608Metric
R2, R3, R5, R6, R7, R11, R12, R13: 10K; R_0603_1608Metric
R4: 10k; R_0603_1608Metric
R9, R14: 220; R_0603_1608Metric
R10: 1k; R_0603_1608Metric
S1: Servo 1; PinHeader_1x03_P2.54mm_Vertical
S2: Servo 2; PinHeader_1x03_P2.54mm_Vertical
S3: Servo 3; PinHeader_1x03_P2.54mm_Vertical
S4: Servo 4; PinHeader_1x03_P2.54mm_Vertical
S5: Servo 5; PinHeader_1x03_P2.54mm_Vertical
S6: Servo 6; PinHeader_1x03_P2.54mm_Vertical
S7: Servo 7; PinHeader_1x03_P2.54mm_Vertical
S8: Servo 8; PinHeader_1x03_P2.54mm_Vertical
S9: Servo 9; PinHeader_1x03_P2.54mm_Vertical
S10: Servo 10; PinHeader_1x03_P2.54mm_Vertical
S11: S11; PinHeader_1x03_P2.54mm_Vertical
S12: Servo 12; PinHeader_1x03_P2.54mm_Vertical
SW1: SW_DIP_x03; SW_DIP_SPSTx03_Slide_6.7x9.18mm_W6.73mm_P2.54mm_LowProfile_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
V1: V1; JST_PH_B2B-PH-K_1x02_P2.00mm_Vertical
V2: V2; JST_PH_B2B-PH-K_1x02_P2.00mm_Vertical
V3: V3; JST_PH_B2B-PH-K_1x02_P2.00mm_Vertical
V4: V4; JST_PH_B2B-PH-K_1x02_P2.00mm_Vertical

Connections:
12V: A2.8 (VMOT), C1.1, C2.1, J9.3
+3.3V: A1.1 (3.3V), J3.1
+5V: J1.1, J4.1, J5.2, J9.1, R4.2, SW1.1, SW1.2, SW1.3
DIR: A1.26 (ADC2_CH6/D14), A2.16 (DIR)
EV1: D4.1 (K), Q9.3 (D), R18.1, V1.1
EV2: D9.1 (K), Q6.3 (D), R15.1, V2.1
EV3: D8.1 (K), Q3.3 (D), R17.1, V3.1
EV4: D12.1 (K), Q4.3 (D), R16.1, V4.1
GND: A1.2 (GND), A1.29 (GND), A2.1 (GND), A2.7 (GND), C1.2, C2.2, D1.1 (K), D2.1 (K), D6.1 (K), D7.1 (K), D10.1 (K), D11.1 (K), J3.2, J4.2, J5.1, J9.4, J9.5, JP1.2 (B), PC817.2
GNDPWR: D4.2 (A), D5.2 (A), D8.2 (A), D9.2 (A), D12.2 (A), J10.1, J12.2, JP2.1 (A), JP3.2 (B), P1.2, Q1.2 (E), Q2.2 (E), Q7.2 (E), Q8.2 (E), R3.2, R5.2, R6.2, R9.1, R12.2, S1.3, S2.3, S3.3, S4.3, S5.3, S6.3, S7.3, S8.3, S9.3, S10.3, S11.3, S12.3, V1.2, V2.2, V3.2, V4.2
unnamed: A1.30 (VIN), J1.2
unnamed: A2.4 (A1), J2.3
unnamed: A2.3 (A2), J2.4
unnamed: A2.5 (B1), J2.2
unnamed: A2.6 (B2), J2.1
unnamed: A2.10 (M0), SW1.6
unnamed: A2.11 (M1), SW1.5
unnamed: A2.12 (M2), SW1.4
unnamed: A2.13 (~RST), A2.14 (~SLP), R4.1
unnamed: D1.2 (A), R1.2
unnamed: D2.2 (A), R8.2
unnamed: D3.2 (A), K1.2, Q5.3 (C)
unnamed: D6.2 (A), R16.2
unnamed: D7.2 (A), R15.2
unnamed: D10.2 (A), R17.2
unnamed: D11.2 (A), R18.2
unnamed: J8.1, J8.2, J8.3, J8.4, J8.5, J8.6, J8.7, J8.8, J8.9, J8.10, J8.11, J8.12, J8.13, JP3.1 (A)
unnamed: J10.2, J11.1, J12.1
unnamed: JP1.1 (A), JP2.2 (B)
unnamed: PC817.1, R14.2
unnamed: PC817.3, R10.1
unnamed: Q1.3 (C), Q3.1 (G), R7.2
unnamed: Q2.3 (C), Q4.1 (G), R2.2
unnamed: Q5.1 (B), R10.2
unnamed: Q5.2 (E), R9.2
unnamed: Q6.1 (G), Q7.3 (C), R13.2
unnamed: Q8.3 (C), Q9.1 (G), R11.2
PWM1: J6.13, S1.1
PWM2: J6.12, S2.1
PWM3: J6.11, S3.1
PWM4: J6.10, S4.1
PWM5: J6.9, S5.1
PWM6: J6.8, S6.1
PWM7: J6.6, S7.1
PWM8: J6.5, S8.1
PWM9: J6.4, S9.1
PWM10: J6.3, S10.1
PWM11: J6.2, S11.1
PWM12: J6.1, S12.1
Pump: D5.1 (K), K1.3, P1.1, R8.1
Pump Signal: A1.15 (D23), R14.1
RX: A1.6 (RX2/GPIO16), J5.4
RX2: A1.24 (DAC2/ADC2_CH9/D26), J3.3
SCL: A1.14 (D22/SCL)
SDA: A1.11 (D21/SDA)
SERVO PWR1: J9.2, S7.2, S8.2, S9.2, S10.2, S11.2, S12.2
SERVO PWR2: J9.6, S1.2, S2.2, S3.2, S4.2, S5.2, S6.2
SIG: A1.28 (ADC2_CH4/D13), J4.3
STEP: A1.25 (ADC2_CH7/D27), A2.15 (STEP)
TX: A1.7 (TX2/GPIO17), J5.3
TX2: A1.23 (DAC1/ADC2_CH8/D25), J3.4
VDC: D3.1 (K), J11.2, K1.1, K1.5, PC817.4, Q3.2 (S), Q4.2 (S), Q6.2 (S), Q9.2 (S), R1.1, R2.1, R7.1, R11.1, R13.1
Valve 1 Signal: A1.21 (ADC1_CH4/D32), Q8.1 (B), R6.1
Valve 2 Signal: A1.22 (ADC1_CH4/D33), Q7.1 (B), R12.1
Valve 3 Signal: A1.10 (D19), Q1.1 (B), R3.1
Valve 4 Signal: A1.9 (D18), Q2.1 (B), R5.1

Notes on the sheet:
LED Indicators
ESP32
LIPO Pump
Valve + Pump Connection
Star Connection
CAN Transceiver
Maestro Shield
Electrovalve Commutator
DRV8825
Pump Controller
Power Card Liaison
Servo Connection
Capteur Fin de course

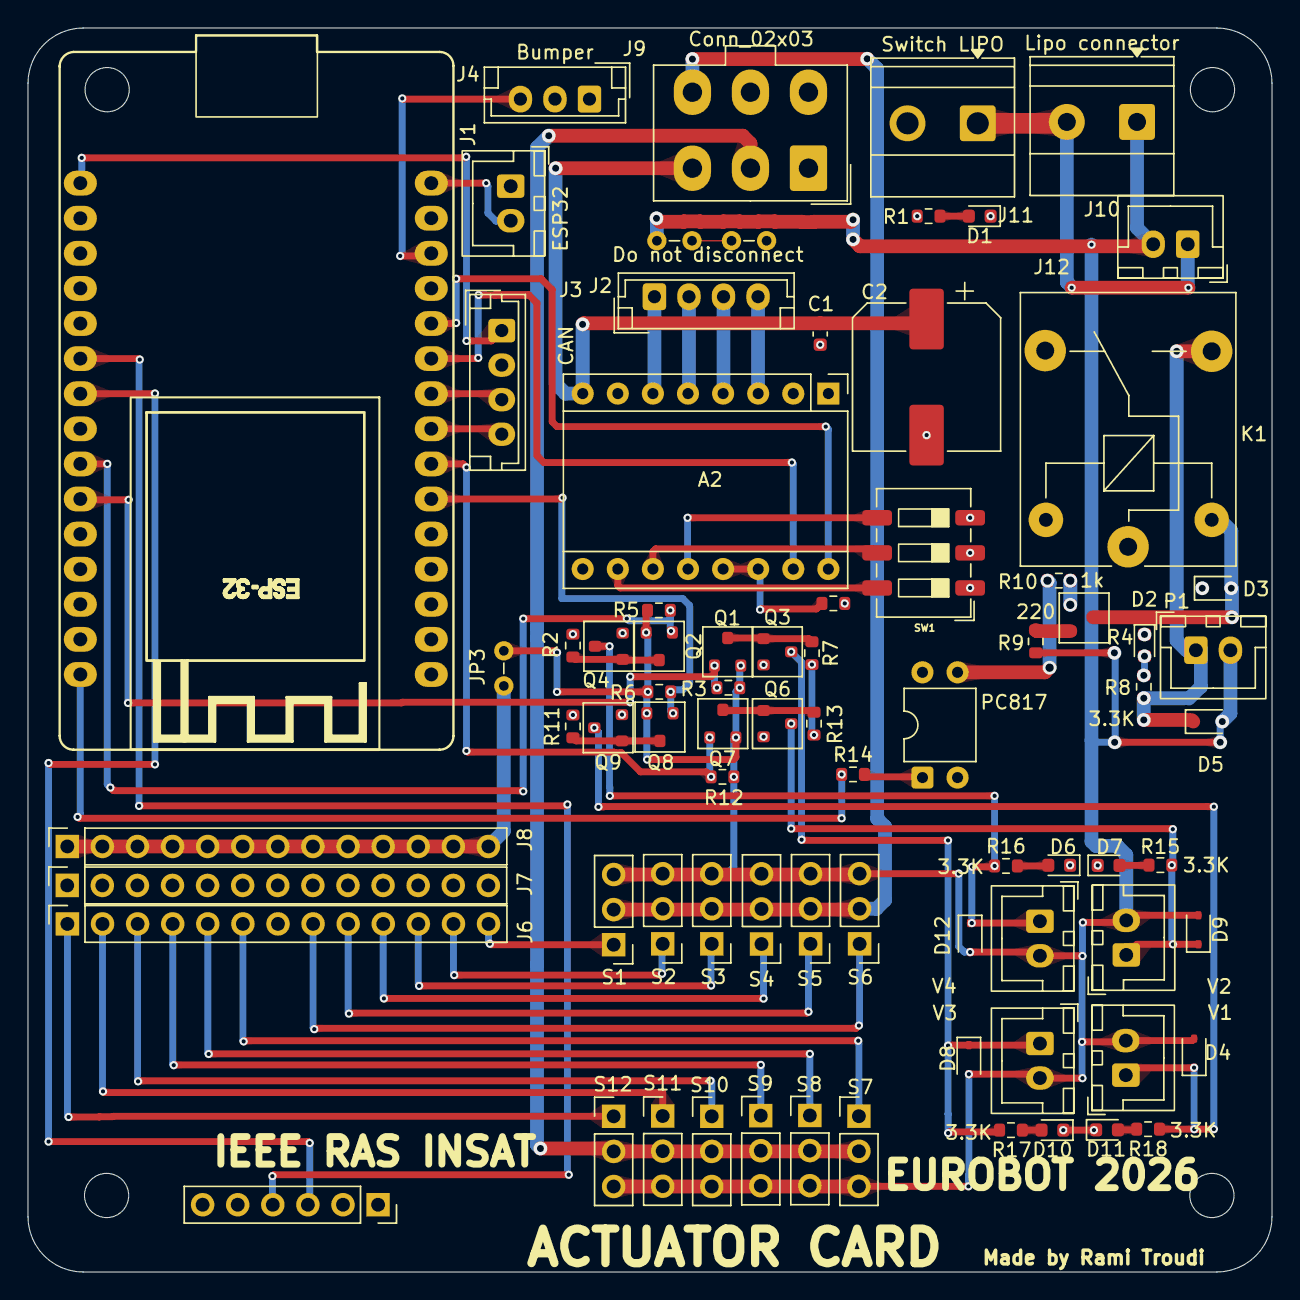
[picture p227: board resources/INSATEURO2026/Electrique/Carte Finale JLCPCB/Final/Actionne… from above]

Board: 4 copper layers, 90.0 x 90.0 mm, 78 parts (0 on the bottom side), 64 nets.
