EUROBOT-27/MECANIQUE/resources/INSATEURO2026/Electrique/Carte Finale JLCPCB/Final (2)/Actionneur.kicad_pcb

## KiCad design resources/INSATEURO2026/Electrique/Carte Finale JLCPCB/Final (2)/Actionneur.kicad_pcb (2026-11-01, an earlier design)

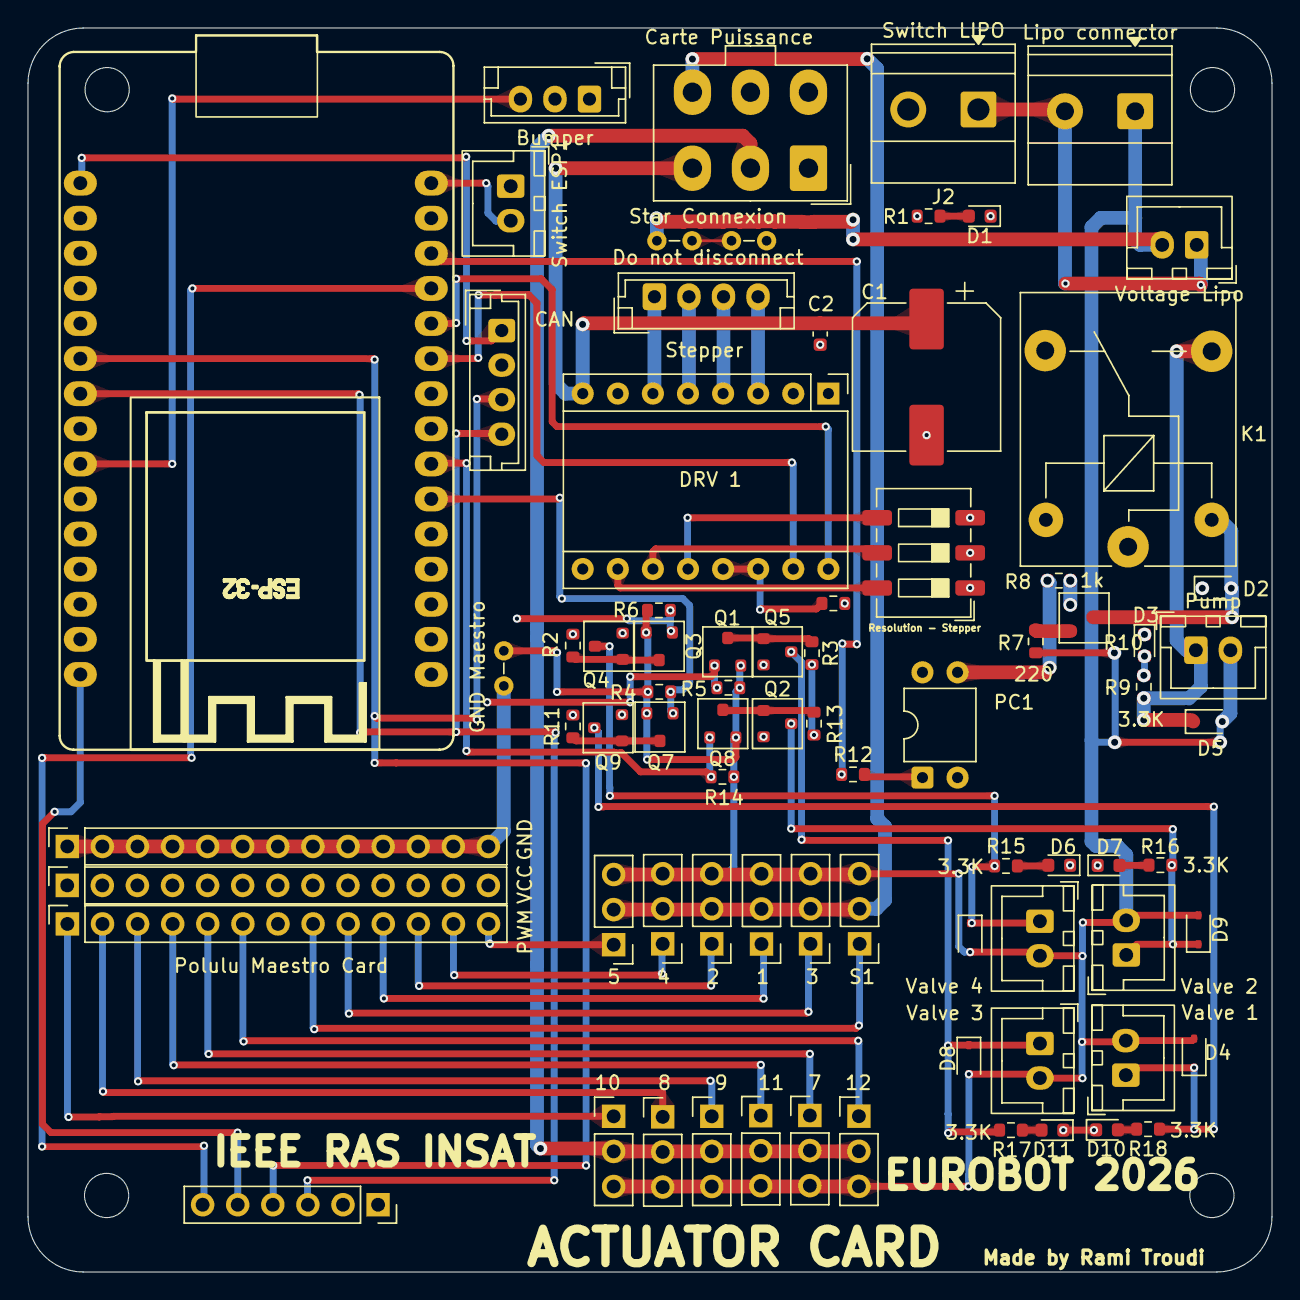
[picture p228: board resources/INSATEURO2026/Electrique/Carte Finale JLCPCB/Final (2)/Acti… from above]

Board: 4 copper layers, 90.0 x 90.0 mm, 78 parts (0 on the bottom side), 64 nets.

Parts:
1: Servo 12; PinHeader_1x03_P2.54mm_Vertical
2: Servo 9; PinHeader_1x03_P2.54mm_Vertical
3: Servo 10; PinHeader_1x03_P2.54mm_Vertical
4: Servo 8; PinHeader_1x03_P2.54mm_Vertical
5: Servo 11; PinHeader_1x03_P2.54mm_Vertical
7: Servo 3; PinHeader_1x03_P2.54mm_Vertical
8: Servo 5; PinHeader_1x03_P2.54mm_Vertical
9: Servo 6; PinHeader_1x03_P2.54mm_Vertical
10: Servo 1; PinHeader_1x03_P2.54mm_Vertical
11: Servo 2; PinHeader_1x03_P2.54mm_Vertical
12: Servo 4; PinHeader_1x03_P2.54mm_Vertical
A1: ESP32_DevKit_V1_DOIT_30GPIOs; DOIT_ESP32_DEVKIT_30Pins
Bumper: Conn_01x03; JST_EH_B3B-EH-A_1x03_P2.50mm_Vertical
C1: 1000u; CP_Elec_10x10.5
C2: 105; C_0603_1608Metric
CAN: Conn_01x04; JST_EH_B4B-EH-A_1x04_P2.50mm_Vertical
Carte Puissance: Conn_02x03; Molex_Mini-Fit_Jr_5566-06A_2x03_P4.20mm_Vertical
D1, D3, D6, D7, D10, D11: LED; LED_0603_1608Metric
D2, D4, D5, D8, D9: SS34; D_SOD-323
DRV 1: Pololu_Breakout_DRV8825; Pololu_Breakout-16_15.2x20.3mm
GND: GND; PinSocket_1x13_P2.54mm_Vertical
GND Maestro: Jumper_2_Open; Jumper_P2.54mm_D0.7mm
J1: Lipo connector; TerminalBlock_Phoenix_MKDS-1,5-2-5.08_1x02_P5.08mm_Horizont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
J2: Switch LIPO; TerminalBlock_Phoenix_MKDS-1,5-2-5.08_1x02_P5.08mm_Horizont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
J3: Conn_01x06; PinSocket_1x06_P2.54mm_Vertical
JP1: Jumper_2_Open; Jumper_P2.54mm_D0.7mm
K1: SANYOU_SRD_Form_C; Relay_SPDT_SANYOU_SRD_Series_Form_C
PC1: PC817; DIP-4_W7.62mm
PWM: PWM; PinSocket_1x13_P2.54mm_Vertical
Polulu Maestro Card: SS34; D_SOD-323
Pump: V1; JST_XH_B2B-XH-A_1x02_P2.50mm_Vertical
Q1, Q3, Q6, Q7, Q8: BC817; SOT-23
Q2, Q4, Q5, Q9: AO3401A; SOT-23
R1, R9, R15, R16, R17, R18: 3.3K; R_0603_1608Metric
R2, R3, R4, R5, R6, R11, R13, R14: 10K; R_0603_1608Metric
R7, R12: 220; R_0603_1608Metric
R8: 1k; R_0603_1608Metric
R10: 10k; R_0603_1608Metric
Resolution - Stepper: SW_DIP_x03; SW_DIP_SPSTx03_Slide_6.7x9.18mm_W6.73mm_P2.54mm_LowProfile_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
S1: Servo 1; PinHeader_1x03_P2.54mm_Vertical
Star Connexion: Jumper_2_Open; Jumper_P2.54mm_D0.7mm
Stepper: Stepper connector; JST_EH_B4B-EH-A_1x04_P2.50mm_Vertical
Switch ESP1: V1; JST_XH_B2B-XH-A_1x02_P2.50mm_Vertical
VCC: VCC; PinSocket_1x13_P2.54mm_Vertical
Valve 1, Valve 2, Valve 3, Valve 4: V1; JST_XH_B2B-XH-A_1x02_P2.50mm_Vertical
Voltage Lipo: Pump Lipo Voltage; JST_XH_B2B-XH-A_1x02_P2.50mm_Vertical

Connections:
12V: C1.1, C2.1, Carte Puissance.3, DRV 1.8 (VMOT)
+3.3V: A1.1 (3.3V), CAN.1
+5V: Bumper.1, Carte Puissance.1, J3.2, R10.2, Resolution - Stepper.1, Resolution - Stepper.2, Resolution - Stepper.3
DIR: A1.26 (ADC2_CH6/D14), DRV 1.16 (DIR)
ERR: A1.27 (ADC2_CH5/D12), J3.6
EV1: D4.1 (K), Q9.3 (D), R18.1, Valve 1.1
EV2: D9.1 (K), Q2.3 (D), R16.1, Valve 2.1
EV3: D8.1 (K), Q5.3 (D), R17.1, Valve 3.1
EV4: Polulu Maestro Card.1 (K), Q4.3 (D), R15.1, Valve 4.1
GND: A1.2 (GND), A1.29 (GND), Bumper.2, C1.2, C2.2, CAN.2, Carte Puissance.4, Carte Puissance.5, D1.1 (K), D3.1 (K), D6.1 (K), D7.1 (K), D10.1 (K), D11.1 (K), DRV 1.1 (GND), DRV 1.7 (GND), J3.1, PC1.2, Star Connexion.2 (B)
GNDPWR: 1.3, 2.3, 3.3, 4.3, 5.3, 7.3, 8.3, 9.3, 10.3, 11.3, 12.3, D4.2 (A), D5.2 (A), D8.2 (A), D9.2 (A), GND Maestro.2 (B), J1.1, JP1.1 (A), Polulu Maestro Card.2 (A), Pump.2, Q1.2 (E), Q3.2 (E), Q7.2 (E), Q8.2 (E), R4.2, R5.2, R6.2, R7.1, R14.2, S1.3, Valve 1.2, Valve 2.2, Valve 3.2, Valve 4.2, Voltage Lipo.2
unnamed: A1.30 (VIN), Switch ESP1.2
unnamed: DRV 1.4 (A1), Stepper.3
unnamed: DRV 1.3 (A2), Stepper.4
unnamed: DRV 1.5 (B1), Stepper.2
unnamed: DRV 1.6 (B2), Stepper.1
unnamed: DRV 1.10 (M0), Resolution - Stepper.6
unnamed: DRV 1.11 (M1), Resolution - Stepper.5
unnamed: DRV 1.12 (M2), Resolution - Stepper.4
unnamed: DRV 1.13 (~RST), DRV 1.14 (~SLP), R10.1
unnamed: D2.2 (A), K1.2, Q6.3 (C)
unnamed: D10.2 (A), R18.2
unnamed: D7.2 (A), R16.2
unnamed: D11.2 (A), R17.2
unnamed: D6.2 (A), R15.2
unnamed: D3.2 (A), R9.2
unnamed: D1.2 (A), R1.2
unnamed: GND.1, GND.2, GND.3, GND.4, GND.5, GND.6, GND.7, GND.8, GND.9, GND.10, GND.11, GND.12, GND.13, GND Maestro.1 (A)
unnamed: J1.J27 (Pin_2), J2.1, Voltage Lipo.1
unnamed: JP1.2 (B), Star Connexion.1 (A)
unnamed: PC1.1, R12.2
unnamed: PC1.3, R8.1
unnamed: Q2.1 (G), Q8.3 (C), R13.2
unnamed: Q1.3 (C), Q5.1 (G), R3.2
unnamed: Q7.3 (C), Q9.1 (G), R11.2
unnamed: Q3.3 (C), Q4.1 (G), R2.2
unnamed: Q6.1 (B), R8.2
unnamed: Q6.2 (E), R7.2
PWM1: PWM.13, S1.1
PWM2: 4.1, PWM.12
PWM3: 2.1, PWM.11
PWM4: 3.1, PWM.10
PWM5: 5.1, PWM.9
PWM6: 1.1, PWM.8
PWM7: 10.1, PWM.6
PWM8: 11.1, PWM.5
PWM9: 7.1, PWM.4
PWM10: 12.1, PWM.3
PWM11: 8.1, PWM.2
PWM12: 9.1, PWM.1
Pump: D5.1 (K), K1.3, Pump.1, R9.1
Pump Signal: A1.28 (ADC2_CH4/D13), R12.1
RST: A1.15 (D23), J3.5
RX: A1.6 (RX2/GPIO16), CAN.3, J3.4
SERVO PWR1: 7.2, 8.2, 9.2, 10.2, 11.2, 12.2, Carte Puissance.2
SERVO PWR2: 1.2, 2.2, 3.2, 4.2, 5.2, Carte Puissance.6, S1.2
SIG: A1.9 (D18), Bumper.3
STEP: A1.25 (ADC2_CH7/D27), DRV 1.15 (STEP)
TX: A1.7 (TX2/GPIO17), CAN.4, J3.3
VDC: D2.1 (K), J2.2, K1.1, K1.5, PC1.4, Q2.2 (S), Q4.2 (S), Q5.2 (S), Q9.2 (S), R1.1, R2.1, R3.1, R11.1, R13.1
Valve 1 Signal: A1.21 (ADC1_CH4/D32), Q7.1 (B), R4.1
Valve 2 Signal: A1.22 (ADC1_CH4/D33), Q8.1 (B), R14.1
Valve 3 Signal: A1.23 (DAC1/ADC2_CH8/D25), Q1.1 (B), R5.1
Valve 4 Signal: A1.24 (DAC2/ADC2_CH9/D26), Q3.1 (B), R6.1
