EUROBOT-27/MECANIQUE/resources/INSATEURO2026/Electrique/PAMIS/Pami n20 V2/Pami n20 Chimique.kicad_pcb

## KiCad design resources/INSATEURO2026/Electrique/PAMIS/Pami n20 V2/Pami n20 Chimique.kicad_pcb (2026-11-01)

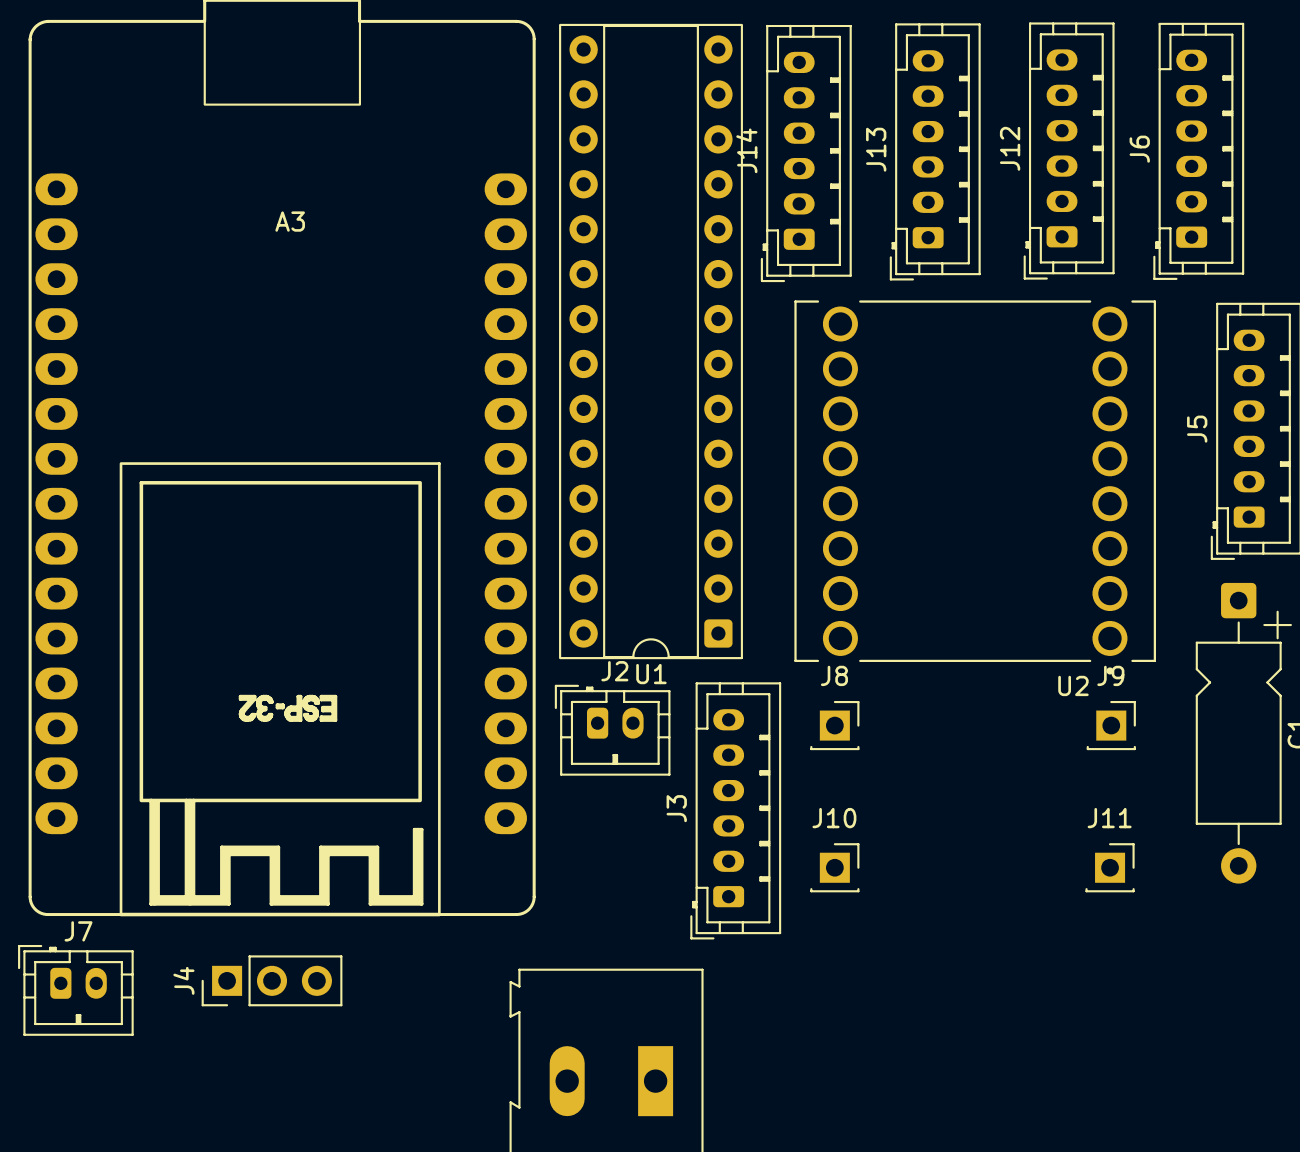
[picture p229: board Pami n20 Chimique.kicad_pcb from above]

Board: 2 copper layers, 18 parts (0 on the bottom side), 31 nets, no tracks yet.

Parts:
A3: ESP32_DevKit_V1_DOIT_30GPIOs; DOIT_ESP32_DEVKIT_30Pins
C1: C_Polarized; CP_Axial_L10.0mm_D4.5mm_P15.00mm_Horizontal
J1: Screw_Terminal_01x02; TerminalBlock_Altech_AK300-2_P5.00mm
J2: URG; JST_PH_B2B-PH-K_1x02_P2.00mm_Vertical
J3: ENC2; JST_PH_B6B-PH-K_1x06_P2.00mm_Vertical
J4: Servo Connector; PinHeader_1x03_P2.54mm_Vertical
J5: ENC1; JST_PH_B6B-PH-K_1x06_P2.00mm_Vertical
J6: TOF1; JST_PH_B6B-PH-K_1x06_P2.00mm_Vertical
J7: Jack; JST_PH_B2B-PH-K_1x02_P2.00mm_Vertical
J8, J9, J10, J11: PINHD_1x1_Female; PinSocket_1x01_P2.54mm_Vertical
J12: TOF2; JST_PH_B6B-PH-K_1x06_P2.00mm_Vertical
J13: TOF3; JST_PH_B6B-PH-K_1x06_P2.00mm_Vertical
J14: TOF4; JST_PH_B6B-PH-K_1x06_P2.00mm_Vertical
U1: MCP23017_SP; DIP-28_W7.62mm_Socket
U2: ROB-14450; MODULE_ROB-14450

Connections:
+3.3V: A3.1 (3.3V), C1.1, J6.3, J12.3, J13.3, J14.3, U1.9 (VDD), U2.2 (VCC)
+5V: A3.30 (VIN), J3.2, J4.2, J5.2, J9.1, U2.1 (VM), U2.13 (STBY)
A1: J5.1, U2.4 (A01)
A2: J5.6, U2.5 (A02)
B1: J3.1, U2.7 (B01)
B2: J3.6, U2.6 (B02)
ENC1_A: A3.22 (ADC1_CH4/D33), J5.4
ENC1_B: A3.21 (ADC1_CH4/D32), J5.3
ENC2_A: A3.20 (ADC1_CH7/D35), J3.4
ENC2_B: A3.19 (ADC1_CH6/D34), J3.3
GND: A3.2 (GND), C1.2, J1.1, J3.5, J4.3, J5.5, J6.4, J7.2, J10.1, J11.1, J12.4, J13.4, J14.4, U1.10 (VSS), U1.15 (A0), U1.16 (A1), U1.17 (A2), U2.3 (GND), U2.8 (GND), U2.9 (GND)
GPIO1: J6.2, U1.1 (GPB0)
GPIO2: J12.2, U1.2 (GPB1)
GPIO3: J13.2, U1.3 (GPB2)
GPIO4: J14.2, U1.4 (GPB3)
JACK: A3.15 (D23), J7.1
M1_PWM: A3.8 (D5), U2.16 (PWMA)
M2_PWM: A3.27 (ADC2_CH5/D12), U2.10 (PWMB)
MOT_AIN1: U1.27 (GPA6), U2.14 (AI1)
MOT_AIN2: U1.28 (GPA7), U2.15 (AI2)
MOT_BIN1: U1.26 (GPA5), U2.12 (BI1)
MOT_BIN2: U1.25 (GPA4), U2.11 (BI2)
unnamed: J1.2, J2.1
SCL: A3.14 (D22/SCL), J6.5, J12.5, J13.5, J14.5, U1.12 (SCK)
SDA: A3.11 (D21/SDA), J6.6, J12.6, J13.6, J14.6, U1.13 (SDA)
SERVO_PWM: A3.9 (D18), J4.1
Supply: J2.2, J8.1
XShunt1: J6.1, U1.24 (GPA3)
XShunt2: J12.1, U1.23 (GPA2)
XShunt3: J13.1, U1.22 (GPA1)
XShunt4: J14.1, U1.21 (GPA0)
