EUROBOT-27/MECANIQUE/resources/INSATEURO2026/Electrique/Shield STM32 PCB/shield_stm2025.kicad_pcb

## KiCad design resources/INSATEURO2026/Electrique/Shield STM32 PCB/shield_stm2025.kicad_pcb (2026-11-01)

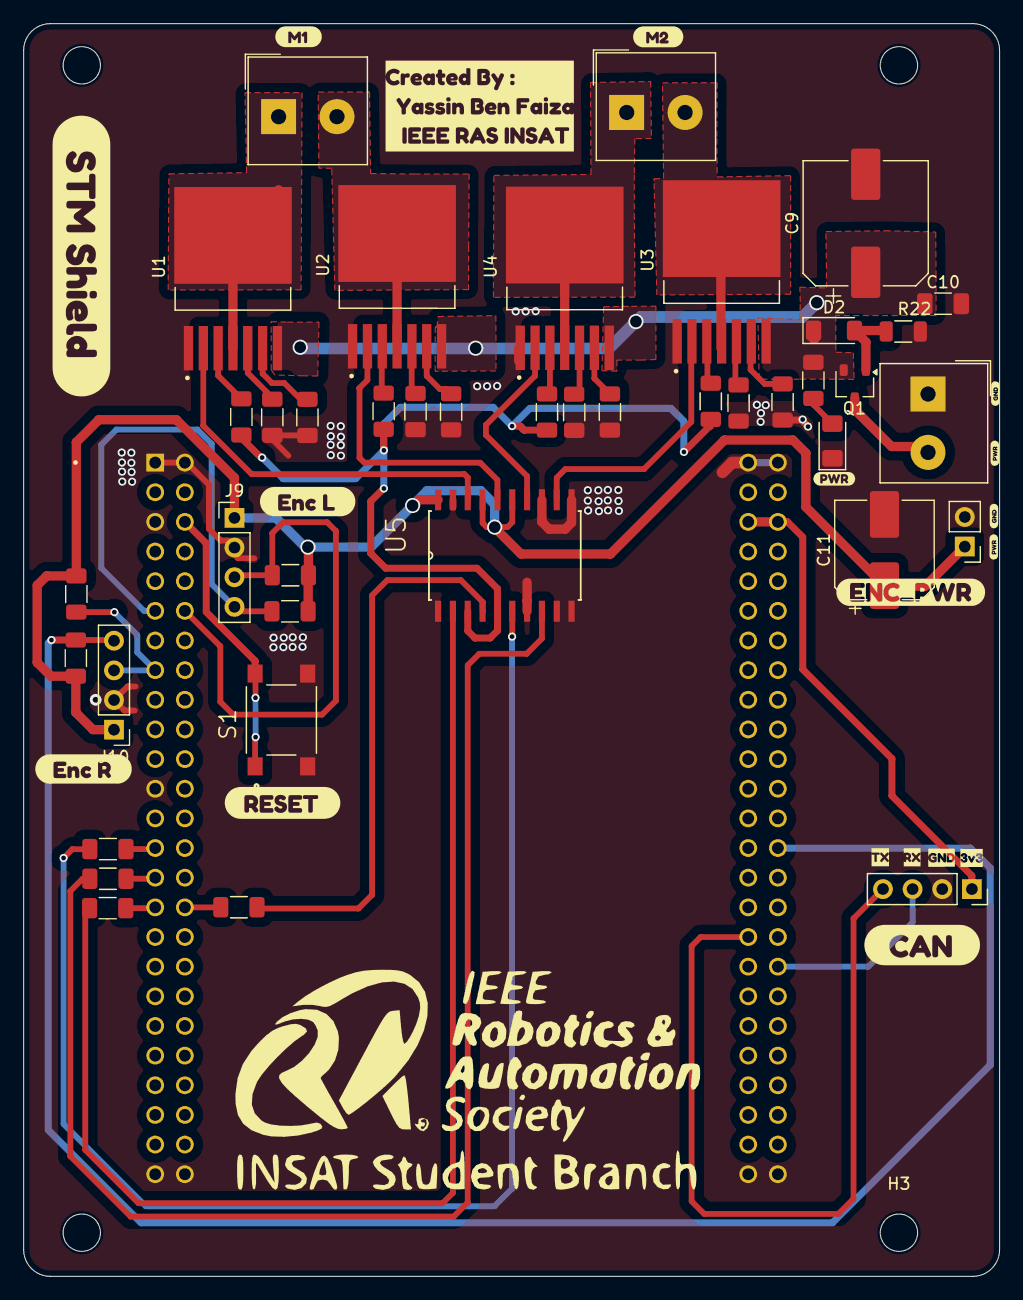
[picture p230: board shield_stm2025.kicad_pcb from above]

Board: 2 copper layers, 83.6 x 107.3 mm, 64 parts (0 on the bottom side), 43 nets.

Parts:
C9: 470u; CP_Elec_10x10.5
C10: 100n; C_1206_3216Metric_Pad1.33x1.80mm_HandSolder
C11: 10u; CP_Elec_8x5.4
D1: LED; LED_1206_3216Metric_Pad1.42x1.75mm_HandSolder
D2: BZV55B10; D_MiniMELF
H1, H2, H3, H4: MountingHole; MountingHole_3.2mm_M3
J2: OUT M1; Altech_AK100_1x02_P5.00mm
J3: OUT M2; Altech_AK100_1x02_P5.00mm
J4: 24V input; Altech_AK100_1x02_P5.00mm
J6: CAN; PinSocket_1x04_P2.54mm_Vertical
J8: Alimentation; PinHeader_1x02_P2.54mm_Vertical
J9: Encoder_Left; PinHeader_1x04_P2.54mm_Vertical
J10: Encoder_Right; PinHeader_1x04_P2.54mm_Vertical
Q1: AO3401A; SOT-23W
R1, R2, R5, R6, R9, R10, R15, R16: 10K; R_1206_3216Metric_Pad1.30x1.75mm_HandSolder
R3, R4, R7, R8, R11, R12, R13, R14: 4.7K; R_1206_3216Metric_Pad1.30x1.75mm_HandSolder
R17, R18, R19, R20, R21: R; R_1206_3216Metric_Pad1.30x1.75mm_HandSolder
R22: 10K; R_1206_3216Metric
S1: PTS645SK50SMTR92LFS; SW_PTS645SK50SMTR92LFS
TB1: STM32F4DISCOVERY; MODULE_STM32F407G-DISC1
U1, U2, U3, U4: BTS7960B; DPAK127P1490X440-8N
U5: 74HC244; SOIC127P1032X265-20N
kibuzzard-6821E684: G***; kibuzzard-6821E684
kibuzzard-6821EA5D: G***; kibuzzard-6821EA5D
kibuzzard-6821EA78: G***; kibuzzard-6821EA78
kibuzzard-6821EB0D: G***; kibuzzard-6821EB0D
kibuzzard-6821EB1E: G***; kibuzzard-6821EB1E
kibuzzard-6821EB6B: G***; kibuzzard-6821EB6B
kibuzzard-6821FFFF: G***; kibuzzard-6821FFFF
kibuzzard-6824CA9A, kibuzzard-6824CA9A#2: G***; kibuzzard-6824CA9A
kibuzzard-6824CA75, kibuzzard-6824CA75#2: G***; kibuzzard-6824CA75
kibuzzard-6824CD1D: G***; kibuzzard-6824CD1D
kibuzzard-6824CD32: G***; kibuzzard-6824CD32
kibuzzard-6824CD49: G***; kibuzzard-6824CD49
kibuzzard-6824CD70: G***; kibuzzard-6824CD70
kibuzzard-6881FAE2: G***; kibuzzard-6881FAE2
kibuzzard-68220201: G***; kibuzzard-68220201
kibuzzard-68220375: G***; kibuzzard-68220375

Connections:
+3.3V: J6.1, TB1.P2_5 (3V), TB1.P2_6 (3V)
EN: R2.1, R6.1, R10.2, R15.2, U5.3 (2Y0), U5.5 (2Y1)
GND: C9.2, C10.2, C11.2, D1.1 (K), J4.1, J6.2, J8.2, J9.2, J10.2, R3.1, R4.2, R7.1, R8.2, R11.1, R12.2, R13.2, R14.1, R22.2, S1.3, S1.4, TB1.P1_1 (GND), TB1.P1_2 (GND), TB1.P1_5 (GND), TB1.P1_23 (GND), TB1.P1_49 (GND), TB1.P1_50 (GND), TB1.P2_1 (GND), TB1.P2_2 (GND), TB1.P2_49 (GND), TB1.P2_50 (GND), U1.1 (GND), U2.1 (GND), U3.1 (GND), U4.1 (GND), U5.1 (1OE), U5.7 (2Y2), U5.9 (2Y3), U5.10 (GND), U5.11 (2A3), U5.13 (2A2), U5.19 (2OE)
LPWM1: R1.1, TB1.P1_32 (PE14)
LPWM2: R16.1, TB1.P1_29 (PE11)
NRST: S1.1, S1.2, TB1.P1_6 (NRST)
unnamed: D1.2 (A), R17.2
unnamed: D2.2 (A), Q1.1 (G), R22.1
unnamed: J2.1, U1.4 (OUT), U1.8 (OUT)
unnamed: J2.2, U2.4 (OUT), U2.8 (OUT)
unnamed: J3.1, U4.4 (OUT), U4.8 (OUT)
unnamed: J3.2, U3.4 (OUT), U3.8 (OUT)
unnamed: J4.2, Q1.3 (D)
unnamed: R2.2, U1.3 (INH)
unnamed: R4.1, U1.6 (IS)
unnamed: R3.2, U1.5 (SR)
unnamed: R15.1, U2.3 (INH)
unnamed: R8.1, U2.6 (IS)
unnamed: R7.2, U2.5 (SR)
unnamed: R10.1, U3.3 (INH)
unnamed: R13.1, U3.6 (IS)
unnamed: R11.2, U3.5 (SR)
unnamed: R6.2, U4.3 (INH)
unnamed: R12.1, U4.6 (IS)
unnamed: R14.2, U4.5 (SR)
unnamed: R9.2, U5.2 (1A0)
unnamed: R1.2, U5.4 (1A1)
unnamed: R5.2, U5.6 (1A2)
unnamed: R16.2, U5.8 (1A3)
OUT1: U1.2 (IN), U5.18 (1Y0)
OUT2: U2.2 (IN), U5.16 (1Y1)
OUT3: U4.2 (IN), U5.14 (1Y2)
OUT4: U3.2 (IN), U5.12 (1Y3)
PA0: J9.3, R20.1, TB1.P1_12 (PA0-WKUP)
PA1: J9.4, R21.1, TB1.P1_11 (PA1)
PA5: J10.3, R18.1, TB1.P1_15 (PA5)
PB3: J10.4, R19.1, TB1.P2_28 (PB3)
RPWM1: R9.1, TB1.P1_31 (PE13)
RPWM2: R5.1, TB1.P1_27 (PE9)
RX: J6.3, TB1.P2_36 (PD0)
Supply: C9.1, C10.1, D2.1 (K), Q1.2 (S), R17.1, U1.7 (VS), U2.7 (VS), U3.7 (VS), U4.7 (VS)
TX: J6.4, TB1.P2_33 (PD1)
VCC: C11.1, J8.1, J9.1, J10.1, R18.2, R19.2, R20.2, R21.2, U5.15 (2A1), U5.17 (2A0), U5.20 (VCC)
