EUROBOT-27/MECANIQUE/resources/INSATEURO2026/Electrique/Carte Finale JLCPCB/Final (2)/Puissance.kicad_pcb

## KiCad design resources/INSATEURO2026/Electrique/Carte Finale JLCPCB/Final (2)/Puissance.kicad_pcb (2026-11-01, an earlier design)

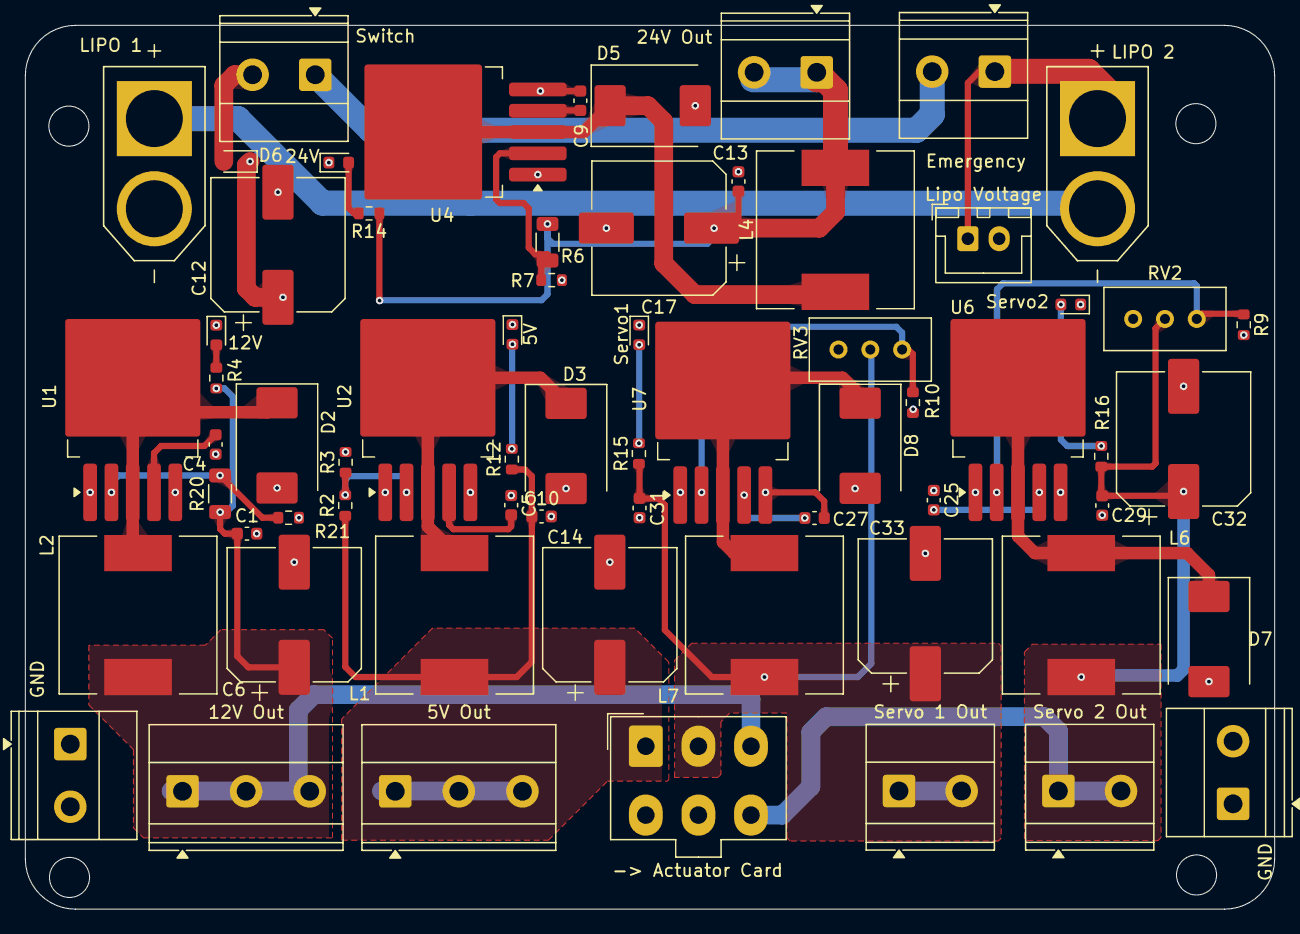
[picture p231: board resources/INSATEURO2026/Electrique/Carte Finale JLCPCB/Final (2)/Puis… from above]

Board: 4 copper layers, 99.8 x 70.6 mm, 65 parts (0 on the bottom side), 31 nets.

Parts:
5V, 12V, 24V: LED; LED_0603_1608Metric
5V Out: 5V; TerminalBlock_Phoenix_MKDS-1,5-3-5.08_1x03_P5.08mm_Horizont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
12V Out: 12V; TerminalBlock_Phoenix_MKDS-1,5-3-5.08_1x03_P5.08mm_Horizont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
24V Out: 24V Out; TerminalBlock_Phoenix_MKDS-1,5-2_1x02_P5.00mm_Horizontal
-> Actuator Card: Conn_02x03; Molex_Mini-Fit_Jr_5566-06A_2x03_P4.20mm_Vertical
C1, C4, C5, C9, C10, C13, C25, C27, C29, C31: 105; C_0603_1608Metric
C6, C14, C17, C32, C33: 330u; CP_Elec_10x10.5
C12: 1000u; CP_Elec_10x10.5
D2, D3, D5, D7, D8: B540C; D_SMC
D6: SS34; D_SOD-323
Emergency: Emergency Stop; TerminalBlock_Phoenix_MKDS-1,5-2_1x02_P5.00mm_Horizontal
GND: ADJ out; TerminalBlock_Phoenix_MKDS-1,5-2_1x02_P5.00mm_Horizontal
GND : ADJ out; TerminalBlock_Phoenix_MKDS-1,5-2_1x02_P5.00mm_Horizontal
L1, L2, L4, L6, L7: 47uH; L_12x12mm_H6mm
LIPO 1, LIPO 2: XT60-M; AMASS_XT60-M
Lipo Voltage: LIPO 1 VOLT; JST_XH_B2B-XH-A_1x02_P2.50mm_Vertical
R2: 10K; R_0603_1608Metric
R3, R7, R9, R10: 3.3K; R_0603_1608Metric
R4: 1k; R_0603_1608Metric
R6: 60.4K; R_1206_3216Metric
R12: 220; R_0603_1608Metric
R14: 3.3k; R_0603_1608Metric
R15, R16: 1K; R_0603_1608Metric
R20: 13K; R_1206_3216Metric
R21: 1.5K; R_0603_1608Metric
RV2, RV3: R_Potentiometer; Potentiometer_Bourns_3296W_Vertical
Servo1, Servo2: LED; LED_0603_1608Metric
Servo 1 Out, Servo 2 Out: ADJ out; TerminalBlock_Phoenix_MKDS-1,5-2_1x02_P5.00mm_Horizontal
Switch: Master Switch; TerminalBlock_Phoenix_MKDS-1,5-2_1x02_P5.00mm_Horizontal
U1, U2, U4, U6, U7: XL4015; TO-263-5_TabPin3

Connections:
5V: 5V Out.1, 5V Out.2, 5V Out.3, -> Actuator Card.1, C10.1, C14.1, L1.2, R2.1, R12.1
12V: 12V Out.1, 12V Out.2, 12V Out.3, -> Actuator Card.3, C1.1, C6.1, L2.2, R4.1, R20.1
24V: 24V Out.1, 24V Out.2, C13.1, C17.1, L4.2, R6.1, R14.1
ADJ1: -> Actuator Card.6, C29.1, C32.1, L6.2, R16.1, RV2.2, Servo 2 Out.1, Servo 2 Out.2
GND: 5V.1 (K), 12V.1 (K), 24V.1 (K), -> Actuator Card.4, -> Actuator Card.5, C1.2, C6.2, C10.2, C12.2, C13.2, C14.2, C17.2, C29.2, C31.2, C32.2, C33.2, D2.2 (A), D3.2 (A), D5.2 (A), D7.2 (A), D8.2 (A), GND.1, GND.2, GND.1, GND.2, LIPO 1.N (NEG), Lipo Voltage.2, R3.2, R7.2, R9.2, R10.2, R21.2, RV2.3, RV3.3, Servo1.1 (K), Servo2.1 (K), U1.1 (GND), U2.1 (GND), U4.1 (GND), U6.1 (GND), U7.1 (GND)
unnamed: D2.1 (K), L2.1, U1.3 (SW)
unnamed: D3.1 (K), L1.1, U2.3 (SW)
unnamed: 12V.2 (A), R4.2
unnamed: D5.1 (K), L4.1, U4.3 (SW)
unnamed: D7.1 (K), L6.1, U6.3 (SW)
unnamed: D8.1 (K), L7.1, U7.3 (SW)
unnamed: 5V.2 (A), R12.2
unnamed: 24V.2 (A), R14.2
unnamed: R15.2, Servo1.2 (A)
unnamed: R16.2, Servo2.2 (A)
unnamed: LIPO 1.P (POS), LIPO 2.N (NEG)
unnamed: Emergency.1, LIPO 2.P (POS), Lipo Voltage.1
unnamed: Emergency.2, Switch.1
unnamed: R20.2, R21.1, U1.2 (FB)
unnamed: C4.2, U1.4 (VC)
unnamed: R2.2, R3.1, U2.2 (FB)
unnamed: C5.2, U2.4 (VC)
unnamed: R6.2, R7.1, U4.2 (FB)
unnamed: C9.2, U4.4 (VC)
unnamed: R9.1, RV2.1, U6.2 (FB)
unnamed: C25.2, U6.4 (VC)
unnamed: R10.1, RV3.1, U7.2 (FB)
unnamed: C27.2, U7.4 (VC)
SERVO: -> Actuator Card.2, C31.1, C33.1, L7.2, R15.1, RV3.2, Servo 1 Out.1, Servo 1 Out.2
SUPPLY: D6.2 (A), Switch.2
VDC: C4.1, C5.1, C9.1, C12.1, C25.1, C27.1, D6.1 (K), U1.5 (VIN), U2.5 (VIN), U4.5 (VIN), U6.5 (VIN), U7.5 (VIN)
