EUROBOT-27/MECANIQUE/resources/INSATEURO2026/Electrique/Actionneur PCB/Actionneur/Actionneur.kicad_pcb

## KiCad design resources/INSATEURO2026/Electrique/Actionneur PCB/Actionneur/Actionneur.kicad_pcb (2026-11-01)

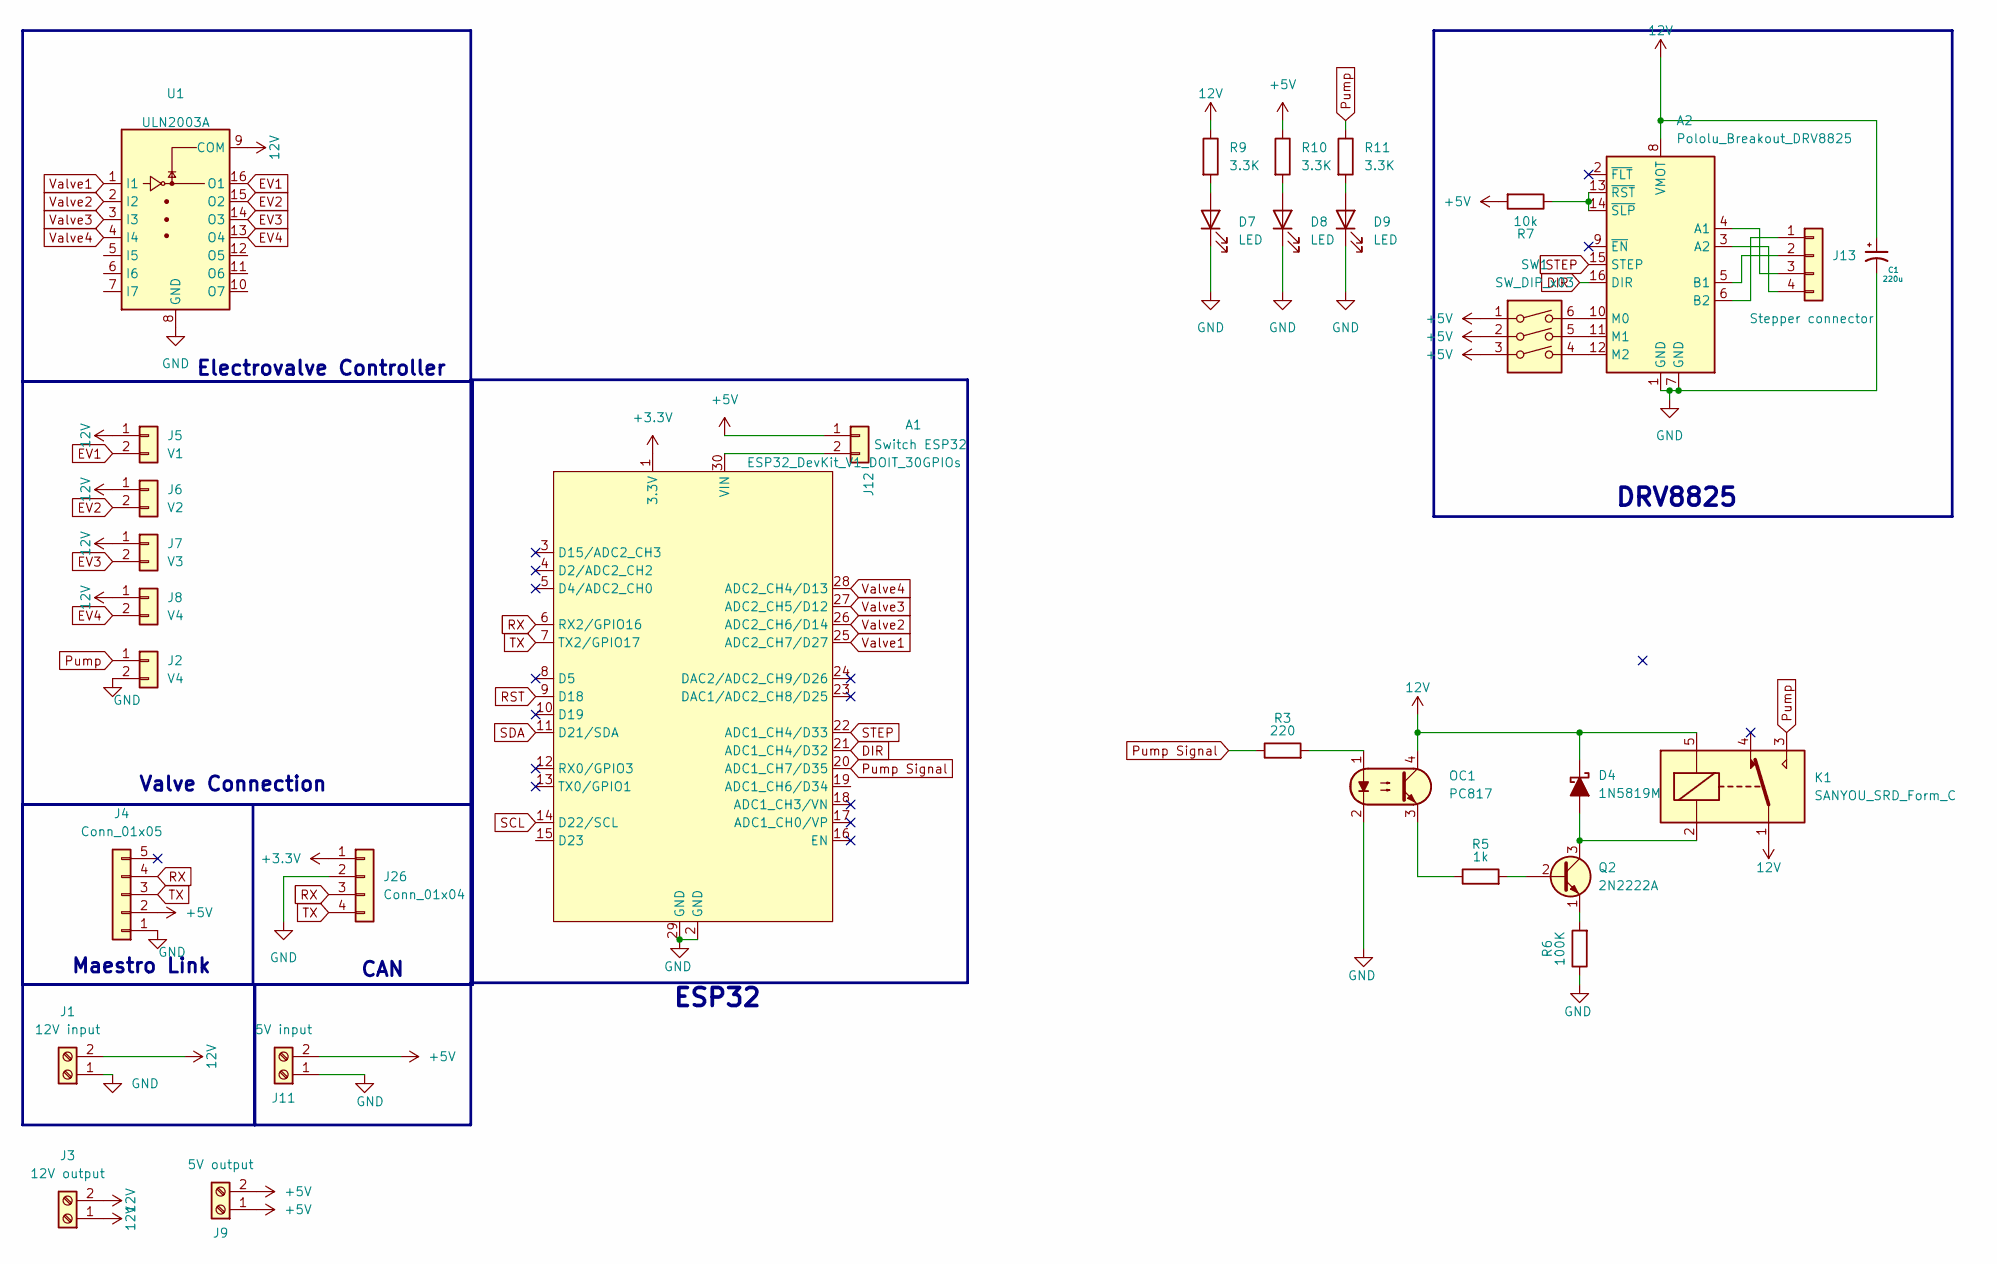
[picture p232: schematic Actionneur.kicad_sch]

Parts:
A1: ESP32_DevKit_V1_DOIT_30GPIOs; DOIT_ESP32_DEVKIT_30Pins
A2: Pololu_Breakout_DRV8825; Pololu_Breakout-16_15.2x20.3mm
C1: 220u; CP_Elec_10x10.5
D4: 1N5819M; D_SMC
D7, D8, D9: LED; LED_0603_1608Metric
J1: 12V input; Altech_AK100_1x02_P5.00mm
J2, J8: V4; JST_PH_B2B-PH-K_1x02_P2.00mm_Vertical
J3: 12V output; Altech_AK100_1x02_P5.00mm
J4: Conn_01x05; JST_EH_B5B-EH-A_1x05_P2.50mm_Vertical
J5: V1; JST_PH_B2B-PH-K_1x02_P2.00mm_Vertical
J6: V2; JST_PH_B2B-PH-K_1x02_P2.00mm_Vertical
J7: V3; JST_PH_B2B-PH-K_1x02_P2.00mm_Vertical
J9: 5V output; Altech_AK100_1x02_P5.00mm
J11: 5V input; Altech_AK100_1x02_P5.00mm
J12: Switch ESP32; PinHeader_1x02_P1.00mm_Vertical
J13: Stepper connector; JST_EH_B4B-EH-A_1x04_P2.50mm_Vertical
J26: Conn_01x04; JST_EH_B4B-EH-A_1x04_P2.50mm_Vertical
K1: SANYOU_SRD_Form_C; Relay_SPDT_SANYOU_SRD_Series_Form_C
OC1: PC817; Vishay_CNY64
Q2: 2N2222A; TO-18-3_EBC
R3: 220; R_0603_1608Metric
R5: 1k; R_0603_1608Metric
R6: 100K; R_0603_1608Metric
R7: 10k; R_Axial_DIN0204_L3.6mm_D1.6mm_P7.62mm_Horizontal
R9, R10, R11: 3.3K; R_0603_1608Metric
SW1: SW_DIP_x03; SW_DIP_SPSTx03_Slide_9.78x9.8mm_W7.62mm_P2.54mm
U1: ULN2003A; DIP-16_W7.62mm

Connections:
12V: A2.8 (VMOT), C1.1, D4.1 (K), J1.2, J3.1, J3.2, J5.1, J6.1, J7.1, J8.1, K1.1, K1.5, OC1.4, R9.1, U1.9 (COM)
+3.3V: A1.1 (3.3V), J26.1
+5V: J4.2, J9.1, J9.2, J11.2, J12.1, R7.2, R10.1, SW1.1, SW1.2, SW1.3
DIR: A1.21 (ADC1_CH4/D32), A2.16 (DIR)
EV1: J5.2, U1.16 (O1)
EV2: J6.2, U1.15 (O2)
EV3: J7.2, U1.14 (O3)
EV4: J8.2, U1.13 (O4)
GND: A1.2 (GND), A1.29 (GND), A2.1 (GND), A2.7 (GND), C1.2, D7.1 (K), D8.1 (K), D9.1 (K), J1.1, J2.2, J4.1, J11.1, J26.2, OC1.2, R6.1, U1.8 (GND)
unnamed: A1.30 (VIN), J12.2
unnamed: A2.4 (A1), J13.3
unnamed: A2.3 (A2), J13.4
unnamed: A2.5 (B1), J13.2
unnamed: A2.6 (B2), J13.1
unnamed: A2.10 (M0), SW1.6
unnamed: A2.11 (M1), SW1.5
unnamed: A2.12 (M2), SW1.4
unnamed: A2.13 (~RST), A2.14 (~SLP), R7.1
unnamed: D4.2 (A), K1.2, Q2.3 (C)
unnamed: D7.2 (A), R9.2
unnamed: D8.2 (A), R10.2
unnamed: D9.2 (A), R11.2
unnamed: OC1.1, R3.2
unnamed: OC1.3, R5.1
unnamed: Q2.2 (B), R5.2
unnamed: Q2.1 (E), R6.2
Pump: J2.1, K1.3, R11.1
Pump Signal: A1.20 (ADC1_CH7/D35), R3.1
RST: A1.9 (D18)
RX: A1.6 (RX2/GPIO16), J4.4, J26.3
SCL: A1.14 (D22/SCL)
SDA: A1.11 (D21/SDA)
STEP: A1.22 (ADC1_CH4/D33), A2.15 (STEP)
TX: A1.7 (TX2/GPIO17), J4.3, J26.4
Valve1: A1.25 (ADC2_CH7/D27), U1.1 (I1)
Valve2: A1.26 (ADC2_CH6/D14), U1.2 (I2)
Valve3: A1.27 (ADC2_CH5/D12), U1.3 (I3)
Valve4: A1.28 (ADC2_CH4/D13), U1.4 (I4)

Notes on the sheet:
DRV8825
ESP32
Electrovalve Controller
CAN
Valve Connection
Maestro Link

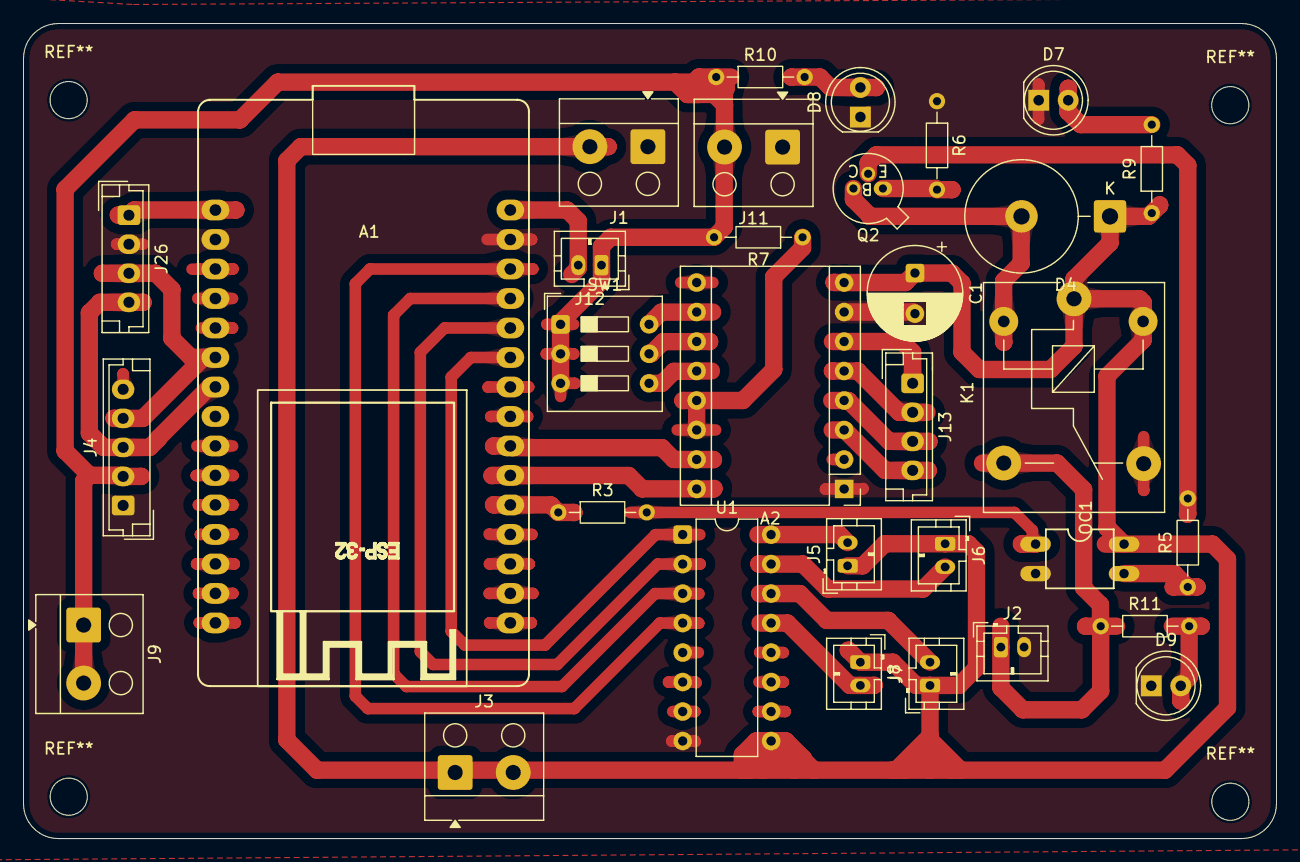
[picture p233: board resources/INSATEURO2026/Electrique/Actionneur PCB/Actionneur/Actionne… from above]

Board: 2 copper layers, 107.9 x 70.2 mm, 32 parts (0 on the bottom side), 35 nets.
