EUROBOT-27/MECANIQUE/resources/INSATEURO2026/Electrique/PAMIS/PAMI Stepper/PAMI Stepper.kicad_pcb

## KiCad design resources/INSATEURO2026/Electrique/PAMIS/PAMI Stepper/PAMI Stepper.kicad_pcb (2026-11-01)

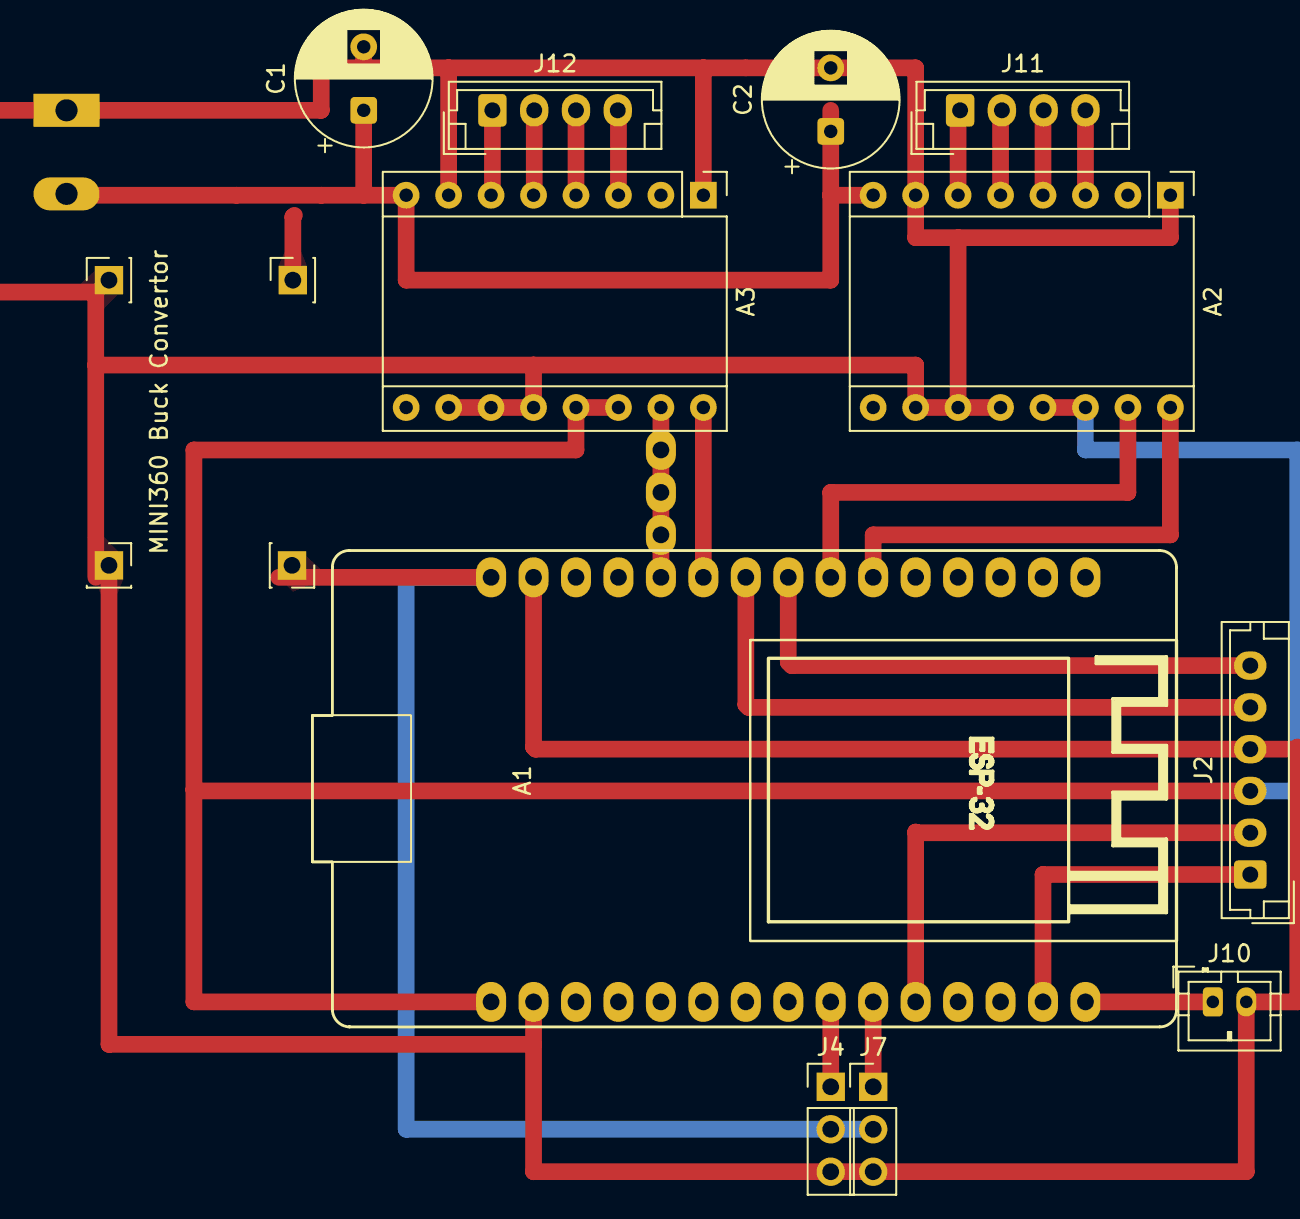
[picture p234: board PAMI Stepper.kicad_pcb from above]

Board: 2 copper layers, 16 parts (1 on the bottom side), 23 nets.

Parts:
A1: ESP32_DevKit_V1_DOIT_30GPIOs; DOIT_ESP32_DEVKIT_30Pins
A2, A3: Pololu_Breakout_DRV8825; Pololu_Breakout-16_15.2x20.3mm
C1, C2: 220u; CP_Radial_D8.0mm_P3.80mm
J1: Screw_Terminal_01x02; TerminalBlock_Altech_AK300-2_P5.00mm
J2: Mot 1; JST_EH_B6B-EH-A_1x06_P2.50mm_Vertical
J4, J7: Servo Connector; PinHeader_1x03_P2.54mm_Vertical
J8, J9, J11#2: PINHD_1x1_Female; PinSocket_1x01_P2.54mm_Vertical
J10: Jack; JST_PH_B2B-PH-K_1x02_P2.00mm_Vertical
J10#2: MINI360 Buck Convertor; PinSocket_1x01_P2.54mm_Vertical
J11, J12: Stepper connector; JST_EH_B4B-EH-A_1x04_P2.50mm_Vertical

Connections:
12V: A2.8 (VMOT), A3.8 (VMOT), C1.1, C2.1, J1.2
+3.3V: A1.1 (3.3V), A2.13 (~RST), A2.14 (~SLP), A3.13 (~RST), A3.14 (~SLP), J2.3
+5V: A1.30 (VIN), J4.2, J7.2, J9.1
DIR: A1.21 (ADC1_CH4/D32), A2.16 (DIR)
DIR2: A1.25 (ADC2_CH7/D27), A3.16 (DIR)
GND: A1.2 (GND), A1.29 (GND), A2.1 (GND), A2.7 (GND), A2.10 (M0), A2.11 (M1), A2.12 (M2), A3.1 (GND), A3.7 (GND), A3.10 (M0), A3.11 (M1), A3.12 (M2), C1.2, C2.2, J1.1, J2.4, J4.3, J7.3, J10.2, J10#2.1, J11#2.1
GPIO: A1.24 (DAC2/ADC2_CH9/D26), J2.5
JACK: A1.15 (D23), J10.1
unnamed: A2.4 (A1), J11.3
unnamed: A2.3 (A2), J11.4
unnamed: A2.5 (B1), J11.2
unnamed: A2.6 (B2), J11.1
unnamed: A3.4 (A1), J12.3
unnamed: A3.3 (A2), J12.4
unnamed: A3.5 (B1), J12.2
unnamed: A3.6 (B2), J12.1
SCL: A1.14 (D22/SCL), J2.1
SDA: A1.11 (D21/SDA), J2.2
SERVO_PWM1: A1.9 (D18), J4.1
SERVO_PWM2: A1.10 (D19), J7.1
STEP: A1.22 (ADC1_CH4/D33), A2.15 (STEP)
STEP2: A1.26 (ADC2_CH6/D14), A3.15 (STEP)
XShunt1: A1.23 (DAC1/ADC2_CH8/D25), J2.6
