EUROBOT-27/MECANIQUE/resources/INSATEURO2026/Electrique/PAMIS/Carte Tayssir Temp/Carte Test Tayssir.kicad_pcb

## KiCad design resources/INSATEURO2026/Electrique/PAMIS/Carte Tayssir Temp/Carte Test Tayssir.kicad_pcb (2026-11-01)

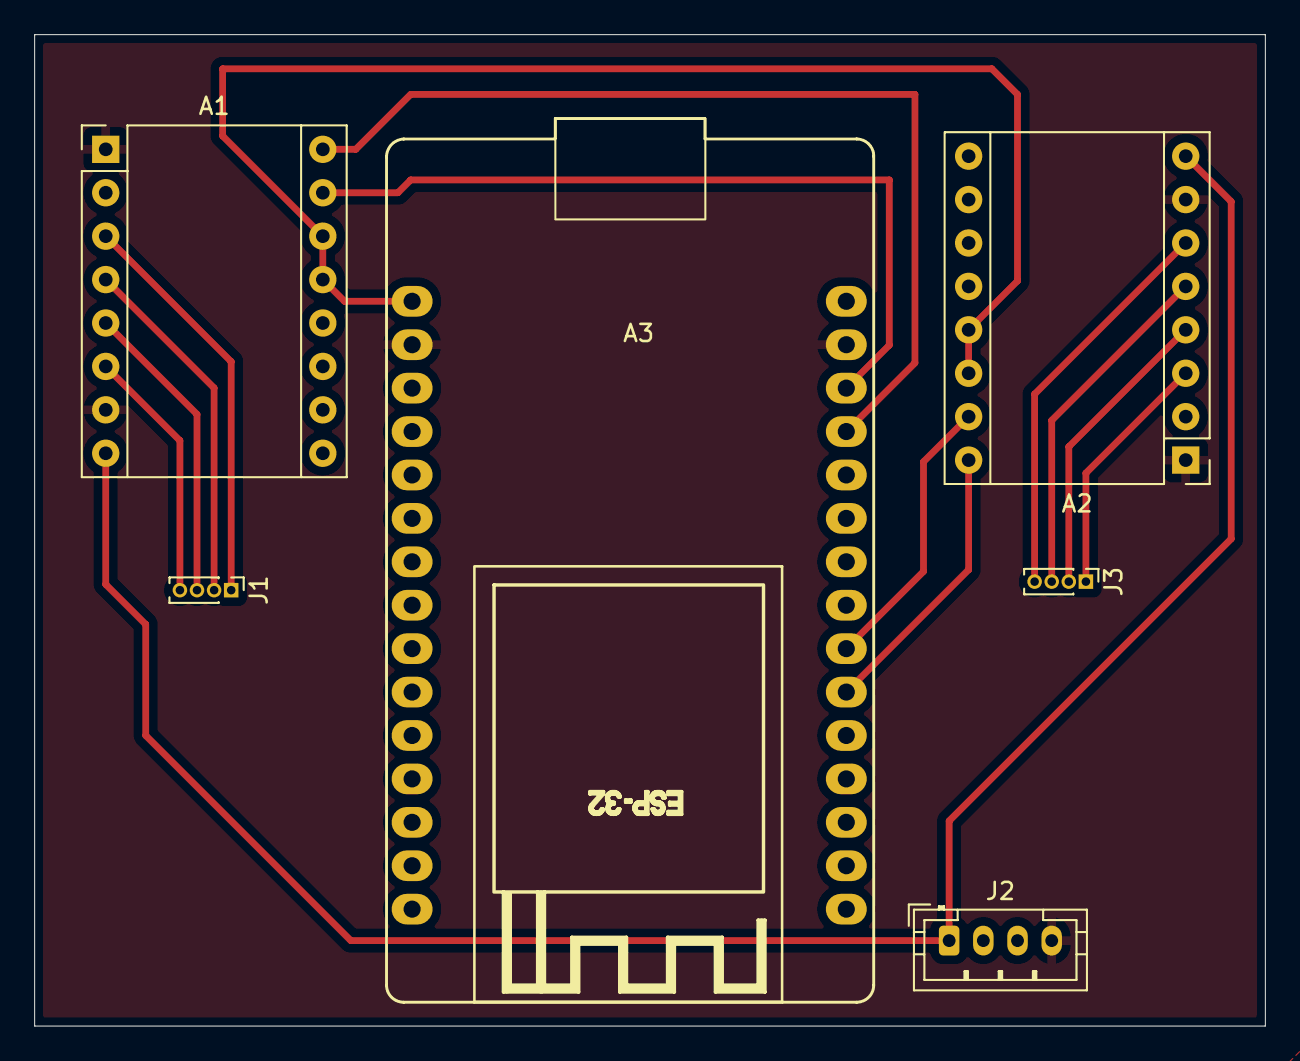
[picture p235: board Carte Test Tayssir.kicad_pcb from above]

Board: 2 copper layers, 72.0 x 58.0 mm, 6 parts (0 on the bottom side), 15 nets.

Parts:
A1, A2: Pololu_Breakout_DRV8825; Pololu_Breakout-16_15.2x20.3mm
A3: ESP32_DevKit_V1_DOIT_30GPIOs; DOIT_ESP32_DEVKIT_30Pins
J1, J3: Conn_01x04_Pin; PinHeader_1x04_P1.00mm_Vertical
J2: Conn_01x04; JST_PH_B4B-PH-K_1x04_P2.00mm_Vertical

Connections:
3V3: A1.13 (~RST), A1.14 (~SLP), A2.13 (~RST), A2.14 (~SLP), A3.1 (3.3V)
12V: A1.8 (VMOT), A2.8 (VMOT), J2.1
GND: A1.1 (GND), A1.7 (GND), A2.1 (GND), A2.7 (GND), A3.2 (GND), A3.29 (GND), J2.4
unnamed: A1.4 (A1), J1.2
unnamed: A1.3 (A2), J1.1
unnamed: A1.5 (B1), J1.3
unnamed: A1.6 (B2), J1.4
unnamed: A1.16 (DIR), A3.27 (ADC2_CH5/D12)
unnamed: A1.15 (STEP), A3.28 (ADC2_CH4/D13)
unnamed: A2.4 (A1), J3.2
unnamed: A2.3 (A2), J3.1
unnamed: A2.5 (B1), J3.3
unnamed: A2.6 (B2), J3.4
unnamed: A2.16 (DIR), A3.21 (ADC1_CH4/D32)
unnamed: A2.15 (STEP), A3.22 (ADC1_CH4/D32)
