EUROBOT-27/MECANIQUE/resources/INSATEURO2026/Electrique/Carte Puissance PCB/puissance.kicad_pcb

## KiCad design resources/INSATEURO2026/Electrique/Carte Puissance PCB/puissance.kicad_pcb (2026-11-01)

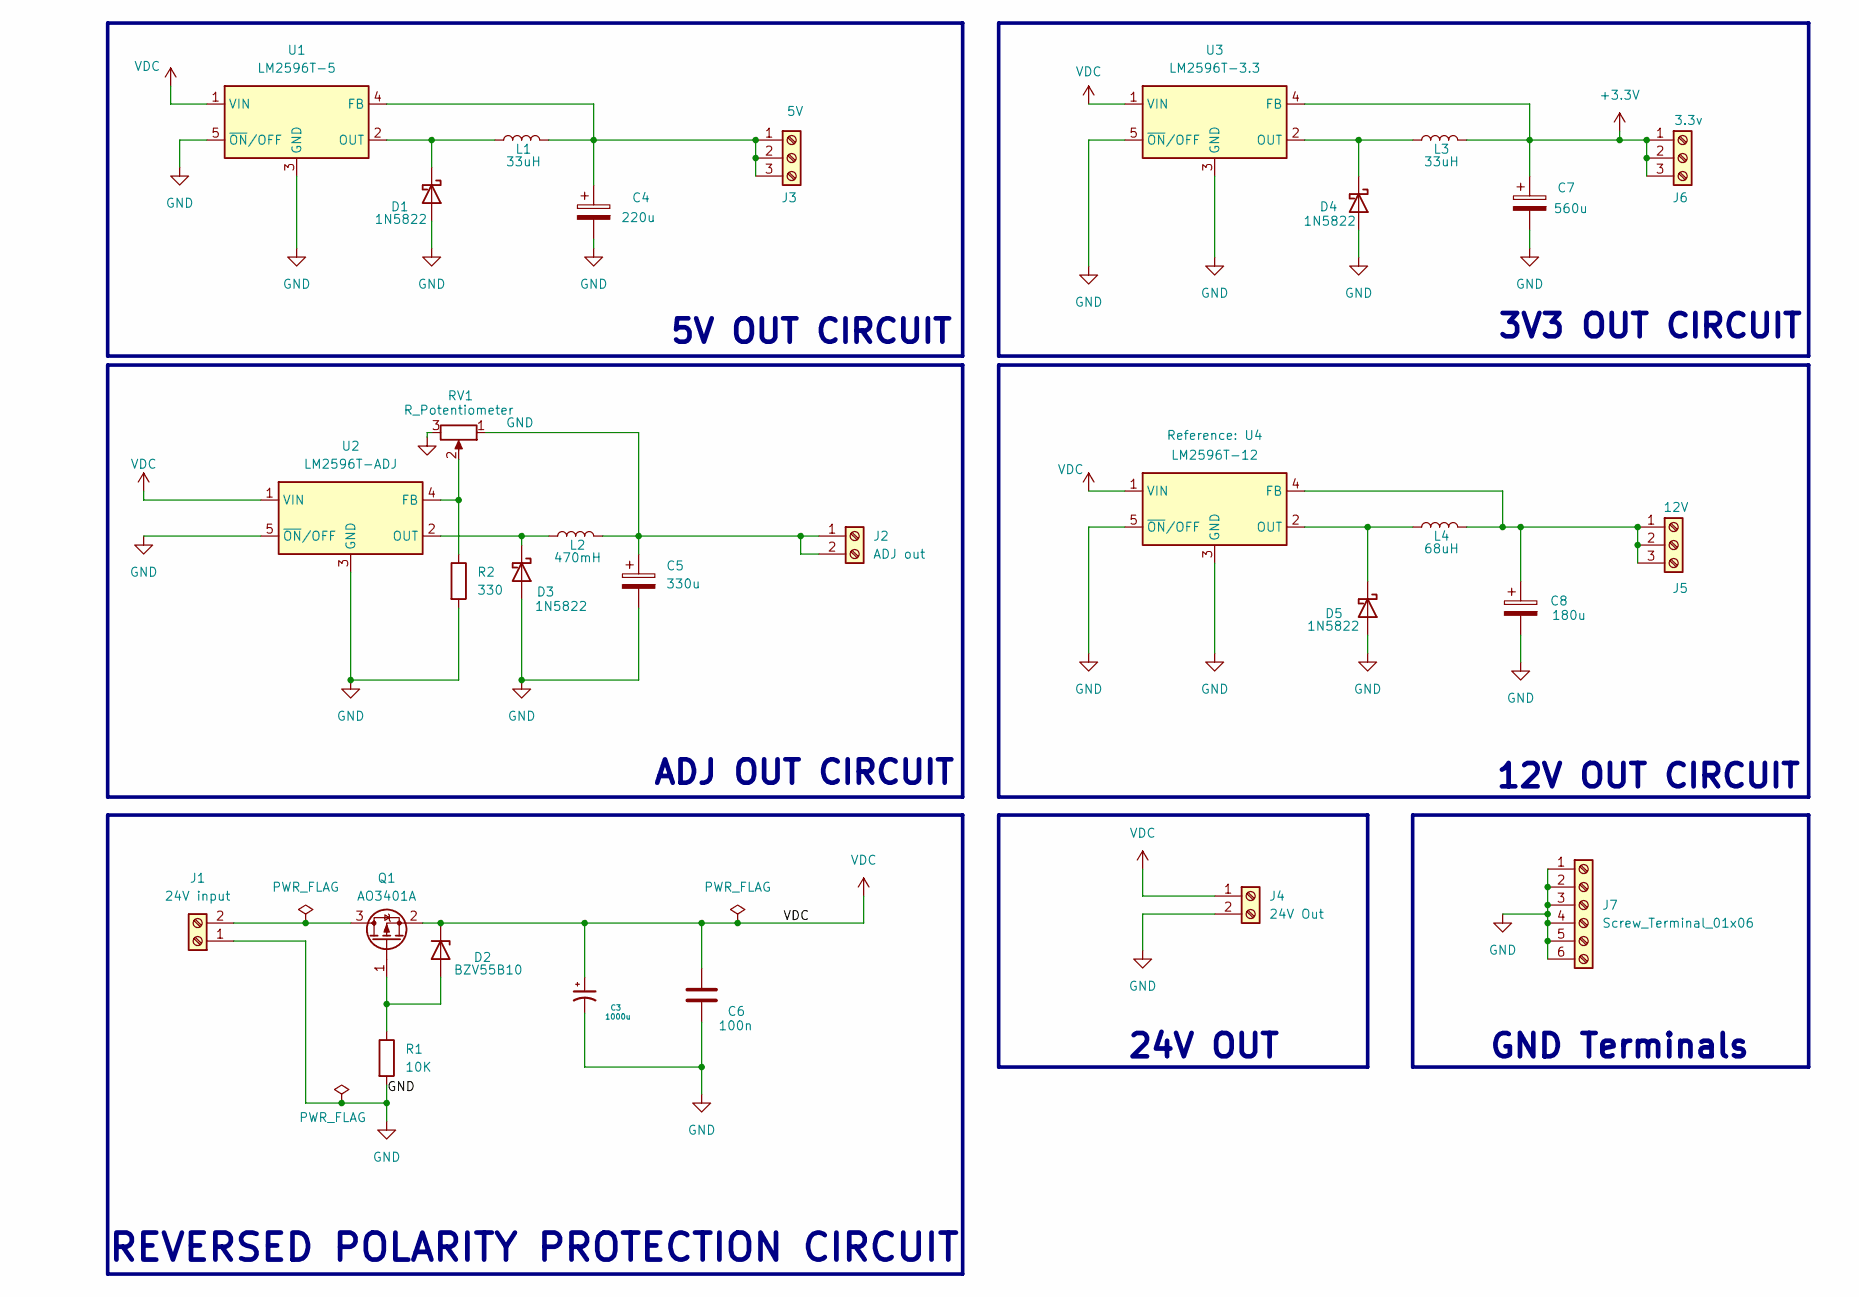
[picture p236: schematic puissance.kicad_sch, Power Card]

Parts:
C3: 1000u; CP_Elec_10x10.5
C4: 220u; CP_Elec_10x10.5
C5: 330u; CP_Elec_10x10.5
C6: 100n; C_1206_3216Metric_Pad1.33x1.80mm_HandSolder
C7: 560u; CP_Elec_10x10.5
C8: 180u; CP_Elec_10x10.5
D1, D3, D4, D5: 1N5822; D_DO-34_SOD68_P5.08mm_Vertical_AnodeUp
D2: BZV55B10; D_MiniMELF
J1: 24V input; Altech_AK100_1x02_P5.00mm
J2: ADJ out; Altech_AK100_1x02_P5.00mm
J3: 5V; Altech_AK100_1x03_P5.00mm
J4: 24V Out; Altech_AK100_1x02_P5.00mm
J5: 12V; Altech_AK100_1x03_P5.00mm
J6: 3.3v; Altech_AK100_1x03_P5.00mm
J7: Screw_Terminal_01x06; Altech_AK100_1x06_P5.00mm
L1, L3: 33uH; L_12x12mm_H6mm
L2: 470mH; L_12x12mm_H6mm
L4: 68uH; L_12x12mm_H6mm
Q1: AO3401A; SOT-23W
R1: 10K; R_1206_3216Metric_Pad1.30x1.75mm_HandSolder
R2: 330; R_1206_3216Metric_Pad1.30x1.75mm_HandSolder
RV1: R_Potentiometer; Potentiometer_Bourns_3296W_Vertical
U1: LM2596T-5; TO-263-5_TabPin3
U2: LM2596T-ADJ; TO-263-5_TabPin3
U3: LM2596T-3.3; TO-263-5_TabPin3
U4: LM2596T-12; TO-263-5_TabPin3

Connections:
+3.3V: C7.1, J6.1, J6.2, J6.3, L3.2, U3.4 (FB)
GND: C3.2, C4.2, C5.2, C6.2, C7.2, C8.2, D1.2 (A), D3.2 (A), D4.2 (A), D5.2 (A), J1.1, J4.2, J7.1, J7.2, J7.3, J7.4, J7.5, J7.6, R1.2, R2.2, RV1.3, U1.3 (GND), U1.5 (~ON/OFF), U2.3 (GND), U2.5 (~ON/OFF), U3.3 (GND), U3.5 (~ON/OFF), U4.3 (GND), U4.5 (~ON/OFF)
unnamed: D1.1 (K), L1.1, U1.2 (OUT)
unnamed: D2.2 (A), Q1.1 (G), R1.1
unnamed: D3.1 (K), L2.1, U2.2 (OUT)
unnamed: D4.1 (K), L3.1, U3.2 (OUT)
unnamed: D5.1 (K), L4.1, U4.2 (OUT)
unnamed: J1.2, Q1.3 (D)
unnamed: C5.1, J2.1, J2.2, L2.2, RV1.1
unnamed: C4.1, J3.1, J3.2, J3.3, L1.2, U1.4 (FB)
unnamed: C8.1, J5.1, J5.2, J5.3, L4.2, U4.4 (FB)
unnamed: R2.1, RV1.2, U2.4 (FB)
VDC: C3.1, C6.1, D2.1 (K), J4.1, Q1.2 (S), U1.1 (VIN), U2.1 (VIN), U3.1 (VIN), U4.1 (VIN)

Notes on the sheet:
5V OUT CIRCUIT
ADJ OUT CIRCUIT
12V OUT CIRCUIT
3V3 OUT CIRCUIT
REVERSED POLARITY PROTECTION CIRCUIT
24V OUT
GND Terminals

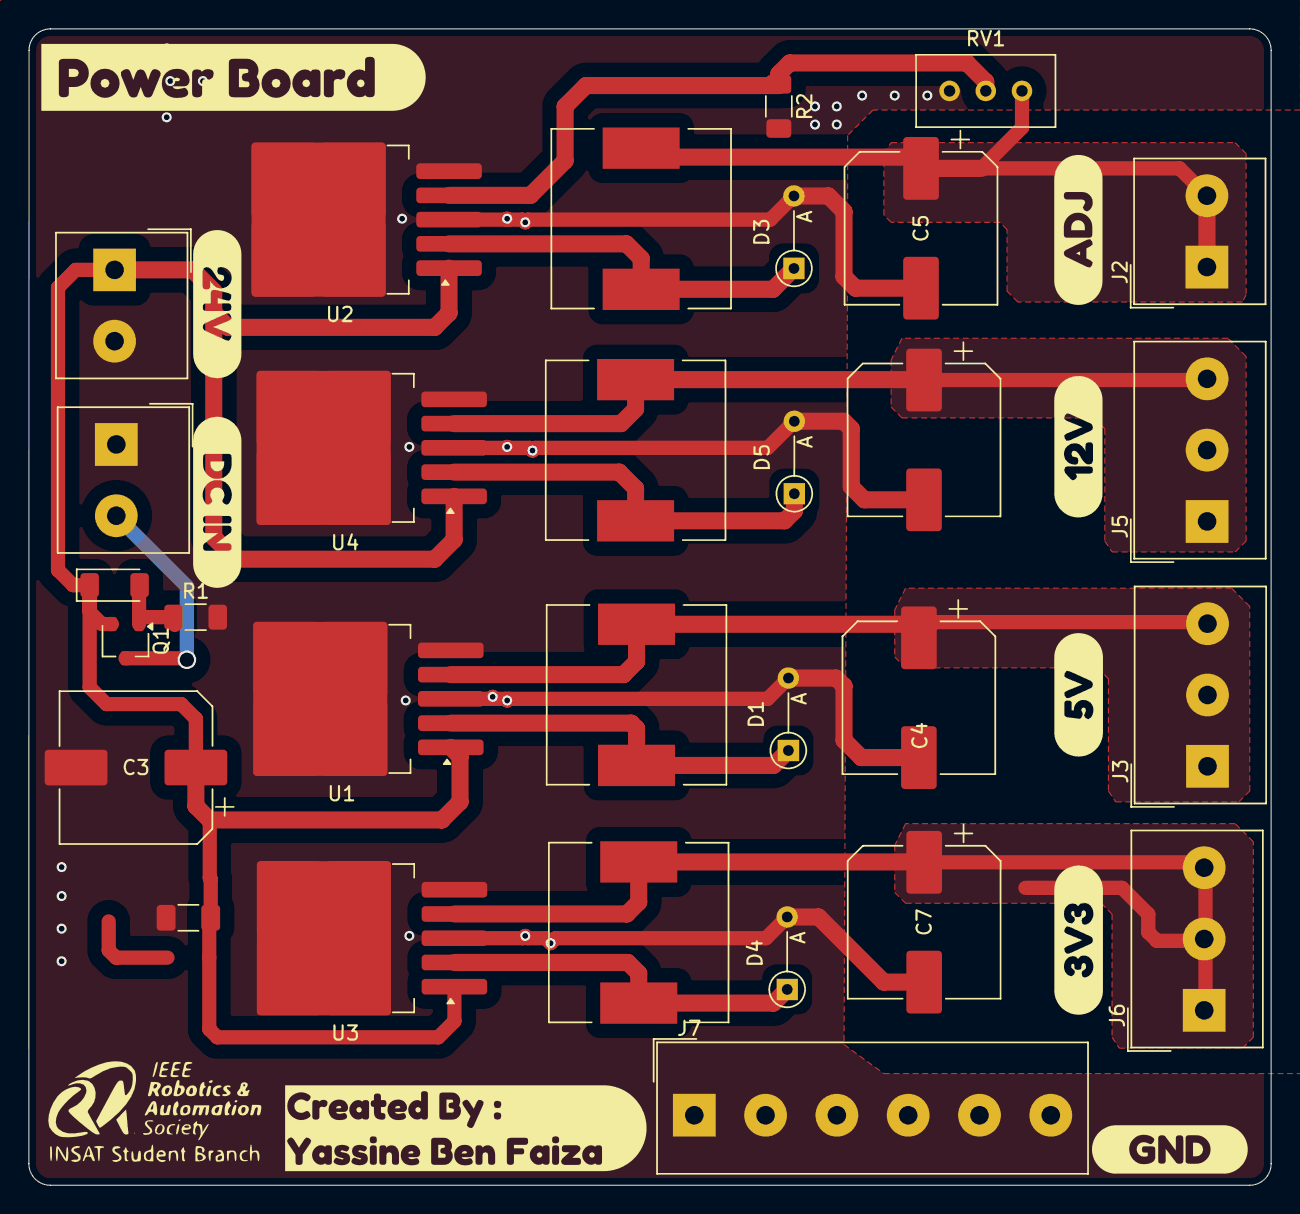
[picture p237: board resources/INSATEURO2026/Electrique/Carte Puissance PCB/puissance.kica… from above]

Board: 2 copper layers, 87.1 x 81.1 mm, 39 parts (0 on the bottom side), 13 nets.

Other parts of the board:
kibuzzard-68827F3E: G***; kibuzzard-68827F3E
kibuzzard-679253A4: G***; kibuzzard-679253A4
kibuzzard-679255E3: G***; kibuzzard-679255E3
kibuzzard-688280F0: G***; kibuzzard-688280F0
kibuzzard-6792564A: G***; kibuzzard-6792564A
kibuzzard-67925436: G***; kibuzzard-67925436
kibuzzard-67925609: G***; kibuzzard-67925609
kibuzzard-67925625: G***; kibuzzard-67925625
kibuzzard-67925638: G***; kibuzzard-67925638
