EUROBOT-27/MECANIQUE/resources/INSATEURO2026/Electrique/Carte Alimentation/Carte Alimentation.kicad_pcb

## KiCad design resources/INSATEURO2026/Electrique/Carte Alimentation/Carte Alimentation.kicad_pcb (2026-11-01)

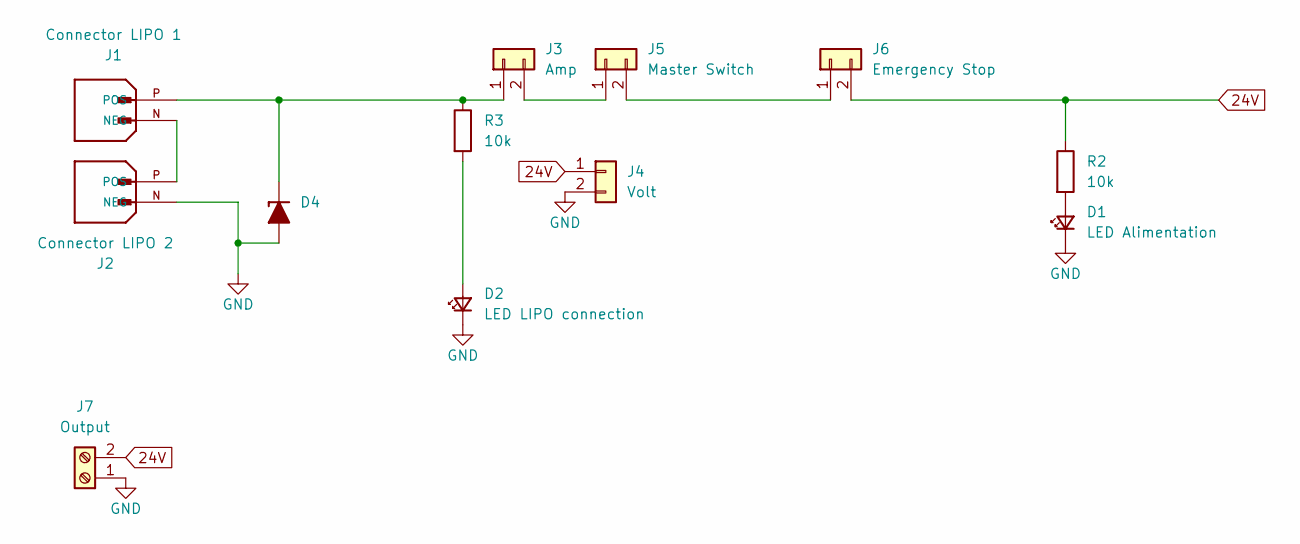
[picture p238: schematic Carte Alimentation.kicad_sch]

Parts:
D1: LED Alimentation; LED_D3.0mm
D2: LED LIPO connection; LED_D3.0mm
D4: P6KE24A; D_DO-15_P10.16mm_Horizontal_Zener
J1: Connector LIPO 1; AMASS_XT60-M; PARTREV V1.2
J2: Connector LIPO 2; AMASS_XT60-M; PARTREV V1.2
J3: Amp; JST_PH_B2B-PH-K_1x02_P2.00mm_Vertical
J4: Volt; JST_PH_B2B-PH-K_1x02_P2.00mm_Vertical; Part Number 1-0201FBV0T
J5: Master Switch; JST_PH_B2B-PH-K_1x02_P2.00mm_Vertical; Part Number 1-0201FBV0T
J6: Emergency Stop; JST_PH_B2B-PH-K_1x02_P2.00mm_Vertical; Part Number 1-0201FBV0T
J7: Output; TerminalBlock_Altech_AK300-2_P5.00mm
R2, R3: 10k; R_Axial_DIN0207_L6.3mm_D2.5mm_P10.16mm_Horizontal

Connections:
24V: J4.1, J6.2, J7.2, R2.1
GND: D1.1 (K), D2.1 (K), D4.2 (A), J2.N (NEG), J4.2, J7.1
unnamed: D1.2 (A), R2.2
unnamed: D2.2 (A), R3.2
unnamed: D4.1 (K), J1.P (POS), J3.1, R3.1
unnamed: J1.N (NEG), J2.P (POS)
unnamed: J3.2, J5.1
unnamed: J5.2, J6.1

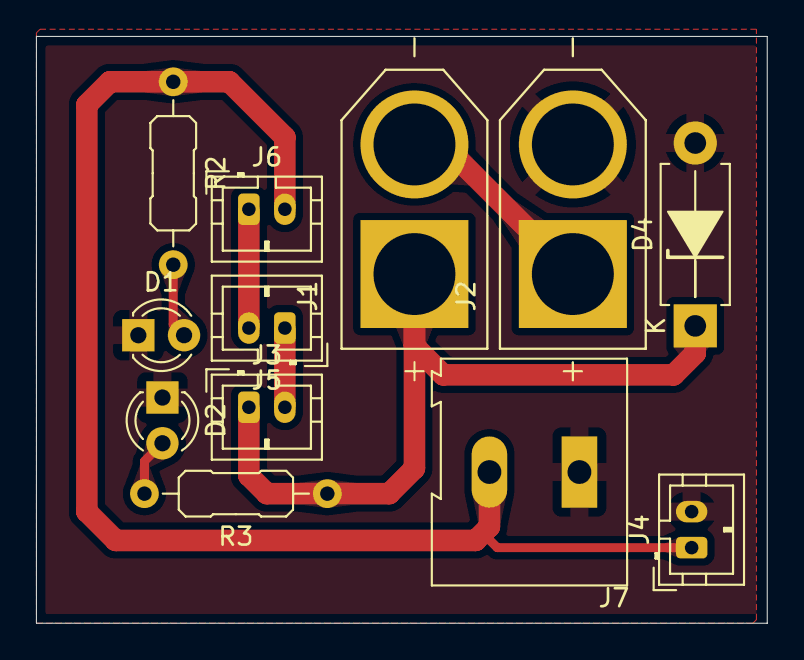
[picture p239: board Carte Alimentation.kicad_pcb from above]

Board: 2 copper layers, 40.6 x 32.6 mm, 12 parts (0 on the bottom side), 8 nets.
