EUROBOT-27/MECANIQUE/resources/INSATEURO2026/Electrique/Hamzaoui Side quest/Stepper/Stepper.kicad_pcb

## KiCad design resources/INSATEURO2026/Electrique/Hamzaoui Side quest/Stepper/Stepper.kicad_pcb (2026-11-01)

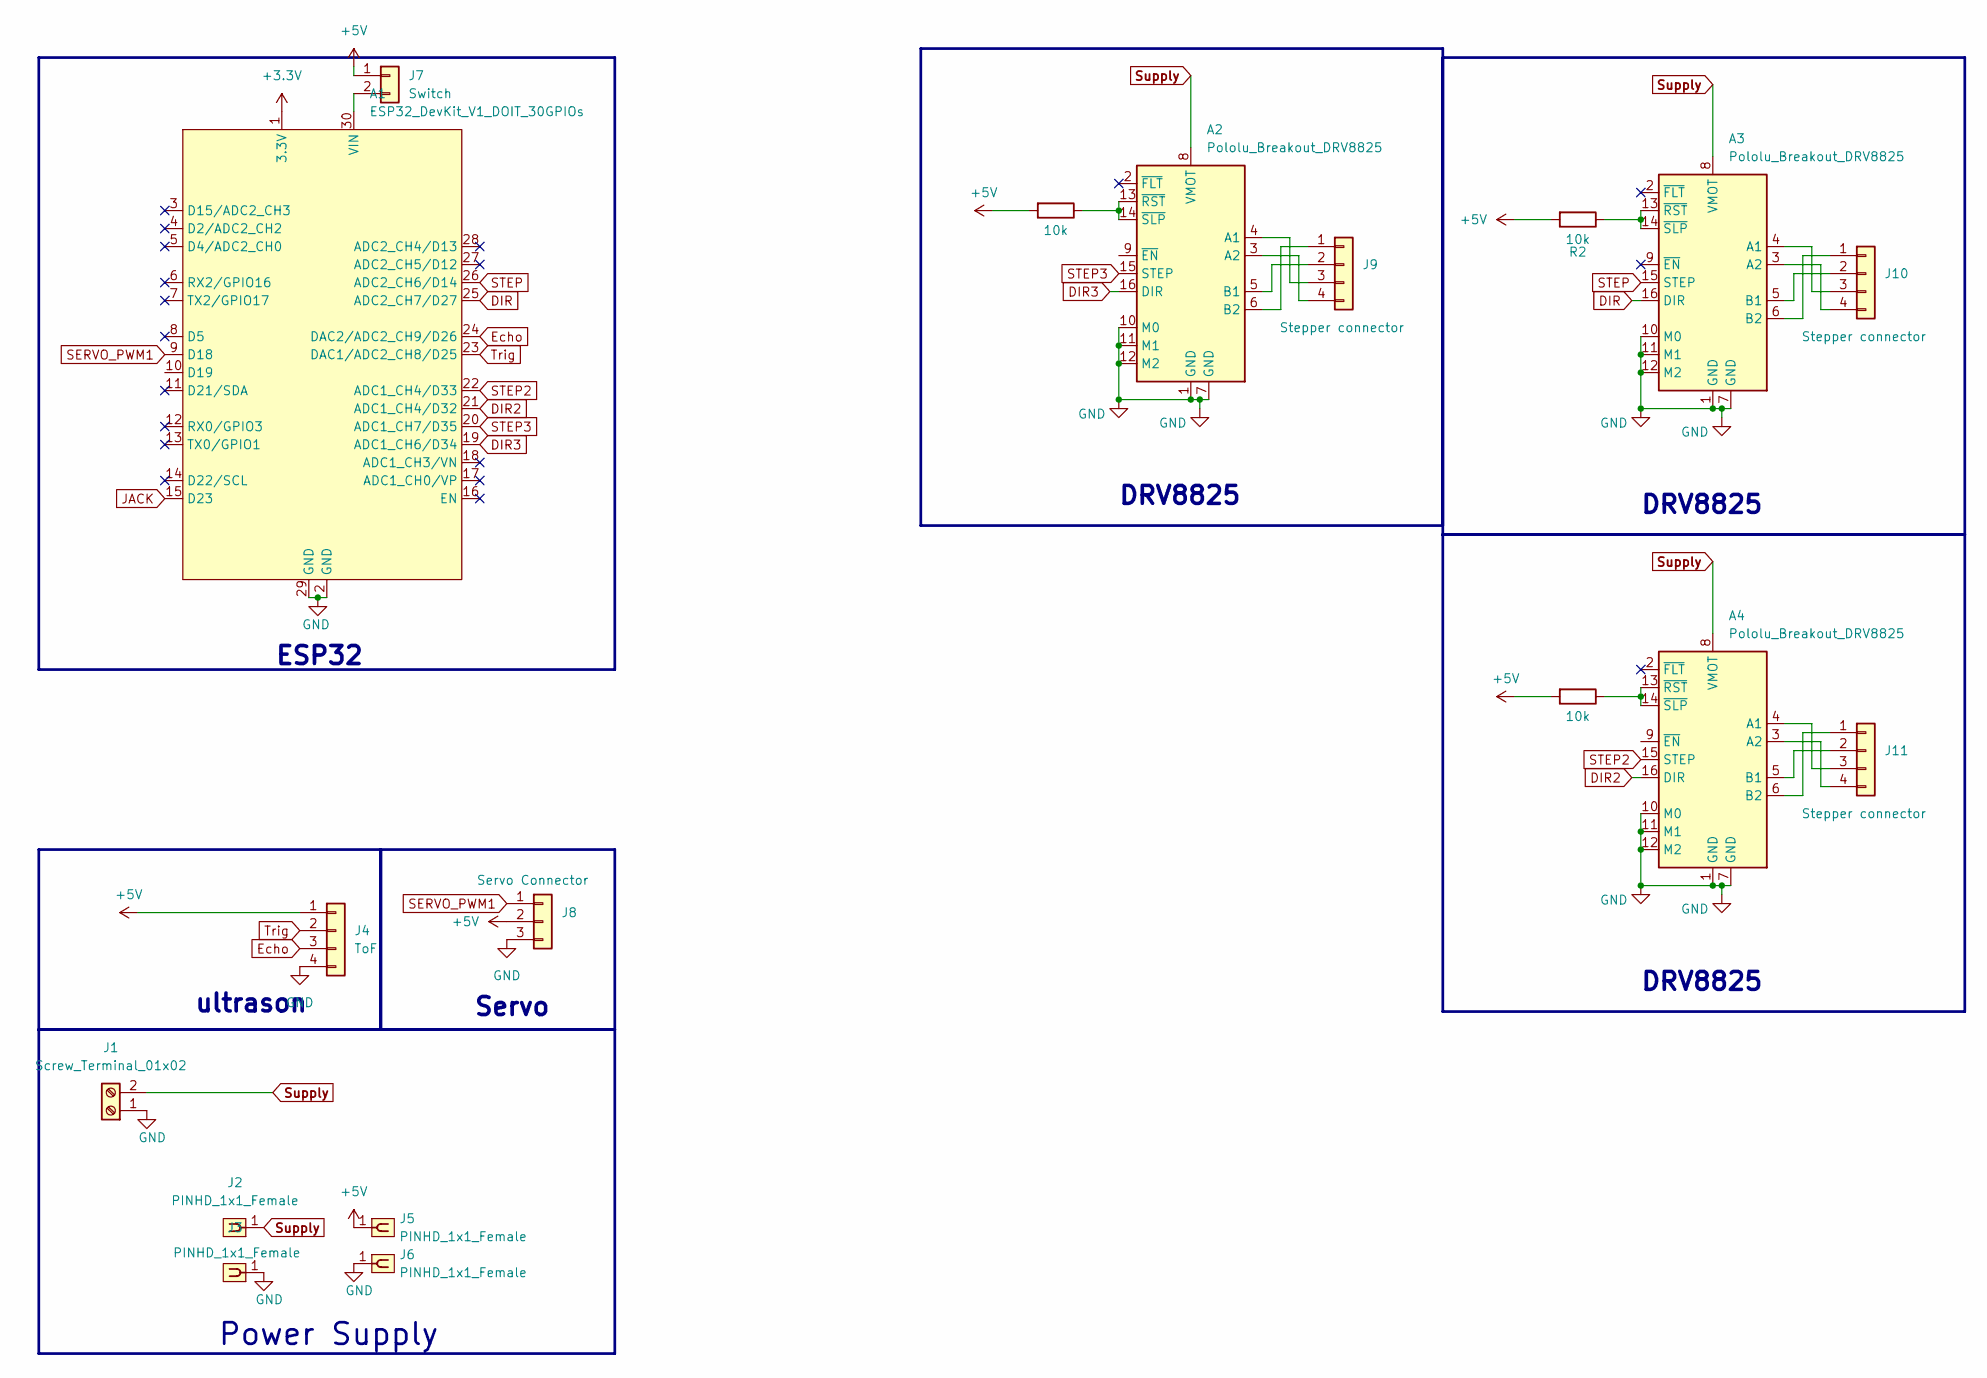
[picture p240: schematic Stepper.kicad_sch]

Parts:
A1: ESP32_DevKit_V1_DOIT_30GPIOs; DOIT_ESP32_DEVKIT_30Pins
A2, A3, A4: Pololu_Breakout_DRV8825; Pololu_Breakout-16_15.2x20.3mm
J1: Screw_Terminal_01x02; TerminalBlock_Altech_AK300-2_P5.00mm
J2, J3, J5, J6: PINHD_1x1_Female; PinSocket_1x01_P2.54mm_Vertical
J4: ToF; JST_EH_B4B-EH-A_1x04_P2.50mm_Vertical
J7: Switch; JST_PH_B2B-PH-K_1x02_P2.00mm_Vertical
J8: Servo Connector; PinHeader_1x03_P2.54mm_Vertical; Part Number 1-0301FBV0T
J9, J10, J11: Stepper connector; JST_EH_B4B-EH-A_1x04_P2.50mm_Vertical
R1, R2, R3: 10k; R_Axial_DIN0204_L3.6mm_D1.6mm_P7.62mm_Horizontal

Connections:
+3.3V: A1.1 (3.3V)
+5V: J4.1, J5.1, J7.1, J8.2, R1.2, R2.2, R3.2
DIR: A1.25 (ADC2_CH7/D27), A3.16 (DIR)
DIR2: A1.21 (ADC1_CH4/D32), A4.16 (DIR)
DIR3: A1.19 (ADC1_CH6/D34), A2.16 (DIR)
Echo: A1.24 (DAC2/ADC2_CH9/D26), J4.3
GND: A1.2 (GND), A1.29 (GND), A2.1 (GND), A2.7 (GND), A2.10 (M0), A2.11 (M1), A2.12 (M2), A3.1 (GND), A3.7 (GND), A3.10 (M0), A3.11 (M1), A3.12 (M2), A4.1 (GND), A4.7 (GND), A4.10 (M0), A4.11 (M1), A4.12 (M2), J1.1, J3.1, J4.4, J6.1, J8.3
JACK: A1.15 (D23)
unnamed: A1.30 (VIN), J7.2
unnamed: A2.4 (A1), J9.3
unnamed: A2.3 (A2), J9.4
unnamed: A2.5 (B1), J9.2
unnamed: A2.6 (B2), J9.1
unnamed: A2.13 (~RST), A2.14 (~SLP), R1.1
unnamed: A3.4 (A1), J10.3
unnamed: A3.3 (A2), J10.4
unnamed: A3.5 (B1), J10.2
unnamed: A3.6 (B2), J10.1
unnamed: A3.13 (~RST), A3.14 (~SLP), R2.1
unnamed: A4.4 (A1), J11.3
unnamed: A4.3 (A2), J11.4
unnamed: A4.5 (B1), J11.2
unnamed: A4.6 (B2), J11.1
unnamed: A4.13 (~RST), A4.14 (~SLP), R3.1
SERVO_PWM1: A1.9 (D18), J8.1
STEP: A1.26 (ADC2_CH6/D14), A3.15 (STEP)
STEP2: A1.22 (ADC1_CH4/D33), A4.15 (STEP)
STEP3: A1.20 (ADC1_CH7/D35), A2.15 (STEP)
Supply: A2.8 (VMOT), A3.8 (VMOT), A4.8 (VMOT), J1.2, J2.1
Trig: A1.23 (DAC1/ADC2_CH8/D25), J4.2

Notes on the sheet:
ultrason
Power Supply
ESP32
DRV8825
Servo

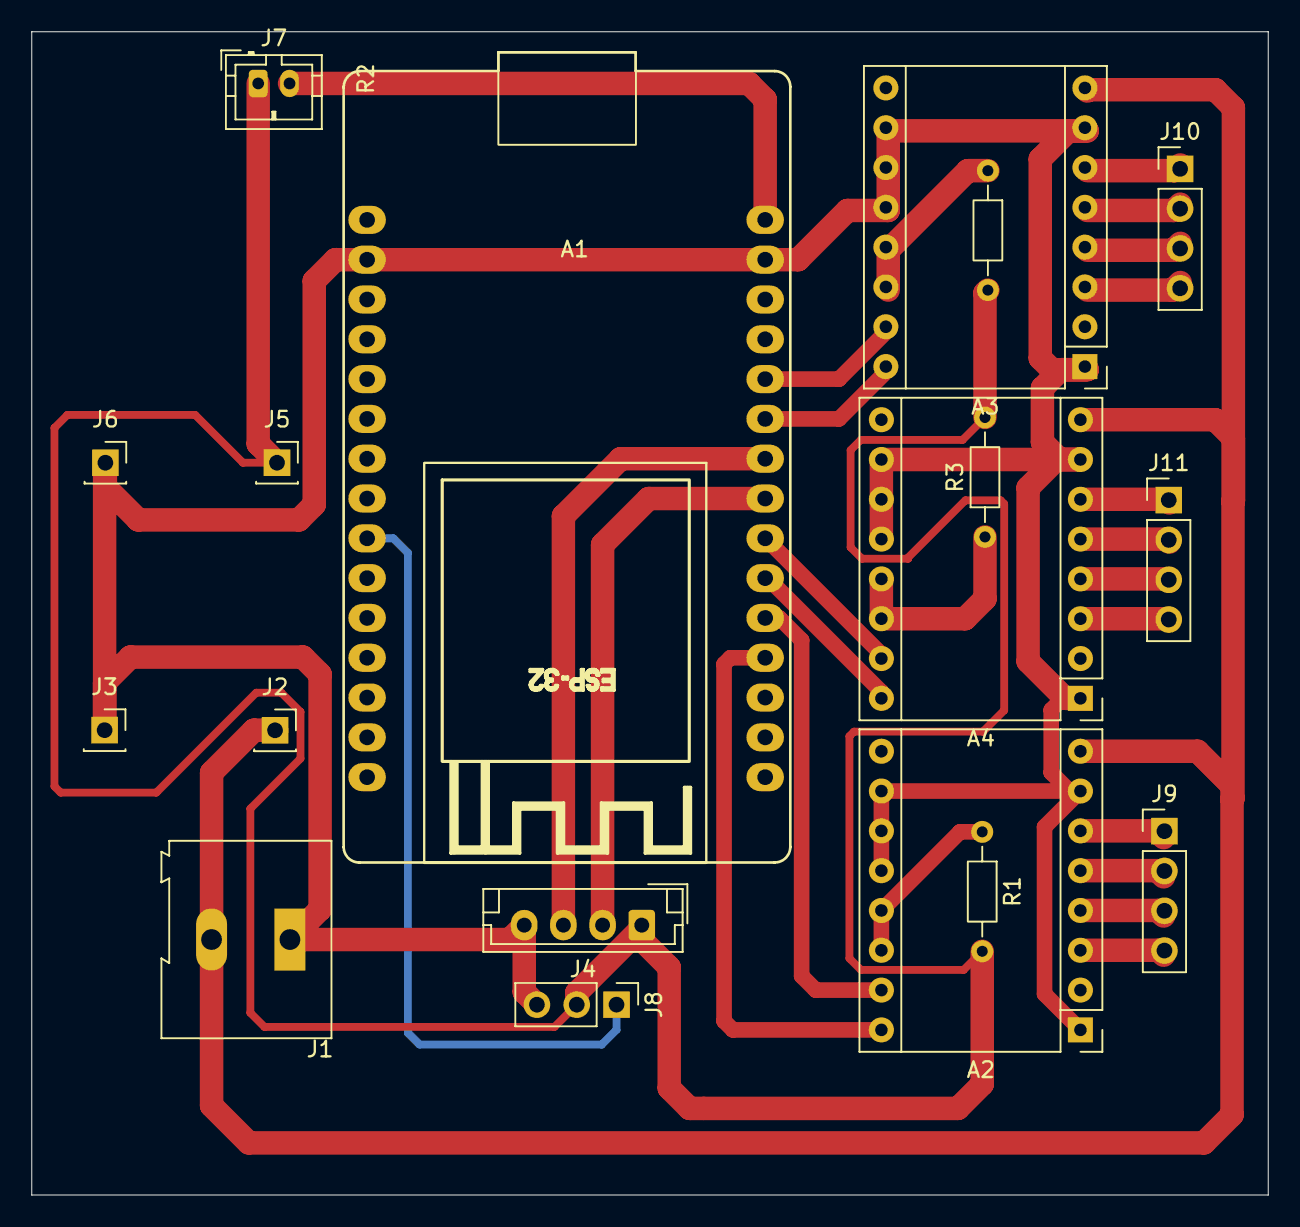
[picture p241: board Stepper.kicad_pcb from above]

Board: 2 copper layers, 78.9 x 74.2 mm, 18 parts (0 on the bottom side), 28 nets.
