EUROBOT-27/MECANIQUE/resources/INSATEURO2026/Electrique/PAMIS/Pami n20 V2/Chimique/Pami n20 Chimique-rev-89.kicad_pcb

## KiCad design resources/INSATEURO2026/Electrique/PAMIS/Pami n20 V2/Chimique/Pami n20 Chimique-rev-89.kicad_pcb (2026-11-01)

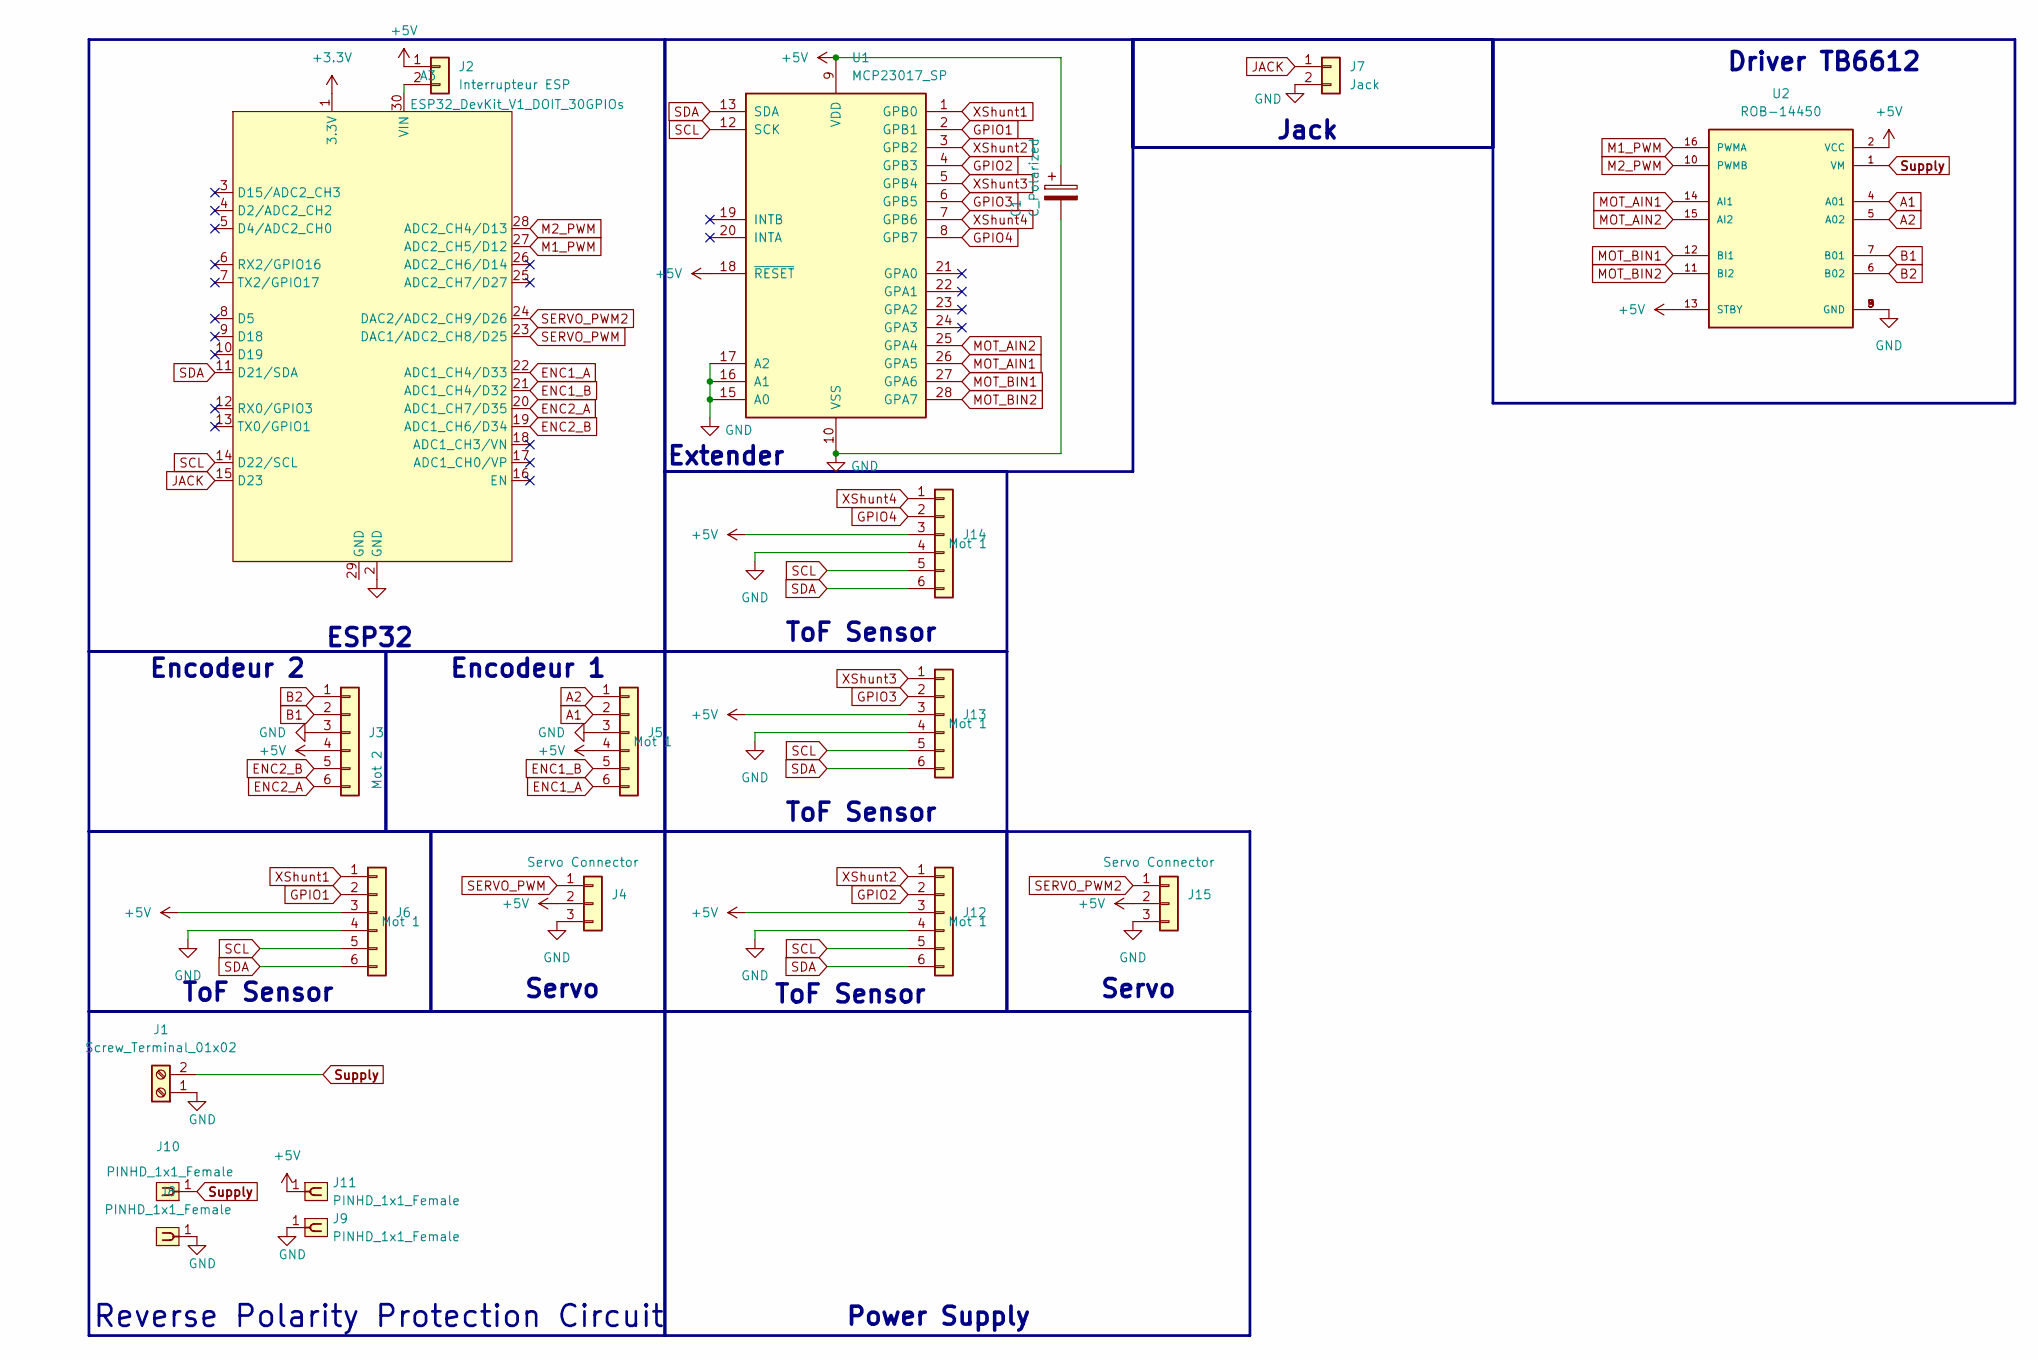
[picture p242: schematic Pami n20 Chimique-rev-89.kicad_sch, Carte PCB PAMIs]

Parts:
A3: ESP32_DevKit_V1_DOIT_30GPIOs; DOIT_ESP32_DEVKIT_30Pins
C1: C_Polarized; CP_Axial_L10.0mm_D4.5mm_P15.00mm_Horizontal
J1: Screw_Terminal_01x02; ScrewTerminal_1x02_P3.5mm_Blue
J2: Interrupteur ESP; JST_PH_B2B-PH-K_1x02_P2.00mm_Vertical
J3: Mot 2; JST_EH_B6B-EH-A_1x06_P2.50mm_Vertical; Part Number 1-0601FBV0T
J4, J15: Servo Connector; PinHeader_1x03_P2.54mm_Vertical; Part Number 1-0301FBV0T
J5, J6, J12, J13, J14: Mot 1; JST_EH_B6B-EH-A_1x06_P2.50mm_Vertical
J7: Jack; JST_EH_B6B-EH-A_1x06_P2.50mm_Vertical
J8, J9, J10, J11: PINHD_1x1_Female; PinSocket_1x01_P2.54mm_Vertical
U1: MCP23017_SP; DIP-28_W7.62mm_Socket
U2: ROB-14450; MODULE_ROB-14450; PARTREV 11-13-17

Connections:
+3.3V: A3.1 (3.3V)
+5V: A3.30 (VIN), C1.1, J2.1, J2.2, J3.4, J4.2, J5.4, J6.3, J11.1, J12.3, J13.3, J14.3, J15.2, U1.9 (VDD), U1.18 (~RESET), U2.2 (VCC), U2.13 (STBY)
A1: J5.2, U2.4 (A01)
A2: J5.1, U2.5 (A02)
B1: J3.2, U2.7 (B01)
B2: J3.1, U2.6 (B02)
ENC1_A: A3.22 (ADC1_CH4/D33), J5.6
ENC1_B: A3.21 (ADC1_CH4/D32), J5.5
ENC2_A: A3.20 (ADC1_CH7/D35), J3.6
ENC2_B: A3.19 (ADC1_CH6/D34), J3.5
GND: A3.2 (GND), C1.2, J1.1, J3.3, J4.3, J5.3, J6.4, J7.2, J8.1, J9.1, J12.4, J13.4, J14.4, J15.3, U1.10 (VSS), U1.15 (A0), U1.16 (A1), U1.17 (A2), U2.3 (GND), U2.8 (GND), U2.9 (GND)
GPIO1: J6.2, U1.2 (GPB1)
GPIO2: J12.2, U1.4 (GPB3)
GPIO3: J13.2, U1.6 (GPB5)
GPIO4: J14.2, U1.8 (GPB7)
JACK: A3.15 (D23), J7.1
M1_PWM: A3.27 (ADC2_CH5/D12), U2.16 (PWMA)
M2_PWM: A3.28 (ADC2_CH4/D13), U2.10 (PWMB)
MOT_AIN1: U1.26 (GPA5), U2.14 (AI1)
MOT_AIN2: U1.25 (GPA4), U2.15 (AI2)
MOT_BIN1: U1.27 (GPA6), U2.12 (BI1)
MOT_BIN2: U1.28 (GPA7), U2.11 (BI2)
SCL: A3.14 (D22/SCL), J6.5, J12.5, J13.5, J14.5, U1.12 (SCK)
SDA: A3.11 (D21/SDA), J6.6, J12.6, J13.6, J14.6, U1.13 (SDA)
SERVO_PWM: A3.23 (DAC1/ADC2_CH8/D25), J4.1
SERVO_PWM2: A3.24 (DAC2/ADC2_CH9/D26), J15.1
Supply: J1.2, J10.1, U2.1 (VM)
XShunt1: J6.1, U1.1 (GPB0)
XShunt2: J12.1, U1.3 (GPB2)
XShunt3: J13.1, U1.5 (GPB4)
XShunt4: J14.1, U1.7 (GPB6)

Notes on the sheet:
Servo
ToF Sensor
Jack
ESP32
Power Supply
Extender
Reverse Polarity Protection Circuit
Driver TB6612
Encodeur 1
Encodeur 2

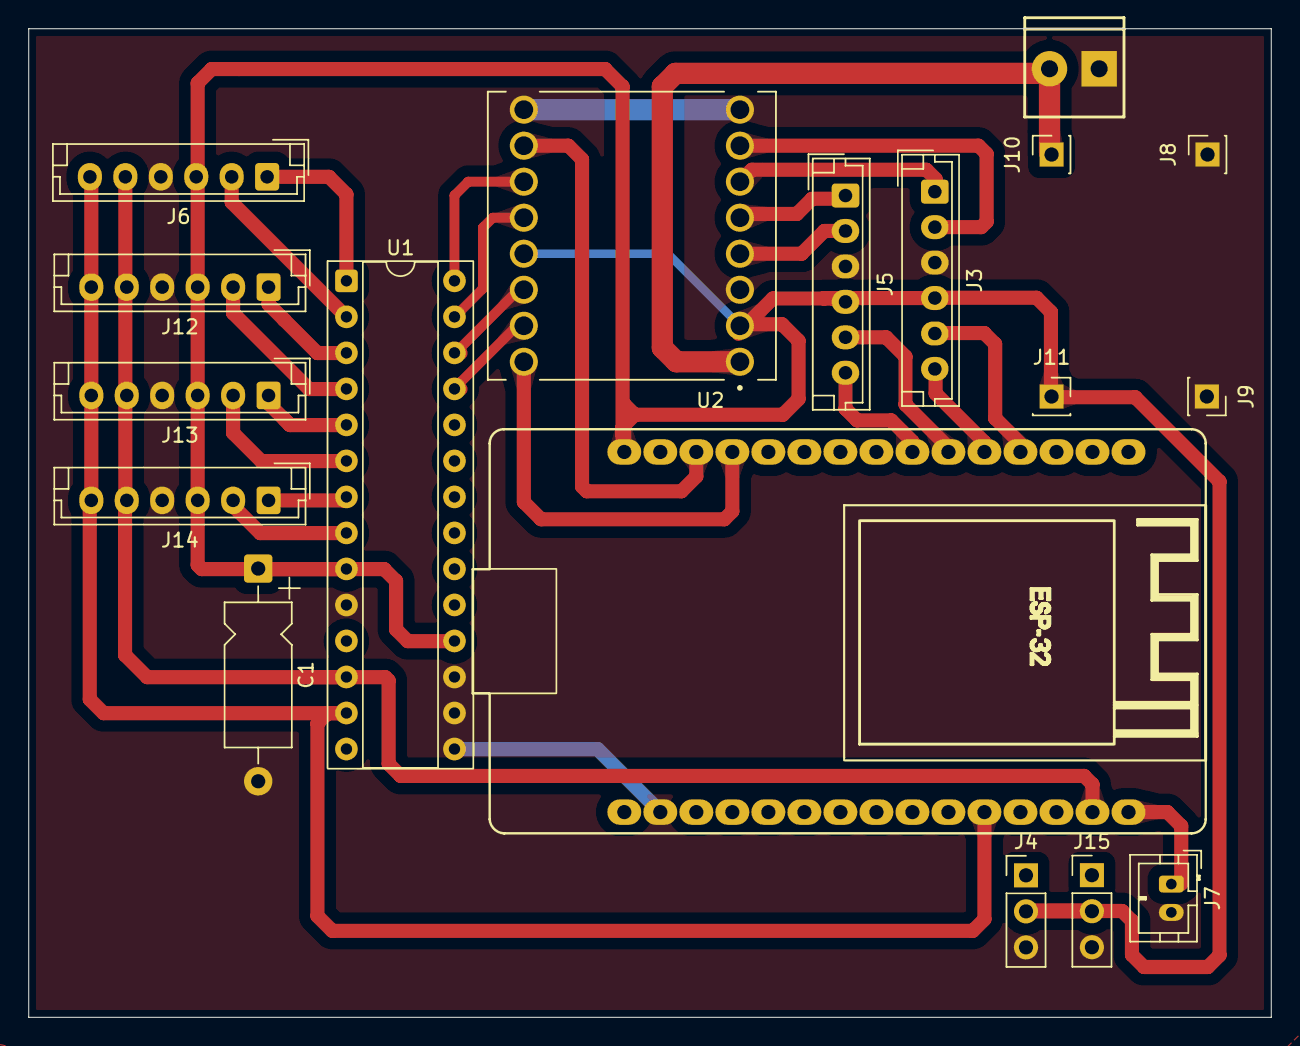
[picture p243: board Pami n20 Chimique-rev-89.kicad_pcb from above]

Board: 2 copper layers, 87.6 x 69.7 mm, 18 parts (0 on the bottom side), 30 nets.
