EUROBOT-27/MECANIQUE/resources/INSATEURO2026/Electrique/Controlleur electrovanne/electrovanne/electrovanne.kicad_pcb

## KiCad design resources/INSATEURO2026/Electrique/Controlleur electrovanne/electrovanne/electrovanne.kicad_pcb (2026-11-01)

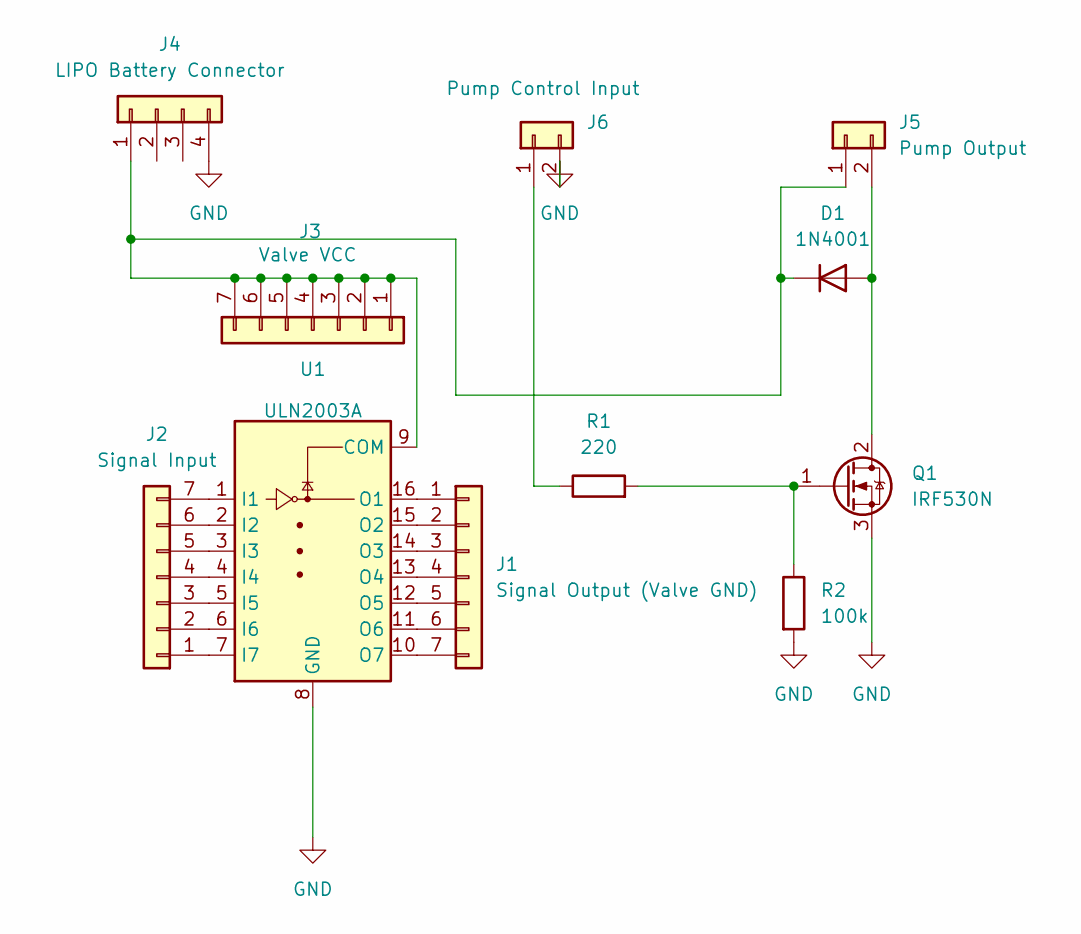
[picture p244: schematic electrovanne.kicad_sch]

Parts:
D1: 1N4001; D_DO-41_SOD81_P7.62mm_Horizontal
J1: Signal Output (Valve GND); PinSocket_1x08_P2.00mm_Vertical
J2: Signal Input; PinSocket_1x08_P2.00mm_Vertical
J3: Valve VCC; PinSocket_1x08_P2.00mm_Vertical
J4: LIPO Battery Connector; JST_XH_B4B-XH-A_1x04_P2.50mm_Vertical
J5: Pump Output; JST_EH_B2B-EH-A_1x02_P2.50mm_Vertical
J6: Pump Control Input; PinHeader_1x02_P1.00mm_Vertical
Q1: IRF530N; TO-220-3_Vertical
R1: 220; R_Axial_DIN0207_L6.3mm_D2.5mm_P15.24mm_Horizontal
R2: 100k; R_Axial_DIN0207_L6.3mm_D2.5mm_P15.24mm_Horizontal
U1: ULN2003A; DIP-16_W7.62mm

Connections:
GND: J4.4, J6.2, Q1.3 (S), R2.2, U1.8 (GND)
unnamed: D1.2 (A), J5.2, Q1.2 (D)
unnamed: D1.1 (K), J3.1, J3.2, J3.3, J3.4, J3.5, J3.6, J3.7, J4.1, J5.1, U1.9 (COM)
unnamed: J1.1, U1.16 (O1)
unnamed: J1.2, U1.15 (O2)
unnamed: J1.3, U1.14 (O3)
unnamed: J1.4, U1.13 (O4)
unnamed: J1.5, U1.12 (O5)
unnamed: J1.6, U1.11 (O6)
unnamed: J1.7, U1.10 (O7)
unnamed: J2.1, U1.7 (I7)
unnamed: J2.2, U1.6 (I6)
unnamed: J2.3, U1.5 (I5)
unnamed: J2.4, U1.4 (I4)
unnamed: J2.5, U1.3 (I3)
unnamed: J2.6, U1.2 (I2)
unnamed: J2.7, U1.1 (I1)
unnamed: J6.1, R1.1
unnamed: Q1.1 (G), R1.2, R2.1

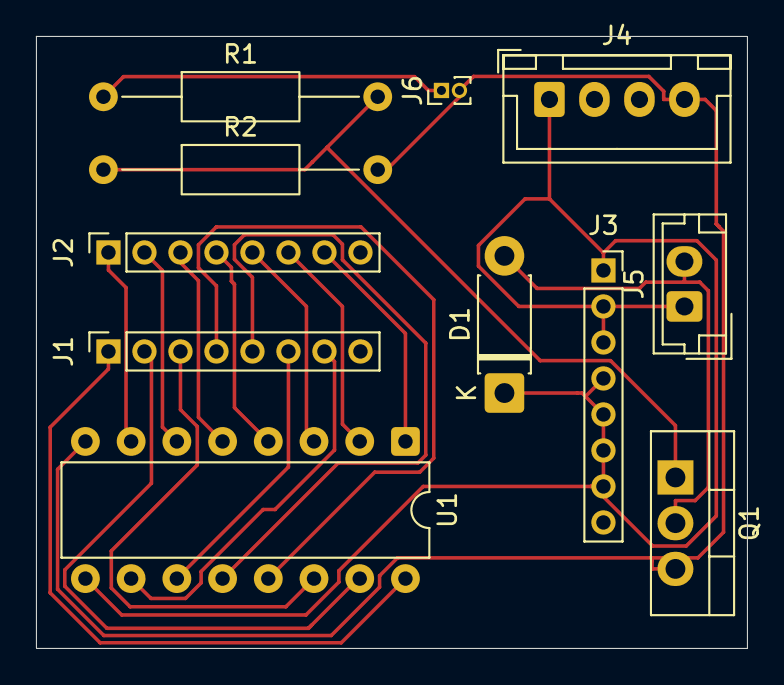
[picture p245: board electrovanne.kicad_pcb from above]

Board: 2 copper layers, 39.5 x 34.0 mm, 11 parts (0 on the bottom side), 19 nets.
