EUROBOT-27/MECANIQUE/resources/Aero Euro/PCBs/Pami_ESP32/Pami_ESP32.kicad_pcb

## KiCad design resources/Aero Euro/PCBs/Pami_ESP32/Pami_ESP32.kicad_pcb (2026-11-01)

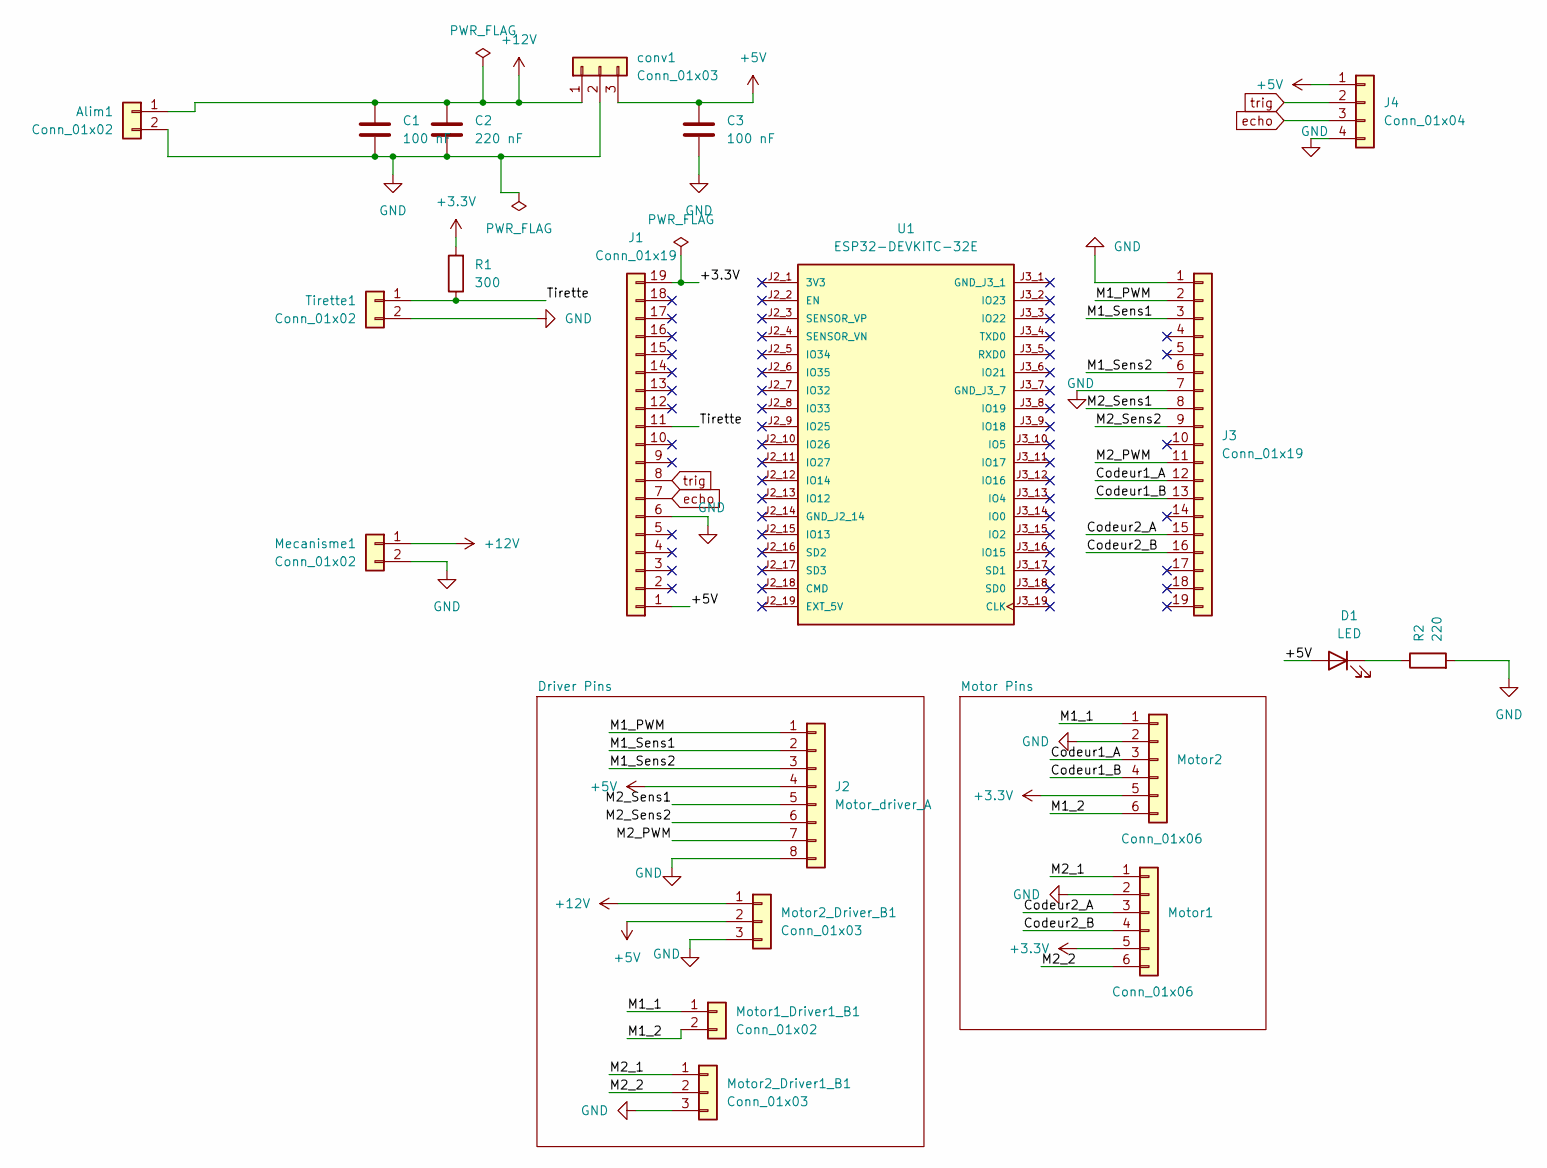
[picture p246: schematic Pami_ESP32.kicad_sch]

Parts:
Alim1: Conn_01x02; TerminalBlock_MaiXu_MX126-5.0-02P_1x02_P5.00mm
C1, C3: 100 nF; C_Radial_D6.3mm_H5.0mm_P2.50mm
C2: 220 nF; C_Radial_D6.3mm_H5.0mm_P2.50mm
D1: LED; LED_D4.0mm
J1, J3: Conn_01x19; PinSocket_1x19_P2.54mm_Vertical
J2: Motor_driver_A; PinHeader_1x08_P2.54mm_Vertical
J4: Conn_01x04; PinHeader_1x04_P2.54mm_Vertical
Mecanisme1: Conn_01x02; TerminalBlock_MaiXu_MX126-5.0-02P_1x02_P5.00mm
Motor1, Motor2: Conn_01x06; PinHeader_1x06_P2.54mm_Vertical
Motor1_Driver1_B1: Conn_01x02; PinHeader_1x02_P2.54mm_Vertical
Motor2_Driver1_B1, Motor2_Driver_B1: Conn_01x03; PinHeader_1x03_P2.54mm_Vertical
R1: 300; R_Axial_DIN0207_L6.3mm_D2.5mm_P7.62mm_Horizontal
R2: 220; R_Axial_DIN0207_L6.3mm_D2.5mm_P7.62mm_Horizontal
Tirette1: Conn_01x02; PinHeader_1x02_P2.54mm_Vertical
U1: ESP32-DEVKITC-32E; PARTREV 1.4
conv1: Conn_01x03; PinHeader_1x03_P2.54mm_Vertical

Connections:
+3.3V: J1.19, Motor1.5, Motor2.5, R1.2
+5V: C3.1, D1.2 (A), J1.1, J2.4, J4.1, Motor2_Driver_B1.2, conv1.3
+12V: Alim1.1, C1.1, C2.1, Mecanisme1.1, Motor2_Driver_B1.1, conv1.1
/Codeur1_A: J3.12, Motor2.3
/Codeur1_B: J3.13, Motor2.4
/Codeur2_A: J3.15, Motor1.3
/Codeur2_B: J3.16, Motor1.4
/M1_1: Motor1_Driver1_B1.1, Motor2.1
/M1_2: Motor1_Driver1_B1.2, Motor2.6
/M1_PWM: J2.1, J3.2
/M1_Sens1: J2.2, J3.3
/M1_Sens2: J2.3, J3.6
/M2_1: Motor1.1, Motor2_Driver1_B1.1
/M2_2: Motor1.6, Motor2_Driver1_B1.2
/M2_PWM: J2.7, J3.11
/M2_Sens1: J2.5, J3.8
/M2_Sens2: J2.6, J3.9
/Tirette: J1.11, R1.1, Tirette1.1
GND: Alim1.2, C1.2, C2.2, C3.2, J1.6, J2.8, J3.1, J3.7, J4.4, Mecanisme1.2, Motor1.2, Motor2.2, Motor2_Driver1_B1.3, Motor2_Driver_B1.3, R2.2, Tirette1.2, conv1.2
unnamed: D1.1 (K), R2.1
echo: J1.7, J4.3
trig: J1.8, J4.2

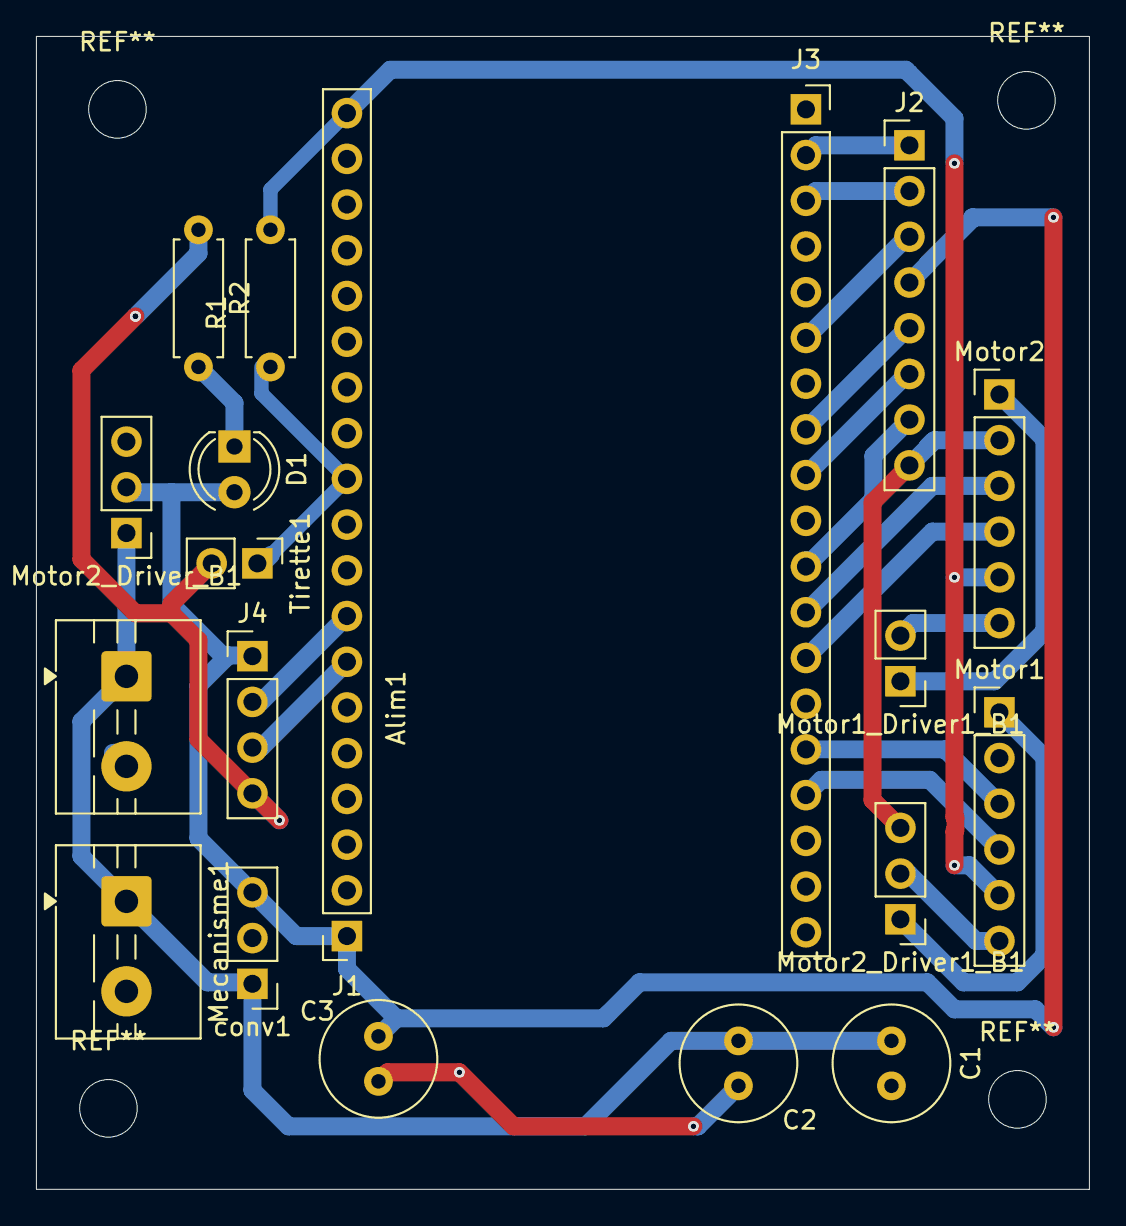
[picture p247: board Pami_ESP32.kicad_pcb from above]

Board: 2 copper layers, 58.5 x 64.0 mm, 19 parts (0 on the bottom side), 22 nets.
