EUROBOT-27/MECANIQUE/resources/Aero Euro/PCBs/carte distribution/carte distribution.kicad_pcb

## KiCad design resources/Aero Euro/PCBs/carte distribution/carte distribution.kicad_pcb (2026-11-01)

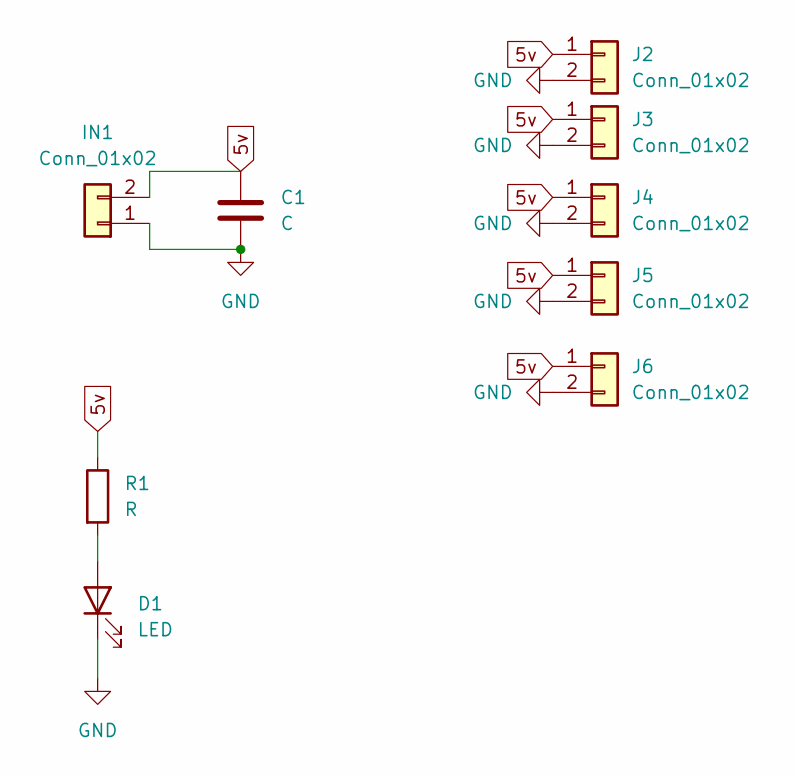
[picture p248: schematic carte distribution.kicad_sch]

Parts:
C1: C; C_Radial_D6.3mm_H5.0mm_P2.50mm
D1: LED; LED_D4.0mm
IN1: Conn_01x02; TerminalBlock_MaiXu_MX126-5.0-02P_1x02_P5.00mm
J2, J3, J4, J5, J6: Conn_01x02; TerminalBlock_MaiXu_MX126-5.0-02P_1x02_P5.00mm
R1: R; R_Axial_DIN0207_L6.3mm_D2.5mm_P7.62mm_Horizontal

Connections:
5v: C1.1, IN1.2, J2.1, J3.1, J4.1, J5.1, J6.1, R1.1
GND: C1.2, D1.1 (K), IN1.1, J2.2, J3.2, J4.2, J5.2, J6.2
unnamed: D1.2 (A), R1.2

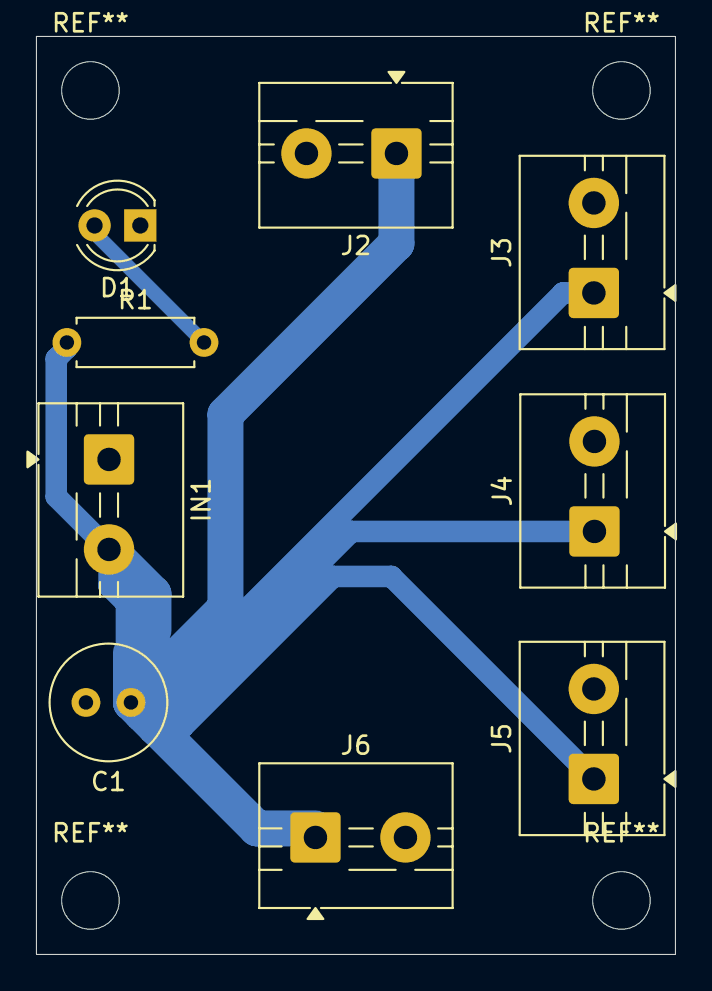
[picture p249: board carte distribution.kicad_pcb from above]

Board: 2 copper layers, 35.5 x 51.0 mm, 9 parts (0 on the bottom side), 3 nets.
