EUROBOT-27/MECANIQUE/resources/Aero Euro/PCBs/carte servo/carte servo.kicad_pcb

## KiCad design resources/Aero Euro/PCBs/carte servo/carte servo.kicad_pcb (2026-11-01)

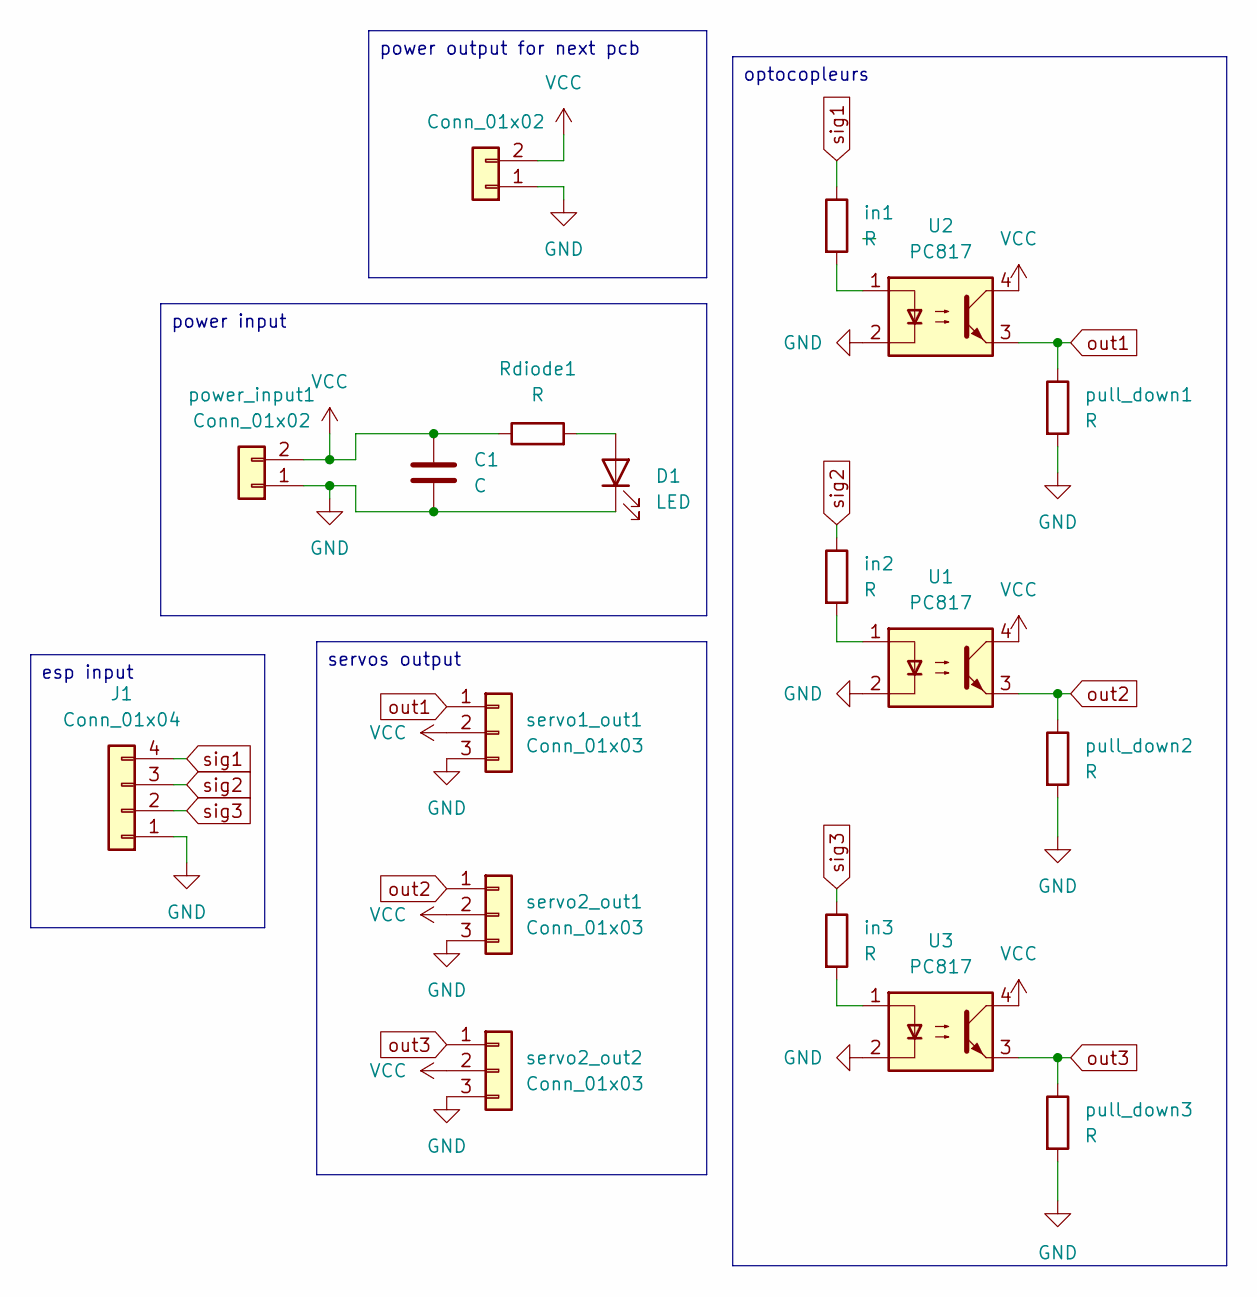
[picture p250: schematic carte servo.kicad_sch]

Parts:
C1: C; C_Radial_D6.3mm_H5.0mm_P2.50mm
D1: LED; LED_D4.0mm
J1: Conn_01x04; PinHeader_1x04_P2.54mm_Vertical
Rdiode1: R; R_Axial_DIN0207_L6.3mm_D2.5mm_P7.62mm_Horizontal
U1, U2, U3: PC817; DIP-4_W7.62mm
in1, in2, in3: R; R_Axial_DIN0207_L6.3mm_D2.5mm_P7.62mm_Horizontal
power_input1: Conn_01x02; TerminalBlock_MaiXu_MX126-5.0-02P_1x02_P5.00mm
power_output1: Conn_01x02; TerminalBlock_MaiXu_MX126-5.0-02P_1x02_P5.00mm
pull_down1, pull_down2, pull_down3: R; R_Axial_DIN0207_L6.3mm_D2.5mm_P7.62mm_Horizontal
servo1_out1, servo2_out1, servo2_out2: Conn_01x03; PinHeader_1x03_P2.54mm_Vertical

Connections:
GND: C1.2, D1.1 (K), J1.1, U1.2, U2.2, U3.2, power_input1.1, power_output1.1, pull_down1.2, pull_down2.2, pull_down3.2, servo1_out1.3, servo2_out1.3, servo2_out2.3
unnamed: D1.2 (A), Rdiode1.2
unnamed: U1.1, in2.2
unnamed: U2.1, in1.2
unnamed: U3.1, in3.2
VCC: C1.1, Rdiode1.1, U1.4, U2.4, U3.4, power_input1.2, power_output1.2, servo1_out1.2, servo2_out1.2, servo2_out2.2
out1: U2.3, pull_down1.1, servo1_out1.1
out2: U1.3, pull_down2.1, servo2_out1.1
out3: U3.3, pull_down3.1, servo2_out2.1
sig1: J1.4, in1.1
sig2: J1.3, in2.1
sig3: J1.2, in3.1

Notes on the sheet:
power input
optocopleurs
esp input
servos output
power output for next pcb

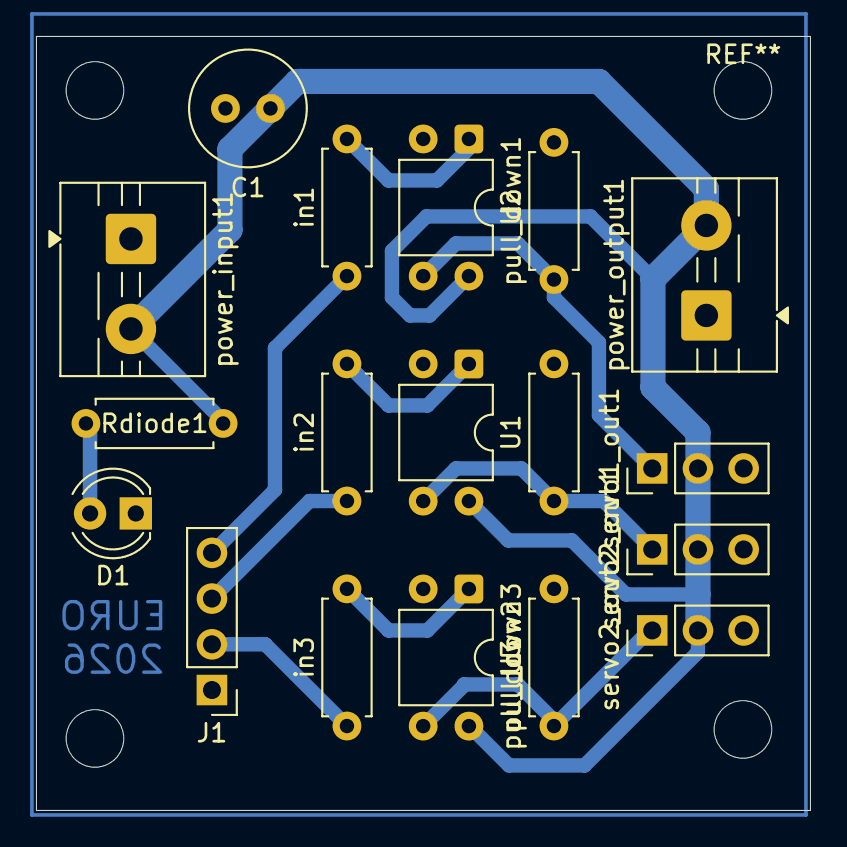
[picture p251: board carte servo.kicad_pcb from above]

Board: 2 copper layers, 43.0 x 43.0 mm, 18 parts (0 on the bottom side), 12 nets.
