EUROBOT-27/MECANIQUE/resources/Aero Euro/PCBs/Carte Mosfet/Carte Mosfet.kicad_pcb

## KiCad design resources/Aero Euro/PCBs/Carte Mosfet/Carte Mosfet.kicad_pcb (2026-11-01)

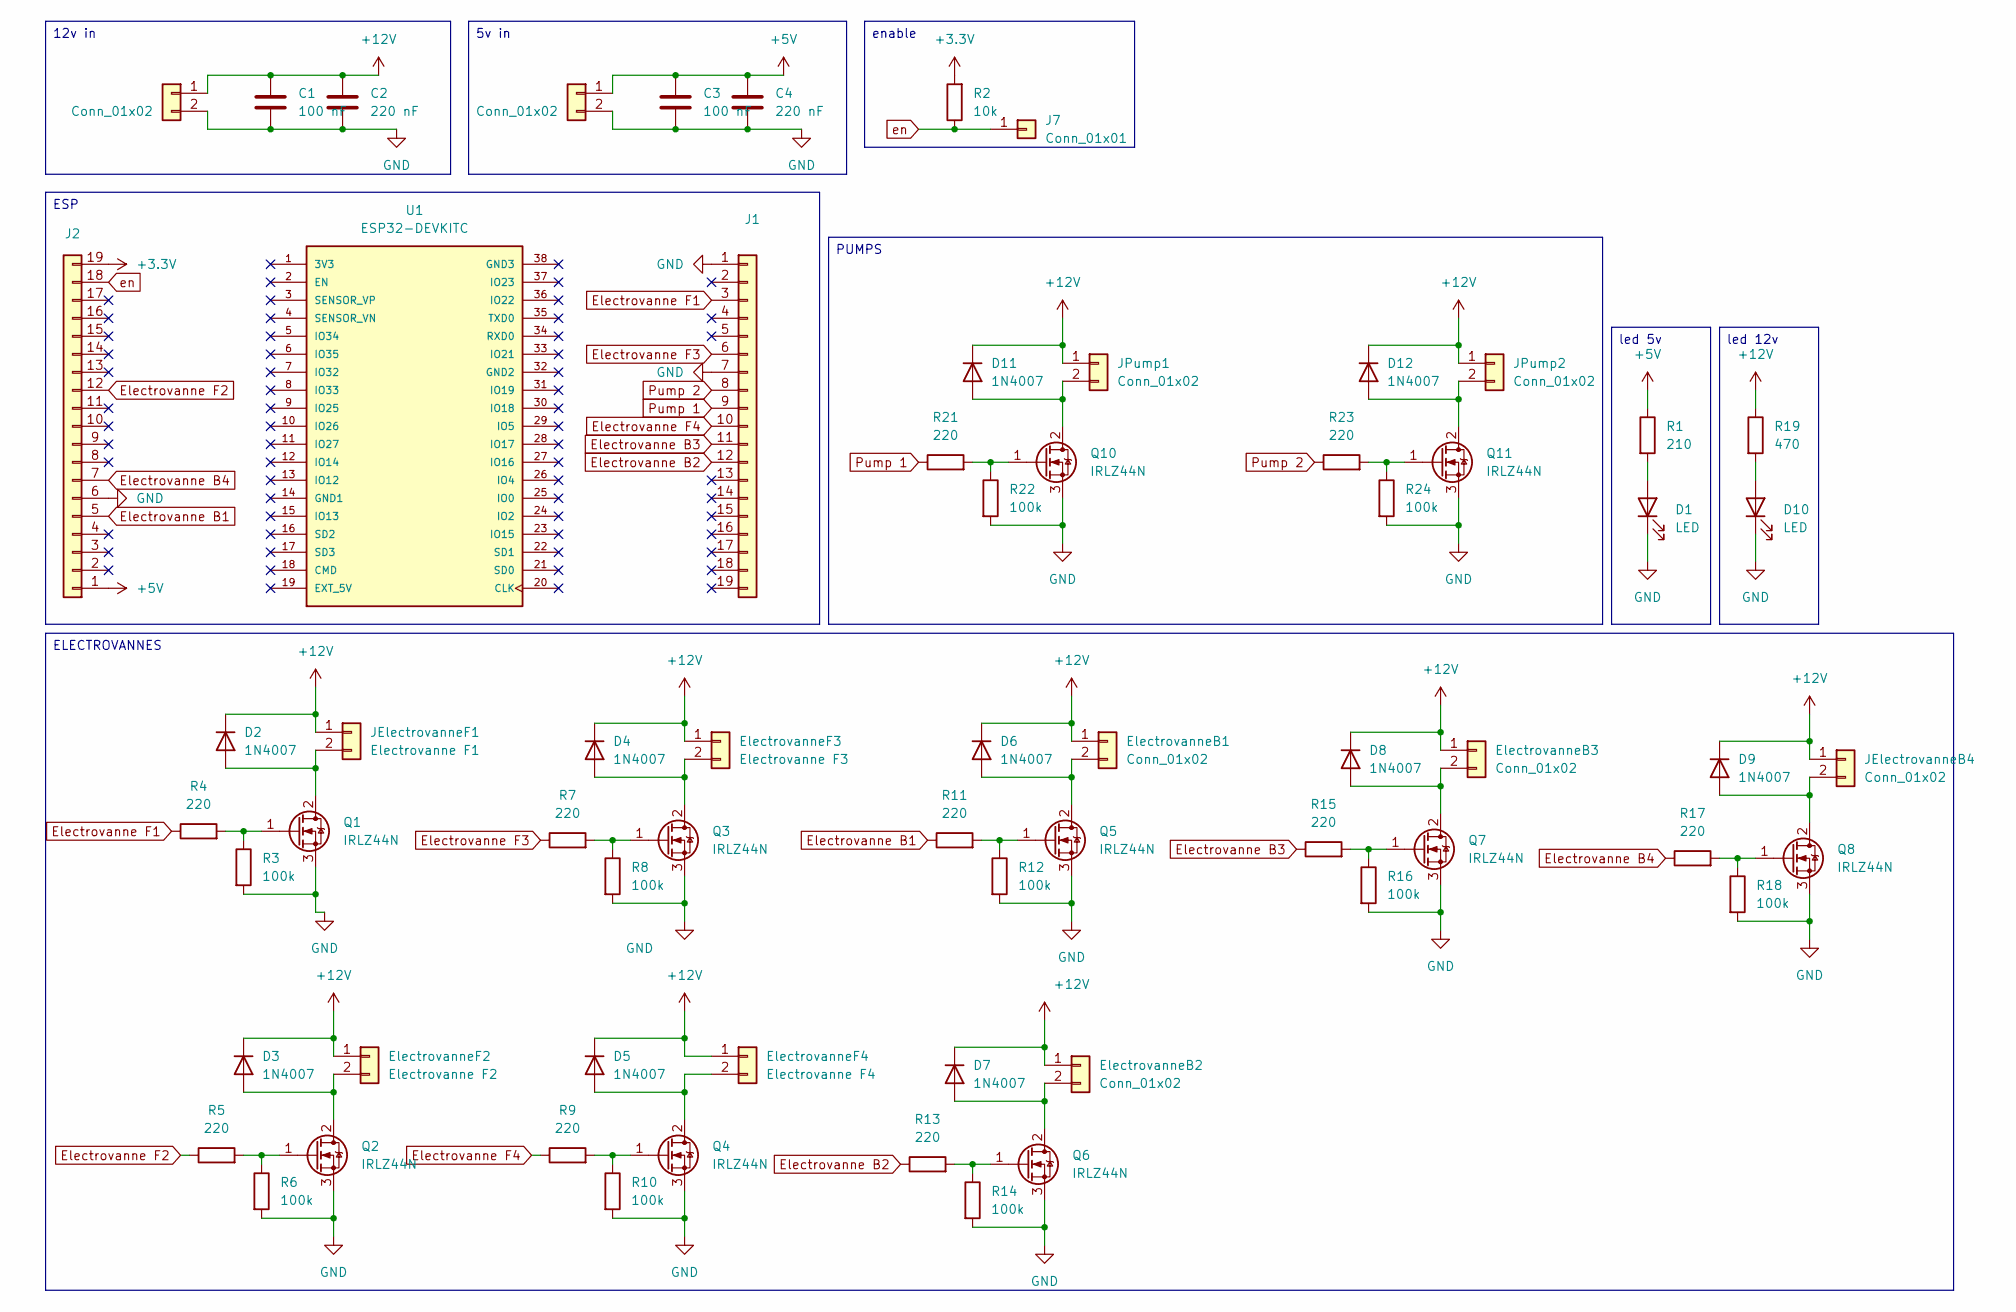
[picture p252: schematic Carte Mosfet.kicad_sch]

Parts:
Alim1, Alim2: Conn_01x02; TerminalBlock_MaiXu_MX126-5.0-02P_1x02_P5.00mm
C1, C3: 100 nF; C_Radial_D6.3mm_H5.0mm_P2.50mm
C2, C4: 220 nF; C_Radial_D6.3mm_H5.0mm_P2.50mm
D1, D10: LED; LED_D4.0mm
D2, D3, D4, D5, D6, D7, D8, D9, D11, D12: 1N4007; D_DO-41_SOD81_P10.16mm_Horizontal
ElectrovanneB1, ElectrovanneB2, ElectrovanneB3: Conn_01x02; JST_XH_B2B-XH-A_1x02_P2.50mm_Vertical
ElectrovanneF2: Electrovanne F2; JST_XH_B2B-XH-A_1x02_P2.50mm_Vertical
ElectrovanneF3: Electrovanne F3; JST_XH_B2B-XH-A_1x02_P2.50mm_Vertical
ElectrovanneF4: Electrovanne F4; JST_XH_B2B-XH-A_1x02_P2.50mm_Vertical
J1, J2: Conn_01x19; PinSocket_1x19_P2.54mm_Vertical
J7: Conn_01x01; JST_XH_B2B-XH-A_1x02_P2.50mm_Vertical
JElectrovanneB4: Conn_01x02; JST_XH_B2B-XH-A_1x02_P2.50mm_Vertical
JElectrovanneF1: Electrovanne F1; JST_XH_B2B-XH-A_1x02_P2.50mm_Vertical
JPump1, JPump2: Conn_01x02; JST_XH_B2B-XH-A_1x02_P2.50mm_Vertical
Q1, Q2, Q3, Q4, Q5, Q6, Q7, Q8, Q10, Q11: IRLZ44N; TO-220-3_Vertical
R1: 210; R_Axial_DIN0207_L6.3mm_D2.5mm_P7.62mm_Horizontal
R2: 10k; R_Axial_DIN0207_L6.3mm_D2.5mm_P7.62mm_Horizontal
R3, R6, R8, R10, R12, R14, R16, R18, R22, R24: 100k; R_Axial_DIN0207_L6.3mm_D2.5mm_P7.62mm_Horizontal
R4, R5, R7, R9, R11, R13, R15, R17, R21, R23: 220; R_Axial_DIN0207_L6.3mm_D2.5mm_P7.62mm_Horizontal
R19: 470; R_Axial_DIN0207_L6.3mm_D2.5mm_P7.62mm_Horizontal
U1: ESP32-DEVKITC; MODULE_ESP32-DEVKITC; PARTREV N/A

Connections:
+3.3V: J2.19, R2.2
+5V: Alim2.1, C3.1, C4.1, J2.1, R1.1
+12V: Alim1.1, C1.1, C2.1, D2.1 (K), D3.1 (K), D4.1 (K), D5.1 (K), D6.1 (K), D7.1 (K), D8.1 (K), D9.1 (K), D11.1 (K), D12.1 (K), ElectrovanneB1.1, ElectrovanneB2.1, ElectrovanneB3.1, ElectrovanneF2.1, ElectrovanneF3.1, ElectrovanneF4.1, JElectrovanneB4.1, JElectrovanneF1.1, JPump1.1, JPump2.1, R19.1
Electrovanne B1: J2.5, R11.1
Electrovanne B2: J1.12, R13.1
Electrovanne B3: J1.11, R15.1
Electrovanne B4: J2.7, R17.1
Electrovanne F1: J1.3, R4.1
Electrovanne F2: J2.12, R5.1
Electrovanne F3: J1.6, R7.1
Electrovanne F4: J1.10, R9.1
GND: Alim1.2, Alim2.2, C1.2, C2.2, C3.2, C4.2, D1.1 (K), D10.1 (K), J1.1, J1.7, J2.6, Q1.3 (S), Q2.3 (S), Q3.3 (S), Q4.3 (S), Q5.3 (S), Q6.3 (S), Q7.3 (S), Q8.3 (S), Q10.3 (S), Q11.3 (S), R3.2, R6.2, R8.2, R10.2, R12.2, R14.2, R16.2, R18.2, R22.2, R24.2
unnamed: D1.2 (A), R1.2
unnamed: D2.2 (A), JElectrovanneF1.2, Q1.2 (D)
unnamed: D3.2 (A), ElectrovanneF2.2, Q2.2 (D)
unnamed: D4.2 (A), ElectrovanneF3.2, Q3.2 (D)
unnamed: D5.2 (A), ElectrovanneF4.2, Q4.2 (D)
unnamed: D6.2 (A), ElectrovanneB1.2, Q5.2 (D)
unnamed: D7.2 (A), ElectrovanneB2.2, Q6.2 (D)
unnamed: D8.2 (A), ElectrovanneB3.2, Q7.2 (D)
unnamed: D9.2 (A), JElectrovanneB4.2, Q8.2 (D)
unnamed: D10.2 (A), R19.2
unnamed: D11.2 (A), JPump1.2, Q10.2 (D)
unnamed: D12.2 (A), JPump2.2, Q11.2 (D)
unnamed: Q1.1 (G), R3.1, R4.2
unnamed: Q2.1 (G), R5.2, R6.1
unnamed: Q3.1 (G), R7.2, R8.1
unnamed: Q4.1 (G), R9.2, R10.1
unnamed: Q5.1 (G), R11.2, R12.1
unnamed: Q6.1 (G), R13.2, R14.1
unnamed: Q7.1 (G), R15.2, R16.1
unnamed: Q8.1 (G), R17.2, R18.1
unnamed: Q10.1 (G), R21.2, R22.1
unnamed: Q11.1 (G), R23.2, R24.1
Pump 1: J1.9, R21.1
Pump 2: J1.8, R23.1
en: J2.18, J7.1, R2.1

Notes on the sheet:
ELECTROVANNES
12v in
5v in
led 5v
led 12v
ESP
PUMPS
enable

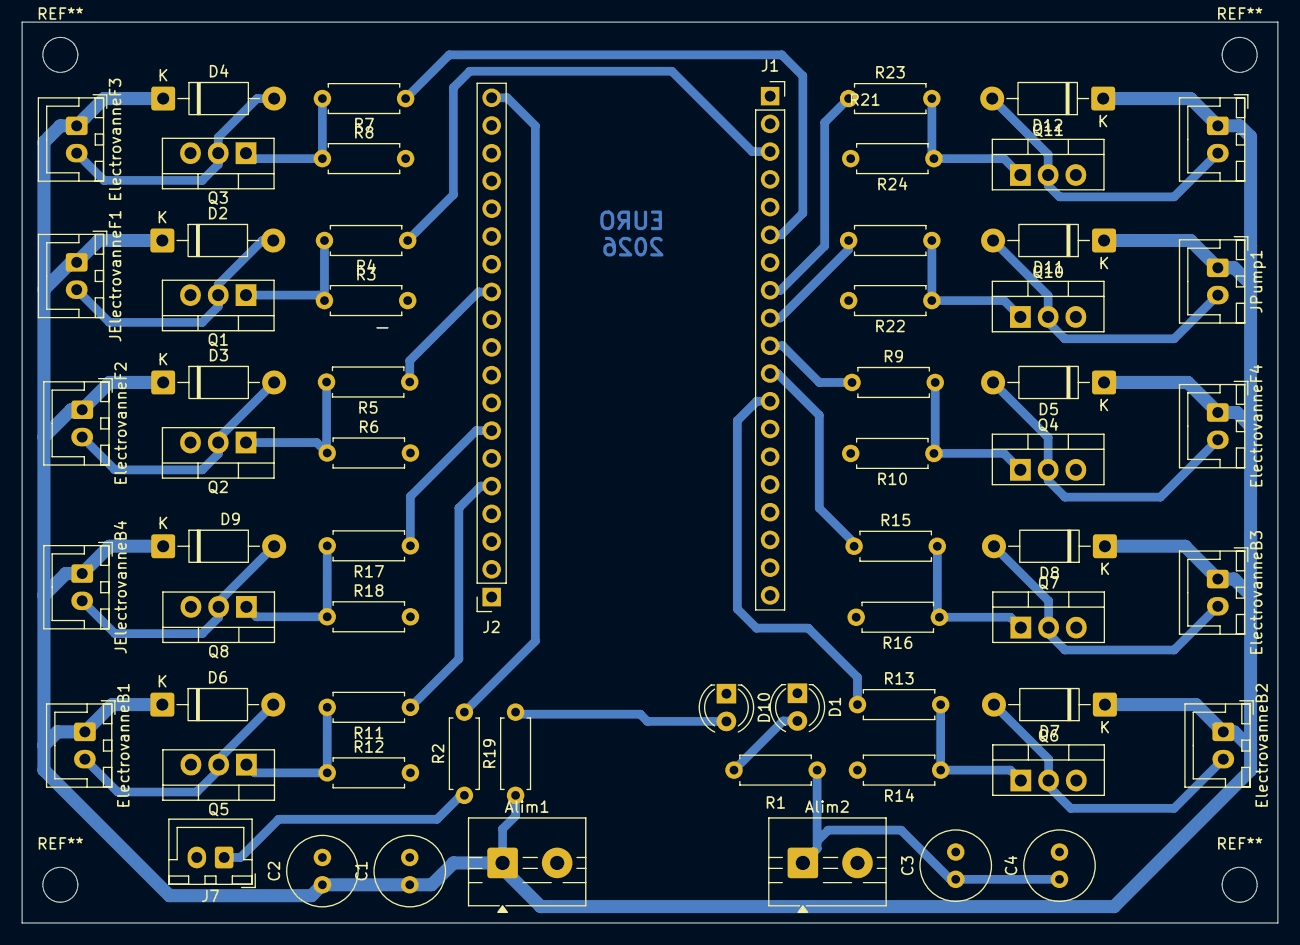
[picture p253: board Carte Mosfet.kicad_pcb from above]

Board: 2 copper layers, 115.0 x 82.5 mm, 64 parts (0 on the bottom side), 37 nets.
