EUROBOT-27/MECANIQUE/resources/Aero Euro/PCBs/ESP motors - 2.0/ESP motors 2.0.kicad_pcb

## KiCad design resources/Aero Euro/PCBs/ESP motors - 2.0/ESP motors 2.0.kicad_pcb (2026-11-01)

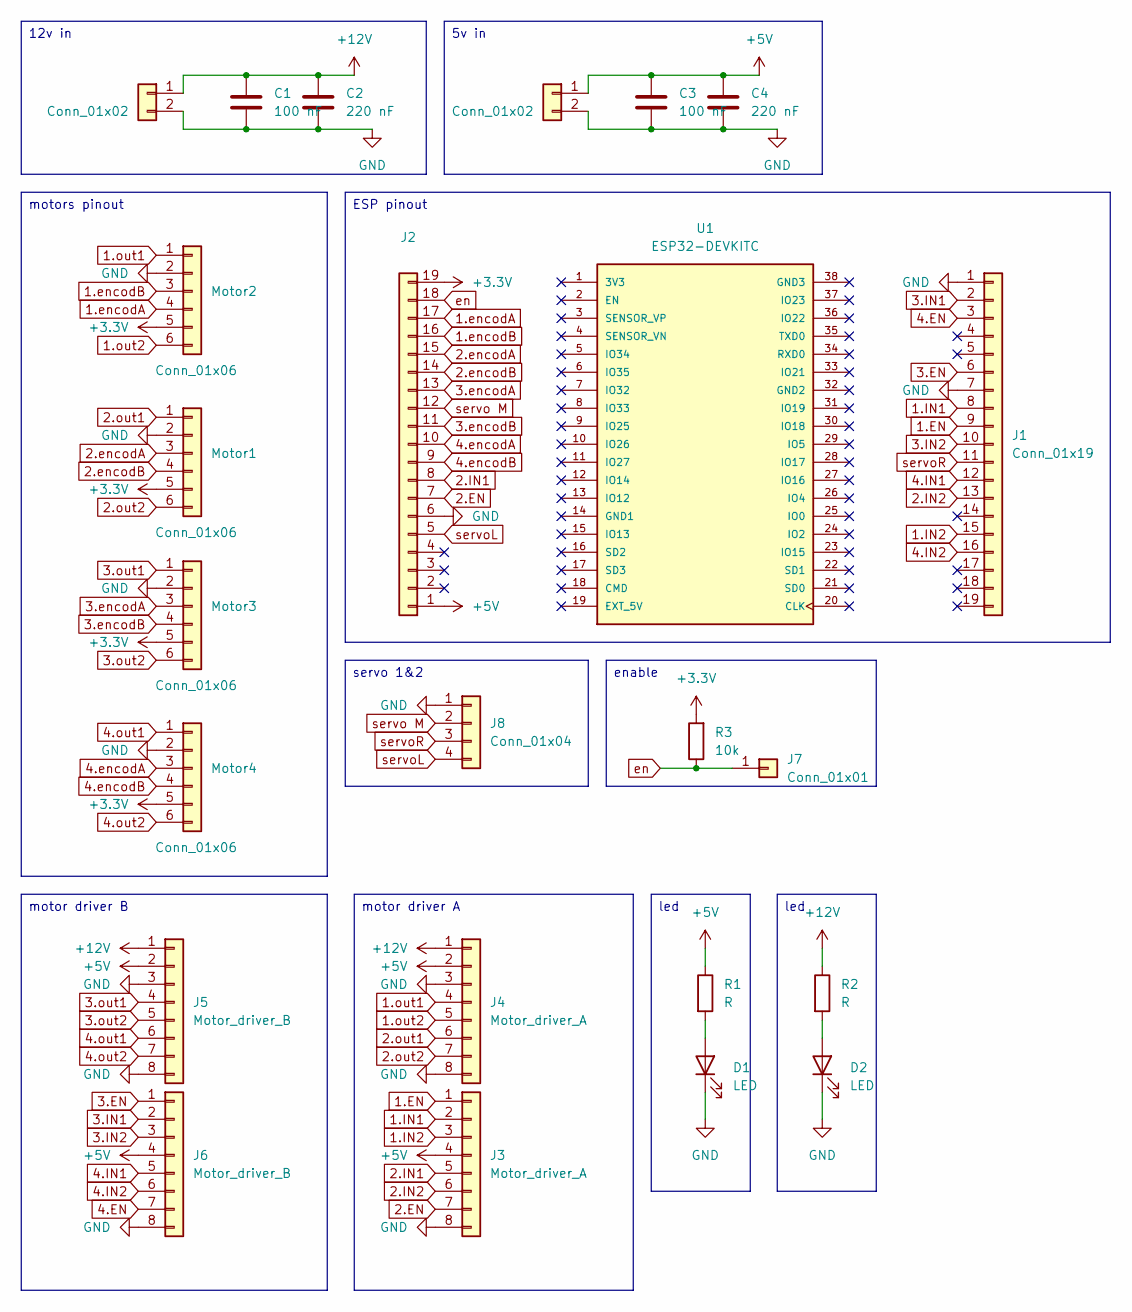
[picture p254: schematic ESP motors 2.0.kicad_sch]

Parts:
Alim1, Alim2: Conn_01x02; TerminalBlock_MaiXu_MX126-5.0-02P_1x02_P5.00mm
C1, C3: 100 nF; C_Radial_D6.3mm_H5.0mm_P2.50mm
C2, C4: 220 nF; C_Radial_D6.3mm_H5.0mm_P2.50mm
D1, D2: LED; LED_D4.0mm
J1, J2: Conn_01x19; PinSocket_1x19_P2.54mm_Vertical
J3, J4: Motor_driver_A; PinSocket_1x08_P2.54mm_Vertical
J5, J6: Motor_driver_B; PinSocket_1x08_P2.54mm_Vertical
J7: Conn_01x01; JST_XH_B2B-XH-A_1x02_P2.50mm_Vertical
J8: Conn_01x04; PinHeader_1x04_P2.54mm_Vertical
Motor1, Motor2, Motor3, Motor4: Conn_01x06; PinHeader_1x06_P2.54mm_Vertical
R1, R2: R; R_Axial_DIN0207_L6.3mm_D2.5mm_P7.62mm_Horizontal
R3: 10k; R_Axial_DIN0207_L6.3mm_D2.5mm_P7.62mm_Horizontal
U1: ESP32-DEVKITC; MODULE_ESP32-DEVKITC; PARTREV N/A

Connections:
1.EN: J1.9, J3.1
1.IN1: J1.8, J3.2
1.IN2: J1.15, J3.3
1.encodA: J2.17, Motor2.4
1.encodB: J2.16, Motor2.3
1.out1: J4.4, Motor2.1
1.out2: J4.5, Motor2.6
2.EN: J2.7, J3.7
2.IN1: J2.8, J3.5
2.IN2: J1.13, J3.6
2.encodA: J2.15, Motor1.3
2.encodB: J2.14, Motor1.4
2.out1: J4.6, Motor1.1
2.out2: J4.7, Motor1.6
3.EN: J1.6, J6.1
3.IN1: J1.2, J6.2
3.IN2: J1.10, J6.3
3.encodA: J2.13, Motor3.3
3.encodB: J2.11, Motor3.4
3.out1: J5.4, Motor3.1
3.out2: J5.5, Motor3.6
4.EN: J1.3, J6.7
4.IN1: J1.12, J6.5
4.IN2: J1.16, J6.6
4.encodA: J2.10, Motor4.3
4.encodB: J2.9, Motor4.4
4.out1: J5.6, Motor4.1
4.out2: J5.7, Motor4.6
+3.3V: J2.19, Motor1.5, Motor2.5, Motor3.5, Motor4.5, R3.2
+5V: Alim2.1, C3.1, C4.1, J2.1, J3.4, J4.2, J5.2, J6.4, R1.1
+12V: Alim1.1, C1.1, C2.1, J4.1, J5.1, R2.1
GND: Alim1.2, Alim2.2, C1.2, C2.2, C3.2, C4.2, D1.1 (K), D2.1 (K), J1.1, J1.7, J2.6, J3.8, J4.3, J4.8, J5.3, J5.8, J6.8, J8.1, Motor1.2, Motor2.2, Motor3.2, Motor4.2
unnamed: D1.2 (A), R1.2
unnamed: D2.2 (A), R2.2
en: J2.18, J7.1, R3.1
servo M: J2.12, J8.2
servoL: J2.5, J8.4
servoR: J1.11, J8.3

Notes on the sheet:
motor driver B
led
12v in
5v in
enable
motor driver A
servo 1&2
motors pinout
ESP pinout

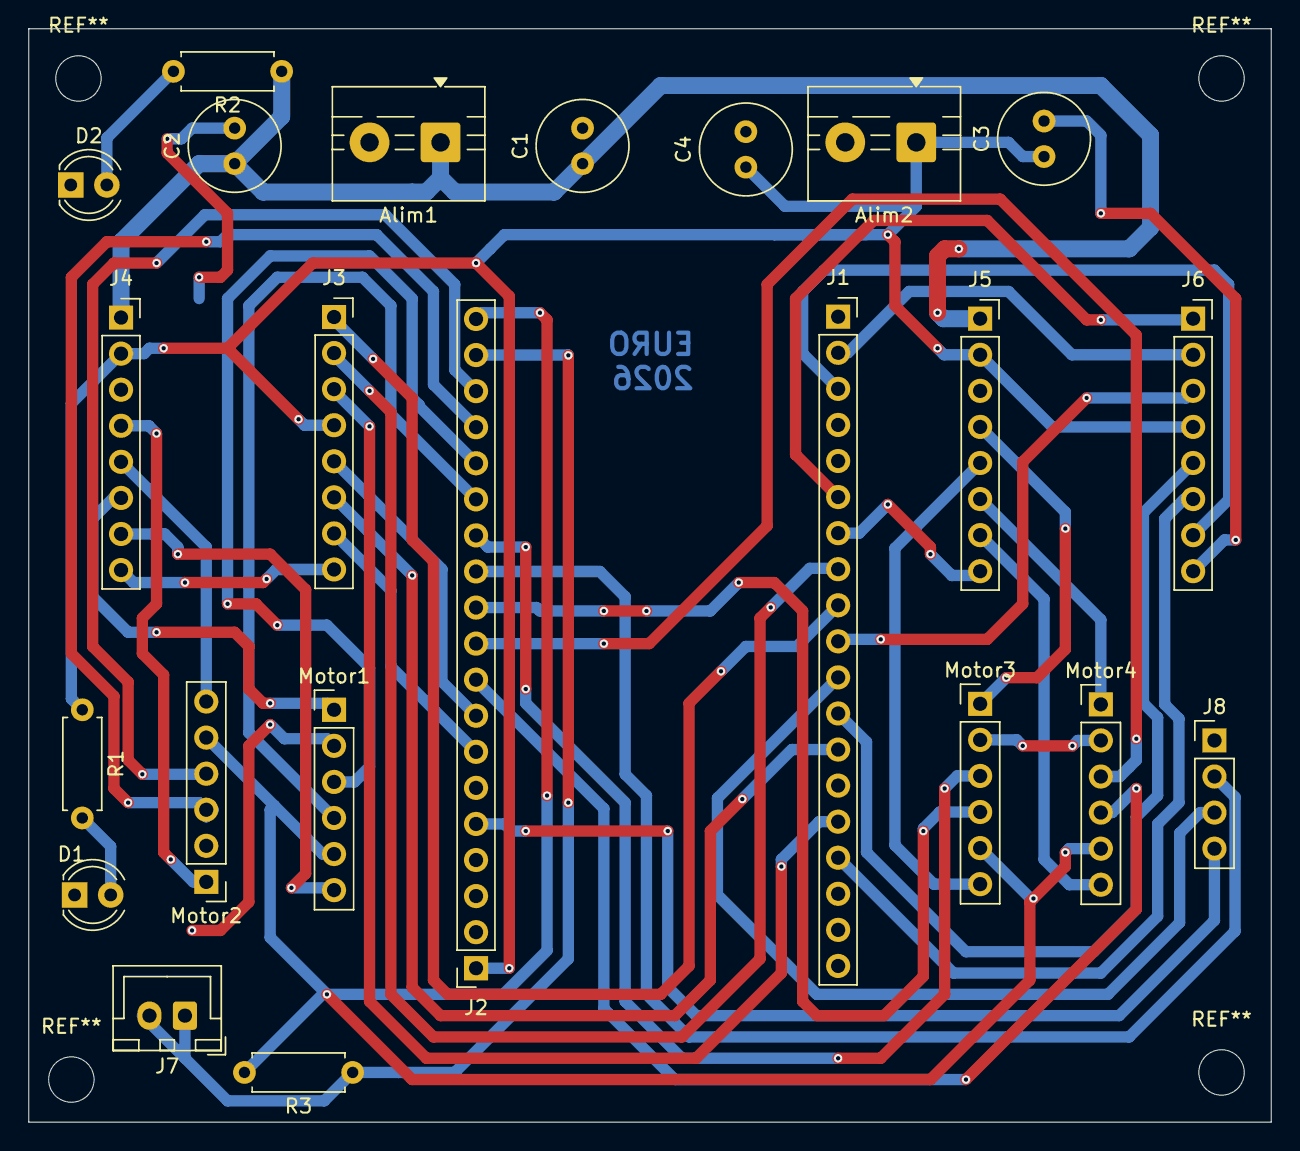
[picture p255: board ESP motors 2.0.kicad_pcb from above]

Board: 2 copper layers, 87.5 x 77.0 mm, 23 parts (0 on the bottom side), 38 nets.
