EUROBOT-27/MECANIQUE/resources/INSATEURO2026/Electrique/Carte Finale JLCPCB/.Robot Principalold/Puissance/Robot Principal.kicad_pcb

## KiCad design resources/INSATEURO2026/Electrique/Carte Finale JLCPCB/.Robot Principalold/Puissance/Robot Principal.kicad_pcb (2026-11-01)

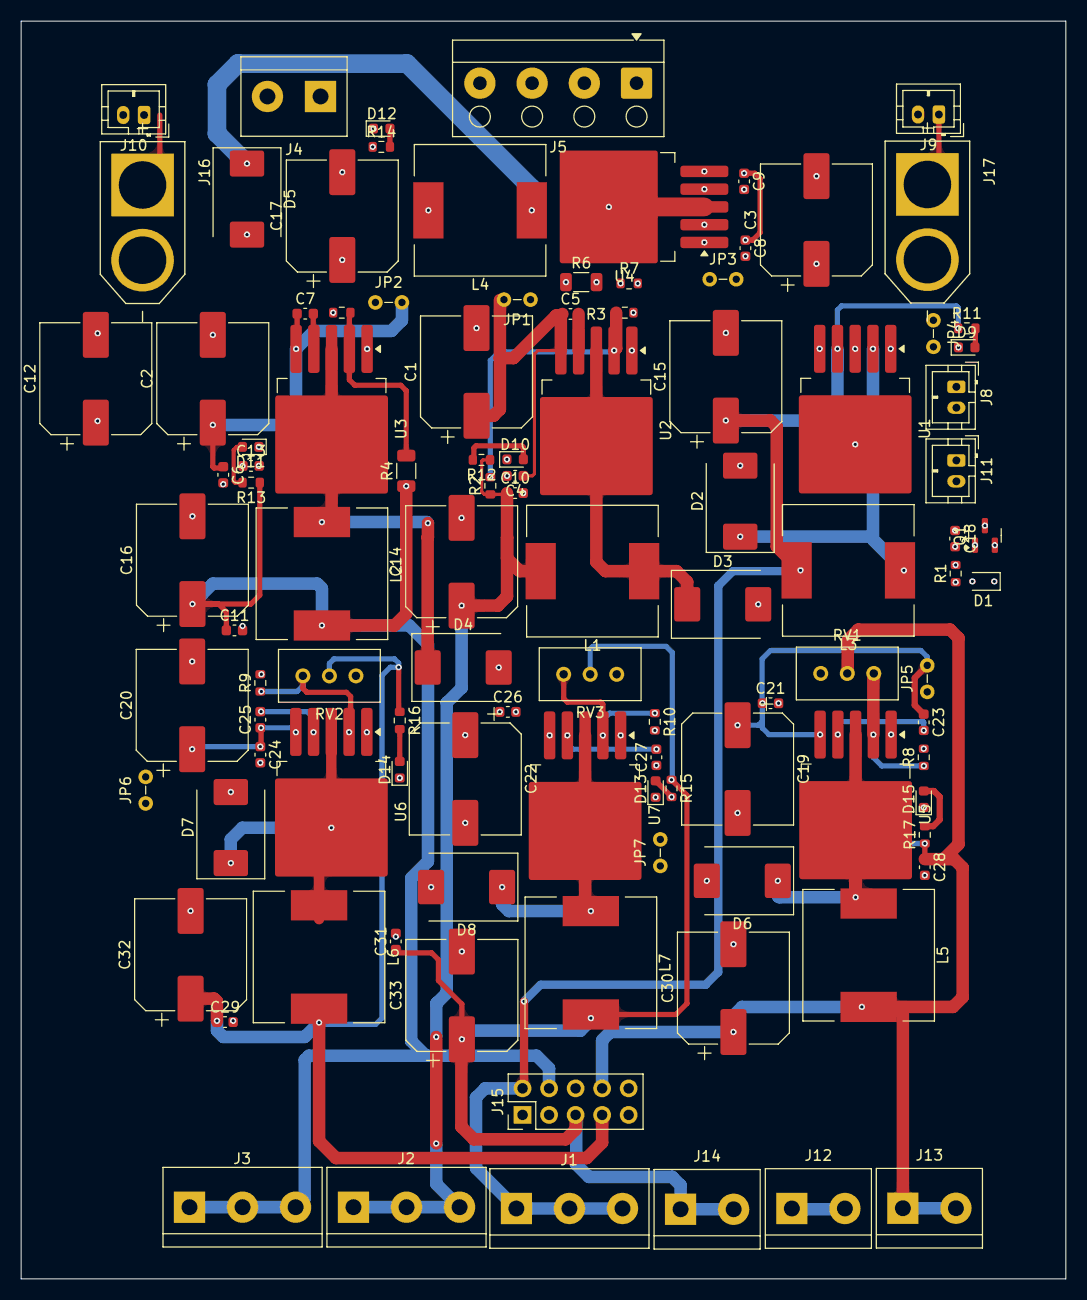
[picture p256: board Robot Principal.kicad_pcb from above]

Board: 4 copper layers, 100.0 x 120.4 mm, 105 parts (0 on the bottom side), 47 nets.

Parts:
C1, C2, C3, C19, C20, C22: 220u; CP_Elec_10x10.5
C4, C5, C6, C7, C8, C9, C10, C11, C13, C21, C23, C24, C25, C26, C27, C28, C29, C31: 105; C_0603_1608Metric
C12: 1000u; CP_Elec_10x10.5
C14, C16, C17, C30, C32, C33: 330u; CP_Elec_10x10.5
C15: 560u; CP_Elec_10x10.5
C18: 100n; C_0603_1608Metric
D1: BZV55B10; D_SOD-323
D2: 1N5822; D_SMC
D3, D4, D5, D6, D7, D8: B540C; D_SMC
D9, D10, D11, D12, D13, D14, D15: LED; LED_0603_1608Metric
J1: 3.3v; TerminalBlock_bornier-3_P5.08mm
J2: 5V; TerminalBlock_bornier-3_P5.08mm
J3: 12V; TerminalBlock_bornier-3_P5.08mm
J4: 24V Out; TerminalBlock_bornier-2_P5.08mm
J5: Screw_Terminal_01x04; Altech_AK100_1x04_P5.00mm
J8: Emergency Stop; JST_PH_B2B-PH-K_1x02_P2.00mm_Vertical
J9: LIPO 1 VOLT; JST_PH_B2B-PH-K_1x02_P2.00mm_Vertical
J10: LIPO 2 VOLT; JST_PH_B2B-PH-K_1x02_P2.00mm_Vertical
J11: Master Switch; JST_PH_B2B-PH-K_1x02_P2.00mm_Vertical
J12, J13, J14: ADJ out; TerminalBlock_bornier-2_P5.08mm
J15: Conn_02x05_Top_Bottom; PinHeader_2x05_P2.54mm_Vertical
J16, J17: XT60-M; AMASS_XT60-M
JP1, JP2, JP3, JP4, JP5, JP6, JP7: Jumper_2_Small_Bridged; Jumper_P2.54mm_D0.7mm
L1, L2, L4, L5, L6, L7: 47uH; L_12x12mm_H6mm
L3: 33uH; L_12x12mm_H6mm
Q1: AO3401A; SOT-23
R1, R2: 10K; R_0603_1608Metric
R3, R7, R8, R9, R10: 3.3K; R_0603_1608Metric
R4: 13K; R_1206_3216Metric
R5: 1.5K; R_0603_1608Metric
R6: 60.4K; R_1206_3216Metric
R11, R12, R13, R14, R15, R16, R17: 1K; R_0603_1608Metric
RV1, RV2, RV3: R_Potentiometer; Potentiometer_Bourns_3296W_Vertical
U1: LM2596T-3.3; TO-263-5_TabPin3
U2, U3, U4, U5, U6, U7: XL4015; TO-263-5_TabPin3

Connections:
5V: C10.1, C14.1, J2.1, J2.2, J2.3, J15.3, L1.2, R2.1, R12.1
12V: C11.1, C16.1, J3.1, J3.2, J3.3, J15.4, L2.2, R4.1, R13.1
24V: C13.1, C17.1, J4.1, J4.2, L4.2, R6.1, R14.1
+3.3V: C15.1, J1.1, J1.2, J1.3, J15.2, L3.2, R11.1, U1.4 (FB)
ADJ1: C29.1, C32.1, J12.1, J12.2, J15.7, L6.2, R16.1, RV2.2
ADJ2: C28.1, C30.1, J13.1, J13.2, J15.8, L5.2, R17.1, RV1.2
GND: C1.2, C2.2, C3.2, C4.2, C6.2, C8.2, C10.2, C11.2, C12.2, C13.2, C14.2, C15.2, C16.2, C17.2, C18.2, C19.2, C20.2, C21.2, C22.2, C24.2, C26.2, C28.2, C29.2, C30.2, C31.2, C32.2, C33.2, D2.2 (A), D3.2 (A), D4.2 (A), D5.2 (A), D6.2 (A), D7.2 (A), D8.2 (A), D9.1 (K), D10.1 (K), D11.1 (K), D12.1 (K), D13.1 (K), D14.1 (K), D15.1 (K), J5.1, J5.2, J5.3, J5.4, J9.2, J10.2, J15.1, J15.6, J16.N (NEG), R1.2, R3.2, R5.2, R7.2, R8.2, R9.2, R10.2, RV1.3, RV2.3, RV3.3, U1.3 (GND), U1.5 (~ON/OFF), U2.1 (GND), U3.1 (GND), U4.1 (GND), U5.1 (GND), U6.1 (GND), U7.1 (GND)
unnamed: D1.2 (A), Q1.1 (G), R1.1
unnamed: D2.1 (K), L3.1, U1.2 (OUT)
unnamed: D3.1 (K), L1.1, U2.3 (SW)
unnamed: D4.1 (K), L2.1, U3.3 (SW)
unnamed: D5.1 (K), L4.1, U4.3 (SW)
unnamed: D6.1 (K), L5.1, U5.3 (SW)
unnamed: D7.1 (K), L6.1, U6.3 (SW)
unnamed: D8.1 (K), L7.1, U7.3 (SW)
unnamed: D9.2 (A), R11.2
unnamed: D10.2 (A), R12.2
unnamed: D11.2 (A), R13.2
unnamed: D12.2 (A), R14.2
unnamed: D13.2 (A), R15.2
unnamed: D14.2 (A), R16.2
unnamed: D15.2 (A), R17.2
unnamed: J10.1, J16.P (POS), J17.N (NEG)
unnamed: J8.2, J11.1
unnamed: J8.1, J9.1, J17.P (POS)
unnamed: C1.1, C4.1, C5.1, JP1.2 (B), U2.5 (VIN)
unnamed: C2.1, C6.1, C7.1, JP2.2 (B), U3.5 (VIN)
unnamed: C3.1, C8.1, C9.1, JP3.2 (B), U4.5 (VIN)
unnamed: JP4.2 (B), U1.1 (VIN)
unnamed: C19.1, C21.1, C23.1, JP5.2 (B), U5.5 (VIN)
unnamed: C20.1, C24.1, C25.1, JP6.2 (B), U6.5 (VIN)
unnamed: C22.1, C26.1, C27.1, JP7.2 (B), U7.5 (VIN)
unnamed: R2.2, R3.1, U2.2 (FB)
unnamed: C5.2, U2.4 (VC)
unnamed: R4.2, R5.1, U3.2 (FB)
unnamed: C7.2, U3.4 (VC)
unnamed: R6.2, R7.1, U4.2 (FB)
unnamed: C9.2, U4.4 (VC)
unnamed: R8.1, RV1.1, U5.2 (FB)
unnamed: C23.2, U5.4 (VC)
unnamed: R9.1, RV2.1, U6.2 (FB)
unnamed: C25.2, U6.4 (VC)
unnamed: R10.1, RV3.1, U7.2 (FB)
unnamed: C27.2, U7.4 (VC)
SERVO: C31.1, C33.1, J14.1, J14.2, J15.5, L7.2, R15.1, RV3.2
SUPPLY: J11.2, Q1.3 (D)
VDC: C12.1, C18.1, D1.1 (K), JP1.1 (A), JP2.1 (A), JP3.1 (A), JP4.1 (A), JP5.1 (A), JP6.1 (A), JP7.1 (A), Q1.2 (S)
