EUROBOT-27/MECANIQUE/resources/INSATEURO2026/Electrique/Actionneur PCB/Actionneur/Actionneurv0.kicad_pcb

## KiCad design resources/INSATEURO2026/Electrique/Actionneur PCB/Actionneur/Actionneurv0.kicad_pcb (2026-11-01)

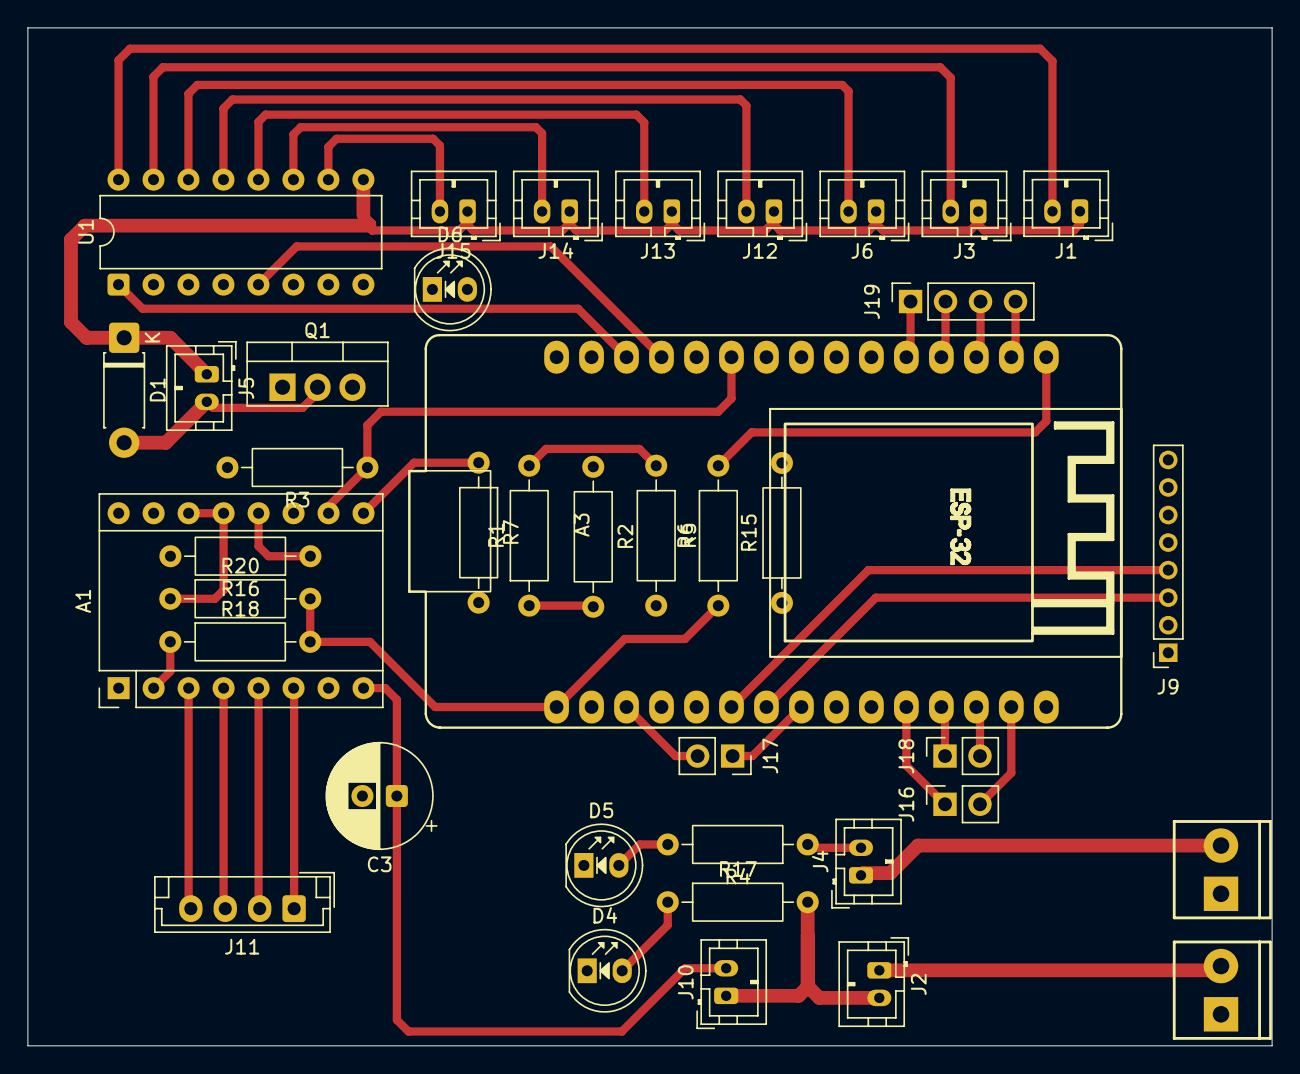
[picture p257: board Actionneurv0.kicad_pcb from above]

Board: 2 copper layers, 90.3 x 73.9 mm, 40 parts (0 on the bottom side), 52 nets.

Parts:
A1: Pololu_Breakout_DRV8825; Pololu_Breakout-16_15.2x20.3mm
A3: ESP32_DevKit_V1_DOIT_30GPIOs; DOIT_ESP32_DEVKIT_30Pins
C3: 220u; CP_Radial_D7.5mm_P2.50mm
D1: 1N4001; D_DO-41_SOD81_P7.62mm_Horizontal
D4, D5, D6: LED; LED_D5.0mm
J1: V1; JST_PH_B2B-PH-K_1x02_P2.00mm_Vertical
J2: 12V Switch; JST_PH_B2B-PH-K_1x02_P2.00mm_Vertical
J3: V2; JST_PH_B2B-PH-K_1x02_P2.00mm_Vertical
J4: 5V Switch; JST_PH_B2B-PH-K_1x02_P2.00mm_Vertical
J5: Pump Output; JST_PH_B2B-PH-K_1x02_P2.00mm_Vertical
J6: V3; JST_PH_B2B-PH-K_1x02_P2.00mm_Vertical
J7: 12V input; ScrewTerminal_1x02_P3.5mm_Blue
J8: 5V input; ScrewTerminal_1x02_P3.5mm_Blue
J9: Maestro; PinSocket_1x08_P2.00mm_Vertical
J10: Stepper Switch; JST_PH_B2B-PH-K_1x02_P2.00mm_Vertical
J11: Stepper connector; JST_EH_B4B-EH-A_1x04_P2.50mm_Vertical
J12: V4; JST_PH_B2B-PH-K_1x02_P2.00mm_Vertical
J13: V5; JST_PH_B2B-PH-K_1x02_P2.00mm_Vertical
J14: V6; JST_PH_B2B-PH-K_1x02_P2.00mm_Vertical
J15: V7; JST_PH_B2B-PH-K_1x02_P2.00mm_Vertical
J16, J17, J18: V6; PinSocket_1x02_P2.54mm_Vertical
J19: PinSocket_1x04_P2.54mm_Vertical
Q1: IRF530N; TO-220-3_Vertical
R1: 220; R_Axial_DIN0207_L6.3mm_D2.5mm_P10.16mm_Horizontal
R2: 100k; R_Axial_DIN0207_L6.3mm_D2.5mm_P10.16mm_Horizontal
R3, R6, R7, R15, R16, R18, R20: 10k; R_Axial_DIN0207_L6.3mm_D2.5mm_P10.16mm_Horizontal
R4, R5, R17: R; R_Axial_DIN0207_L6.3mm_D2.5mm_P10.16mm_Horizontal
U1: ULN2003A; DIP-16_W7.62mm

Connections:
12V: D1.1 (K), J1.1, J2.2, J3.1, J5.1, J6.1, J10.1, J12.1, J13.1, J14.1, J15.1, R17.2, U1.9 (COM)
+3.3V: A3.1 (3.3V), R6.1, R18.2, R20.2
+5V: A3.30 (VIN), J4.2, J9.2, R4.1
D5: A3.8 (D5), J17.1
D15: A3.3 (D15/ADC2_CH3), J17.2
D34: A3.19 (ADC1_CH6/D34), J19.2
D35: A3.20 (ADC1_CH7/D35), J19.1
DIR: A1.16 (DIR), A3.10 (D19)
EV1: J1.2, U1.16 (O1)
EV2: J3.2, U1.15 (O2)
EV3: J6.2, U1.14 (O3)
EV4: J12.2, U1.13 (O4)
EV5: J13.2, U1.12 (O5)
EV6: J14.2, U1.11 (O6)
EV7: J15.2, U1.10 (O7)
GND: A1.1 (GND), A1.7 (GND), A3.2 (GND), A3.29 (GND), C3.2, D4.1 (K), D5.1 (K), D6.1 (K), J7.1, J8.1, J9.1, Q1.3 (S), R2.1, R3.2, R7.2, R15.2, R16.2, U1.8 (GND)
M0: A1.10 (M0), A3.25 (ADC2_CH7/D27), R3.1
M1: A1.11 (M1), A3.24 (DAC2/ADC2_CH9/D26), R15.1
M2: A1.12 (M2), A3.23 (DAC1/ADC2_CH8/D25), R16.1
unnamed: A1.4 (A1), J11.3
unnamed: A1.3 (A2), J11.4
unnamed: A1.5 (B1), J11.2
unnamed: A1.6 (B2), J11.1
unnamed: A1.8 (VMOT), C3.1, J10.2
unnamed: A1.9 (~EN), R7.1
unnamed: A1.2 (~FLT), R18.1
unnamed: A1.13 (~RST), A1.14 (~SLP), R20.1
unnamed: A3.16 (EN), R6.2
unnamed: D1.2 (A), J5.2, Q1.2 (D)
unnamed: D4.2 (A), R17.1
unnamed: D5.2 (A), R4.2
unnamed: D6.2 (A), R5.2
unnamed: J2.1, J7.2
unnamed: J4.1, J8.2
unnamed: Q1.1 (G), R1.1, R2.2
PUMP Signal: A3.15 (D23), R1.2, R5.1
RX: A3.6 (RX2/GPIO16), J9.4
RX0: A3.12 (RX0/GPIO3), J18.1
SCL: A3.14 (D22/SCL), J16.2
SDA: A3.11 (D21/SDA), J16.1
STEP: A1.15 (STEP), A3.9 (D18)
TX: A3.7 (TX2/GPIO17), J9.3
TX0: A3.13 (TX0/GPIO1), J18.2
VN: A3.18 (ADC1_CH3/VN), J19.3
VP: A3.17 (ADC1_CH0/VP), J19.4
Valve1: A3.28 (ADC2_CH4/D13), U1.1 (I1)
Valve2: A3.26 (ADC2_CH6/D14), U1.2 (I2)
Valve3: A3.22 (ADC1_CH4/D33), U1.3 (I3)
Valve4: A3.21 (ADC1_CH4/D32), U1.4 (I4)
Valve5: A3.27 (ADC2_CH5/D12), U1.5 (I5)
Valve6: A3.5 (D4/ADC2_CH0), U1.6 (I6)
Valve7: A3.4 (D2/ADC2_CH2), U1.7 (I7)
