EUROBOT-27/MECANIQUE/resources/Aero Euro/Navigation_MicroROS_2026/Navigation_MicroROS_2026.ioc

Mcu.UserName=STM32F446RETx
PA10.Signal=S_TIM1_CH3
PA11.Signal=S_TIM1_CH4
PA13.GPIO_Label=TMS
PA13.Signal=SYS_JTMS-SWDIO
PA14.GPIO_Label=TCK
PA14.Signal=SYS_JTCK-SWCLK
PA2.GPIO_Label=USART_TX
PA2.Signal=USART2_TX
PA3.GPIO_Label=USART_RX
PA3.Signal=USART2_RX
PA5.GPIO_Label=LD2 [Green Led]
PA5.Signal=GPIO_Output
PA6.Signal=S_TIM3_CH1
PA7.Signal=S_TIM3_CH2
PA8.Signal=S_TIM1_CH1
PA9.Signal=S_TIM1_CH2
PB3.GPIO_Label=SWO
PB3.Signal=SYS_JTDO-SWO
PB6.Signal=S_TIM4_CH1
PB7.Signal=S_TIM4_CH2
PB8.Signal=I2C1_SCL
PB9.Signal=I2C1_SDA
PC0.GPIO_Label=echo
PC0.Signal=GPIO_Input
PC1.GPIO_Label=trig
PC1.Signal=GPIO_Output
PC13.Signal=GPIO_Input
PC14-OSC32_IN.Signal=RCC_OSC32_IN
PC15-OSC32_OUT.Signal=RCC_OSC32_OUT
PH0-OSC_IN.Signal=RCC_OSC_IN
PH1-OSC_OUT.Signal=RCC_OSC_OUT
