EUROBOT-27/MECANIQUE/resources/Aero Euro/Navigation_MicroROS_2026/Core/Inc/main.h

#define echo_Pin GPIO_PIN_0
#define echo_GPIO_Port GPIOC
#define trig_Pin GPIO_PIN_1
#define trig_GPIO_Port GPIOC
#define USART_TX_Pin GPIO_PIN_2
#define USART_TX_GPIO_Port GPIOA
#define USART_RX_Pin GPIO_PIN_3
#define USART_RX_GPIO_Port GPIOA
#define LD2_Pin GPIO_PIN_5
#define LD2_GPIO_Port GPIOA
#define TMS_Pin GPIO_PIN_13
#define TMS_GPIO_Port GPIOA
#define TCK_Pin GPIO_PIN_14
#define TCK_GPIO_Port GPIOA
#define SWO_Pin GPIO_PIN_3
#define SWO_GPIO_Port GPIOB
