EUROBOT-27/MECANIQUE/resources/Aero Euro/ROS2-WS-EURO/src/euro/config/task2.yaml

  tasks:
    task1:
      description: "test2"
      global_goal:
        x: 1.5
        y: 1.0
        angle: 90.0
      sequence:
        - device: stm32
          command: move_forward
          params:
            distance: 200.0
            speed: 500.0
            is_smooth: 0.0
          wait: False
        - device: stm32
          command: move_forward
          params:
            distance: 200.0
            speed: 500.0
            is_smooth: 0.0
          wait: False
        - device: stm32
          command: rotate
          params:
            angle: 90.0
            is_radian: 0.0
            is_smooth: 0.0
          wait: False

        
