EUROBOT-27/MECANIQUE/resources/Aero Euro/PAMI_ESP32_code/include/command_controller.h

#pragma once

#include <Arduino.h>
#include "navigation.h"
#include <string>
#include <unordered_map>
#include <mutex>

enum Command
{
    NONE,
    ROTATIN,
    ORIENTATIN,
    GOIN_TO,
};

extern std::unordered_map<std::string, float> arguments;
extern enum Command current_command;
extern std::mutex robot_state_mutex;

void prepare_rotate(float angle, int8_t is_radian);
void prepare_orientate(float orientation, int8_t is_radian);
void prepare_go_to(float x, float y, float speed);

void execute_command();
