EUROBOT-27/MECANIQUE/(commit log)

2026-11-01 Clean up repo before merging Seif's hub
    - Remove unrelated B_Stakes_and_Shapes.cpp and .cph/
    - Remove broken gitlink eurobot2027/Simulation-Euro27 (separate repo, now ignored)
    - Stop tracking personal files: claude-workspace/tmp/ (incl. Python venv), claude-workspace/memory/
    - Keep reusable helpers in tools/ (FreeCAD + SOLIDWORKS API), parts photos in mechanical/resources/parts-photos/
    - .gitignore for personal files and build junk; LFS for images, CAD, video, zip
    [dump_cdr.txt, pyvenv.cfg]
2026-11-01 Commit all resources as snapshots (D-018)
    - Aero Euro (14 Aerobotix 2026 repos + PDFs), INSATEURO2026 (17 repos), CDR-2027 (Barbatronic, 91f057e)
    copied without nested .git, build output (build/, Debug/, *.o, *.d, *.lst, *.a) and caches
    (__pycache__, KiCad fp-info-cache); replaces the broken gitlinks
    - resources/ stored byte-for-byte in normal git, not LFS (resources/.gitattributes)
    - INDEX.md: snapshot dates and sources instead of "git pull to update"
    - todo/maatoug.md: core.longpaths step before pulling
    [2GT-40T-6W-8B BF Pulley-part2.SLDPRT, 32gpt-3stage_standard+KSx+KRx.sldasm-Part-4.SLDPRT, 3ejla sys 4.0.SLDPRT, 3ejlla 4.0.SLDPRT, Accouplement.SLDPRT, Actionneur.csv, Actionneur.kicad_pcb, Actionneur.kicad_sch]
2026-11-01 Clapets v6: copy of v5 for the first print, owned by Seif (D-019)
2026-11-01 Clapets v6: real MG996R horn in the assembly, pinions fitted to it
2026-11-01 Clapets v6: real servo wires, cables straight out (D/G) and up to the tube passage (head)
2026-11-01 Clapets v7: door units reworked (M3 inserts, outer wall, closed box, no strap)
2026-11-01 Clapets v7: real Two Trees Bluer V2 parts (profiles, wheels, spacers, NEMA 17, coupler, TR8 nut); caliper checklist
    [bronze_washers_Y.step, butterfly_plate.step, coupler_5x8.step, eccentric_spacers_Y.step, lead_nut_TR8x8.step, m5_nyloc_nuts_Y.step, m5_spacers_Y.step, m5x35_wheel_screws_Y.step]
2026-11-01 Clapets v7: door unit base cleaned up (one bottom plate, continuous fillet)
2026-11-01 Clapets v7: all screws, nuts and inserts in the CAD with BOM; fixes found by placing them
    [eccentric_spacers_Y.step]
2026-11-01 Clapets v7: motor on the floor on a pad, separate clamp plate (v5 socle could not be assembled)
2026-11-01 Clapets v7: note on mounting on the real robot (cut profiles, height reference)
2026-11-01 wrap 2026-11-01 seif: clapets v6/v7, real printer parts, fasteners, motor mount (D-019, D-020)
2026-11-01 Clapets v7 motion check: real contacts listed as expected, top-tie screws exempt from height
