EUROBOT-27/MECANIQUE/(notices)

Notices in the files:
resources/Aero Euro/Navigation_MicroROS_2026/Core/Inc/main.h:
Copyright (c) 2024 STMicroelectronics.
All rights reserved.
